ProducED-ed/Castle/README.md

# Проект: портативная квест-игра "Хроники живого замка"

## АРХИТЕКТУРА

* **Сервер (CastleServer.py):** Python (Flask, SocketIO, Eventlet), запущен на Raspberry Pi. Управляет общей логикой, звуками, таймерами, связью со всеми устройствами и является главным хранителем общего состояния игры.
* **Центральный контроллер (MAIN_BOARD_V5_COM5.ino):** Arduino Mega, подключен к серверу по USB Serial. Служит мостом между сервером и контроллерами башен.
* **Контроллеры башен:** Несколько Arduino, подключенных к `MAIN_BOARD_V5_COM5` по Serial (через порты Serial1, Serial2, Serial3, mySerial).
* **Внешние устройства (ESP32):** `wolf.ino`, `train.ino`, `chest.ino`, `safe.ino`. Подключаются к серверу по Wi-Fi (HTTP POST) через API-обработчик сервера `@app.route('/api')`.
* **Веб-интерфейс - пульт (Front.html, scripts.js):** HTML/JS для управления и мониторинга квеста через браузер. Общается с сервером через SocketIO (обработчики `@socketio.on(...)`).

## 🤖 Важная информация для ИИ-ассистентов (AI Developer Notes)

Этот раздел содержит критически важные правила архитектуры проекта. Ознакомьтесь с ними перед внесением любых изменений в код, чтобы не сломать стабильность работы квеста.

### 1. Архитектура сети (Hub & Spokes)
* **MAIN_BOARD (Arduino Mega)** выступает в роли центрального роутера. Она принимает команды от Python-сервера (`Serial`) и пересылает их периферийным башням (`Serial1`, `Serial2`, `Serial3`, `mySerial`).
* **Правило:** Если башня не реагирует на команду с пульта, проверьте код `MAIN_BOARD`. Скорее всего, главная плата "глуха" к порту башни на текущем уровне (`level`), либо перехватывает команду и не отправляет её дальше.

### 2. Чтение UART и конфликты буфера (Race Conditions)
* **Запрещено дублирующее чтение:** Никогда не читайте один и тот же Serial-порт в разных функциях одновременно (например, в `HelpTowersHandler()` и в локальной функции уровня `MapGame()`). Это приводит к "разрыву" строк (одна функция забирает начало слова, другая — конец).
* **Никакого `calculateSimilarity`:** В ранних версиях для защиты от битых строк использовался алгоритм Левенштейна. Это приводило к ложным срабатываниям на обрывках логов (например, кусок текста принимался за команду `aluminium`). **Используйте только строгое сравнение (`==`) или `.indexOf()`**. В текущей архитектуре строки приходят целыми.
* **Никакой «Эхо-камеры» (Death Spiral):** При чтении логов от башен (например, log:workshop:Received command: story_35) использование неточного поиска вроде .indexOf("story_35") заставляет Главную плату принимать чужие логи за новые игровые команды. Это порождает бесконечный цикл эхо-запросов и "вешает" сервер из-за таймаутов сервоприводов. Используйте строгое сравнение (==) для игровых команд.
* **Строгое сравнение вместо indexOf при чтении Питона:** Склеенные в буфере "призраки" прошлых команд (например, "start_game_basketsoundon\n") могут вызвать ложное срабатывание indexOf("start_game_basket"). Всегда используйте строгое равенство if (mainSerialBuffer == "start_game_basket") после вызова функции .trim().
* **Защита от дубликатов (Receiver Debouncing):** При многократной отправке команд (для обхода слепоты от адресных лент) принимающая сторона обязана иметь фильтр антидребезга по строке (например, игнорировать идентичные команды в течение 1000 мс), чтобы не засчитать одно и то же действие, например гол, трижды подряд.

### 3. Лимит буфера (64 байта) и Логирование
* Буфер Arduino Mega равен всего 64 байтам. 
* **Правило логов:** Все логи от башен должны быть **максимально короткими** (до 20-25 символов), иначе конец строки срезается, а системные команды, идущие следом, теряются. (Например: пишем `Tower reset`, а не `Resetting tower to initial state`).
* **Обработка логов:** Все логи от башен начинаются с префикса `log:`. В `MAIN_BOARD` при получении такой строки нужно обязательно сделать `Serial.println(buff);` и затем **`continue;`**, чтобы куски лога не попали в проверку игровых команд, идущую ниже по коду.
* **Пылесос логов (ClearSatelliteBuffers):** При массовой перезагрузке башен (команды ready или restart), они начинают активно слать статусные логи. Если Главная плата в этот момент "спит" через delay(), её крошечный буфер переполняется за миллисекунды, критические команды обрезаются (например, start превращается в rt). Во время любых пауз необходимо использовать цикл с ClearSatelliteBuffers(), чтобы безвозвратно удалять системный мусор из буферов.
* **Спам логами при restart:** Чтобы не "положить" 64-байтный буфер Главной платы во время команд массовой перезагрузки, оборачивайте функции эхо-логирования (о получении команды) в башнях в проверку: if (command != "restart" && command != "ready") { sendLog(...); }.
* **Аппаратная "глухота" от Adafruit_NeoPixel:** При вызове strip.show() библиотека аппаратно отключает прерывания. При длинных лентах (200+ диодов) "глухота" длится ~8 мс и более. Длинные команды (>2 байт), прилетающие в этот момент, гарантированно обрезаются, так как аппаратный FIFO буфер микроконтроллера переполняется. Решение: шлите критические команды 3 раза подряд с задержкой 50 мс, чтобы "пробить" окно глухоты.

### 4. Смерть от `delay()`
* **Никаких долгих `delay()` в MAIN_BOARD:** Использование `delay(500)` или `while()` при открытии замков или движении сервоприводов "ослепляет" Главную плату — она перестает читать порты башен, и буфер переполняется. 
* **Решение:** Используйте неблокирующие таймеры `millis()` или функцию `smartDelay()` (которая внутри себя вызывает `HelpTowersHandler();` для непрерывного чтения башен во время ожидания).

### 5. Состояния Ready и Restart (Сброс башен)
* **Аппаратный сброс замков:** При получении команд `ready` или `restart` башни (`dog.ino`, `basket3.ino` и др.) должны не только обнулять переменные, но и **обязательно давать импульс (500 мс HIGH, затем LOW)** на электромагнитные замки, чтобы язычки гарантированно отщелкнулись. Не используйте для этого кривые таймеры на `millis()` внутри цикла сброса — делайте это линейно.
* **Обнуление флагов:** При сбросе состояний (функция `resetQuestState()`) всегда проверяйте, что обнулены глобальные блокирующие флаги (такие как `isActive`, `isFastSpinning` и т.д.). Иначе башня навсегда "застрянет" в спящем режиме.
* **Двойные триггеры:** Если башня присылает и текстовый лог, и системную команду об одном и том же событии (например, дверь открыта), на Главной плате используйте флаги-предохранители (например, `if (!isDogDoorOpened)`), чтобы не спамить Python-сервер дублями команд.
* **Имитация хронологии при "Прыжках" (Tech Jump):** Микроконтроллерам (и библиотеке GyverButton) требуется физическое время на инициализацию состояний. Нельзя просто послать команду финального уровня. При программном прыжке с пульта необходимо соблюдать всю цепочку: ready -> очистка буфера -> start -> активация нужных датчиков (например, start_troll) -> физическая пауза -> пропуск промежуточного этапа (troll). Только так датчики будут готовы к чтению.

### 6. Умные подсказки (Smart Hints)
* Для избежания хардкода сложных таймеров, на всех платах (Arduino и ESP32) внедрена система getSmartHint(seqId, numHints). Она запоминает время последнего воспроизведения звука. Если геркон замыкается повторно менее чем через 30 секунд — снова звучит первая подсказка. Если прошло больше 30 секунд — звучит следующая. По окончании списка он зацикливается, но навсегда исключает самую первую подсказку.

### 7. Антидребезг (Debounce) и быстрые свайпы

* Стандартный debounceDelay в 150-300 мс подходит для медленных герконов (постановка бутылок, поворот ручки сейфа). Однако для триггеров, требующих быстрых взмахов (магическая палочка / свайпы), 150 мс делает плату "слепой", так как магнит пролетает за 30-50 мс. Для динамичных игр задержка антидребезга строго снижена до 30 мс.

### 8. Работа с памятью и переменными (Heap Corruption & Carryover)

* Опасность класса String в быстрых циклах: Постоянное создание и удаление объектов String (например, String b = Serial.readStringUntil('\n');) внутри циклов анимации ленты вызывает фрагментацию кучи (Heap Fragmentation). В случае повреждения заголовков памяти, вызов функции indexOf("restart") может найти искомую строку в случайном системном мусоре и вызвать ложную, фантомную перезагрузку квеста прямо во время игры. Внутри анимаций читайте Serial аппаратно (посимвольно) и избегайте String.

* "Призраки" статических переменных (static): Использование static bool gameIsActive = true; внутри функций уровней приводит к тому, что эта переменная "переживает" рестарт квеста и сохраняет значение из прошлой игры. При следующем запуске башня может выдать ложное событие на основе старой памяти. Всегда выносите критические переменные состояний в глобальную область и принудительно обнуляйте их в блоках обработки команд ready / restart.

## СТИЛЬ КОДА И ОГРАНИЧЕНИЯ

* **Паттерн:** Придерживаться логики стейт-машины (конечного автомата).
* **Задержки (Arduino):** В коде для микроконтроллеров избегать использования блокирующей функции `delay()` в пользу неблокирующих таймеров на `millis()` (исключение: `OpenAll()` в режиме restart и `OpenDoor()` для "skip").
* **КРИТИЧНО ВАЖНО:** Функции обновления адресных светодиодов (`strip.show()`, `FastLED.show()`) отключают прерывания. **Не вызывать их в каждом цикле loop()!** Обязательно использовать троттлинг (таймер на millis), обновляя ленту не чаще, чем раз в 30-50 мс, иначе Arduino перестает принимать Serial-команды.

## ФАЙЛЫ ДЛЯ РАБОТЫ

Я предоставлю тебе все необходимые файлы для анализа. После решения этой задачи, другие файлы предоставлю по необходимости или по твоему запросу.

**Актуальные файлы проекта:**

* `scripts.js` — скрипты для пульта.
* `Front.html` — пульт управления в браузере, отправляет команды квесту и принимает от сервера статусы игр.
* `wolf.ino` — внешняя игра с волком в лесу.
* `train.ino` — внешняя игра поезд с интерактивной картой.
* `chest.ino` — внешняя игра чемоданы.
* `safe.ino` — внешняя игра сейф с животным.
* `basket3.ino` — башня баскетбол и пещера с троллем.
* `workshop.ino` — башня плотника с верстаком и печкой.
* `owls.ino` — башня с совами.
* `dog.ino` — башня с собакой.
* `MAIN_BOARD_V5_COM5.ino` — плата на которой есть игры: зельеварение с ведьмой, центральная башня с директором, кубком и подвалом с кристаллами, комната мозг (воспоминаний), библиотека, банка с сейфом, центральная комната (актовый зал).
* `CastleServer.py` — сервер.

## МОИ ЖАРГОННЫЕ СЛОВА

* **Скипнул:** Нажал на пульте в веб-браузере кнопку для пропуска этапа игры.
* **Пройти игру или уровень:** Выполнить предусмотренные логикой кода действия.
* **Карта:** `train.ino` (барельеф с 4 герконами).
* **"Мальчик" (Boy):** Геркон `boy_in` / `boy_out` (пин (7, board1)) на `MAIN_BOARD`, связанный с игрой в баскетбол.
* **"Директор" (Director):** Кнопка `directorButton` на `MAIN_BOARD`.
* **"Сейф в банке" (Bank Safe):** Логика `Scrolls()` (level 9) на `MAIN_BOARD`, использующая 4 геркона.
* **"Тролль" (Troll) / "Пещера" (Cave):** Игра в `basket3.ino`.
* **"Призрак" (Ghost):** Последовательная игра (стук по `train.ino`, `wolf.ino` и т.д.).
* **"Плотник" (Workshop):** Башня `workshop.ino`.
* **"Совы" (Owls):** Башня `owls.ino`.
* **Звучат истории** — это воспроизведение файлов `story....wav`.
* **Подсказка** — это воспроизведение файлов `hint....wav`.

## 💡 КЛЮЧЕВЫЕ АРХИТЕКТУРНЫЕ ПРИНЦИПЫ

1. **CastleServer.py (Сервер) Главный поток serial():** Поток `serial()` — это "сердце" квеста. Он читает Serial от Arduino, обрабатывает логику `if flag == "..."` и отправляет команды в `serial_write_queue`. Этот поток также отвечает за вызов `check_story_and_fade_up()` для восстановления громкости.
2. **Многопоточность (API и SocketIO):** Обработчики `@app.route('/api')` (для ESP32) и `@socketio.on('time')` (для пульта) выполняются в отдельных потоках.
3. **Обработка Serial (Arduino):** Внутри длительных циклов (например, анимация радуги или ожидание сервопривода) обязательно вставлять проверку `Serial.available()`, чтобы не пропускать команды 'restart' или 'skip'. Использовать функцию `MonitorSerialBuffer()` для принудительной очистки буфера при переполнении.
4. **Дублирование логики (Страховка):** Если критическая команда от башни (например, `boy_out`) может потеряться, `MAIN_BOARD` должен уметь перехватывать текстовые логи от этой башни (начинаются с `log:`) и реагировать на них как на команду.
5. **Логирование:** На каждое событие создавай логирование уровня `DEBUG`, а если я напишу, что нужно показать событие в консоли, то значит уровня `INFO`. Буфер Arduino Mega составляет всего 64 байта, поэтому Идеальная длина лога — до 20-25 символов.

### 1. СЕТЕВАЯ АРХИТЕКТУРА RASPBERRY PI

Система переведена на работу с двумя активными Wi-Fi интерфейсами, работающими на разнесенных частотах для исключения интерференции:

* **Интерфейс wlan0 (Точка доступа "Castle"):**
* Роль: Локальная сеть для игровых устройств (ESP32).
* Настройка: Принудительно зафиксирован 11-й канал Wi-Fi (2.462 ГГц) в файле `/etc/hostapd/hostapd.conf`.
* Мощность: Установлен `country_code=RU` для корректного регулирования мощности.

* **Интерфейс wlan1 (Клиент "ProducED"):**
* Роль: Подключение к внешнему интернету (для Tailscale и удаленного управления).
* Настройка: Работает на 1-м канале (диктуется внешним роутером).

* **Результат:** Разнос каналов (1 и 11) устранил "глухоту" приемников ESP32, вызванную мощным сигналом передатчика Raspberry Pi на соседних частотах.

### 2. СИСТЕМНЫЕ НАСТРОЙКИ OS (RASPBERRY PI)

* **Отключена автоматизация перезагрузки сети:**
* В `crontab -e` закомментирован скрипт `wifi_rebooter.sh` (ранее выполнялся каждую минуту).
* Причина: В конфигурации с двумя интерфейсами скрипт ошибочно диагностировал отсутствие интернета и перезагружал сетевые адаптеры, вызывая разрывы связи каждые 45-55 секунд. **НЕ ВКЛЮЧАТЬ ЭТОТ СКРИПТ БЕЗ ПОЛНОЙ ПЕРЕРАБОТКИ ЛОГИКИ ПРОВЕРКИ PING.**

### 3. ИЗМЕНЕНИЯ В КОДЕ СЕРВЕРА (CastleServer.py)

* **Устранение блокировки потоков (CPU Starvation):**
* В бесконечный цикл `while True` функции `serial()` добавлена команда `eventlet.sleep(0.1)`.
* Причина: Без этой паузы поток обработки Serial-порта занимал 100% времени ядра, не давая веб-серверу (Flask) обрабатывать входящие HTTP-запросы от ESP32 (из-за чего curl и устройства "висели").

* **Авторизация для API:**
* В функцию `before_request` добавлено исключение: `if request.path.startswith('/api'): return None`.
* Причина: Устройства ESP32 не умеют проходить процедуру логина. Ранее сервер перенаправлял их POST-запросы на `/login` (код 302), из-за чего данные от игр не доходили. Теперь API открыт для локальных устройств.

*** Очередь Python и Блокировки потоков:**
* serial_write_queue.put() в Python не отправляет данные мгновенно, если сразу после нее стоит eventlet.sleep(). Команды накопятся и выстрелят одновременно, что приведет к пропуску второй команды на стороне Arduino (если та была занята тяжелой анимацией).

* Правило: После критически важных команд в очередь всегда вызывайте process_serial_queue(), чтобы принудительно вытолкнуть байты в USB-кабель перед уходом Питона в сон.

### 4. ИЗМЕНЕНИЯ В ПРОШИВКАХ ESP32 (Safe, Chest, Wolf, Train)

* **Настройка статической маршрутизации:**
* Метод инициализации Wi-Fi изменен на полный формат: `WiFi.config(local_IP, gateway, subnet);`. Где `gateway` — это IP адрес Raspberry Pi (192.168.4.1), а `subnet` — 255.255.255.0.
* Причина: Без явного указания шлюза ESP32 могла принимать пакеты, но не могла отправить ответ (TCP ACK или POST-запрос) обратно на сервер.

* **Логирование при старте:**
* В `setup()` каждого устройства добавлена команда `sendLogToServer(...)` с JSON-структурой `{"log": "ESP32 [Name] is ready..."}`.
* Это позволяет диагностировать успешную загрузку и подключение устройства в логах сервера (`castle.log`).

### 5. АВТОЗАПУСК И УПРАВЛЕНИЕ АУДИО (SYSTEMD & PULSEAUDIO)

Автозапуск сервера (systemd вместо rc.local):

Главный скрипт квеста (CastleServer.py) работает как служба systemd (castleserver.service), а не через rc.local.

Причина: systemd обеспечивает автоматический рестарт при падениях (Restart=always, RestartSec=5), корректную загрузку после поднятия сети (After=network.target) и изолированное логирование.

Управление сервером: sudo systemctl restart castleserver.service

Просмотр логов: journalctl -u castleserver.service -f (вывод print и системных ошибок перехватывается сюда).

Изоляция аудио в systemd и PulseAudio Equalizer:

Проблема: По умолчанию systemd запускает процессы в слепой/глухой среде, из-за чего скрипт теряет доступ к пользовательскому аудиосерверу (PulseAudio) и отправляет звук напрямую в ALSA (аппаратную карту), минуя эквалайзер, или вообще молчит.

Решение: В файле /etc/systemd/system/castleserver.service строго прописаны переменные окружения, пробрасывающие звук в пользовательскую сессию (pi, UID 1000) и направляющие его принудительно в виртуальное устройство эквалайзера:

Environment="XDG_RUNTIME_DIR=/run/user/1000"

Environment="DISPLAY=:0"

Environment="PULSE_SINK=alsa_output.usb-...-00.analog-stereo.equalizer"

Авто-маршрутизация звука: В systemd (castleserver.service) используется скрипт-обертка run_server.sh. При замене USB-аудиокарты скрипт автоматически находит новое системное имя PulseAudio Equalizer и перенаправляет звук в него. Никаких ручных настроек при замене железа не требуется.

---

## ОЖИДАЕМЫЙ РЕЗУЛЬТАТ

1. **Точная причина проблемы:** Определи корневую причину ошибки или опиши логику для реализации новой функции.
2. **Исправленный код:** Предоставь готовые к копированию, исправленные фрагменты кода для всех файлов, которые требуют изменений. Пожалуйста, используй комментарии, чтобы я мог легко найти и понять изменения.
3. **Подробное объяснение (на русском языке):** В чем заключалась ошибка или как работает новая логика. Почему предложенные изменения решат проблему или реализуют требуемый функционал. Укажи, какие побочные эффекты могут возникнуть в результате изменений.

**Не указывай для меня системные маркеры в написанных тобой кодах.**

---

*Готов приступить к анализу. Присылайте задачу и необходимые файлы.*
