ProducED-ed/Castle/Архив/README.md

# Архив

Здесь лежат исторические снимки кода, которые **не являются актуальными файлами** ни для одного
работающего замка. Держим их, потому что в паре мест это единственный сохранившийся вариант под
конкретное железо, а остальное полезно при разборе «когда это сломалось».

Актуальные файлы всегда в корне репозитория. Ничего отсюда не брать для прошивки без явного решения.

| Папка / файл | Что это | От какой даты | Зачем храним |
|---|---|---|---|
| `workshop OMAN/` | Прошивка башни Workshop для CLC1 (Оман) | ~апрель 2026 | **Единственная** версия, где шлем и метла на сервоприводах (пины 5 и 3), а не на LED (пины 50/48) как в мастере. Если Оману понадобится обновление — брать логику отсюда, а не из мастера. Сильно отстала: нет `ping_main`-heartbeat, нет `FLAG_RESEND_MS`, `RECURRING_LOCK_INTERVAL` = 10000 вместо исправленных 3000. |
| `workshop OMAN/workshop_old/` | Ещё более ранняя версия той же башни | ~март 2026 | Промежуточный этап разработки. Ценности почти нет. |
| `train old отправка CLC3/` | Снимок `train.ino`, отправленный на CLC3 | ~июнь 2026 | До `TrainIntroWatchdog`, до вотчдога переподключения WiFi, до защиты подсказки от перебивания вступления. |
| `CastleServer.py отправка CLC3/` | Снимок сервера, отправленный на CLC3 | 03.07.2026 | 7125 строк против нынешних 8289. Полезен как точка отсчёта при разборе регрессий. |
| `Архив от 3.4.26. CLC2/` | Полный комплект (сервер + фронт + все 9 прошивок) | 03.04.2026 | Самый старый целый срез. Все файлы устарели на сотни строк. |
| `baseline-step2-2026-05-27/` | Пошаговые сборки Mega при разборе зависаний | 27.05.2026 | Использовались для бисекции проблемы DIAG-режима. `MAIN_BOARD_V5_COM5.ino.hex` из корня `MAIN_BOARD_V5_COM5/` остаётся рабочим baseline'ом, здесь — промежуточные шаги 2–5. |
| `MAIN_BOARD_V5_COM5.diag.ino.hex` | Сборка Mega с DIAG-режимом | май 2026 | DIAG-режим убран из всех прошивок: попытка перехватывать `loop()` дважды вешала квест. Храним как напоминание, прошивать нельзя. |

## Что НЕ здесь

`MAIN_BOARD_V5_COM5/MAIN_BOARD_V5_COM5.baseline.ino.hex` намеренно оставлен в рабочей папке — это
проверенный baseline CLC3 для отката, а не архив.

Папка `MAIN_BOARD_V5_COM5/CLC2/` (отдельная сборка Mega под Канаду) удалена в августе 2026: её
единственным отличием была калибровка серво мальчика, которая переехала в `castle_config.json` и
настраивается с тех-пульта. Заодно та сборка отставала от мастера — в ней не было фикса от 05.08.2026
(убран мгновенный форвард `cave_search1/2/3` в `Serial2`, из-за которого обрывалась история тролля).
