ProducED-ed/Castle/Референс/castle_of_memories_fond_blanc.pdf

# CASTLE OF MEMORIES 🏰✨

Résumé Complet de l’Histoire Principale

Chapitre 1 – L’arrivée au Château 🐲🗺️

L’aventure commence lorsque les joueurs arrivent pour la première fois devant un immense Château abritant une prestigieuse école de magie.
Ils découvrent avec émerveillement les lieux et apprennent qu’un événement particulièrement important approche : les Grands Jeux, une compétition réunissant les élèves et les différentes maisons de l’école.
Dès leur arrivée, ils trouvent une carte magique qui leur permettra de se repérer dans le Château.
C’est alors qu’ils font la connaissance de Signus, un dragon installé dans son nid au-dessus du Château. De là-haut, Signus peut observer tout ce qui s’y passe et devient le principal guide des joueurs.
Il leur explique le fonctionnement de la carte : certaines lumières indiquent les endroits à visiter et d’autres représentent encore des secrets à découvrir. Les cristaux bleus présents sur Signus et sur plusieurs habitants du Château permettent également d’obtenir de l’aide lorsque les joueurs sont perdus.
L’entrée du Château étant verrouillée, Signus les guide vers une clé cachée à proximité. Il leur recommande surtout de rester discrets : il fait encore nuit et les habitants du Château dorment.

Chapitre 2 – Kai et le mystère de la Bibliothèque Secrète 👻🕰️

Une fois à l’intérieur, les joueurs rencontrent Kai, un jeune élève de première année qui se promène secrètement dans le Château malgré le couvre-feu.
Kai est passionné par les légendes et les secrets de l’école. Il leur révèle qu’il cherche depuis quelque temps un lieu mystérieux dont tout le monde parle à voix basse : la Bibliothèque Secrète.
Selon la légende, seul le Fantôme du Château serait capable d’en révéler l’emplacement.
Le fantôme ne se manifeste cependant qu’à un moment très précis : 12 h 42.

Kai demande donc aux joueurs de l’aider à utiliser une mystérieuse horloge. En la réglant correctement, ils parviennent à provoquer une réaction magique.
Le fantôme commence alors à communiquer avec eux de manière énigmatique, en utilisant des sons et des coups provenant de différents endroits du Château. Il semble vouloir les conduire quelque part.
Mais avant qu’ils puissent comprendre son message, des pas se rapprochent. Kai comprend qu’un professeur arrive et s’enfuit pour éviter d’être découvert.

Chapitre 3 – La punition du Professeur Amelia 🧹🚩

Les joueurs sont finalement surpris par le Professeur Amelia, qui a entendu le bruit provoqué durant leurs explorations nocturnes.
Le lendemain matin, elle leur reproche d’avoir désobéi au règlement et d’avoir exploré le Château au lieu de dormir.
Plutôt que de leur infliger une simple punition, Amelia décide cependant d’utiliser leur énergie de manière utile.
Les Grands Jeux approchent et le Château doit encore être préparé.
Elle leur confie donc une première grande mission : retrouver les drapeaux des différentes maisons et les installer sur les quatre tours du Château. Les emplacements à explorer apparaissent alors sur leur carte.

Chapitre 4 – La préparation du Château 🐺📜

Les joueurs commencent à parcourir les différentes parties du Château et rencontrent plusieurs de ses habitants.
Ils doivent résoudre leurs problèmes ou accomplir différentes tâches afin de récupérer les drapeaux nécessaires aux préparatifs.
Ils rencontrent notamment Sylvester, un personnage solitaire et passionné de poésie, ainsi qu’un loup lié à une histoire familiale et aux étoiles. D’autres rencontres les entraînent encore dans différentes zones du Château.
À travers ces missions, les joueurs découvrent progressivement le fonctionnement de l’école, ses habitants et ses nombreux secrets.
Une fois les premières étapes accomplies, les préparatifs des Grands Jeux peuvent véritablement commencer.

Chapitre 5 – Préparer l’école pour les Grands Jeux 🦉🚂

Les Jeux auront bientôt lieu et des élèves de toutes les maisons ainsi que de nombreux spectateurs sont attendus.
Les joueurs participent directement à leur organisation.
À la Poste aux Hiboux, ils rencontrent Borin, chargé d’envoyer les invitations. Ils l’aident à guider correctement les hiboux afin que les invitations aux Grands Jeux puissent être distribuées dans toute la région.
Une fois cette mission accomplie, tout le Château comprend que les préparatifs sont officiellement lancés.
Les joueurs doivent également s’occuper du train spécial Peau de Serpent, qui doit être prêt pour l’événement.
Mais pour le faire fonctionner, la locomotive à vapeur a besoin d’un charbon de très haute qualité provenant de la mine des trolls.

Chapitre 6 – Préparer Kai pour la compétition 🧹🛡️⛏️

Les joueurs découvrent progressivement qu’ils ne préparent pas seulement le Château. Ils doivent également aider celui qui représentera l’école lors des Grands Jeux : Kai.
Pour lui donner toutes les chances de gagner, il lui faut un équipement exceptionnel, notamment un balai extrêmement rapide et un casque capable de le protéger pendant la compétition.
Commence alors une longue quête pour récupérer tous les éléments nécessaires.
Ils rencontrent notamment Elspeth, une vieille spécialiste des potions, qui leur demande de préparer une potion magique destinée à un balai volant. Ils doivent également récupérer un cristal orange, destiné aux protections du casque, ainsi qu’un lingot conservé dans un coffre. Pendant ce temps, ils doivent toujours résoudre le problème du train. Dans la mine, ils rencontrent Brock, qui leur explique qu’il faut une excellente pioche pour extraire le meilleur charbon.
Pour fabriquer cette pioche, ils doivent trouver un matériau particulièrement rare : le métal stellaire. Après plusieurs recherches, ils réussissent à le trouver. La pioche peut être fabriquée et le charbon nécessaire au train est finalement obtenu. Tous les composants indispensables sont désormais réunis.

Chapitre 7 – La forge de Boris 🔨🔥

Les joueurs apportent tous les éléments récupérés à Boris, le maître artisan du Château. Boris possède les compétences nécessaires pour fabriquer l’équipement de Kai, mais sa forge est froide. Les joueurs doivent d’abord raviver le feu et maintenir une température suffisamment élevée pour que la magie puisse fonctionner.
Ils disposent ensuite correctement tous les composants sur l’établi pendant que Boris réalise son travail.
Le résultat dépasse les attentes ! Boris fabrique le balai le plus rapide jamais sorti de son atelier. Il termine également un casque léger et extrêmement solide, renforcé par les cristaux orange capables de protéger Kai même en cas de chute importante.
Kai possède désormais le meilleur équipement possible pour défendre l’honneur de l’école lors des Jeux. La nuit tombe sur le Château et tout semble enfin prêt pour le lendemain.

Chapitre 8 – Le retour du Fantôme et la découverte de la Bibliothèque

🔍📖
Kai remercie les joueurs. Grâce au casque et au balai qu’ils ont contribué à fabriquer, il estime avoir toutes les chances de remporter le tournoi.
Mais une affaire reste inachevée : la Bibliothèque Secrète.
Kai n’a pas oublié leur exploration de la première nuit. Il demande aux joueurs de retourner à l’horloge et de l’activer une nouvelle fois, mais cette fois en la réglant sur 12 h 27.
Le Fantôme de la Bibliothèque Secrète se manifeste de nouveau. Il ne communique toujours pas avec des mots : il frappe à différents endroits du Château et attend que les joueurs lui répondent. Commence alors une sorte de jeu de piste sonore.
Les coups les conduisent notamment vers le quai, puis vers différentes parties du Château et finalement vers son toit. En suivant correctement les indications du fantôme, les joueurs découvrent enfin ce qu’ils recherchaient depuis le début : la Bibliothèque Secrète.
Mais le fantôme continue de frapper. Kai comprend alors qu’il ne jouait peut-être pas simplement avec eux, mais qu'il essayait de leur montrer quelque chose d’important. Un symbole découvert près du train correspond exactement à un motif présent sur la porte de la Bibliothèque. Grâce à cet ultime indice, ils peuvent poursuivre leur exploration.

Chapitre 9 – Quelque chose ne va pas… 😱🕯️

Une fois dans la Bibliothèque Secrète, les joueurs font une découverte inquiétante : elle est vide.
Quelqu’un semble être passé avant eux et avoir emporté ce qui s’y trouvait.
Puis un sifflement de train retentit. Et soudain, Kai crie. Quelque chose vient de l’attraper !

Les joueurs n’ont pratiquement pas le temps de comprendre ce qui vient de se produire. La nuit s’achève, l’aube apparaît au-dessus du Château. Et ce nouveau jour est justement celui que tout le monde attend depuis le début de l’aventure : le jour des Grands Jeux.

Chapitre 10 – La disparition de Kai 🔍💎

Les élèves, les professeurs et les spectateurs sont désormais réunis. La Directrice Éléonore ouvre officiellement les Grands Jeux. Selon la tradition, la Coupe de l’Unité doit être allumée afin de marquer le début de la compétition.
Mais un énorme problème apparaît soudain : Kai a disparu. Le champion qui devait représenter l’école est introuvable.
Les Jeux ne peuvent pourtant pas être annulés. Les joueurs reçoivent immédiatement une nouvelle mission : retrouver Kai avant le début de la compétition.
Ils doivent pénétrer dans un coffre-fort et récupérer les Cristaux de Vision, des objets magiques capables de révéler ce qui est invisible à l’œil ordinaire. Guidés par les professeurs représentés sur les portraits du Château, ils parviennent à ouvrir le passage et à récupérer les cristaux.
Grâce à leur pouvoir, ils commencent à percevoir la présence de Kai et ressentent sa peur. Les indices deviennent progressivement plus précis : Kai se trouve toujours quelque part à l’intérieur des murs du Château, caché derrière des briques.
Les indices les ramènent finalement à l’endroit même où toute leur aventureavait commencé : l’entrée du Château. Un passage dissimulé derrière un mur est découvert. Les joueurs le soulèvent… et retrouvent enfin Kai !

Chapitre 11 – Kai est sauvé 🕯️🤝

Kai est vivant ! Soulagé, il remercie les joueurs et leur raconte ce qui lui est arrivé.

Alors qu’ils exploraient la Bibliothèque Secrète et que leur attention était détournée, quelque chose l’a attrapé. Kai ne sait pas exactement ce que c’était, il se souvient seulement d’une présence sombre et extrêmement rapide.
Mais il est convaincu d’une chose : cette créature voulait empêcher les Grands Jeux d’avoir lieu. Son enlèvement n’était donc pas un accident, mais une tentative délibérée de saboter la compétition.
Grâce aux joueurs, le plan a échoué. Kai a été retrouvé à temps et les Grands Jeux peuvent enfin avoir lieu !

Chapitre 12 – Les Grands Jeux et la victoire 🧹⚡🏆

Kai rejoint la compétition avec le casque et le balai que les joueurs ont contribué à fabriquer. Les tribunes se remplissent et le Château entier retient son souffle. Les Grands Jeux commencent enfin !
Les joueurs participent alors directement à la compétition et mettent en pratique tout ce qu’ils ont appris au cours de leur aventure. Ils doivent notamment attraper la balle volante et réussir leurs tirs tout en affrontant leurs adversaires.
Après toutes les épreuves traversées dans le Château, les énigmes résolues, les habitants aidés, la préparation des Jeux, la fabrication de l’équipement et surtout le sauvetage de Kai, les joueurs peuvent enfin se battre pour la victoire.
Dans le déroulement normal de l’aventure, ils remportent les Grands Jeux !
L’école est victorieuse, Kai est sain et sauf, et les joueurs peuvent célébrer leur victoire après avoir sauvé non seulement leur ami, mais également les Grands Jeux eux-mêmes ! 🎉🌟

LE FIL ROUGE DE TOUTE L’HISTOIRE

L’aventure commence comme une simple découverte d’une école de magie à la veille d’une grande compétition. Les joueurs rencontrent Kai, un élève curieux qui cherche à découvrir la légendaire Bibliothèque Secrète, et commencent avec lui une enquête parallèle autour du mystérieux Fantôme du Château.
Après avoir été surpris durant leur exploration nocturne, ils sont chargés d’aider à préparer l’école pour les Grands Jeux. Ce qui ressemble d’abord à une punition devient une véritable aventure : ils parcourent le Château, rencontrent ses habitants, récupèrent les drapeaux, préparent les invitations, remettent le train en fonction et rassemblent tous les éléments permettant de fabriquer le meilleur équipement possible pour Kai.
Une fois Kai prêt pour la compétition, leur ancienne enquête reprend. Grâce au Fantôme, ils trouvent enfin la Bibliothèque Secrète. Mais cette découverte révèle qu’un danger plus important se cache dans le Château : une mystérieuse présence enlève Kai et cherche manifestement à empêcher les Grands Jeux d’avoir lieu.
Le matin de la compétition, les joueurs découvrent que leur champion a disparu. À l’aide des Cristaux de Vision, ils suivent sa trace dans les murs du Château et réussissent à le retrouver juste à temps. Kai leur apprend alors qu’une créature sombre et rapide l’a capturé dans la Bibliothèque afin de saboter les Jeux.
Son plan a cependant échoué grâce aux joueurs. Kai peut participer à la compétition, les Grands Jeux commencent, et l’aventure s’achève normalement par la victoire de Kai, des joueurs et de leur école !
