ProducED-ed/Castle/Референс/Скрины пульта/Снимок экрана 2026-08-05 081355.png

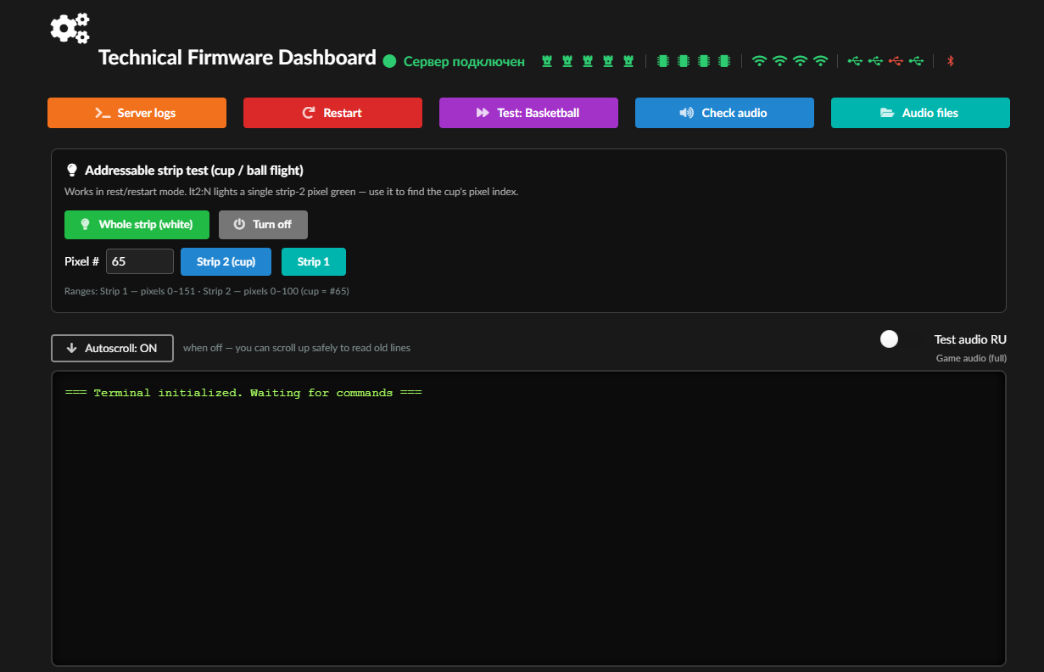
Референс/Скрины пульта/Снимок экрана 2026-08-05 081355.png
