ProducED-ed/Castle/Референс/Скрины пульта/Снимок экрана 2026-08-05 081429.png

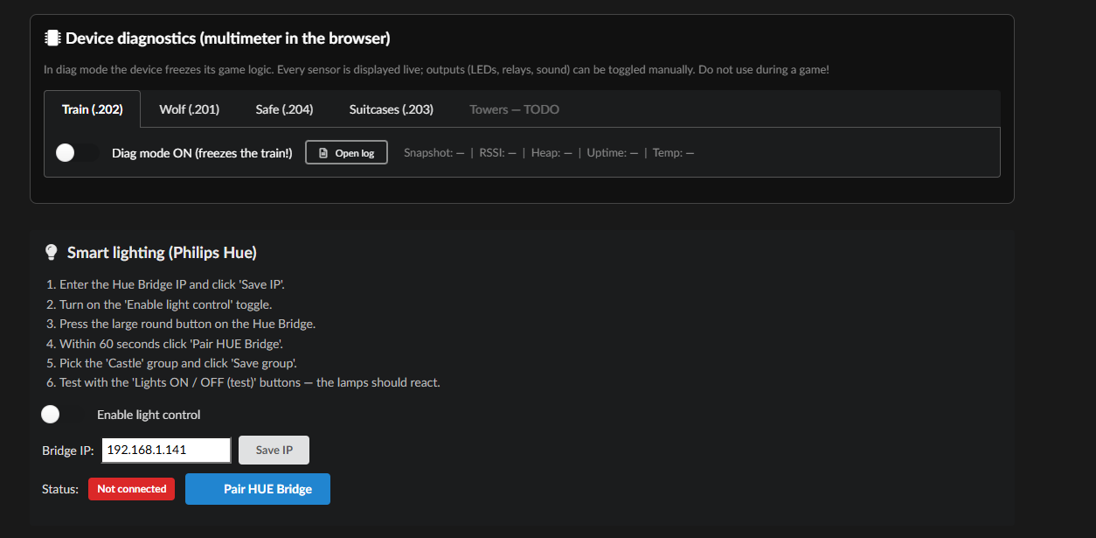
Референс/Скрины пульта/Снимок экрана 2026-08-05 081429.png
