ProducED-ed/Castle/MAIN_BOARD_V5_COM5/MAIN_BOARD_V5_COM5.ino

// === ЗАМЕР ДЛИТЕЛЬНОСТИ ФАЗ (2026-08-22) ===
// Зачем: телеметрия LOOP показала, что цикл главной платы иногда встаёт на
// секунды — на CLC1 до 6,3 с, на CLC3 до 11,3 с. Пока плата стоит, она не
// читает команды с Pi, и они теряются: так пропадал restart, из-за чего дверь
// башни Корзины продолжала толкаться в покое. Какая именно фаза съедает эти
// секунды — по коду не сходится (OpenAll 600 мс, рассылка по башням 180 мс),
// поэтому меряем, а не гадаем.
//
// Печатаем ТОЛЬКО то, что дольше порога: в норме фазы укладываются в единицы
// миллисекунд, и лог не засоряется. Строка уходит в logs/castle.log
// (в journalctl её не видно — там режется всё, что начинается с log:).
#define PHASE_REPORT_MS 200
#define PHASE_REPORT(name, t0) do {                                  \
    unsigned long _d = millis() - (t0);                              \
    if (_d >= PHASE_REPORT_MS) {                                     \
      Serial.print(F("log:main:PHASE " name "="));                   \
      Serial.println(_d);                                            \
    }                                                                \
  } while (0)

//-------------------------- библиотеки
#define crimeDoorPin 38     // геркон на мальчика в тюрьме первая комната
#define startDoorPin 41     // геркон открытия первой комнаты
#define voltagePin A1       // аналогвый пин напруга
#define goldMaterialPin 47  // проставить пин золота
//#define clockPin3 45
#define directorPin 43
#define goblinPin A15
#define dragonPin 42
#define studentPin 38
#define professorPin 44
#define witchPin 45
#define galetSwitchesPin 40


const int pinA = A14;    // Адресный вход A (LSB)
const int pinB = 53;     // Адресный вход B
const int pinC = 52;     // Адресный вход C (MSB)
const int board1 = 21;   // Выход Y
const int board2 = 20;   // Выход Y
const int board3 = A12;  // Выход Y
const int board4 = 33;   // Выход Y

#define GoldStripCount 1
#define GoldStripPin 50  // in the last version it was 48
#define CandleStripIndicCount 1
#define CandleStripIndicPin 51
#define CauldronStripIndicCount 9
#define CauldronStripIndicPin 48  // in the last version it was 49
#define CauldronRoomStripIndicCount 12
#define CauldronRoomStripIndicPin 12
#define memory_LedIndicCount 41
#define memory_LedIndicPin 11  // Поменял пины местами с final_LedIndicPin

#include <Adafruit_NeoPixel.h>
#include <SoftwareSerial.h>
#include <OneWire.h>
#include "GyverButton.h"
#include <Servo.h>

String serial1Buffer = "";
String serial2Buffer = "";
String serial3Buffer = "";
String mySerialBuffer = "";
String mainSerialBuffer = "";

bool isUfBlinking = false;
int ufBlinkCount = 0;
unsigned long ufBlinkTimer = 0;
const int UF_BLINK_TOTAL = 6;  // 3 включения + 3 выключения
bool isRainbowActive = false;
long rainbowHue = 0;
unsigned long rainbowTimer = 0;

//---------------экзэмпляры классов
//-----------коммуникации
SoftwareSerial mySerial(10, 31);  // rx tx
//---------------------
//------------------------ленты адрески
Adafruit_NeoPixel GoldStrip = Adafruit_NeoPixel(GoldStripCount, GoldStripPin, NEO_GRB + NEO_KHZ800);                                    /// адреска в первой комнате
Adafruit_NeoPixel CandleStrip = Adafruit_NeoPixel(CandleStripIndicCount, CandleStripIndicPin, NEO_GRB + NEO_KHZ800);                    ////адреска на свече
Adafruit_NeoPixel CauldronStrip = Adafruit_NeoPixel(CauldronStripIndicCount, CauldronStripIndicPin, NEO_GRB + NEO_KHZ800);              ////адреска в котле
Adafruit_NeoPixel CauldronRoomStrip = Adafruit_NeoPixel(CauldronRoomStripIndicCount, CauldronRoomStripIndicPin, NEO_GRB + NEO_KHZ800);  /// потолочное освещение в комнате зельеварения
Adafruit_NeoPixel memory_Led = Adafruit_NeoPixel(memory_LedIndicCount, memory_LedIndicPin, NEO_GRB + NEO_KHZ800);                       /// финалочка адреска на башне на отдельной нане +20 пин

Adafruit_NeoPixel strip1 = Adafruit_NeoPixel(152, 8, NEO_GRB + NEO_KHZ800);
Adafruit_NeoPixel strip2 = Adafruit_NeoPixel(101, 2, NEO_GRB + NEO_KHZ800);  // кубок = пиксель 65
Adafruit_NeoPixel* strips[] = {
  &GoldStrip,
  &CandleStrip,
  &CauldronStrip,
  &CauldronRoomStrip,
  &memory_Led,
  &strip1,
  &strip2
};
const int STRIPS = sizeof(strips) / sizeof(strips[0]);

// палитра цветов
uint32_t palette[] = {
  Adafruit_NeoPixel::Color(255, 180, 20),   // золотой
  Adafruit_NeoPixel::Color(180, 30, 255),   // фиолетовый
  Adafruit_NeoPixel::Color(20, 100, 255),   // синий
  Adafruit_NeoPixel::Color(255, 255, 255),  // белый (искра)
  Adafruit_NeoPixel::Color(255, 0, 0),      // красный (искра)
  Adafruit_NeoPixel::Color(0, 255, 0),      // синий (искра)
  Adafruit_NeoPixel::Color(0, 0, 255)       // зеленный (искра)

};
const int COLORS = sizeof(palette) / sizeof(palette[0]);

Servo boyServo;

// Флаг монитора датчиков объявлен здесь, до состояний ожидания:
// PowerOn/RestOn проверяют его раньше, чем идёт сам блок монитора.
bool monActive = false;
// Тест верстака Мастерской включён с /tech — в покое надо слушать её UART.
bool wbTestOn = false;

// --- КАЛИБРОВКА СЕРВО МАЛЬЧИКА (пин 49) ---
// 2026-08-09: раньше эти числа были зашиты в коде, и под Канаду приходилось
// держать ОТДЕЛЬНУЮ сборку прошивки — сервоприводы приходят разными партиями и
// одинаково не ходят. Из-за второй сборки каждая правка вносилась дважды, и она
// же успела отстать от мастера на один баг-фикс.
// Теперь значения приходят с Pi командой boycal:<min>:<max>:<open>:<hide>:<ms>
// (сервер шлёт её при каждом QUEST_SYSTEM_READY и по кнопке на /tech), а
// прошивка на всех замках одна. Значения ниже — дефолт, работает и без сервера.
int boyPulseMin = 500;      // мкс, нижняя граница импульса
int boyPulseMax = 2500;     // мкс, верхняя граница импульса
int boyAngleOpen = 170;     // угол «мальчик открывается»
int boyAngleHide = 0;       // угол «мальчик прячется»
unsigned int boyMoveMs = 1000;  // сколько ждать окончания хода

// Разбирает команду калибровки. true — команда распознана и обработана.
// Вызывается из состояний ожидания (PowerOn/RestOn): именно в них замок стоит
// и при загрузке, и когда монтажник крутит калибровку на пульте.
bool handleBoyCal(const String &buff) {
  if (!buff.startsWith("boycal:")) return false;
  int p[5];
  int idx = 7;  // после "boycal:"
  for (int i = 0; i < 5; i++) {
    int sep = buff.indexOf(':', idx);
    String part = (sep == -1) ? buff.substring(idx) : buff.substring(idx, sep);
    p[i] = part.toInt();
    if (sep == -1) {
      if (i < 4) return true;   // команда обрезана — молча игнорируем
      break;
    }
    idx = sep + 1;
  }
  // Границы дублируют серверные. Серво без механического ограничителя легко
  // загнать в упор: он будет гудеть, греться и в итоге сгорит.
  if (p[0] < 400 || p[0] > 1500 || p[1] < 1500 || p[1] > 2600 || p[0] >= p[1]) return true;
  if (p[2] < 0 || p[2] > 180 || p[3] < 0 || p[3] > 180) return true;
  if (p[4] < 200 || p[4] > 5000) return true;

  boyPulseMin = p[0];
  boyPulseMax = p[1];
  boyAngleOpen = p[2];
  boyAngleHide = p[3];
  boyMoveMs = (unsigned int)p[4];
  Serial.println(F("log:confirm:boycal_ok"));
  return true;
}

// Прогнать серво на подобранных углах — кнопки «проверить» на тех-пульте.
// Своя команда нужна потому, что игровые student_open/student_hide
// обрабатываются ТОЛЬКО внутри соответствующих этапов квеста: в состоянии
// ожидания Mega их не слушает, и кнопки на пульте молчали, хотя серво исправен.
bool handleBoyTest(const String &buff) {
  if (!buff.startsWith("boytest:")) return false;
  bool toOpen = (buff.indexOf("open") != -1);
  Serial.println(F("log:confirm:boytest_start"));
  boyServo.attach(49, boyPulseMin, boyPulseMax);
  boyServo.write(toOpen ? boyAngleOpen : boyAngleHide);
  delay(boyMoveMs);
  boyServo.detach();          // не держим момент, серво не греется
  Serial.println(F("log:confirm:boytest_ok"));
  return true;
}

//------------герконы кнопки и входы
GButton startDoor(startDoorPin);  // геркон на стартовой двери
GButton clock1Button(1);
GButton clock2Button(1);
GButton goldButton(goldMaterialPin);
//GButton clock3Button(clockPin3);
GButton directorButton(directorPin);
GButton goblinButton(goblinPin);
GButton galetSwitches(galetSwitchesPin);  // галетники в первой комнате
GButton dragonButton(dragonPin);
GButton studentButton(studentPin);
GButton professorButton(professorPin);
GButton witchButton(witchPin);

const byte KnockSens = A0;    // пьезодатчик аналоговый
const byte WindowSens = A13;  // датчик пересечения на окне

const byte firstCrystal = 27;  // геркон первого кристала
const byte secondCrystal = 24;
const byte thirdCrystal = 23;
const byte fourCrystal = 25;
// Флаги активации дверей/этапов для подсказки hint_11_z ---

bool isPotionDoorOpened = false;       // Дверь ведьмы (рыба) открыта
bool isDogDoorOpened = false;          // Дверь рыцаря (собака/ключ) открыта
bool isOwlDoorOpened = false;          // Дверь гнома (сова) открыта
bool isStartDoorOpenedGlobal = false;  // Флаг физического открытия стартовой двери для подсказок
bool isTrainStarted = false;           // Игра с поездом (после проектора) активна
bool lessonSaluteActive = false;       // Флаг для анимации салюта в уроке
bool discoBallsActive = false;         // Флаг для диско-шаров при голе
unsigned long discoBallsTimer = 0;     // Таймер для диско-шаров
bool isGameBasketStarted = false;

// --- Step 2 (2026-05-27): Tower passive heartbeat timestamps + DIAG declarations ---
// lastSeen* всегда 0 в Step 2 — никто их не пишет (tracking в Step 3).
// check_towers handler ниже будет отвечать всеми нулями, что безопасно.
unsigned long lastSeenWorkshop = 0;
unsigned long lastSeenBasket   = 0;
unsigned long lastSeenDog      = 0;
unsigned long lastSeenOwls     = 0;

// 2026-05-28: DIAG mode УДАЛЁН (не используется — нет UI для Mega/башен).
// Облегчение loop + устранение if(dgActive) early-return который мог влиять
// на тайминг NeoPixel (strip2 FireCup пиксель кубка не загорался).
//----------------RFID
OneWire myRFID(13);  // рфидка на котле в комнате зельеварения
byte addr[8];

// воспоминания
unsigned long _presentTimer;
byte _stages = 0;
bool _present = 0;
byte lightBr = 0;
byte iterator = 0;
bool symbolFade = 1;
bool flagSalut = 1;
byte _levels = 0;
byte _stones = 0;
int symbolBrightness = 0;
unsigned long symbolFadeTimer = 0;
unsigned long fadeWhiteTimer = 0;
unsigned long MemoryCheckInterval;
unsigned long MemoryItem1Interval;
unsigned long MemoryItem2Interval;
unsigned long MemoryItem3Interval;
unsigned long MemoryItem4Interval;
unsigned long MemoryItemsInterval;
unsigned long voltageTimer;
unsigned long lightFlashTimer;
unsigned long rainbowCyclesPreviousMillis = 0;
unsigned long pixelsInterval = 10;
unsigned long stepsTimer;
unsigned long libraryOpenTimer;
unsigned long helpsBankTimer;
unsigned long rfidCooldownEnd = 0;
// 2026-08-07. Метка, которую только что засчитали, и время засчёта.
// Зачем: игрок кладёт бутылочку, она засчитывается, он убирает руку — и по
// дороге задевает ту же метку ещё раз. Для СЛЕДУЮЩЕГО шага это уже «чужая»
// метка, и раньше это считалось ошибкой со сбросом всей последовательности.
// Именно от этого задумывалось глухое окно, но оно взводилось ПОСЛЕ того как
// ошибка уже отправлена, поэтому от этого случая не спасало вовсе.
// Теперь: свою же только что принятую метку игнорируем TAG_GRACE_MS.
byte lastAcceptedAddr[8];
bool hasLastAccepted = false;
unsigned long lastAcceptedAt = 0;
const unsigned long TAG_GRACE_MS = 2000;

// Неблокирующее затухание ленты комнаты после победы (см. FourBottle).
bool potionFadeActive = false;
int potionFadeLevel = 255;
unsigned long potionFadeTimer = 0;
int rainbowCycles = 0;
int rainbowCycleCycles = 0;
int repeatCount = 0;

int Timings[] = { 3000, 2500, 2000, 1500 };
int TimingsFade[] = { 5, 4, 3, 2 };
int CountsFade[] = { 1, 3, 5, 15 };
int CountsFallen[] = { 1, 2, 5, 10 };

//----------------------------------
// флажки состояний
bool tumbStateFlag;  // флажок для тумблера что бы знать состояние до уровня
bool FirstFlag = 0;
bool SecondFlag = 0;
bool ThirdFlag = 0;
bool FourFlag = 0;
bool upHelp;
byte light;
bool FirstBottleTrue = 1;
bool FirstBottleFalse = 1;
bool SecondBottleTrue = 1;
bool SecondBottleFalse = 1;
bool ThirdBottleTrue = 1;
bool ThirdBottleFalse = 1;
bool FourBottleTrue = 1;
bool FourBottleFalse = 1;
bool helpFlag;
bool flagSound = 1;
bool _trollDoor = 0;

// Глобальные флаги состояния для PowerOn() и RestOn()
// --- Таймер для состояния прослушивания ---
unsigned long readyListenTimer = 0;
const unsigned long READY_LISTEN_DURATION = 3000;  // 3 секунды для прослушивания ответов от башен
// ---
bool _dataQueue = 0;
unsigned long _towerTimer = 0;
byte _towerCounter = 0;
bool doorEvent = 0;
bool mansardEvent = 0;
bool libraryEvent = 0;
bool galet1Event = 0;
bool galet2Event = 0;
bool galet3Event = 0;
bool galet4Event = 0;
bool galet5Event = 0;
bool sealEvent = 0;
bool sealSpaceEvent = 0;
bool finalEvent = 0;
bool crimeEvent = 0;
bool safeEvent = 0;
unsigned long bugTimerScroll = 0;
bool firstRun = true;
bool helpsBankTimerWaiting = false;  // Флаг: ждем, пока сервер доиграет подсказку
bool isBankerFirstHint = true;
bool isRestInitialized = false;  // Флаг для однократной инициализации режима Rest

///////////////////таймеры туть
unsigned long FireInterval = 0;
unsigned long CauldronFireInterval = 0;
unsigned long CauldronFireMistakeInterval = 0;
unsigned long CauldronFireTrueInterval = 0;
unsigned long Bottle1Timer = 0;
unsigned long Bottle2Timer = 0;
unsigned long Bottle3Timer = 0;
unsigned long Bottle4Timer = 0;
unsigned long sealSpaceTimer;
unsigned long doorDef;
unsigned long doorTimer;
unsigned long finalPresentation;
unsigned long safeTimer;
unsigned long crimeHelpTimer;
//////////////////
const int threshold = 300;  // пороговое значение для пьезодатчика изменить в зависимости от вибраций
int scrollNumber = 0;       // последовательность свитков
////////////
byte level = 0;          // уровни для квеста установить какой нужен в случае проверки
byte previousLevel = 0;  // Переменная для отслеживания смены уровня ---
byte Bottle = 0;
String BotScore = "";
byte OwlScore = 0;
byte NumKnock = 0;
bool doorFlags = 1;
bool flagStory = 1;
//////двери - локеры
const byte MansardDoor = A6;      // локер мансарды
const byte PotionsRoomDoor = A3;  // локер команты зельеварения
const byte LibraryDoor = A11;     // локер библиотеки
const byte BankDoor = A4;         // локер банка
const byte HightTowerDoor = A9;   // локер последней башни
const byte HightTowerDoor2 = 30;  // локер последней башни
const byte MemoryRoomDoor = A2;   // локер комнаты воспоминаний
const byte CrimeDoor = 34;        // локер тюрьмы
const byte BankStashDoor = A10;   // локер тайника в банке

const byte doors[] = {
  MansardDoor,
  PotionsRoomDoor,
  LibraryDoor,
  BankDoor,
  HightTowerDoor,
  HightTowerDoor2,
  MemoryRoomDoor,
  CrimeDoor,
  BankStashDoor
};
const int DOORS = sizeof(doors) / sizeof(doors[0]);

// состояния
unsigned long lastOpen[DOORS];
bool active[DOORS];

// тайники - локеры
const byte LibraryLight = A7;  // свет библиотеки
// A8 свободен: здесь был соленоид «тук-тук» библиотеки. Соленоид демонтирован,
// стук призрака теперь только звук knock_castle.wav на колонках замка (2026-08-07).


// свет обычные ленты
const byte HallLight = 37;          /// свет 1 комнаты
const byte UfHallLight = A5;        /// свет 1 комнаты уф
const byte MansardLight = 39;       /// свет внутри мансарды лента
const byte LastTowerTopLight = 36;  ////свет наверху led башни круглой(последней)
const byte Fireworks = 3;           // это огоньки фейрверка 3 пин
const byte BankRoomLight = 4;       ////бра в банке
const byte TorchLight = 7;          // факела в последней башне
// светодиодные шары
///////////////////////////keys RFID
unsigned int validHex[][8] = {
  { 0x1, 0xC9, 0x0, 0x0, 0x0, 0x0, 0x0, 0x34 },  // 1
  {
    0x1, 0xCA, 0x0, 0x0, 0x0, 0x0, 0x0, 0x6D },  // 2
  {
    0x1, 0xCB, 0x0, 0x0, 0x0, 0x0, 0x0, 0x5A },
  { 0x1, 0xCC, 0x0, 0x0, 0x0, 0x0, 0x0, 0xDF }
};

// фильтр
int val[3];
int val_filter;
// 2026-08-07: глухое окно датчика стука библиотеки — см. Library(), case 6.
unsigned long knockArmedAt = 0;
const unsigned long KNOCK_BLANK_MS = 4000;
const unsigned long LIB_DOOR_FALLBACK_MS = 25000;  // см. LibraryGame()
byte index;
String string = "";

unsigned long previousMillis = 0;
int interval = 10;                         // Интервал обновления (мс)
unsigned long directionChangeTime = 3000;  // Время до смены направления (мс)
unsigned long lastDirectionChange = 0;
unsigned long enemyTimer = 0;
unsigned long additionalTimer = 0;
unsigned long cometTimer1 = 0;
unsigned long dragonTimer;
int direction = 1;  // 1 - вперед, -1 - назад
int headPosition = 0;
// Цвет кометы (золотой)
uint32_t cometColor = strip1.Color(255, 215, 0);   // RGB для золотого цвета
uint32_t backgroundColor = strip1.Color(0, 0, 0);  // Черный фон
bool enemyFlag;

// Параметры кометы
int cometLength = 5;               // Длина кометы в диодах
int cometPosition = -cometLength;  // Начальная позиция кометы
int totalLEDs = 252;               // Общее количество светодиодов

bool clickFlag1;
bool clickFlag2;
bool clickFlag3;
bool clickFlag4;
bool clickFlag11;
bool clickFlag22;
bool clickFlag31;
bool clickFlag41;
bool snitchFlag = 1;
bool stepsFlag;
bool centralTowerGameFlag;
bool fireFlag;

// ФИКС баг2: CentralTowerGame() — были static, не сбрасывались при restart
int centralTowerState = 0;
bool centralTowerCupFlag = 0;
bool centralTowerFirePressed = false;

// ФИКС багА: CentralTowerGameDown() — свайп-заклинание, level 14
int swipeState_g = 0;
int puzzleProgress_g = 0;
unsigned long swipeTimer_g = 0;
unsigned long lastDebounceTimeLeft_g = 0;
unsigned long lastDebounceTimeRight_g = 0;
bool lastSteadyLeftState_g = HIGH;
bool lastSteadyRightState_g = HIGH;
bool currentLeftState_g = HIGH;
bool currentRightState_g = HIGH;
bool initialSwitchReleased_g = false;

// ФИКС багА: ClockGame() — часы, level 2
bool clockRepeat = false;
bool clockSwitchMustBeOffFirst = true;

// ФИКС багА: GaletGame() — галетники, level 4
bool galetInit1 = false;
bool galetInit2 = false;
bool galetInit3 = false;
bool galetInit4 = false;
bool galetStartSteps = false;
unsigned long galetStepsTimer = 0;
bool galetLogicEnabled = false;
bool galetIsGameInitialized = false;
bool galetGameReadyToWin = false;
bool galetVictorySent = false;
unsigned long galetRefreshTowerTimer = 0;
unsigned long galetGlobalTimeout = 0;
// Флаги состояния галетников (были static bool galet1..5)
bool galetG1 = false;
bool galetG2 = false;
bool galetG3 = false;
bool galetG4 = false;
bool galetG5 = false;

// ФИКС багА: ThreeGame() — три игры (Волк/Сейф/Чемодан), level 5
bool threeWolfFlag = false;
bool threeSafeFlag = false;
bool threeSuitcaseFlag = false;

// ФИКС багА: MapGame() — карта, level 7
bool mapPotionFadingOut = false;
String mapGame_g = "";
bool mapActivePotionRoom = false;
unsigned long mapPotionFadeTimer = 0;
int mapPotionBrightness = 0;
bool mapPotionFading = false;
bool mapIsWaitingForTroll = false;
unsigned long mapTrollWaitTimer = 0;
bool mapIsFinishingMap = false;
unsigned long mapFinishMapTimer = 0;

// ФИКС багА: BasketLesson() — урок баскетбол, level 18
bool basketLessonIsSend = false;

unsigned long code1Timer;
unsigned long code2Timer;
unsigned long code3Timer;
unsigned long code4Timer;
unsigned long libraryDoorTimer;
bool Scroll1On;
bool Scroll2On;
bool Scroll3On;
bool Scroll4On;
bool Scroll11On;
bool Scroll21On;
bool Scroll31On;
bool Scroll41On;
bool dragonFlag;
// Повтор подсказки дракона (story_2_r). Раньше таймер заводился на старте
// квеста, а первые 80 секунд занимает вступление — повтор звучал через 40
// секунд реального поиска и выдавал содержание story_2_b авансом. Теперь
// отсчёт начинается только КОГДА story_2_b доиграла, то есть когда игрок уже
// коснулся кристалла и услышал реплику целиком. Не static: статические
// переменные переживают restart и оставляют состояние от прошлой партии.
bool dragonRepeatArmed = false;
bool prevFlagSound = true;   // flagSound по умолчанию 1 — стартуем с той же

bool isPotionEnd;
bool isDogEnd;
bool isOwlEnd;
bool isTrainEnd;
bool isTrollEnd;
bool isTrainBasket;
int ghostState = 0;
bool potionPulsation = 0;
bool goldPulsation = 0;

// Переменные для мерцания света в библиотеке
bool isLibraryFlickering = false;
unsigned long libraryFlickerTimer = 0;
unsigned long libraryFlickerIntervalTimer = 0;

String dragonHints[] = { "dragon_crystal", "hint_2_b", "hint_2_c", "hint_2_z", "hint_5_b", "hint_5_c" };
String studentHints[] = { "hint_3_b", "hint_3_c", "hint_3_z", "hint_37_b", "hint_37_c", "hint_38_b", "hint_44_b", "hint_44_c" };
String professorHints[] = { "hint_6_b", "hint_6_c", "hint_10_b", "hint_10_c", "hint_11_b", "hint_11_c", "hint_11_z" };
String dwarfHints[] = { "hint_14_b", "hint_14_c", "hint_14_z" };
String witchHints[] = { "hint_17_b", "hint_17_c", "hint_17_z" };
String knightHints[] = { "hint_19_b", "hint_19_c", "hint_19_z" };
String goblinHints[] = { "hint_23_b", "hint_23_c", "hint_23_z" };
String trollHints[] = { "hint_26_b", "hint_26_c", "hint_26_z" };
String workshopHints[] = { "hint_32_b", "hint_32_c", "hint_32_d", "hint_32_e", "hint_32_z" };
String directorHints[] = { "hint_49_b", "hint_49_c", "hint_50_b", "hint_50_c", "hint_51_b", "hint_51_c", "hint_56_b" };

// Что прямо сейчас происходит в Мастерской. Раньше главная плата эти строки
// только пересылала серверу и своего состояния не держала — а подсказкам оно
// нужно: пока печка холодная, первое, что надо сказать, это «разожги печь»
// (hint_32_b); когда она уже разгорелась, напоминать про розжиг нечего.
byte workshopFireStage = 0;       // 0..3, приходит от башни строками fire0..fire3
bool workshopBroomDone = false;   // метла собрана (строка broom)
bool workshopHelmetDone = false;  // шлем собран (строка helmet)
byte workshopHotHintStep = 0;     // шаг цепочки подсказок при разгоревшейся печке

// Запоминаем состояние Мастерской по её же сообщениям. Зовётся из ОБОИХ
// парсеров Serial1 — плата читает башню в двух разных местах.
void noteWorkshopState(const String &s) {
  if (s == "fire0" || s == "fire1") {
    workshopFireStage = (s == "fire1") ? 1 : 0;
    // Печка остыла: раскраска верстака при падении ниже второго уровня
    // теряется (см. updateWorkbenchLeds в workshop.ino), поэтому и цепочку
    // подсказок начинаем заново — с hint_32_c.
    workshopHotHintStep = 0;
  } else if (s == "fire2") {
    workshopFireStage = 2;
  } else if (s == "fire3") {
    workshopFireStage = 3;
  } else if (s == "broom") {
    workshopBroomDone = true;
  } else if (s == "helmet") {
    workshopHelmetDone = true;
  }
}

// ---------- Диагностика Комнаты Мозга (шаг «Первого запуска») ----------
//
// Снаружи все четыре гнезда кристаллов одинаковые, и при монтаже одинаково
// легко перепутать и провода герконов, и порядок групп на ленте. Проверяем то
// же, что и на верстаке Мастерской: пару «геркон → своя группа диодов», плюс
// обход групп по одной, чтобы сверить их физическое расположение.
//
// Лента комнаты одна (memory_Led, 41 диод на пине 11), игра использует 32:
//   гнёзда кристаллов 1-4 → диоды 0-3, 4-7, 8-11, 12-15
//   ячейки символов 1-4   → диоды 16-19, 20-23, 24-27, 28-31
// Остальные диоды ленты в игре не участвуют, поэтому тест их не трогает.
const byte BR_GROUP_COUNT = 8;
const byte BR_GROUP_SIZE = 4;
const byte BR_LEDS_USED = BR_GROUP_COUNT * BR_GROUP_SIZE;  // 32
const byte BR_CRYSTAL_PINS[4] = { firstCrystal, secondCrystal, thirdCrystal, fourCrystal };

byte brTestMode = 0;  // 0 — выключено, 1 — режим герконов, 2 — статичная картинка
bool brReedStable[4] = { false, false, false, false };
bool brReedPending[4] = { false, false, false, false };
unsigned long brReedSince[4] = { 0, 0, 0, 0 };
const unsigned long BR_REED_DEBOUNCE_MS = 60;

// У каждой группы свой цвет: монтажник видит, КАКАЯ группа загорелась, не
// пересчитывая диоды. Те же цвета подписаны на плашках тех-пульта.
uint32_t brGroupColor(byte g) {
  switch (g) {
    case 0: return memory_Led.Color(250, 0, 0);      // гнездо 1 — красный
    case 1: return memory_Led.Color(0, 250, 0);      // гнездо 2 — зелёный
    case 2: return memory_Led.Color(0, 80, 250);     // гнездо 3 — синий
    case 3: return memory_Led.Color(250, 200, 0);    // гнездо 4 — жёлтый
    case 4: return memory_Led.Color(250, 0, 200);    // ячейка 1 — розовый
    case 5: return memory_Led.Color(0, 220, 220);    // ячейка 2 — бирюзовый
    case 6: return memory_Led.Color(250, 90, 0);     // ячейка 3 — оранжевый
    default: return memory_Led.Color(160, 160, 160); // ячейка 4 — белый
  }
}

void brSetGroup(byte g, bool on) {
  byte first = g * BR_GROUP_SIZE;
  uint32_t color = on ? brGroupColor(g) : 0;
  for (byte i = 0; i < BR_GROUP_SIZE; i++) memory_Led.setPixelColor(first + i, color);
}

void brTestClear() {
  for (byte i = 0; i < BR_LEDS_USED; i++) memory_Led.setPixelColor(i, 0);
  memory_Led.show();
}

// Тик режима герконов. Кристалл на месте — геркон замкнут (LOW), как и в игре
// (giftGame читает через `!digitalRead`). Меряем напрямую, без GyverButton:
// антидребезг здесь свой и мягкий, чтобы длинный провод не сыпал ложными.
void brTestTick() {
  if (brTestMode != 1) return;
  static unsigned long lastPoll = 0;
  if (millis() - lastPoll < 20) return;
  lastPoll = millis();

  bool changed = false;
  for (byte i = 0; i < 4; i++) {
    bool closed = (digitalRead(BR_CRYSTAL_PINS[i]) == LOW);
    if (closed != brReedPending[i]) {
      brReedPending[i] = closed;
      brReedSince[i] = millis();
    } else if (closed != brReedStable[i] && millis() - brReedSince[i] >= BR_REED_DEBOUNCE_MS) {
      brReedStable[i] = closed;
      brSetGroup(i, closed);
      changed = true;
      Serial.print(F("brtest:reed:"));
      Serial.print(i + 1);
      Serial.print(':');
      Serial.println(closed ? 1 : 0);
    }
  }
  if (changed) memory_Led.show();
}

// Разбор команд с тех-пульта. true — строка наша, дальше её не разбирать.
//   brtest_reeds — режим «геркон → своя группа»
//   brtest_g1..g8 — зажечь одну группу (1-4 гнёзда, 5-8 ячейки)
//   brtest_all   — все 32 диода белым, поиск мёртвых пикселей
//   brtest_off   — выключить
bool handleBrTestCmd(const String &buff) {
  if (!buff.startsWith("brtest_")) return false;
  String mode = buff.substring(7);

  if (mode == "off") {
    brTestMode = 0;
    brTestClear();
    Serial.println(F("brtest:off"));
    return true;
  }

  // Включение любого режима: яркость выставляем явно — игра её по ходу
  // приглушает до 50, и тест на чужой яркости выглядел бы «тусклым браком».
  memory_Led.setBrightness(150);

  if (mode == "reeds") {
    brTestMode = 1;
    brTestClear();
    // Сразу показываем текущее положение кристаллов, не дожидаясь движения:
    // монтажник видит картину как есть, а не пустую ленту.
    for (byte i = 0; i < 4; i++) {
      brReedStable[i] = (digitalRead(BR_CRYSTAL_PINS[i]) == LOW);
      brReedPending[i] = brReedStable[i];
      brSetGroup(i, brReedStable[i]);
      Serial.print(F("brtest:reed:"));
      Serial.print(i + 1);
      Serial.print(':');
      Serial.println(brReedStable[i] ? 1 : 0);
    }
    memory_Led.show();
    Serial.println(F("brtest:on"));
    return true;
  }

  if (mode == "all") {
    brTestMode = 2;
    for (byte i = 0; i < BR_LEDS_USED; i++) memory_Led.setPixelColor(i, memory_Led.Color(160, 160, 160));
    memory_Led.show();
    Serial.println(F("brtest:on"));
    return true;
  }

  if (mode.length() == 2 && mode[0] == 'g') {
    byte g = mode[1] - '1';
    if (g < BR_GROUP_COUNT) {
      brTestMode = 2;
      brTestClear();
      brSetGroup(g, true);
      memory_Led.show();
      Serial.println(F("brtest:on"));
    }
    return true;
  }

  return true;  // своя команда, но незнакомая — молча съедаем
}

// ---------- Тест света первой комнаты (шаг «Первого запуска») ----------
//
// В комнате два независимых выхода: обычное освещение (HallLight, пин 37) и
// ультрафиолет (UfHallLight, A5). Монтажник должен проверить каждый отдельно,
// не проходя сценарий: до сих пор УФ загорался только на часах, а обычный свет
// на стартовой двери — то есть проверить их можно было лишь по ходу игры.
//
// Кнопка включает свой выход и ГАСИТ другой: в игре они взаимоисключающие
// (на часах УФ включается, обычный гаснет), и если жечь оба сразу, глазом не
// разобрать, какой из них работает.
bool handleRoomLightCmd(const String &buff) {
  if (!buff.startsWith("roomtest_")) return false;
  String mode = buff.substring(9);
  if (mode == "uv") {
    digitalWrite(UfHallLight, HIGH);
    digitalWrite(HallLight, LOW);
  } else if (mode == "light") {
    digitalWrite(HallLight, HIGH);
    digitalWrite(UfHallLight, LOW);
  } else {
    digitalWrite(HallLight, LOW);
    digitalWrite(UfHallLight, LOW);
    mode = "off";
  }
  Serial.print(F("roomtest:"));
  Serial.println(mode);
  return true;
}

// --- НОВАЯ СИСТЕМА УМНЫХ ПОДСКАЗОК ---
int hintSteps[20] = { 0 };
unsigned long hintTimes[20] = { 0 };

int getSmartHint(int seqId, int startIndex, int endIndex) {
  unsigned long now = millis();
  int indexToPlay;
  int numHints = endIndex - startIndex + 1;

  if (numHints <= 1) return startIndex;  // Если всего 1 подсказка

  if (hintSteps[seqId] == 0) {
    indexToPlay = startIndex;
    hintSteps[seqId] = 1;
    hintTimes[seqId] = now;
  } else if (hintSteps[seqId] == 1) {
    if (now - hintTimes[seqId] < 30000) {
      indexToPlay = startIndex;  // Повтор первой подсказки (<30с)
      hintSteps[seqId] = 2;      // Дальше пойдет по кругу без первой
    } else {
      indexToPlay = startIndex + 1;  // Переход ко второй (>30с)
      hintSteps[seqId] = 3;
    }
  } else {
    int loopSize = numHints - 1;
    indexToPlay = startIndex + 1 + ((hintSteps[seqId] - 2) % loopSize);
    hintSteps[seqId]++;
  }
  return indexToPlay;
}
// -------------------------------------

int dragonCounter = 0;
int studentCounter = 0;
int professorCounter = 0;
int dwarfCounter = 0;
int knightCounter = 0;
int trollCounter = 0;
int workshopCounter = 0;
int directorCounter = 0;
int goblinCounter = 0;
int witchCounter = 0;

unsigned long KayTimer = 0;
// Глобальные переменные для отслеживания состояния "мальчика" в режиме ожидания ---
bool boyStateInitialized = false;
bool lastBoyState = true;  // По умолчанию 'out' (true)
unsigned long boyCheckTimer = 0;

// --- Watchdog для Баскетбола ---
unsigned long basketWatchdogTimer = 0;
bool waitingForBasketConfirm = false;
int basketRetryCount = 0;
const int MAX_BASKET_RETRIES = 10;

void MagicEffect() {
  static uint32_t lastUpdate = 0;
  static uint16_t timeCounter = 0;
  unsigned long now = millis();
  if (now - lastUpdate < 31) return;  // скорость анимации
  lastUpdate = now;

  timeCounter++;

  for (int s = 0; s < STRIPS; s++) {
    Adafruit_NeoPixel* strip = strips[s];
    int n = strip->numPixels();

    // Затухание предыдущих кадров для создания шлейфа
    for (int i = 0; i < n; i++) {
      uint32_t currentColor = strip->getPixelColor(i);
      uint8_t r = (currentColor >> 16) & 0xFF;
      uint8_t g = (currentColor >> 8) & 0xFF;
      uint8_t b = currentColor & 0xFF;

      // Плавное затухание
      r = r * 0.7;
      g = g * 0.7;
      b = b * 0.7;

      strip->setPixelColor(i, r, g, b);
    }

    // Создание новых "вспышек" фейерверка
    for (int i = 0; i < n; i++) {
      // Вероятность появления новой искры
      if (random(1000) < 8) {
        // Выбор случайного цвета из палитры
        int colorIndex = random(COLORS - 1);
        uint32_t baseColor = palette[colorIndex];

        uint8_t baseR = (baseColor >> 16) & 0xFF;
        uint8_t baseG = (baseColor >> 8) & 0xFF;
        uint8_t baseB = baseColor & 0xFF;

        // Случайная интенсивность для разнообразия
        float intensity = 0.7 + (random(50) / 100.0);

        uint8_t r = min(255, (int)(baseR * intensity));
        uint8_t g = min(255, (int)(baseG * intensity));
        uint8_t b = min(255, (int)(baseB * intensity));

        // Создание небольшого кластера искр
        int clusterSize = random(2, 5);
        for (int j = max(0, i - clusterSize / 2); j <= min(n - 1, i + clusterSize / 2); j++) {
          float distance = abs(j - i) / (float)clusterSize;
          float fade = 1.0 - distance;

          uint8_t clusterR = r * fade;
          uint8_t clusterG = g * fade;
          uint8_t clusterB = b * fade;

          // Смешивание с существующим цветом
          uint32_t existingColor = strip->getPixelColor(j);
          uint8_t existingR = (existingColor >> 16) & 0xFF;
          uint8_t existingG = (existingColor >> 8) & 0xFF;
          uint8_t existingB = existingColor & 0xFF;

          strip->setPixelColor(j,
                               max(clusterR, existingR),
                               max(clusterG, existingG),
                               max(clusterB, existingB));
        }
      }
    }

    // Добавление ярких белых искр-вспышек
    if (random(1000) < 15) {
      int sparkPos = random(n);
      byte intensity = random(100, 150);

      // Создание небольшой белой вспышки
      for (int i = max(0, sparkPos - 1); i <= min(n - 1, sparkPos + 1); i++) {
        float distance = abs(i - sparkPos) / 2.0;
        byte sparkIntensity = intensity * (1.0 - distance);
        strip->setPixelColor(i, sparkIntensity, sparkIntensity, sparkIntensity);
      }
    }

    strip->show();
    delay(2);
  }
}

void handleUfBlinking() {
  // Если мигание не активно, ничего не делаем
  if (!isUfBlinking) {
    return;
  }

  // Проверяем, прошло ли 500 мс
  if (millis() - ufBlinkTimer >= 500) {
    ufBlinkTimer = millis();  // Сбрасываем таймер

    if (ufBlinkCount % 2 == 0) {
      // Четный шаг: включаем свет
      digitalWrite(UfHallLight, HIGH);
    } else {
      // Нечетный шаг: выключаем свет
      digitalWrite(UfHallLight, LOW);
    }

    ufBlinkCount++;  // Увеличиваем счетчик шагов

    // Если мы выполнили все 6 шагов (3 вкл + 3 выкл)
    if (ufBlinkCount >= UF_BLINK_TOTAL) {
      isUfBlinking = false;            // Останавливаем мигание
      digitalWrite(UfHallLight, LOW);  // Гарантированно выключаем свет
      ufBlinkCount = 0;
    }
  }
}

///////////////////////////////48 свободный
void setup() {
  // ДОБАВЛЕНО: Лог о начале загрузки
  Serial.begin(115200);  // Начинаем серийный порт как можно раньше
  Serial.println(F("log:main:Booting up..."));
  delay(20);  // Небольшая задержка, чтобы лог успел уйти
  // КОНЕЦ
  pinMode(firstCrystal, INPUT_PULLUP);
  pinMode(secondCrystal, INPUT_PULLUP);
  pinMode(thirdCrystal, INPUT_PULLUP);
  pinMode(fourCrystal, INPUT_PULLUP);

  pinMode(WindowSens, INPUT_PULLUP);

  pinMode(MansardDoor, OUTPUT);
  pinMode(PotionsRoomDoor, OUTPUT);
  pinMode(LibraryDoor, OUTPUT);
  pinMode(BankDoor, OUTPUT);
  pinMode(HightTowerDoor, OUTPUT);
  pinMode(MemoryRoomDoor, OUTPUT);

  pinMode(LibraryLight, OUTPUT);
  pinMode(BankStashDoor, OUTPUT);
  pinMode(HallLight, OUTPUT);
  pinMode(UfHallLight, OUTPUT);
  pinMode(CrimeDoor, OUTPUT);

  pinMode(MansardLight, OUTPUT);
  pinMode(LastTowerTopLight, OUTPUT);
  pinMode(Fireworks, OUTPUT);
  pinMode(BankRoomLight, OUTPUT);
  pinMode(TorchLight, OUTPUT);
  pinMode(HightTowerDoor2, OUTPUT);


  digitalWrite(MansardLight, LOW);
  digitalWrite(LastTowerTopLight, LOW);
  digitalWrite(Fireworks, LOW);
  digitalWrite(LibraryLight, LOW);
  digitalWrite(BankRoomLight, LOW);
  digitalWrite(HallLight, LOW);
  digitalWrite(UfHallLight, LOW);
  digitalWrite(HightTowerDoor2, LOW);
  digitalWrite(TorchLight, LOW);
  for (int i = 0; i < DOORS; i++) {
    digitalWrite(doors[i], LOW);
  }
  ///--------------------
  ///////порты uart
  Serial.begin(115200);  // raspberry
  Serial.setTimeout(50);
  // --- ЗАЩИТА ОТ ФРАГМЕНТАЦИИ ПАМЯТИ (ОТ ЗАВИСАНИЙ) ---
  serial1Buffer.reserve(256);
  serial2Buffer.reserve(256);
  serial3Buffer.reserve(256);
  mySerialBuffer.reserve(256);
  mainSerialBuffer.reserve(256);
  // ----------------------------------------------------
  // Таймаут чтения строки от башен: 10 → 100 мс.
  //
  // 18.08.2026, CLC4: до половины строк от башен приходили обрубками
  // (galet_of, gale5, galet_offHȱ_off). Башни говорят на 9600, один символ
  // это ~1 мс, а readStringUntil('\n') сдавался через 10 — то есть примерно
  // после десяти символов. «galet_off» с переводом строки ровно десять и есть:
  // монетка, успеет строка дойти или нет.
  //
  // Раньше это не проявлялось: цикл платы шёл 1,4 мс, каждый опрос расширителя
  // спал миллисекунду, и читатель приходил к буферу С ОПОЗДАНИЕМ — строка уже
  // лежала целиком. Ускорение опроса расширителя (200 мкс вместо 1 мс) убрало
  // эту задержку и вскрыло мину: читатель стал приходить мгновенно.
  //
  // 100 мс — двойной запас на самую длинную строку башни (~48 символов ≈ 50 мс).
  // Ждать столько цикл НЕ будет: readStringUntil возвращается сразу по '\n',
  // таймаут это потолок на случай оборванной строки, а не постоянная плата.
  const unsigned long TOWER_READ_TIMEOUT_MS = 100;
  Serial1.begin(9600);  // front left
  Serial1.setTimeout(TOWER_READ_TIMEOUT_MS);
  Serial2.begin(9600);  // front right
  Serial2.setTimeout(TOWER_READ_TIMEOUT_MS);
  Serial3.begin(9600);  // rear right
  Serial3.setTimeout(TOWER_READ_TIMEOUT_MS);
  mySerial.begin(9600);  // rear left
  mySerial.setTimeout(TOWER_READ_TIMEOUT_MS);

  strip1.begin();
  strip1.setBrightness(100);
  strip1.show();

  strip2.begin();
  strip2.setBrightness(100);
  strip2.show();

  //// инициализация лент
  GoldStrip.begin();
  GoldStrip.setBrightness(255);
  CandleStrip.begin();
  CandleStrip.setBrightness(255);
  CauldronStrip.begin();
  CauldronStrip.setBrightness(255);
  memory_Led.begin();
  memory_Led.setBrightness(255);
  CauldronRoomStrip.begin();
  CauldronRoomStrip.setBrightness(255);
  for (int i = 0; i <= 50; i++) {
    GoldStrip.setPixelColor(i, GoldStrip.Color(0, 0, 0));
    CandleStrip.setPixelColor(i, CandleStrip.Color(0, 0, 0));
    CauldronStrip.setPixelColor(i, CauldronStrip.Color(0, 0, 0));
    CauldronRoomStrip.setPixelColor(i, CauldronRoomStrip.Color(0, 0, 0));
    memory_Led.setPixelColor(i, memory_Led.Color(0, 0, 0));
  }
  GoldStrip.show();
  CandleStrip.show();
  CauldronStrip.show();
  CauldronRoomStrip.show();
  memory_Led.show();
  ////

  /// инициализация входов на библе гувера для цифровых входов
  startDoor.setDebounce(50);       // настройка антидребезга (по умолчанию 80 мс)
  startDoor.setTimeout(300);       // настройка таймаута на удержание (по умолчанию 500 мс)
  startDoor.setClickTimeout(600);  // настройка таймаута между кликами (по умолчанию 300 мс)
  startDoor.setType(HIGH_PULL);
  startDoor.setDirection(NORM_OPEN);
  ///////////------
  goldButton.setDebounce(50);       // настройка антидребезга (по умолчанию 80 мс)
  goldButton.setTimeout(300);       // настройка таймаута на удержание (по умолчанию 500 мс)
  goldButton.setClickTimeout(600);  // настройка таймаута между кликами (по умолчанию 300 мс)
  goldButton.setType(HIGH_PULL);
  goldButton.setDirection(NORM_OPEN);
  ///////////------

  goblinButton.setDebounce(50);       // настройка антидребезга (по умолчанию 80 мс)
  goblinButton.setTimeout(300);       // настройка таймаута на удержание (по умолчанию 500 мс)
  goblinButton.setClickTimeout(600);  // настройка таймаута между кликами (по умолчанию 300 мс)
  goblinButton.setType(HIGH_PULL);
  goblinButton.setDirection(NORM_OPEN);

  clock1Button.setDebounce(50);       // настройка антидребезга (по умолчанию 80 мс)
  clock1Button.setTimeout(300);       // настройка таймаута на удержание (по умолчанию 500 мс)
  clock1Button.setClickTimeout(600);  // настройка таймаута между кликами (по умолчанию 300 мс)
  clock1Button.setType(HIGH_PULL);
  clock1Button.setDirection(NORM_OPEN);

  clock2Button.setDebounce(50);       // настройка антидребезга (по умолчанию 80 мс)
  clock2Button.setTimeout(300);       // настройка таймаута на удержание (по умолчанию 500 мс)
  clock2Button.setClickTimeout(600);  // настройка таймаута между кликами (по умолчанию 300 мс)
  clock2Button.setType(HIGH_PULL);
  clock2Button.setDirection(NORM_OPEN);

  //clock3Button.setDebounce(50);       // настройка антидребезга (по умолчанию 80 мс)
  //clock3Button.setTimeout(300);       // настройка таймаута на удержание (по умолчанию 500 мс)
  //clock3Button.setClickTimeout(600);  // настройка таймаута между кликами (по умолчанию 300 мс)
  //clock3Button.setType(HIGH_PULL);
  //clock3Button.setDirection(NORM_OPEN);

  directorButton.setDebounce(50);       // настройка антидребезга (по умолчанию 80 мс)
  directorButton.setTimeout(300);       // настройка таймаута на удержание (по умолчанию 500 мс)
  directorButton.setClickTimeout(600);  // настройка таймаута между кликами (по умолчанию 300 мс)
  directorButton.setType(HIGH_PULL);
  directorButton.setDirection(NORM_OPEN);

  dragonButton.setDebounce(50);       // настройка антидребезга (по умолчанию 80 мс)
  dragonButton.setTimeout(300);       // настройка таймаута на удержание (по умолчанию 500 мс)
  dragonButton.setClickTimeout(600);  // настройка таймаута между кликами (по умолчанию 300 мс)
  dragonButton.setType(HIGH_PULL);
  dragonButton.setDirection(NORM_OPEN);

  studentButton.setDebounce(50);       // настройка антидребезга (по умолчанию 80 мс)
  studentButton.setTimeout(300);       // настройка таймаута на удержание (по умолчанию 500 мс)
  studentButton.setClickTimeout(600);  // настройка таймаута между кликами (по умолчанию 300 мс)
  studentButton.setType(HIGH_PULL);
  studentButton.setDirection(NORM_OPEN);

  professorButton.setDebounce(50);       // настройка антидребезга (по умолчанию 80 мс)
  professorButton.setTimeout(300);       // настройка таймаута на удержание (по умолчанию 500 мс)
  professorButton.setClickTimeout(600);  // настройка таймаута между кликами (по умолчанию 300 мс)
  professorButton.setType(HIGH_PULL);
  professorButton.setDirection(NORM_OPEN);

  witchButton.setDebounce(50);       // настройка антидребезга (по умолчанию 80 мс)
  witchButton.setTimeout(300);       // настройка таймаута на удержание (по умолчанию 500 мс)
  witchButton.setClickTimeout(600);  // настройка таймаута между кликами (по умолчанию 300 мс)
  witchButton.setType(HIGH_PULL);
  witchButton.setDirection(NORM_OPEN);

  galetSwitches.setDebounce(50);       // настройка антидребезга (по умолчанию 80 мс)
  galetSwitches.setTimeout(300);       // настройка таймаута на удержание (по умолчанию 500 мс)
  galetSwitches.setClickTimeout(600);  // настройка таймаута между кликами (по умолчанию 300 мс)
  galetSwitches.setType(HIGH_PULL);
  galetSwitches.setDirection(NORM_OPEN);


  ////----------
  int Voltage = analogRead(voltagePin);
  // Serial.println(Voltage);
  float volt = 0.0048 * Voltage * 3;

  pinMode(pinA, OUTPUT);
  pinMode(pinB, OUTPUT);
  pinMode(pinC, OUTPUT);
  pinMode(board1, INPUT_PULLUP);
  pinMode(board2, INPUT_PULLUP);
  pinMode(board3, INPUT_PULLUP);
  pinMode(board4, INPUT_PULLUP);

  boyServo.attach(49, boyPulseMin, boyPulseMax);
  boyServo.write(boyAngleHide);
  boyServo.detach();
  // --- БЛОК ПРОВЕРКИ БАШЕН ---
  Serial.println(F("log:main:Checking towers..."));

  // 1. Очищаем буферы от мусора
  while (Serial1.available()) Serial1.read();
  while (Serial2.available()) Serial2.read();
  while (Serial3.available()) Serial3.read();
  while (mySerial.available()) mySerial.read();

  // 2. Отправляем пинг (команду 'ready' или 'ping', на которую башни реагируют)
  // Башни обычно отвечают логами или статусом на 'ready'
  Serial1.println(F("ready"));
  Serial2.println(F("ready"));
  Serial3.println(F("ready"));
  mySerial.println(F("ready"));

  // 3. Ждем ответов (Таймаут 2 секунды)
  unsigned long startCheck = millis();
  bool t1 = false;  // Workshop
  bool t2 = false;  // Basket
  bool t3 = false;  // Dog
  bool t4 = false;  // Owls

  while (millis() - startCheck < 2000) {
    if (Serial1.available()) t1 = true;
    if (Serial2.available()) t2 = true;
    if (Serial3.available()) t3 = true;
    if (mySerial.available()) t4 = true;

    // Если все ответили - выходим досрочно
    if (t1 && t2 && t3 && t4) break;
  }

  // 4. Анализ результатов
  if (t1 && t2 && t3 && t4) {
    // Все башни на связи + Main загрузился
    Serial.println(F("log:main:All towers online."));
    delay(100);
    Serial.println(F("QUEST_SYSTEM_READY"));  // Команда для Python играть звук
  } else {
    // Кто-то молчит
    Serial.print(F("log:warn:Missing towers: "));
    if (!t1) Serial.print(F("Workshop "));
    if (!t2) Serial.print(F("Basket "));
    if (!t3) Serial.print(F("Dog "));
    if (!t4) Serial.print(F("Owls "));
    Serial.println();
    // Звук НЕ играем, так как условие "все контроллеры дали ответ" не выполнено
  }
  // ---------------------------------------
}

// Умная задержка: ждет, но не дает буферам башен переполниться
void smartDelay(unsigned long ms) {
  unsigned long start = millis();
  while (millis() - start < ms) {
    HelpTowersHandler();  // Постоянно забираем логи у башен
    // Небольшая пауза 1 мс, чтобы не перегружать процессор
    delay(1);
  }
}

void loop() {
  // 2026-05-28: DIAG mode early-return УДАЛЁН (облегчение loop).

  // === Замер времени итерации loop (2026-08-07) ===
  // Зачем: несколько жалоб держатся на гипотезе «плата не успела заметить».
  // Пример — бутылки: шаг засчитывается, только если метку УБРАЛИ дольше чем
  // на 100 мс. Если одна итерация цикла длиннее этого, быстрое «вынул-вставил»
  // целиком укладывается внутрь неё, отсутствие метки не наблюдается, и шаг не
  // переключается. До сих пор это была догадка — теперь есть цифра.
  // Раз в минуту в лог уходит: среднее, худшее и число итераций.
  // Стоимость — два вычитания на итерацию, на игру не влияет.
  {
    static unsigned long loopPrev = 0, loopSum = 0, loopWorst = 0, loopCount = 0, loopStatAt = 0;
    unsigned long nowUs = micros();
    if (loopPrev) {
      unsigned long d = nowUs - loopPrev;
      loopSum += d;
      if (d > loopWorst) loopWorst = d;
      loopCount++;
    }
    loopPrev = nowUs;
    if (millis() - loopStatAt >= 60000UL) {
      loopStatAt = millis();
      if (loopCount) {
        Serial.print(F("log:main:LOOP avg_us="));
        Serial.print(loopSum / loopCount);
        Serial.print(F(" worst_us="));
        Serial.print(loopWorst);
        Serial.print(F(" iters="));
        Serial.println(loopCount);
      }
      loopSum = 0; loopWorst = 0; loopCount = 0;
    }
  }

  // === Step 5: passive heartbeat poll + HB log ===
  // Просто отмечаем что от башни приходят данные (не читаем — байты остаются в буфере).
  if (Serial1.available()) lastSeenWorkshop = millis();
  if (Serial2.available()) lastSeenBasket   = millis();
  if (Serial3.available()) lastSeenDog      = millis();
  if (mySerial.available()) lastSeenOwls    = millis();

  // HB log раз в 60 секунд — для удалённой диагностики
  static unsigned long lastHbLog = 0;
  if (millis() - lastHbLog > 60000UL) {
    lastHbLog = millis();
    unsigned long now = millis();
    Serial.print(F("log:main:HB W="));
    Serial.print(lastSeenWorkshop ? (now - lastSeenWorkshop) : 999999UL);
    Serial.print(F(" B="));
    Serial.print(lastSeenBasket ? (now - lastSeenBasket) : 999999UL);
    Serial.print(F(" D="));
    Serial.print(lastSeenDog ? (now - lastSeenDog) : 999999UL);
    Serial.print(F(" O="));
    Serial.println(lastSeenOwls ? (now - lastSeenOwls) : 999999UL);
  }
  // === END Step 5 ===

  handleLocks();
  handleUfBlinking();
  handleLibraryFlicker();
  handleRainbow();
  handlePotionFade();
  // Таймер эффекта ПОСЛЕ ГОЛА (Зеленая волна)
  if (discoBallsActive) {
    // Страховочный таймер на 8 секунд (основное выключение теперь от сервера)
    if (millis() - discoBallsTimer >= 8000) {
      // ВРЕМЯ ВЫШЛО: Выключаем всё
      discoBallsActive = false;

      digitalWrite(Fireworks, LOW);  // ВЫКЛЮЧАЕМ РЕЛЕ ДИСКО-ШАРОВ

      snitchFlag = 0;
      enemyTimer = millis();
      additionalTimer = millis();
      enemyFlag = 0;

      // Очищаем ленту от зеленой волны
      strip1.clear();
      strip2.clear();
      strip1.show();
      strip2.show();
    } else {
      // ВРЕМЯ ИДЕТ: Держим всё включенным

      digitalWrite(Fireworks, HIGH);  // ДЕРЖИМ РЕЛЕ ВКЛЮЧЕННЫМ

      // И запускаем анимацию на ленте (она неблокирующая)
      GreenWaveEffect();
    }
  }
  if (level != previousLevel) {
    // ДОБАВЛЕНО: Логирование смены состояния
    Serial.print(F("log:main:State changed to "));
    Serial.println(level);
    delay(10);               // ДОБАВЛЕНО: Задержка между логом и командой
                             // КОНЕЦ
    Serial.print(F("level_"));  // Отправляем префикс
    Serial.println(level);   // Отправляем номер нового уровня
    previousLevel = level;   // Обновляем "предыдущий" уровень
  }
  // Если мы НЕ в режиме ожидания (уровень 25), сбрасываем флаг инициализации
  if (level != 25) {
    isRestInitialized = false;
  }
  // Логика Самопочинки Баскетбола
  if (waitingForBasketConfirm) {
    if (millis() - basketWatchdogTimer > 3000) {  // Если нет ответа 3 сек
      if (basketRetryCount < MAX_BASKET_RETRIES) {
        Serial.println(F("log:warn:Bask Retry"));
        Serial2.println(F("start_basket"));
        basketWatchdogTimer = millis();
        basketRetryCount++;
      } else {
        // ВМЕСТО ТОГО ЧТОБЫ СДАВАТЬСЯ:
        // 1. Сообщаем об ошибке
        Serial.println(F("log:err:Bask WD Rst"));

        // 2. Сбрасываем счетчик попыток
        basketRetryCount = 0;

        // 3. Обновляем таймер, чтобы следующая попытка была через 3 секунды
        basketWatchdogTimer = millis();

        // 4. НЕ выключаем waitingForBasketConfirm!
        // Плата продолжит долбить башню каждые 3 секунды до победного.
      }
    }
  }
  switch (level) {
    case 0:
      PowerOn();
      break;
    case 1:
      StartDoor();
      break;
    case 2:
      ClockGame();
      break;
    case 3:
      Clock2Game();
      break;
    case 4:
      GaletGame();
      break;
    case 5:
      ThreeGame();
      break;
    case 6:
      Flags();
      break;
    case 7:
      MapGame();
      break;
    case 8:
      OpenBank();
      break;
    case 9:
      Scrolls();
      break;
    case 10:
      Oven();
      break;
    case 11:
      Library();
      break;
    case 12:
      LibraryGame();
      break;
    case 13:
      CentralTowerGame();
      break;
    case 14:
      CentralTowerGameDown();
      break;
    case 15:
      SealSpace();
      break;
    case 16:
      MemoryRoom();
      break;
    case 17:
      CrimeHelp();
      break;
    case 18:
      BasketLesson();
      break;
    case 19:
      Basket();
      break;
    case 20:
      while (Serial.available()) {
        ClearSatelliteBuffers();
        String buff = Serial.readStringUntil('\n');
        buff.trim();

        // --- Обработка Ready в конце игры ---
        if (buff.indexOf("ready") != -1) {
          _dataQueue = 0;
          _towerTimer = 0;
          _towerCounter = 0;
          doorEvent = 0;
          mansardEvent = 0;
          libraryEvent = 0;
          galet1Event = 0;
          galet2Event = 0;
          galet3Event = 0;
          galet4Event = 0;
          galet5Event = 0;
          sealEvent = 0;
          sealSpaceEvent = 0;
          finalEvent = 0;
          crimeEvent = 0;
          safeEvent = 0;
          bugTimerScroll = 0;
          for (int i = 0; i < DOORS; i++) active[i] = false;

          Serial1.println(F("ready"));
          delay(20);
          Serial2.println(F("ready"));
          delay(20);
          Serial3.println(F("ready"));
          delay(20);
          mySerial.println(F("ready"));
          delay(50);
          mySerial.println(F("ready"));

          if (digitalRead(startDoorPin)) Serial.println(F("open_door"));
          if (!digitalRead(galetSwitchesPin)) Serial.println(F("galet_on"));
          if (digitalReadExpander(4, board4)) Serial.println(F("cristal_up"));
          if (digitalReadExpander(7, board1)) Serial.println(F("boy_out"));
          if (digitalReadExpander(5, board3)) Serial.println(F("lib_door"));
          if (digitalReadExpander(1, board2)) Serial.println(F("crime_open"));
          if (digitalReadExpander(3, board3) && digitalReadExpander(0, board3) && digitalReadExpander(1, board3) && digitalReadExpander(2, board3)) Serial.println(F("safe_open"));

          // Выключаем свет
          digitalWrite(MansardLight, LOW);
          digitalWrite(LastTowerTopLight, LOW);
          digitalWrite(Fireworks, LOW);
          digitalWrite(BankRoomLight, LOW);
          digitalWrite(TorchLight, LOW);
          digitalWrite(HallLight, LOW);
          digitalWrite(UfHallLight, LOW);
          digitalWrite(LibraryLight, LOW);
          for (int s = 0; s < STRIPS; s++) {
            strips[s]->clear();
            strips[s]->show();
          }

          boyStateInitialized = false;
          readyListenTimer = millis();
          level = 26;  // Переходим в режим прослушивания
          break;       // Выходим из цикла чтения
        }

        if (buff.indexOf("restart") != -1) {
          // Добавляем задержки при рассылке, как в RestOn
          unsigned long _ph = millis();
          unsigned long _phAll = _ph;
          SendRestartToAll();
          PHASE_REPORT("rest_towers", _ph); _ph = millis();
          OpenAll();
          PHASE_REPORT("rest_doors", _ph); _ph = millis();
          // NB: этот сброс выбрасывает всё, что Pi успел прислать за время
          // рассылки и открытия дверей. Если фазы выше окажутся долгими —
          // здесь и теряются команды.
          while (Serial.available()) Serial.read();
          isRestInitialized = false;
          RestOn();
          PHASE_REPORT("rest_reston", _ph);
          PHASE_REPORT("rest_TOTAL", _phAll);
          level = 25;
          break;
        }
      }
      // Если после обработки команд уровень изменился (на 25 или 26),
      // НЕ ЗАПУСКАЕМ FinalPresentation!
      if (level == 20) {
        FinalPresentation();
      }
      break;
    case 21:
      while (Serial.available()) {
        String buff = Serial.readStringUntil('\n');
        buff.trim();
        if (buff == "restart") {
          OpenAll();
          RestOn();
        }
      }
      break;
    case 22:
      break;
    case 23:
      break;
    case 25:
      RestOn();
      break;
    // --- ДОБАВЛЕНО: Новое состояние для прослушивания башен после команды ready ---
    case 26:
      ListenForReady();
      break;
    // ---
    case 30:
      Restart();
      break;
  }
  //DoorDefender();
  if (fireFlag) {
    FireCup();
  }

  if (level > 0 && level < 20) {
    HelpHandler("");
  }

  //VoltageDisplay();
}

// Функция призрачного мерцания ---
void handleLibraryFlicker() {
  // Если мерцание не активно, выходим
  if (!isLibraryFlickering) {
    return;
  }

  unsigned long currentMillis = millis();

  // 1. Проверяем, не прошло ли 5 секунд
  if (currentMillis - libraryFlickerTimer >= 5000) {
    isLibraryFlickering = false;
    // После мерцания оставляем свет включенным
    digitalWrite(LibraryLight, HIGH);
    return;
  }

  // 2. Логика "Свеча на ветру"
  if (currentMillis - libraryFlickerIntervalTimer >= (150 + random(0, 200))) {
    libraryFlickerIntervalTimer = currentMillis;

    // С шансом 60% (6 из 10) "задуваем" свечу
    if (random(10) < 6) {
      digitalWrite(LibraryLight, LOW);
      // Сразу же устанавливаем таймер, чтобы включить ее обратно
      // через время (1000-2000 мс)
      libraryFlickerIntervalTimer = currentMillis + random(1000, 2000);
    } else {
      // В остальных 40% случаев свеча горит ровно
      digitalWrite(LibraryLight, HIGH);
    }
  }
}
// метод открывания тайников и дверей каждая после своего уровня и до конца игры

// ---------------------------------------------------------------------------------
// ПРИЧИНА: Ранее эта функция постоянно опрашивала все датчики и башни,
// отправляя множество сообщений на сервер и вызывая "флатер" состояний.
// Теперь она только ожидает и обрабатывает входящие команды, не занимаясь
// активным поллингом, что делает систему более стабильной в режиме ожидания.
// ---------------------------------------------------------------------------------
void PowerOn() {
  waitingForBasketConfirm = false;  // Глушим таймер
  basketRetryCount = 0;
  monPoll();                        // монитор датчиков для /tech (в покое)
  brTestTick();                     // диагностика Комнаты Мозга (в покое)
  // Строки от башен разбирает только HelpTowersHandler(), а он вызывается
  // из smartDelay() — то есть работает лишь пока плата чего-то ждёт внутри
  // игровых сцен. В покое башни не слушает никто, и их датчики до пульта не
  // доходили. Читаем их здесь, но ТОЛЬКО при включённом мониторе: при
  // выключенном поведение платы не меняется ни на такт.
  if (monActive || wbTestOn) {
    // Живость башен определяется ПАССИВНО: loop() смотрит, есть ли байты в
    // буфере, и намеренно их не читает. HelpTowersHandler() буферы вычерпывает,
    // поэтому отметку живости ставим ДО него — иначе башни, которые говорят
    // редко (Workshop, Dog), выглядят отвалившимися, хотя исправны.
    if (Serial1.available())  lastSeenWorkshop = millis();
    if (Serial2.available())  lastSeenBasket   = millis();
    if (Serial3.available())  lastSeenDog      = millis();
    if (mySerial.available()) lastSeenOwls     = millis();
    HelpTowersHandler();
  }
  handleIdleBoySensor();
  while (Serial.available()) {
    String buff = Serial.readStringUntil('\n');
    buff.trim();

    // Калибровка серво с тех-пульта. Принимаем в состоянии ожидания: здесь
    // замок стоит и после загрузки, и когда монтажник подбирает углы.
    if (handleBoyCal(buff)) continue;
    if (handleBoyTest(buff)) continue;
    if (handleMonCmd(buff)) continue;
    if (handleBrTestCmd(buff)) continue;
    if (handleRoomLightCmd(buff)) continue;

    // Сначала проверяем приоритетные команды через indexOf для надежности
    if (buff.indexOf("restart") != -1) {
      SendRestartToAll();
      OpenAll();
      while(Serial.available()) Serial.read();
      isRestInitialized = false;
      level = 25;
      previousLevel = 0;
      return;
    }

    if (buff.indexOf("jump18") != -1) {
      level = 18;
      boyStateInitialized = false;
      isRestInitialized = false;
      snitchFlag = 1;
      lessonSaluteActive = false;
      discoBallsActive = false;
      isGameBasketStarted = false;
      strip1.clear(); strip2.clear(); strip1.show(); strip2.show();

      ClearSatelliteBuffers();
      Serial1.println(F("ready")); delay(10);
      Serial2.println(F("ready")); delay(10);
      Serial3.println(F("ready")); delay(10);
      mySerial.println(F("ready")); delay(10);

      unsigned long startWait = millis();
      while (millis() - startWait < 1500) {
        ClearSatelliteBuffers();
        delay(10);
      }

      Serial1.println(F("start")); delay(10);
      Serial2.println(F("start")); delay(10);
      Serial3.println(F("start")); delay(10);
      mySerial.println(F("start")); delay(10);

      // === 3. ИМИТАЦИЯ РЕАЛЬНОГО ПРОХОЖДЕНИЯ ===
      // ВАЖНО: Используем обычный delay, чтобы плата не слушала 
      // чужие логи (например, от Мастерской) во время прыжка!
      Serial2.println(F("start_troll"));
      delay(50);
      Serial2.println(F("troll"));
      delay(50);
      Serial2.println(F("opent_basket"));
      delay(350);
      Serial2.println(F("item_end"));
      delay(200);
      
      // Очищаем буферы от мусора загрузки башен
      ClearSatelliteBuffers(); 
      
      Serial.println(F("log:main:Jumped to Basket (Level 18)"));
      while(Serial.available()) Serial.read();
      return;
    }

    if (buff.indexOf("ready") != -1) {
      _dataQueue = 0;
      _towerTimer = 0;
      _towerCounter = 0;
      doorEvent = 0;
      mansardEvent = 0;
      libraryEvent = 0;
      galet1Event = 0;
      galet2Event = 0;
      galet3Event = 0;
      galet4Event = 0;
      galet5Event = 0;
      sealEvent = 0;
      sealSpaceEvent = 0;
      finalEvent = 0;
      bugTimerScroll = 0;

      // 1. Сначала шлем всем RESET/READY
      Serial1.println(F("ready"));
      Serial2.println(F("ready"));
      Serial3.println(F("ready"));
      mySerial.println(F("ready"));

      // 2. Ждем, пока они проплюются логами о загрузке
      delay(1500);

      // 3. Очищаем входящие буферы от мусора (логов загрузки)
      ClearSatelliteBuffers();

      // 4. Теперь просим прислать ЧИСТЫЙ статус
      Serial1.println(F("check_state"));
      delay(50);  // Workshop
      Serial2.println(F("check_state"));
      delay(50);  // Basket
      Serial3.println(F("check_state"));
      delay(50);  // Dog
      mySerial.println(F("check_state"));
      delay(50);  // Owls

      if (digitalRead(startDoorPin)) Serial.println(F("open_door"));
      if (!digitalRead(galetSwitchesPin)) Serial.println(F("galet_on"));
      if (digitalReadExpander(4, board4)) Serial.println(F("cristal_up"));
      if (digitalReadExpander(7, board1)) Serial.println(F("boy_out"));
      if (digitalReadExpander(5, board3)) Serial.println(F("lib_door"));
      if (digitalReadExpander(1, board2)) Serial.println(F("crime_open"));  // Концевик в замке (локере)
      if (digitalReadExpander(3, board3) && digitalReadExpander(0, board3) && digitalReadExpander(1, board3) && digitalReadExpander(2, board3)) Serial.println(F("safe_open"));

      digitalWrite(MansardLight, LOW);
      digitalWrite(LastTowerTopLight, LOW);
      digitalWrite(Fireworks, LOW);
      digitalWrite(BankRoomLight, LOW);
      digitalWrite(TorchLight, LOW);
      digitalWrite(HallLight, LOW);
      digitalWrite(UfHallLight, LOW);
      digitalWrite(LibraryLight, LOW);
      for (int s = 0; s < STRIPS; s++) {
        strips[s]->clear();
        strips[s]->show();
      }

      boyStateInitialized = false;
      waitingForBasketConfirm = false;
      basketRetryCount = 0;
      readyListenTimer = millis();
      level = 26;
      while(Serial.available()) Serial.read();
      return;
    }

    if (buff == "start") {
      boyServo.attach(49, boyPulseMin, boyPulseMax);
      boyServo.write(boyAngleHide);
      delay(boyMoveMs);
      boyServo.detach();
      Serial.println(F("modalend"));
      delay(100);
      mySerial.println(F("start"));
      Serial1.println(F("start"));
      Serial2.println(F("start"));
      Serial3.println(F("start"));
      delay(1000);
      Serial.println(F("startgo"));
      isStartDoorOpenedGlobal = false;
      // ... (сброс переменных) ...
      _dataQueue = 0;
      crimeEvent = 0;
      safeEvent = 0;
      _towerTimer = 0;
      _towerCounter = 0;
      doorEvent = 0;
      mansardEvent = 0;
      libraryEvent = 0;
      galet1Event = 0;
      galet2Event = 0;
      galet3Event = 0;
      galet4Event = 0;
      galet5Event = 0;
      sealEvent = 0;
      sealSpaceEvent = 0;
      finalEvent = 0;
      bugTimerScroll = 0;
      dragonCounter = 0;
      studentCounter = 0;
      professorCounter = 0;
      dwarfCounter = 0;
      knightCounter = 0;
      trollCounter = 0;
      workshopCounter = 0;
      directorCounter = 0;
      goblinCounter = 0;
      witchCounter = 0;
      firstRun = true;
      isPotionDoorOpened = false;
      isDogDoorOpened = false;
      isOwlDoorOpened = false;
      isTrainStarted = false;
      isBankerFirstHint = true;
      // dragonTimer здесь больше НЕ заводим: повтор дракона начинает
      // отсчёт от конца story_2_b, а не от старта квеста.
      dragonRepeatArmed = false;
      prevFlagSound = true;
      dragonFlag = 0;
      boyStateInitialized = false;
      waitingForBasketConfirm = false;
      basketRetryCount = 0;
      level++;
      while(Serial.available()) Serial.read(); // Чистим дубликаты
      return;
    } else if (buff == "open_mansard_door") OpenDoor(MansardDoor);
    else if (buff == "open_crime_door") OpenDoor(CrimeDoor);
    else if (buff == "open_bank_door") OpenDoor(BankDoor);
    else if (buff == "open_potion_door") OpenDoor(PotionsRoomDoor);
    else if (buff == "open_owl_door") mySerial.println(F("open_door"));
    else if (buff == "open_dog_door") Serial3.println(F("open_door"));
    // Клетка Цербера — отдельный локер: у двери своя команда open_door.
    else if (buff == "open_dog_cage") Serial3.println(F("open_cage"));
    else if (buff == "open_low_tower_door") OpenDoor(HightTowerDoor);
    else if (buff == "open_high_tower_door") OpenDoor(HightTowerDoor2);
    else if (buff == "open_library_door") OpenDoor(LibraryDoor);
    else if (buff == "open_workshop_door") Serial1.println(F("open_door"));
    // Тест верстака с тех-пульта (wbtest_reeds / wbtest_broom / wbtest_helmet /
    // wbtest_off) — главная плата только передаёт строку Мастерской. Разбор
    // команд с USB живёт в двух местах (покой и игра), поэтому и здесь, и там.
    // Флаг нужен, чтобы в покое читать UART Мастерской: без него ответы
    // wbtest:reed: доходили до пульта только при включённом мониторе.
    else if (buff.startsWith("wbtest_")) {
      bool wbOn = (buff != "wbtest_off");
      // Пока в покое UART башен никто не читал, в буферах накопился мусор. Если
      // начать читать его «как есть», в игровой разбор посыплются старые флаги
      // (galet_on, flag4_on) да ещё склеенные переполнением (flag2flag2_off), а
      // ответ на нашу команду утонет в этой пачке. Поэтому на включении чистим
      // буферы ВСЕХ башен до отправки: читать мы начинаем сразу все четыре.
      if (wbOn && !wbTestOn) {
        while (Serial1.available())  Serial1.read();
        while (Serial2.available())  Serial2.read();
        while (Serial3.available())  Serial3.read();
        while (mySerial.available()) mySerial.read();
      }
      wbTestOn = wbOn;
      Serial1.println(buff);
    }
    else if (buff == "open_safe_door") OpenDoor(BankStashDoor);
    else if (buff == "open_memory_door") OpenDoor(MemoryRoomDoor);
    else if (buff == "open_basket_door") Serial2.println(F("open_door"));
    // 2026-07-29: открытие двери на балкон (этап Баскетбола). Раньше слалось
    // сразу по геркону кубка; теперь сервер присылает эту команду после того
    // как доиграла story_56 (after_serial в очереди историй).
    else if (buff == "basket_stage_open") Serial2.println(F("opent_basket"));
    else if (buff == "open_mine_door") Serial2.println(F("open_mine_door"));
    // 2026-05-28: dg_on handler УДАЛЁН (DIAG mode убран).
    // === check_towers handler ===
    else if (buff == "check_towers") {
      const unsigned long w = 30000UL;
      unsigned long now = millis();
      Serial.print(F("tower_status:workshop="));
      Serial.print((lastSeenWorkshop && (now - lastSeenWorkshop) < w) ? 1 : 0);
      Serial.print(F(",basket="));
      Serial.print((lastSeenBasket && (now - lastSeenBasket) < w) ? 1 : 0);
      Serial.print(F(",dog="));
      Serial.print((lastSeenDog && (now - lastSeenDog) < w) ? 1 : 0);
      Serial.print(F(",owls="));
      Serial.println((lastSeenOwls && (now - lastSeenOwls) < w) ? 1 : 0);
    }
    else if (handleStripTest(buff)) { /* тест ленты (PowerOn) */ }
    else Unlocks(buff);
  }
}

int levenshteinDistance(String s1, String s2) {
  int len1 = s1.length();
  int len2 = s2.length();
  int matrix[len1 + 1][len2 + 1];

  for (int i = 0; i <= len1; i++) matrix[i][0] = i;
  for (int j = 0; j <= len2; j++) matrix[0][j] = j;

  for (int i = 1; i <= len1; i++) {
    for (int j = 1; j <= len2; j++) {
      int cost = (s1[i - 1] == s2[j - 1]) ? 0 : 1;
      matrix[i][j] = min(
        matrix[i - 1][j] + 1,  // удаление
        min(
          matrix[i][j - 1] + 1,        // вставка
          matrix[i - 1][j - 1] + cost  // замена
          ));
    }
  }
  return matrix[len1][len2];
}

int calculateSimilarity(String s1, String s2) {
  int distance = levenshteinDistance(s1, s2);
  int maxLen = max(s1.length(), s2.length());
  //if (maxLen == 0) return 100;
  //Serial.println(100 - (distance * 100 / maxLen));
  return 100 - (distance * 100 / maxLen);
}

void HelpTowersHandler() {

  // --- Process Serial1 (workshop) ---
  while (Serial1.available()) {
    char c = Serial1.read();
    if (c == '\n') {  // Конец строки
      serial1Buffer.trim();
      if (serial1Buffer.length() > 0) {
        lastSeenWorkshop = millis();  // Step 3: heartbeat tracking
        if (serial1Buffer == "pong" || serial1Buffer.indexOf("ping_main") != -1) {
          serial1Buffer = "";
          continue;
        }

        // Монитор датчиков башни: отдаём строку пульту и НЕ пускаем её дальше в
        // игровой разбор. Пересылка тут уже есть ниже, но выходим сразу, чтобы
        // строка гарантированно не совпала ни с одной игровой командой.
        if (serial1Buffer.startsWith("sens:")) {
          Serial.println(serial1Buffer);
          serial1Buffer = "";
          continue;
        }

        Serial.println(serial1Buffer);  // Пересылаем ВСЕ сообщения на сервер

        noteWorkshopState(serial1Buffer);

        // Обрабатываем специфичные команды, СТРОГОЕ РАВЕНСТВО (Защита от эха логов)
        if (serial1Buffer == "fire1") {
          Serial.println(F("fire1"));
        } else if (serial1Buffer == "fire2") {
          Serial.println(F("fire2"));
        } else if (serial1Buffer == "fire3") {
          Serial.println(F("fire3"));
        } else if (serial1Buffer == "fire0") {
          Serial.println(F("fire0"));
        } else if (serial1Buffer == "item_add") {
          Serial.println(F("item_add"));
        } else if (serial1Buffer == "broom") {
          Serial.println(F("broom"));
        } else if (serial1Buffer == "helmet") {
          Serial.println(F("helmet"));
        } else if (serial1Buffer == "story_35") {
          Serial.println(F("story_35"));
          unsigned long _phItem = millis();
          Serial1.println(F("item_end"));
          Serial2.println(F("item_end"));
          Serial3.println(F("item_end"));
          mySerial.println(F("item_end"));
          delay(1000);
          Serial1.println(F("day_off"));
          Serial2.println(F("day_off"));
          Serial3.println(F("day_off"));
          mySerial.println(F("day_off"));
          GoldStrip.clear();
          CandleStrip.clear();
          CauldronStrip.clear();
          CauldronRoomStrip.clear();
          memory_Led.clear();
          strip1.clear();
          strip2.clear();
          GoldStrip.show();
          CandleStrip.show();
          CauldronStrip.show();
          CauldronRoomStrip.show();
          memory_Led.show();
          strip1.show();
          strip2.show();
          PHASE_REPORT("story35_broadcast", _phItem);
          digitalWrite(MansardLight, LOW);
          digitalWrite(LastTowerTopLight, LOW);
          digitalWrite(Fireworks, LOW);
          digitalWrite(LibraryLight, LOW);
          digitalWrite(BankRoomLight, LOW);
          digitalWrite(HallLight, LOW);
          digitalWrite(UfHallLight, LOW);
          digitalWrite(HightTowerDoor2, LOW);
          digitalWrite(TorchLight, LOW);
          digitalWrite(HallLight, HIGH);
          level++;
        }
        if (serial1Buffer == "help") {
          HelpHandler("workshop");
        }
      }
      serial1Buffer = "";  // Очищаем буфер
    } else if (c >= 32 && serial1Buffer.length() < 256) {
      serial1Buffer += c;
    }
  }

  // --- Process Serial2 (basket3) ---
  while (Serial2.available()) {
    char c = Serial2.read();
    if (c == '\n') {
      serial2Buffer.trim();
      if (serial2Buffer.length() > 0) {
        lastSeenBasket = millis();  // Step 3: heartbeat tracking
        if (serial2Buffer == "pong" || serial2Buffer.indexOf("ping_main") != -1) {
          serial2Buffer = "";
          continue;
        }

        // Монитор датчиков башни: отдаём строку пульту и НЕ пускаем её дальше в
        // игровой разбор. Пересылка тут уже есть ниже, но выходим сразу, чтобы
        // строка гарантированно не совпала ни с одной игровой командой.
        if (serial2Buffer.startsWith("sens:")) {
          Serial.println(serial2Buffer);
          serial2Buffer = "";
          continue;
        }

        // 1. ПЕРЕСЫЛАЕМ ВСЕ ЛОГИ И КОМАНДЫ НА СЕРВЕР
        Serial.println(serial2Buffer);

        // 2. БАЗОВАЯ СТРАХОВКА (Мальчик и Баскетбол)
        if (serial2Buffer == "confirm_start") {
          waitingForBasketConfirm = false;
          Serial.println(F("log:main:Bask WD OK"));
        } else if (serial2Buffer.startsWith("log:") && serial2Buffer.indexOf("Boy removed") != -1) {
          Serial.println(F("log:main:Ins:boy_out"));
          delay(10);
          if (level == 18) Serial.println(F("boy_out_lesson"));
          else if (level == 19) Serial.println(F("boy_out_game"));
          else if (level == 17) Serial.println(F("crime_end"));
          else Serial.println(F("boy_out"));
        } else if (serial2Buffer.startsWith("log:") && serial2Buffer.indexOf("Sent boy_in_lesson") != -1) {
          Serial.println(F("log:main:Ins:boy_in_L"));
          delay(10);
          Serial.println(F("boy_in_lesson"));
        } else if (serial2Buffer.startsWith("log:") && serial2Buffer.indexOf("Boy returned") != -1) {
          Serial.println(F("log:main:Ins:boy_in_G"));
          delay(10);
          Serial.println(F("boy_in_game"));
        } else if (serial2Buffer == "boy_in_lesson") {
          Serial.println(F("boy_in_lesson"));
        } else if (serial2Buffer == "boy_out_lesson") {
          Serial.println(F("boy_out_lesson"));
        } else if (serial2Buffer == "help") {
          HelpHandler("troll");
        }

        // 3. ИГРОВАЯ ЛОГИКА ТРОЛЛЯ И ПЕЩЕРЫ (Работает только на 7 уровне)
        // Используем строгое равенство (==), чтобы обрывки строк не ломали игру
        if (level == 7) {
          if (serial2Buffer == "aluminium") {
            Serial.println(F("cave_search1"));
            // 2026-07-10: НЕ открываем следующий этап сразу. Сервер пришлёт
            // команду cave_search1 ПОСЛЕ окончания story_27_a — тогда buff-
            // handler ниже сделает Serial2.println и этап откроется.
            // Так LED/активация следующего металла ждут конца рассказа.
          } else if (serial2Buffer == "bronze") {
            Serial.println(F("cave_search2"));
          } else if (serial2Buffer == "copper") {
            Serial.println(F("cave_search3"));
          } else if (serial2Buffer == "cave_end") {
            Serial.println(F("cave_end"));
            isTrollEnd = 1;
          } else if (serial2Buffer == "cave_click") {
            Serial.println(F("cave_click"));
          } else if (serial2Buffer == "cave_reset") {
            Serial.println(F("cave_reset"));
          } else if (serial2Buffer == "cave_repeat") {
            Serial.println(F("cave_repeat"));
          } else if (serial2Buffer == "door_cave") {
            Serial.println(F("door_cave"));
          } else if (serial2Buffer == "metal") {
            GoldStrip.setPixelColor(0, GoldStrip.Color(255, 255, 0));
            GoldStrip.show();
            CauldronStrip.setPixelColor(0, CauldronStrip.Color(128, 0, 128));
            CauldronStrip.show();
            potionPulsation = 0;

            Serial1.println(F("metal"));
            Serial.println(F("item_find:metal"));
            Serial3.println(F("item_find"));
            mySerial.println(F("item_find"));
            Serial2.println(F("item_find"));  // Обязательно отвечаем башне
          }
        }
      }
      serial2Buffer = "";  // Очищаем буфер после обработки строки
    } else if (c >= 32 && serial2Buffer.length() < 256) {
      serial2Buffer += c;  // Копим строку по одному символу
    }
  }

  // --- Process Serial3 (dog) ---
  while (Serial3.available()) {
    char c = Serial3.read();
    if (c == '\n') {
      serial3Buffer.trim();
      if (serial3Buffer.length() > 0) {
        lastSeenDog = millis();  // Step 3: heartbeat tracking
        if (serial3Buffer == "pong" || serial3Buffer.indexOf("ping_main") != -1) {
          serial3Buffer = "";
          continue;
        }

        // Монитор датчиков башни: отдаём строку пульту и НЕ пускаем её дальше в
        // игровой разбор. Пересылка тут уже есть ниже, но выходим сразу, чтобы
        // строка гарантированно не совпала ни с одной игровой командой.
        if (serial3Buffer.startsWith("sens:")) {
          Serial.println(serial3Buffer);
          serial3Buffer = "";
          continue;
        }
        Serial.println(serial3Buffer);  // Пересылаем ВСЕ
        if (serial3Buffer == "help") {
          HelpHandler("knight");
        }
      }
      serial3Buffer = "";
    } else if (c >= 32 && serial3Buffer.length() < 256) {
      serial3Buffer += c;
    }
  }

  // --- Process mySerial (owls) ---
  while (mySerial.available()) {
    char c = mySerial.read();
    if (c == '\n') {
      mySerialBuffer.trim();
      if (mySerialBuffer.length() > 0) {
        lastSeenOwls = millis();  // Step 3: heartbeat tracking
        if (mySerialBuffer == "pong") { mySerialBuffer = ""; continue; }  // asymmetric filter (как в новой Mega)

        // Монитор датчиков башни — отдаём пульту и не пускаем в игровой разбор.
        if (mySerialBuffer.startsWith("sens:")) {
          Serial.println(mySerialBuffer);
          mySerialBuffer = "";
          continue;
        }

        Serial.println(mySerialBuffer);  // Пересылаем ВСЕ сообщения на сервер

        // ДОБАВЛЕНО: Страховка на случай потери команды owl_end
        if (mySerialBuffer.startsWith("log:") && mySerialBuffer.indexOf("owls_complete") != -1) {
          Serial.println(F("log:main:Ins:owl_end"));
          delay(10);
          Serial.println(F("owl_end"));
        }
        // КОНЕЦ

        // Дублируем логику пересылки из MapGame(),
        // чтобы 'light' и 'dark' всегда доставлялись башням,
        // независимо от того, какая функция "выиграла гонку".

        // Свет вкл
        if (mySerialBuffer.indexOf("light") != -1 && mySerialBuffer.indexOf("light_off") == -1) {
          Serial1.println(F("light_on"));
          Serial2.println(F("light_on"));
          Serial3.println(F("light_on"));
        }
        // Свет выкл
        else if (mySerialBuffer.indexOf("dark") != -1) {
          Serial1.println(F("light_off"));
          Serial2.println(F("light_off"));
          Serial3.println(F("light_off"));
        }

        // Если чистая команда "help" потерялась, сработаем по логу
        if (mySerialBuffer.indexOf("help") != -1 || mySerialBuffer.indexOf("Help button pressed") != -1) {
          HelpHandler("dwaf");
        }
      }
      mySerialBuffer = "";
    } else if (c >= 32 && mySerialBuffer.length() < 256) {
      mySerialBuffer += c;
    }
  }
}

void HelpHandler(String from) {
  if (flagSound) {
    directorButton.tick();
    goblinButton.tick();
    dragonButton.tick();
    studentButton.tick();
    professorButton.tick();
    witchButton.tick();

    // Дракон
    if (dragonButton.isPress()) {
      if ((level < 4 && level > 1) || (level == 1 && isStartDoorOpenedGlobal)) {
        Serial.println(dragonHints[3]);
        flagSound = 0;
      } else if (level == 1 && !dragonFlag) {
        Serial.println(dragonHints[0]);
        dragonFlag = 1;
        flagSound = 0;
      } else if (level == 1 && dragonFlag) {
        Serial.println(dragonHints[getSmartHint(0, 1, 2)]);
        flagSound = 0;
      } else if (level == 4) {
        Serial.println(dragonHints[getSmartHint(1, 4, 5)]);
        flagSound = 0;
      } else if (level > 4) {
        Serial.println(dragonHints[3]);
        flagSound = 0;
      }
    }

    // Студент
    if (studentButton.isPress()) {
      bool sent = false;
      // На этой же фигуре сидит сова студента, и игроки путают её с совой на
      // башне Сов. Пока этап сов идёт — касание засчитываем как касание совы:
      // башня сама проверит, что этап активирован картой, и откроет свой локер.
      // Подсказку в этот момент не играем, иначе поверх открытия двери звучал
      // бы совет искать сову.
      if (mapGame_g == "owl" && !isOwlEnd) {
        mySerial.println(F("owl_touch"));
        Serial.println(F("log:main:owl_touch from student owl"));
        // sent НЕ ставим: он гасит flagSound, то есть глушит ВСЕ подсказки до
        // ответа сервера о конце звука. Звука тут нет — глушить нечего.
      } else if (level > 1 && level < 4) {
        Serial.println(studentHints[getSmartHint(2, 0, 1)]);
        sent = true;
      } else if (level > 3 && level < 11) {
        Serial.println(studentHints[2]);
        sent = true;
      } else if (level == 11) {
        if (ghostState >= 2) {
          Serial.println(studentHints[5]);
          sent = true;
        } else {
          Serial.println(studentHints[getSmartHint(3, 3, 4)]);
          sent = true;
        }
      } else if (level == 12) {
        Serial.println(studentHints[getSmartHint(4, 6, 7)]);
        sent = true;
      } else if (level > 12 && level < 17) {
        Serial.println(studentHints[2]);
        sent = true;
      }
      if (sent) flagSound = 0;
    }

    // Профессор
    if (professorButton.isPress()) {
      bool sent = false;
      if (level > 4 && level < 6) {
        Serial.println(professorHints[getSmartHint(5, 0, 1)]);
        sent = true;
      } else if (level == 6) {
        Serial.println(professorHints[getSmartHint(6, 2, 3)]);
        sent = true;
      } else if (level == 7) {
        if (!isPotionDoorOpened || !isDogDoorOpened || !isOwlDoorOpened || !isTrainStarted) {
          Serial.println(professorHints[getSmartHint(7, 4, 5)]);
        } else {
          Serial.println(professorHints[6]);
        }
        sent = true;
      } else if (level > 7) {
        Serial.println(professorHints[6]);
        sent = true;
      }
      if (sent) flagSound = 0;
    }

    // Гоблин
    if (goblinButton.isPress()) {
      bool sent = false;
      if (level == 9) {
        Serial.println(goblinHints[getSmartHint(11, 0, 1)]);
        sent = true;
      } else if (level > 9 && level < 18) {
        Serial.println(goblinHints[2]);
        sent = true;
      }
      if (sent) flagSound = 0;
    }

    // Директор
    if (directorButton.isPress()) {
      bool sent = false;
      if (level == 13) {
        Serial.println(directorHints[getSmartHint(14, 0, 1)]);
        sent = true;
      } else if (level == 14) {
        Serial.println(directorHints[getSmartHint(15, 2, 3)]);
        sent = true;
      } else if (level > 14 && level < 17) {
        Serial.println(directorHints[getSmartHint(16, 4, 5)]);
        sent = true;
      } else if (level == 17 || level == 18) {
        Serial.println(directorHints[6]);
        sent = true;
      }
      if (sent) flagSound = 0;
    }

    // Ведьма
    if (witchButton.isPress()) {
      bool sent = false;
      if (level == 7 && !isPotionEnd) {
        Serial.println(witchHints[getSmartHint(9, 0, 1)]);
        sent = true;
      } else if (isPotionEnd || level > 7) {
        Serial.println(witchHints[2]);
        sent = true;
      }
      if (sent) flagSound = 0;
    }

    // Гном (dwaf)
    if (from == "dwaf") {
      bool sent = false;
      if (level == 7 && !isOwlEnd) {
        Serial.println(dwarfHints[getSmartHint(8, 0, 1)]);
        sent = true;
      } else if (isOwlEnd || level > 7) {
        Serial.println(dwarfHints[2]);
        sent = true;
      }
      if (sent) flagSound = 0;
    }

    // Рыцарь
    if (from == "knight") {
      bool sent = false;
      if (level == 7 && !isDogEnd) {
        Serial.println(knightHints[getSmartHint(10, 0, 1)]);
        sent = true;
      } else if (isDogEnd || level > 7) {
        Serial.println(knightHints[2]);
        sent = true;
      }
      if (sent) flagSound = 0;
    }

    // Тролль
    if (from == "troll") {
      bool sent = false;
      if (level == 7 && !isTrollEnd) {
        Serial.println(trollHints[getSmartHint(12, 0, 1)]);
        sent = true;
      } else if (isTrollEnd || level > 7) {
        Serial.println(trollHints[2]);
        sent = true;
      }
      if (sent) flagSound = 0;
    }

    // Мастерская
    if (from == "workshop") {
      bool sent = false;
      if (level == 10) {
        if (workshopFireStage >= 2) {
          // Печка уже разгорелась — про розжиг (hint_32_b) говорить нечего.
          // Цепочка всегда начинается с hint_32_c, а дальше идёт по кругу
          // только то, что ещё не собрано: hint_32_d — про метлу, hint_32_e —
          // про шлем. Собранное выпадает из цепочки сразу, на следующем же
          // запросе: список собирается заново в момент нажатия.
          byte chain[3];
          byte n = 0;
          chain[n++] = 1;                           // hint_32_c
          if (!workshopBroomDone) chain[n++] = 2;   // hint_32_d
          if (!workshopHelmetDone) chain[n++] = 3;  // hint_32_e
          Serial.println(workshopHints[chain[workshopHotHintStep % n]]);
          workshopHotHintStep++;
        } else {
          Serial.println(workshopHints[getSmartHint(13, 0, 3)]);
        }
        sent = true;
      } else if (level > 10 && level < 18) {
        Serial.println(workshopHints[4]);
        sent = true;
      }
      if (sent) flagSound = 0;
    }
  }
}

// стартовая дверь на замке с ключом
// стартовая дверь на замке с ключом
void StartDoor() {
  startDoor.tick();

  // ИСПРАВЛЕНИЕ: Используем isStartDoorOpenedGlobal вместо doorOpened
  if (startDoor.isRelease() && !isStartDoorOpenedGlobal) {
    Serial.println(F("open_door"));
    digitalWrite(HallLight, HIGH);

    // ВАЖНО: Ставим глобальный флаг в true, чтобы не срабатывало повторно
    isStartDoorOpenedGlobal = true;

    // --- ЛОГИКА СЕРВОПРИВОДА ---
    if (!boyServo.attached()) {
      boyServo.attach(49, boyPulseMin, boyPulseMax);
    }
    delay(50);
    boyServo.write(boyAngleOpen);  // Поворот

    // Цикл ожидания 3 секунды
    unsigned long startWait = millis();
    while (millis() - startWait < 3000) {
      // Если пришел рестарт во время движения сервы
      if (Serial.available()) {
        String b = Serial.readStringUntil('\n');
        if (b.indexOf("restart") != -1) {
          boyServo.detach();
          OpenAll();
          RestOn();
          level = 25;
          return;
        }
      }
    }
    // Отключаем сервопривод после движения
    if (boyServo.attached()) {
      boyServo.detach();
    }
    // ---------------------------

    dragonFlag = 0;
    dragonRepeatArmed = false;
    prevFlagSound = true;
    KayTimer = millis();
    level++;
  }

  // story_2_b доиграла — сервер снимает заглушку звука (soundoff → flagSound 1).
  // Именно этот фронт, при уже выставленном dragonFlag, и есть момент, с
  // которого имеет смысл напоминать сказанное драконом.
  if (flagSound && !prevFlagSound && dragonFlag && !dragonRepeatArmed) {
    dragonRepeatArmed = true;
    dragonTimer = millis();
  }
  prevFlagSound = flagSound;

  // Повтор подсказки дракона — раз в 2 минуты, пока не открыта стартовая дверь
  // (дверь открылась → level++ → StartDoor() больше не вызывается).
  if (dragonRepeatArmed && millis() - dragonTimer >= 120000) {
    Serial.println(F("dragon_crystal_repeat"));
    dragonTimer = millis();
  }

  // Чтение команд
  while (Serial.available()) {
    String buff = Serial.readStringUntil('\n');
    buff.trim();

    if (buff == "skip_start_door") {
      Serial.println(F("open_door"));  // Отправляем сигнал на сервер, будто дверь открыли руками
      digitalWrite(HallLight, HIGH);
      isStartDoorOpenedGlobal = true;

      // Имитация работы сервопривода, как при физическом открытии
      if (!boyServo.attached()) { boyServo.attach(49, boyPulseMin, boyPulseMax); }
      delay(50);
      boyServo.write(boyAngleOpen);
      unsigned long startWait = millis();
      while (millis() - startWait < 3000) {
        if (Serial.available()) {
          String b = Serial.readStringUntil('\n');
          if (b.indexOf("restart") != -1) {
            boyServo.detach();
            OpenAll();
            RestOn();
            level = 25;
            return;
          }
        }
      }
      if (boyServo.attached()) { boyServo.detach(); }

      dragonFlag = 0;
      dragonRepeatArmed = false;
      prevFlagSound = true;
      KayTimer = millis();
      level++;
    }
    if (buff == "soundon") {
      flagSound = 0;
    }
    if (buff == "soundoff") {
      flagSound = 1;
    }
    if (buff == "restart") {
      OpenAll();
      RestOn();
      level = 25;
      return;
    }
  }
}
// тумблер в первой комнате реагирует на изменение состояния
void ClockGame() {
  // ФИКС багА: были static — не сбрасывались при restart
  // Теперь используем глобальные clockRepeat, clockSwitchMustBeOffFirst

  if (millis() - KayTimer >= 30000) {
    if (clockRepeat) {
      Serial.println(F("kay_clockRepeat"));
      clockRepeat = 0;
    }
  }

  // Считываем датчик
  bool reading = !digitalReadExpander(0, board2);

  // --- ЛОГИКА ЗАЩИТЫ ---

  // 1. Если датчик НЕ АКТИВЕН (магнита нет), мы "взводим" курок.
  // Теперь система готова принять сигнал победы.
  if (!reading) {
    clockSwitchMustBeOffFirst = false;
  }

  // 2. Если датчик АКТИВЕН (магнит есть) И (&&) курок взведен (!clockSwitchMustBeOffFirst)
  if (reading && !clockSwitchMustBeOffFirst) {
    Serial.println(F("clock1"));
    digitalWrite(UfHallLight, HIGH);
    digitalWrite(HallLight, LOW);
    clockRepeat = 0;
    level++;

    // Сразу же снова включаем защиту для следующего раза (рестарта)
    clockSwitchMustBeOffFirst = true;
  }
  // ---------------------

  while (Serial.available()) {
    String buff = Serial.readStringUntil('\n');
    buff.trim();
    if (buff == "first_clock") {
      Serial.println(F("clock1"));
      digitalWrite(UfHallLight, HIGH);
      digitalWrite(HallLight, LOW);
      level++;
      clockSwitchMustBeOffFirst = true;
    }
    if (buff == "soundon") {
      flagSound = 0;
    }
    if (buff == "soundoff") {
      flagSound = 1;
    }
    if (buff == "kay_clockRepeat") {
      clockRepeat = 1;
      Serial.println(F("kay"));
      KayTimer = millis();
    }
    if (buff.indexOf("restart") != -1) {
      clockRepeat = 0;
      clockSwitchMustBeOffFirst = true;  // Обязательно сбрасываем защиту при рестарте
      SendRestartToAll();
      // --------------------------

      lessonSaluteActive = false;
      discoBallsActive = false;
      digitalWrite(Fireworks, LOW);
      OpenAll();
      RestOn();
      level = 25;
      return;
    }
  }
}

/// Часы в первой комнате
void Clock2Game() {
  //clock3Button.tick();
  //if (clock3Button.isPress()) {
  if (!digitalReadExpander(2, board2)) {
    Serial.println(F("clock2"));
    if (!isUfBlinking) {  // Запускаем, только если еще не мигает
      isUfBlinking = true;
      ufBlinkCount = 0;
      ufBlinkTimer = millis();
    }
    // --- (Конец удаления) ---

    galetStepsTimer = millis();
    level++;
  }

  while (Serial.available()) {
    String buff = Serial.readStringUntil('\n');
    buff.trim();
    if (buff == "second_clock") {
      Serial.println(F("clock2"));
      //OpenLock(MansardDoor);

      // Добавлена логика мигания и выключения УФ-светодиода,
      // аналогичная блоку физического взаимодействия.
      if (!isUfBlinking) {  // Запускаем, только если еще не мигает
        isUfBlinking = true;
        ufBlinkCount = 0;
        ufBlinkTimer = millis();
      }
      galetStepsTimer = millis();
      level++;
    }
    if (buff == "soundon") {
      flagSound = 0;
    }
    if (buff == "soundoff") {
      flagSound = 1;
    }
    if (buff == "restart") {
      OpenAll();
      RestOn();
      level = 25;
      return;
    }
  }
}

void GaletGame() {
  // Статические переменные
    // Workshop
    // Basket
    // Dog
    // Owls
    // Local (Main Board)

  // Флаги инициализации (получили ли мы ответ от башни?)
  
  
  
  

  
  

  // --- ГЛАВНЫЙ ФЛАГ БЛОКИРОВКИ ---
  // false = ждем окончания истории (story_4)
  // true = игра началась, проверяем галетники
  

  
  
  

  
  

  // =========================================================
  // БЛОК 1: ОЖИДАНИЕ (Всегда работает, чтобы запустить steps)
  // =========================================================

  // Логика шагов (должна работать ДО начала логики игры)
  if (!galetStartSteps) galetStepsTimer = millis();
  if (millis() - galetStepsTimer >= 6000) {
    if (galetStartSteps) {
      Serial.println(F("steps"));  // Это запустит story_4 на сервере
      galetStartSteps = 0;
    }
  }

  // Если логика еще не разрешена сервером - слушаем только команды запуска
  if (!galetLogicEnabled) {
    while (Serial.available()) {
      String buff = Serial.readStringUntil('\n');
      buff.trim();

      // 1. ОТЛАДКА: Показываем серверу, что именно пришло
      if (buff.length() > 0) {
        Serial.print(F("log:debug:GaletGame_RX: "));
        Serial.println(buff);
      }

      // 2. ИСПОЛЬЗУЕМ indexOf ВМЕСТО ==
      // Это позволит поймать команду, даже если начало/конец "побились"
      // или приклеился soundon

      if (buff.indexOf("after_story_clock2") != -1) {
        galetStartSteps = 1;
      }

      if (buff.indexOf("student_hide") != -1) {
        RunStudentHide();
      }

      if (buff.indexOf("open_mansard_door") != -1) {
        delay(200);
        OpenLock(MansardDoor);
        // Сброс при пропуске
        galetG1 = 0;
        galetG2 = 0;
        galetG3 = 0;
        galetG4 = 0;
        galetG5 = 0;
        galetStartSteps = 0;
        galetIsGameInitialized = false;
        galetGameReadyToWin = false;
        level++;
      }

      if (buff.indexOf("restart") != -1) {
        OpenAll();
        // Сброс при рестарте
        galetG1 = 0;
        galetG2 = 0;
        galetG3 = 0;
        galetG4 = 0;
        galetG5 = 0;
        galetStartSteps = 0;
        galetIsGameInitialized = false;
        galetGameReadyToWin = false;
        RestOn();
        level = 25;
        return;
      }

      if (buff.indexOf("soundon") != -1) {
        flagSound = 0;
      }

      if (buff.indexOf("soundoff") != -1) {
        flagSound = 1;
      }
    }
  }

  // =========================================================
  // БЛОК 2: АКТИВНАЯ ИГРА (Только после команды сервера)
  // =========================================================

  // 1. СБРОС И ПЕРВЫЙ ОПРОС
  if (!galetIsGameInitialized) {
    galetG1 = false;
    galetG2 = false;
    galetG3 = false;
    galetG4 = false;
    galetG5 = false;
    galetInit1 = false;
    galetInit2 = false;
    galetInit3 = false;
    galetInit4 = false;

    // Агрессивный опрос при старте
    Serial1.println(F("check_state"));
    delay(20);
    Serial2.println(F("check_state"));
    delay(20);
    Serial3.println(F("check_state"));
    delay(20);
    mySerial.println(F("check_state"));
    delay(20);

    galetSwitches.tick();
    galetG5 = galetSwitches.state();

    galetGameReadyToWin = false;
    galetVictorySent = false;

    galetIsGameInitialized = true;
    galetRefreshTowerTimer = millis();
    galetGlobalTimeout = millis();
  }

  // 2. ПРОВЕРКА ГОТОВНОСТИ (Ждем ответов от всех или 15 сек)
  bool allTowersResponded = (galetInit1 && galetInit2 && galetInit3 && galetInit4);
  bool safetyTimeoutExpired = (millis() - galetGlobalTimeout > 15000);
  bool systemReady = allTowersResponded || safetyTimeoutExpired;

  // 3. ПЕРИОДИЧЕСКИЙ ОПРОС
  // systemReady == false -> Частый опрос (6 сек)
  // systemReady == true  -> Редкий опрос (20 сек)
  unsigned long refreshInterval = systemReady ? 20000 : 6000;
  if (!galetVictorySent && (millis() - galetRefreshTowerTimer > refreshInterval)) {
    galetRefreshTowerTimer = millis();
    Serial1.println(F("check_state"));
    delay(10);
    Serial2.println(F("check_state"));
    delay(10);
    Serial3.println(F("check_state"));
    delay(10);
    mySerial.println(F("check_state"));
    if (galetG5) Serial.println(F("galet1"));
  }

  // 4. ЧТЕНИЕ ЛОКАЛЬНОГО ГАЛЕТНИКА
  galetSwitches.tick();
  bool currentGalet5State = galetSwitches.state();
  if (currentGalet5State != galetG5) {
    galetG5 = currentGalet5State;
    if (galetG5) Serial.println(F("galet1"));
    else Serial.println(F("galet1_off"));
  }

  // 5. ЧТЕНИЕ УДАЛЕННЫХ БАШЕН
  while (Serial1.available()) {  // Workshop
    String buf1 = Serial1.readStringUntil('\n');
    buf1.trim();
    if (buf1.length() > 0) lastSeenWorkshop = millis();  // Step 4
    if (buf1 == "pong" || buf1.indexOf("ping_main") != -1) continue;  // Step 4
    if (buf1.startsWith("log:")) {
      Serial.println(buf1);
    } else if (buf1 == "galet_on") {
      galetG1 = true;
      galetInit1 = true;
      Serial.println(F("galet2"));
    } else if (buf1 == "galet_off") {
      galetG1 = false;
      galetInit1 = true;
      Serial.println(F("galet2_off"));
    }
  }
  while (Serial2.available()) {  // Basket
    String buf2 = Serial2.readStringUntil('\n');
    buf2.trim();
    if (buf2.length() > 0) lastSeenBasket = millis();  // Step 4
    if (buf2 == "pong" || buf2.indexOf("ping_main") != -1) continue;  // Step 4
    if (buf2.startsWith("log:")) {
      Serial.println(buf2);
    } else if (buf2 == "galet_on") {
      galetG2 = true;
      galetInit2 = true;
      Serial.println(F("galet3"));
    } else if (buf2 == "galet_off") {
      galetG2 = false;
      galetInit2 = true;
      Serial.println(F("galet3_off"));
    }
  }
  while (Serial3.available()) {  // Dog
    String buf3 = Serial3.readStringUntil('\n');
    buf3.trim();
    if (buf3.length() > 0) lastSeenDog = millis();  // Step 4
    if (buf3 == "pong" || buf3.indexOf("ping_main") != -1) continue;  // Step 4
    if (buf3.startsWith("log:")) {
      Serial.println(buf3);
    } else if (buf3 == "galet_on") {
      galetG3 = true;
      galetInit3 = true;
      Serial.println(F("galet4"));
    } else if (buf3 == "galet_off") {
      galetG3 = false;
      galetInit3 = true;
      Serial.println(F("galet4_off"));
    }
  }
  while (mySerial.available()) {  // Owls
    String buf4 = mySerial.readStringUntil('\n');
    buf4.trim();
    if (buf4.length() > 0) lastSeenOwls = millis();  // Step 4
    if (buf4 == "pong" || buf4.indexOf("ping_main") != -1) continue;  // Step 4
    if (buf4.startsWith("log:")) {
      Serial.println(buf4);
    } else if (buf4 == "galet_on" || buf4 == "owls_galet_on") {
      galetG4 = true;
      galetInit4 = true;
      Serial.println(F("galet5"));
    } else if (buf4 == "galet_off" || buf4 == "owls_galet_off") {
      galetG4 = false;
      galetInit4 = true;
      Serial.println(F("galet5_off"));
    }
  }

  // 6. ЛОГИКА ПОБЕДЫ (Работает только если systemReady)
  if (systemReady) {
    int activeGalets = galetG1 + galetG2 + galetG3 + galetG4 + galetG5;

    // ПРЕДОХРАНИТЕЛЬ: Снимаем только если игрок держит < 5 галетников
    if (!galetGameReadyToWin && activeGalets < 5) {
      galetGameReadyToWin = true;
    }

    // ПОБЕДА: Только если 5 галетников И предохранитель снят
    if (activeGalets == 5 && galetGameReadyToWin && !galetVictorySent) {
      delay(200);
      Serial.println(F("mansard_finish"));
      galetVictorySent = true;
    }
  }

  // 7. КОМАНДЫ (В активной фазе)
  while (Serial.available()) {
    String buff = Serial.readStringUntil('\n');
    buff.trim();
    // (galetStartSteps здесь уже не нужен, но оставляем для совместимости)
    if (buff == "after_story_clock2") { galetStartSteps = 1; }

    if (buff == "student_hide") {
      RunStudentHide();
    }
    if (buff == "open_mansard_door") {
      delay(200);
      OpenLock(MansardDoor);
      // Сброс
      galetG1 = 0;
      galetG2 = 0;
      galetG3 = 0;
      galetG4 = 0;
      galetG5 = 0;
      galetInit1 = 0;
      galetInit2 = 0;
      galetInit3 = 0;
      galetInit4 = 0;
      galetStartSteps = 0;
      galetIsGameInitialized = false;
      galetGameReadyToWin = false;
      galetVictorySent = false;
      galetLogicEnabled = false;  // Сброс флага
      level++;
    }
    if (buff == "restart") {
      OpenAll();
      galetG1 = 0;
      galetG2 = 0;
      galetG3 = 0;
      galetG4 = 0;
      galetG5 = 0;
      galetInit1 = 0;
      galetInit2 = 0;
      galetInit3 = 0;
      galetInit4 = 0;
      galetStartSteps = 0;
      galetIsGameInitialized = false;
      galetGameReadyToWin = false;
      galetVictorySent = false;
      galetLogicEnabled = false;  // Сброс флага
      RestOn();
      level = 25;
      return;
    }
    if (buff == "soundon") flagSound = 0;
    if (buff == "soundoff") flagSound = 1;
  }
}

void ThreeGame() {
  if (threeSuitcaseFlag && threeSafeFlag && threeWolfFlag) {
    threeSuitcaseFlag = 0;
    threeSafeFlag = 0;
    threeWolfFlag = 0;
    level++;
    Serial.println(F("three_game_end"));
  }
  while (Serial.available()) {
    String buff = Serial.readStringUntil('\n');
    buff.trim();
    if (buff == "student_hide") {
      RunStudentHide();
    }
    if (buff == "suitcase_end") {
      threeSuitcaseFlag = 1;
    }
    if (buff == "safe_end") {
      threeSafeFlag = 1;
    }
    if (buff == "wolf_end") {
      threeWolfFlag = 1;
    }
    if (buff == "restart") {
      OpenAll();
      threeSuitcaseFlag = 0;
      threeSafeFlag = 0;
      threeWolfFlag = 0;
      RestOn();
      level = 25;
      return;
    }
    if (buff == "soundon") {
      flagSound = 0;
    }
    if (buff == "soundoff") {
      flagSound = 1;
    }
  }
}

/// обработка флагов чисто на портах
void Flags() {
  // digitalWrite(MansardLight, LOW);
  while (Serial1.available()) {
    String buf1 = Serial1.readStringUntil('\n');
    buf1.trim();
    if (buf1.length() > 0) lastSeenWorkshop = millis();  // Step 4
    if (buf1 == "pong" || buf1.indexOf("ping_main") != -1) continue;  // Step 4
    if (buf1.startsWith("log:")) {
      Serial.println(buf1);
    } else if (buf1 == "flag1_on") {
      // 2026-08-07: башни шлют состояние флага периодически, чтобы
      // рассинхрон лечился сам. Наверх отдаём только ИЗМЕНЕНИЯ —
      // иначе сервер и пульт получали бы одно и то же каждые 5 сек.
      if (FirstFlag != 1) {
        FirstFlag = 1;
        Serial.println(F("flag1_on"));
      }
    } else if (buf1 == "flag1_off") {
      // 2026-08-07: башни шлют состояние флага периодически, чтобы
      // рассинхрон лечился сам. Наверх отдаём только ИЗМЕНЕНИЯ —
      // иначе сервер и пульт получали бы одно и то же каждые 5 сек.
      if (FirstFlag != 0) {
        FirstFlag = 0;
        Serial.println(F("flag1_off"));
      }
    }
  }

  while (Serial2.available()) {
    String buf2 = Serial2.readStringUntil('\n');
    buf2.trim();
    if (buf2.length() > 0) lastSeenBasket = millis();  // Step 4
    if (buf2 == "pong" || buf2.indexOf("ping_main") != -1) continue;  // Step 4
    if (buf2.startsWith("log:")) {
      Serial.println(buf2);
    } else if (buf2 == "flag2_on") {
      // 2026-08-07: башни шлют состояние флага периодически, чтобы
      // рассинхрон лечился сам. Наверх отдаём только ИЗМЕНЕНИЯ —
      // иначе сервер и пульт получали бы одно и то же каждые 5 сек.
      if (SecondFlag != 1) {
        SecondFlag = 1;
        Serial.println(F("flag2_on"));
      }
    } else if (buf2 == "flag2_off") {
      // 2026-08-07: башни шлют состояние флага периодически, чтобы
      // рассинхрон лечился сам. Наверх отдаём только ИЗМЕНЕНИЯ —
      // иначе сервер и пульт получали бы одно и то же каждые 5 сек.
      if (SecondFlag != 0) {
        SecondFlag = 0;
        Serial.println(F("flag2_off"));
      }
    }
  }

  while (Serial3.available()) {
    String buf3 = Serial3.readStringUntil('\n');
    buf3.trim();
    if (buf3.length() > 0) lastSeenDog = millis();  // Step 4
    if (buf3 == "pong" || buf3.indexOf("ping_main") != -1) continue;  // Step 4
    if (buf3.startsWith("log:")) {
      Serial.println(buf3);
    } else if (buf3 == "flag3_on") {
      // 2026-08-07: башни шлют состояние флага периодически, чтобы
      // рассинхрон лечился сам. Наверх отдаём только ИЗМЕНЕНИЯ —
      // иначе сервер и пульт получали бы одно и то же каждые 5 сек.
      if (ThirdFlag != 1) {
        ThirdFlag = 1;
        Serial.println(F("flag3_on"));
      }
    } else if (buf3 == "flag3_off") {
      // 2026-08-07: башни шлют состояние флага периодически, чтобы
      // рассинхрон лечился сам. Наверх отдаём только ИЗМЕНЕНИЯ —
      // иначе сервер и пульт получали бы одно и то же каждые 5 сек.
      if (ThirdFlag != 0) {
        ThirdFlag = 0;
        Serial.println(F("flag3_off"));
      }
    }
  }

  while (mySerial.available()) {
    String buf4 = mySerial.readStringUntil('\n');
    buf4.trim();
    if (buf4.length() > 0) lastSeenOwls = millis();  // Step 4
    if (buf4 == "pong" || buf4.indexOf("ping_main") != -1) continue;  // Step 4
    if (buf4.startsWith("log:")) {
      Serial.println(buf4);
    } else if (buf4 == "flag4_on") {
      // 2026-08-07: башни шлют состояние флага периодически, чтобы
      // рассинхрон лечился сам. Наверх отдаём только ИЗМЕНЕНИЯ —
      // иначе сервер и пульт получали бы одно и то же каждые 5 сек.
      if (FourFlag != 1) {
        FourFlag = 1;
        Serial.println(F("flag4_on"));
      }
    } else if (buf4 == "flag4_off") {
      // 2026-08-07: башни шлют состояние флага периодически, чтобы
      // рассинхрон лечился сам. Наверх отдаём только ИЗМЕНЕНИЯ —
      // иначе сервер и пульт получали бы одно и то же каждые 5 сек.
      if (FourFlag != 0) {
        FourFlag = 0;
        Serial.println(F("flag4_off"));
      }
    }
  }

  if (FirstFlag && SecondFlag && ThirdFlag && FourFlag) {
    Serial.println(F("flagsendmr"));
    level++;
  }
  while (Serial.available()) {
    String buff = Serial.readStringUntil('\n');
    buff.trim();
    if (buff == "student_hide") {
      RunStudentHide();
    }
    if (buff == "m2lck") {
      Serial.println(F("flagsendmr"));
      level++;
      //OpenLock(MansardStashDoor);
      // иногда приходится отправлять несколько раз иногда с первого раза не читает обязательно задержка в 1 с не знаю с чем связано
    }
    if (buff == "soundon") {
      flagSound = 0;
    }
    if (buff == "soundoff") {
      flagSound = 1;
    }
    if (buff == "restart") {
      OpenAll();
      RestOn();
      level = 25;
      return;
    }
  }
}
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
