ProducED-ed/Castle/train/train.ino

// Сколько ждать после подачи питания, прежде чем включать периферию.
static const unsigned long STARTUP_SETTLE_MS = 1200;

#include <Arduino.h>
#include "GyverEncoder.h"
#include <FastLED.h>
#include "HardwareSerial.h"
#include "DFRobotDFPlayerMini.h"
#include <WiFi.h>
#include <WebServer.h>
#include <HTTPClient.h>
#include <Adafruit_PCF8574.h>
// --- ДОБАВЛЕНО ДЛЯ OTA ---
#include <ESPmDNS.h>
#include <WiFiUdp.h>
#include <ArduinoOTA.h>
#include "soc/soc.h"
#include "soc/rtc_cntl_reg.h"
// -------------------------

HardwareSerial mySerial(1);  // Use UART1
#define NUM_LEDS 30
#define LED_PIN 17
#define MAX_BRIGHTNESS 255
#define NUM_LEDS1 4
#define DATA_PIN1 5
#define TUNNEL_LED 23
#define UF_LED 19

bool mapClicksDisabled = false; // Флаг для отслеживания состояния кликов

CRGB leds1[NUM_LEDS1];
CRGB ledMap[30];
#include "GyverButton.h"
int TimerLeds[] = { 1, 2, 3, 4, 5 };
unsigned long lightFlashTimer = 0;
bool up;
int light = 0;
unsigned long skinlightFlashTimer = 0;
bool skinup;
int skinlight = 0;

int DisableLeds[] = { -1, -1, -1, -1, -1, -1, -1, -1, -1, -1, -1, -1, -1, -1, -1, -1, -1, -1, -1, -1, -1, -1 };
int ActiveLeds[] = { -1, -1, -1, -1, -1, -1, -1, -1, -1, -1, -1, -1, -1, -1, -1, -1, -1, -1, -1, -1, -1, -1 };
int ClickLeds[] = { -1, -1, -1, -1, -1, -1, -1, -1, -1, -1, -1, -1, -1, -1, -1, -1, -1, -1, -1, -1, -1, -1 };
int FutureLeds[] = { -1, -1, -1, -1, -1, -1, -1, -1, -1, -1, -1, -1, -1, -1, -1, -1, -1, -1, -1, -1, -1, -1 };

// Этот массив будет "помнить", какие LED были в ClickLeds 
// до вызова map_disable_clicks
bool wasClickLed[22] = {false};

bool newStateAvailable = false;
unsigned long _secondsTimer;
unsigned long _clockTimer;
bool _startTimer;
bool _timerEnabled;
int counter = 9;
int blinkLedNumber = -1;

int timerLedsCount = 0;
bool timerIsStarting = true;
int value = 30;

long enc1Last = 0;  // Предыдущая позиция энкодера 1
long enc2Last = 0;  // Предыдущая позиция энкодера 2

bool fireworkActive = false;
unsigned long fireworkStartTime = 0;
const unsigned long FIREWORK_DURATION = 10000;  // 10 секунд салюта
CRGB fireworkColors[5] = { CRGB::Red, CRGB::Blue, CRGB::Green, CRGB::Purple, CRGB::Yellow };

long enc1Pos = 0, enc2Pos = 0;
int hue = 40;  // 0-21845 (красный-зелёный)
int hue1 = 0;
int brightness = 255;
unsigned long prevMillis = 0;
bool ledState = false;
int blinkInterval = 200;
bool isGreen = false;        // Флаг зелёного цвета
const int greenHue = 196;    // Зелёный в HSV
int targetBrightness = 255;  // Целевая яркость
int fadeSpeed = 5;           // Скорость изменения яркости
bool isLedOn = true;
int baseBrightness = 200;    // Базовая яркость
int flickerIntensity = 150;  // Сила мерцания (0-100)
unsigned long prevFlickerTime = 0;
unsigned long checkTrainTimer = 0;
uint8_t initialHue = 0;
long musicCounter = 0;
bool musicFlag1 = 0;
bool musicFlag2 = 0;
bool musicFlag3 = 0;
int language = 1;
int hint_counter = 0;
bool hintFlag = 1;
// 2026-08-14. Подсказки жили ТОЛЬКО на событии «трек доиграл» от DFPlayer, а
// эти события на ESP32 теряются (см. историю с Сейфом). Одно потерянное
// событие — и hintFlag навсегда остаётся нулём: геркон нажимают, а подсказки
// нет до конца партии. Ровно это видели на CLC4: сперва замолчал Волк, потом
// Поезд. Страховка по времени: через HINT_REARM_MS подсказка разрешается сама.
// Правило: рядом с каждым hintFlag = 0 обязателен hintPlayedAt —
//   millis() — если подсказку надо разрешить обратно по таймеру,
//   0        — если разрешать будет другой код (конец истории, новая сцена).
unsigned long hintPlayedAt = 0;
const unsigned long HINT_REARM_MS = 20000;
bool trainSensorLatched = false; // Запоминание нажатия
bool isRestartMode = false;
bool lastColorOk = false;
bool lastFlickerOk = false;
bool lastSoundOk = false;

Adafruit_PCF8574 INPUTS;
Adafruit_PCF8574 OUTPUTS;

// === DIAG MODE (тех-пульт /tech → вкладка "Диагностика") ===
// Когда diagModeActive == true:
//  - вся игровая логика в loop() пропускается (early return)
//  - входящие команды (start/stage_X/restart...) игнорируются, кроме "diag_*"
//  - каждые 200ms ESP32 шлёт snapshot всех I/O на /api?device=train
bool diagModeActive = false;
unsigned long diagLastSnapshot = 0;
const unsigned long DIAG_SNAPSHOT_INTERVAL = 200;  // ms
// Отдельные счётчики энкодеров для diag-режима (GyverEncoder не даёт getCount() —
// используем isLeft/isRight как и игровая логика)
long diagEnc1 = 0, diagEnc2 = 0, diagEnc3 = 0;
// Счётчик прерываний с пьезо-датчика стука (GPIO 36, "KNOCK SENS" по схеме).
// Дополняет существующий GButton ghost(36): GButton ловит "одиночные/двойные клики",
// а этот счётчик — каждый отдельный RISING-edge для отображения в diag.
volatile unsigned long vibCount = 0;
void IRAM_ATTR knockISR() { vibCount++; }

// --- Истории (7-42) ---
// Блок Story 15
const int TRACK_STORY_15_RU = 13;
const int TRACK_STORY_15_EN = 23;
const int TRACK_STORY_15_AR = 33;
const int TRACK_STORY_15_FR = 66;
const int TRACK_STORY_15_UK = 77;
const int TRACK_STORY_15_PL = 98;

// Блок Story 16
const int TRACK_STORY_16_RU = 14;
const int TRACK_STORY_16_EN = 24;
const int TRACK_STORY_16_AR = 34;
const int TRACK_STORY_16_FR = 67;
const int TRACK_STORY_16_UK = 78;
const int TRACK_STORY_16_PL = 88;

// Блок Story 45
const int TRACK_STORY_45_RU = 45;
const int TRACK_STORY_45_EN = 55;
const int TRACK_STORY_45_AR = 65;
const int TRACK_STORY_45_FR = 68;
const int TRACK_STORY_45_UK = 79;
const int TRACK_STORY_45_PL = 89;

// --- Подсказки (9-42) ---
// Блок Hint 0
const int TRACK_HINT_0_RU = 15;
const int TRACK_HINT_0_EN = 25;
const int TRACK_HINT_0_AR = 35;
const int TRACK_HINT_0_FR = 69;
const int TRACK_HINT_0_UK = 80;
const int TRACK_HINT_0_PL = 90;

// Блок Hint 1
const int TRACK_HINT_1_RU = 16;
const int TRACK_HINT_1_EN = 26;
const int TRACK_HINT_1_AR = 36;
const int TRACK_HINT_1_FR = 70;
const int TRACK_HINT_1_UK = 81;
const int TRACK_HINT_1_PL = 91;

// Блок Hint 2
const int TRACK_HINT_2_RU = 17;
const int TRACK_HINT_2_EN = 27;
const int TRACK_HINT_2_AR = 37;
const int TRACK_HINT_2_FR = 71;
const int TRACK_HINT_2_UK = 82;
const int TRACK_HINT_2_PL = 92;

// Блок Hint 3
const int TRACK_HINT_3_RU = 18;
const int TRACK_HINT_3_EN = 28;
const int TRACK_HINT_3_AR = 38;
const int TRACK_HINT_3_FR = 72;
const int TRACK_HINT_3_UK = 83;
const int TRACK_HINT_3_PL = 93;

// Блок Hint 4
const int TRACK_HINT_4_RU = 19;
const int TRACK_HINT_4_EN = 29;
const int TRACK_HINT_4_AR = 39;
const int TRACK_HINT_4_FR = 73;
const int TRACK_HINT_4_UK = 84;
const int TRACK_HINT_4_PL = 94;

// Блок Hint 5
const int TRACK_HINT_5_RU = 20;
const int TRACK_HINT_5_EN = 30;
const int TRACK_HINT_5_AR = 40;
const int TRACK_HINT_5_FR = 74;
const int TRACK_HINT_5_UK = 85;
const int TRACK_HINT_5_PL = 95;

// Блок Hint 6
const int TRACK_HINT_6_RU = 21;
const int TRACK_HINT_6_EN = 31;
const int TRACK_HINT_6_AR = 41;
const int TRACK_HINT_6_FR = 75;
const int TRACK_HINT_6_UK = 86;
const int TRACK_HINT_6_PL = 96;

// Блок Hint 7
const int TRACK_HINT_7_RU = 22;
const int TRACK_HINT_7_EN = 32;
const int TRACK_HINT_7_AR = 42;
const int TRACK_HINT_7_FR = 76;
const int TRACK_HINT_7_UK = 87;
const int TRACK_HINT_7_PL = 97;

// --- Системные треки (1-6) ---
const int TRACK_TRAIN_ON = 1;
const int TRACK_ENGINE1 = 2;
const int TRACK_ENGINE2 = 3;
const int TRACK_KNOCK = 4;
const int TRACK_TRAIN = 5;
const int TRACK_GHOST = 6;
const int TRACK_ENGINE3 = 43;

// 2026-08-07: страховка на потерянное событие finishedTrack от DFPlayer.
// Запуск самой игры с поездом (state 1 -> 2) висел на ДВУХ подряд событиях
// «трек доиграл»: projector -> TRACK_TRAIN_ON -> STORY_15 -> state = 2.
// Библиотека DFRobotDFPlayerMini эти события теряет (тот же класс, что чинили
// на Safe и на Chest), а запасного пути не было вообще — поезд оставался в
// state 1 навсегда, и геймастеру приходилось скипать этап с пульта.
// Лог CLC3 06.08: 09:47:24 {"projector":"end"} -> тишина -> 10:07:47 ручной скип.
// Событие может и не потеряться, а быть перебито: любой трек, запущенный
// поверх (подсказка по кнопке), тоже обрывает цепочку без шанса восстановиться.
unsigned long trainOnStartedAt = 0;   // millis() запуска TRACK_TRAIN_ON, 0 = не ждём
unsigned long story15StartedAt = 0;   // millis() запуска STORY_15, 0 = не ждём
// 14.08.2026. Длительности измерил Эдуард: train_on (трек 1) — 4 с; story_15 по
// языкам — 12, 12, 13, 9, 8, 7 с, то есть максимум 13. Прежние 20 и 60 секунд
// брались с тройным запасом «на глаз», и когда DFPlayer терял событие конца
// трека — а он теряет его регулярно, — этап поезда начинался через полторы
// минуты после касания. Ставим запас вдвое от реальной длины: сторож всё так же
// не мешает штатному событию (оно приходит раньше), но провал вместо 80 секунд
// становится примерно десятисекундным.
// С 14.08.2026 этап играет ОДНУ историю: звук train_on лежит внутри файлов
// story_15, все языки по 13 секунд. Сторож train_on остался только для команды
// train_on с пульта и по игровой цепочке не взводится.
const unsigned long TRAIN_ON_MAX_MS = 8000UL;   // трек 4 с
// 14.08.2026, решение Эдуарда: игра стартует строго по таймеру — 13,5 секунды
// от начала истории. Все языки ровно 13 секунд, так что полсекунды это пауза
// на вдох, а не ожидание. Событие «трек доиграл» от DFPlayer никуда не делось
// и, если приходит, стартует игру чуть раньше — но полагаться на него больше
// не приходится: оно теряется регулярно.
const unsigned long STORY15_MAX_MS  = 13500UL;  // история 13 с + 0,5 с

bool isTrainClick = false;
bool isOwlClick = false;
bool isKeyClick = false;
bool isFishClick = false;
bool isStartTimer = false;
bool isStartTrain = false;
bool isTrainEnd = false;
bool isSkinPulsation;
bool ghostFlag;
bool isSendOut;
bool isTrollEnd = 0;
bool resumeEngineSound = false;
bool skinReedLatched = false;
unsigned long lastSkinDebounceTime = 0;
bool lastSkinSteadyState = false; // (false = отпущено)
bool skinState = false;           // (false = отпущено)
const unsigned long DEBOUNCE_DELAY = 50; // 50мс антидребезг

String mapState;

// Флаг для контроля отправки сообщения о завершении игры с поездом
bool trainEndConfirmed = false;
// Таймер для периодической отправки этого сообщения
unsigned long trainEndSendTimer = 0;
// Таймер для игнорирования датчика стука после команды ghost_knock
unsigned long ghostIgnoreStartTime = 0;
const unsigned long GHOST_IGNORE_DURATION = 3000; // 3 секунды

Encoder enc1(33, 25);
Encoder enc2(35, 32);
Encoder enc3(39, 34);
// --- Функции для прерываний ---
// IRAM_ATTR хранит функцию в оперативной памяти для максимальной скорости
volatile bool ledsUpdating = false; 

void IRAM_ATTR isrEnc1() {
  if (!ledsUpdating) enc1.tick(); // Если лента обновляется, пропускаем тик
}
void IRAM_ATTR isrEnc2() {
  if (!ledsUpdating) enc2.tick();
}
void IRAM_ATTR isrEnc3() {
  if (!ledsUpdating) enc3.tick();
}

DFRobotDFPlayerMini myMP3;

const char* ssid = "Castle";
const char* password = "questquest";
//const char* ssid = "ProducED";
//const char* password = "32744965";

// Настройки статического IP
IPAddress local_IP(192, 168, 4, 202);
IPAddress gateway(192, 168, 4, 1);
IPAddress subnet(255, 255, 255, 0);

const char* externalApi = "http://192.168.4.1:3000/api";

WebServer server(80);

GButton ghost(36);
int state = 0;

void sendLogToServer(String message) {
  if (WiFi.status() == WL_CONNECTED) {
    HTTPClient http;
    http.begin("http://192.168.4.1:3000/api/log"); // Замените на IP вашего сервера
    http.addHeader("Content-Type", "application/json");
    String payload = "{\"device\":\"train\", \"message\":\"" + message + "\"}";
    int httpCode = http.POST(payload);
    http.end();
  }
}

void ResetTimer() {
  // Сбрасываем глобальные переменные таймера
  timerLedsCount = 0;
  timerIsStarting = true;

  // Гасим все светодиоды таймера
  for (int i = 0; i <= 10; i++) {
    ledMap[i] = CRGB(0, 0, 0);
  }

  // Гасим моргающий светодиод
  if (blinkLedNumber != -1) {
    ledMap[blinkLedNumber] = CRGB(0, 0, 0);
  }

  // Сбрасываем флаги
  isKeyClick = false;
  isFishClick = false;
  isOwlClick = false;
  isTrainClick = false;
  // Сброс блокировки при таймауте
  isStartTrain = 0;  
  isSendOut = 0;     
  trainSensorLatched = false;
}


void startFirework() {
  fireworkActive = true;
  fireworkStartTime = millis();
  Serial.println("firework:started\r");
}

//Добавьте эту функцию для анимации фейерверка
void handleFirework() {
  if (!fireworkActive) return;

  static unsigned long lastFireworkTime = 0;
  static const int MAX_EXPLOSIONS = 3;
  static struct Explosion {
    int phase;
    CRGB color;
    int center;
    unsigned long startTime;
  } explosions[MAX_EXPLOSIONS];


  // Создаем новые взрывы
  if (millis() - lastFireworkTime >= 600) {
    lastFireworkTime = millis();

    // Ищем свободный слот для нового взрыва
    for (int i = 0; i < MAX_EXPLOSIONS; i++) {
      if (explosions[i].phase == 0) {
        // Красивые цвета салюта
        CRGB niceColors[] = {
          CRGB(255, 100, 50),   // Оранжевый
          CRGB(100, 255, 100),  // Светло-зеленый
          CRGB(100, 100, 255),  // Светло-синий
          CRGB(255, 255, 100),  // Светло-желтый
          CRGB(255, 100, 255),  // Розовый
          CRGB(100, 255, 255)   // Бирюзовый
        };

        explosions[i].color = niceColors[random(6)];
        explosions[i].center = random(6, 24);
        explosions[i].startTime = millis();
        explosions[i].phase = 1;
        break;
      }
    }
  }

  // Обрабатываем все активные взрывы
  for (int e = 0; e < MAX_EXPLOSIONS; e++) {
    if (explosions[e].phase > 0) {
      unsigned long elapsed = millis() - explosions[e].startTime;

      if (elapsed < 500) {
        // Фаза расширения
        float progress = (float)elapsed / 500.0;
        int radius = progress * 8;

        for (int i = 0; i < 30; i++) {
          int distance = abs(i - explosions[e].center);
          if (distance <= radius) {
            float intensity = 1.0 - (float)distance / radius;
            ledMap[i] = explosions[e].color;
            ledMap[i].fadeToBlackBy(255 - (intensity * 255));
          }
        }
      } else if (elapsed < 1000) {
        // Фаза затухания
        float fadeProgress = (float)(elapsed - 500) / 500.0;
        uint8_t fadeAmount = fadeProgress * 255;

        for (int i = 0; i < 30; i++) {
          int distance = abs(i - explosions[e].center);
          if (distance <= 8) {
            ledMap[i] = explosions[e].color;
            ledMap[i].fadeToBlackBy(fadeAmount);
          }
        }
      } else {
        // Завершаем взрыв
        explosions[e].phase = 0;
        for (int i = 0; i < 30; i++) {
          int distance = abs(i - explosions[e].center);
          if (distance <= 8) {
            ledMap[i] = CRGB::Black;
          }
        }
      }
    }
  }

  // Плавное затухание всех светодиодов
  EVERY_N_MILLISECONDS(20) {
    for (int i = 0; i < 30; i++) {
      if (ledMap[i] != CRGB::Black) {
        ledMap[i].fadeToBlackBy(8);
      }
    }
  }

  FastLED.show();
}

// Анимация загрузки
void HandleLoadingAnimation() {
  // Троттлинг обновления (не чаще раз в 40мс)
  static unsigned long lastAnimTime = 0;
  if (millis() - lastAnimTime < 90) return; 
  lastAnimTime = millis();

  // 1. Затухание только для основной карты
  fadeToBlackBy(ledMap, 9, 60);

  // 2. Гасим leds1 (кожа и поезд), чтобы они точно не светились
  for(int i=0; i<4; i++) leds1[i] = CRGB::Black;

  static int pos = 0;
  pos++;
  if (pos > 8) pos = 1; // Диапазон 0-8

  // Рисуем синюю комету только на карте
  ledMap[pos] = CRGB::Blue;
}
// ------------------------------------------------------------------

void setup() {
  // Отключаем встроенный Brown-Out Detector — фикс cold-boot WiFi fails
  // на слабом/шумном БП. См. [[clc-safe-esp32-power-issue]] в памяти.
  WRITE_PERI_REG(RTC_CNTL_BROWN_OUT_REG, 0);

  Serial.begin(115200);
  // Пауза перед включением периферии. При холодном пуске конденсаторы лент,
  // звукового модуля и самой платы ещё пустые: если поднимать всё это сразу,
  // бросок тока роняет питание. А встроенный детектор просадки у нас выключен
  // строкой выше — значит вместо честной перезагрузки чип просто зависает, и
  // устройство «не стартует, пока не нажмёшь EN». Проверено на поезде CLC4
  // 13.08.2026: без паузы не поднимался ни разу, с паузой — три холодных
  // пуска подряд из трёх.
  delay(STARTUP_SETTLE_MS);

  mySerial.begin(9600, SERIAL_8N1, 16, 17);
  FastLED.addLeds<WS2812B, DATA_PIN1, GRB>(leds1, NUM_LEDS1);
  FastLED.addLeds<WS2812B, 18, GRB>(ledMap, 30);

  // --- ИСПРАВЛЕНИЕ I2C (снижение скорости) ---
  // 1. Явно запускаем I2C (обычно SDA=21, SCL=22 для ESP32)
  Wire.begin(); 
  // 2. Снижаем частоту до 10 кГц (10000) для максимальной надежности
  // Если будет работать слишком медленно, попробуйте 50000 (50 кГц)
  Wire.setClock(10000); 
  // ------------------------------------------

  Serial.print("Checking PCF8574 (INPUTS) at 0x20... ");
  Wire.beginTransmission(0x20);
  if (Wire.endTransmission() == 0) {
    Serial.println("OK");
  } else {
    Serial.println("FAILED! Check wiring.");
  }

  for (int i = 0; i < 22; i++) {
    ActiveLeds[i] = -1;
    DisableLeds[i] = -1;
    ClickLeds[i] = -1;
    FutureLeds[i] = -1;
    // Сбрасываем массив "памяти"
    wasClickLed[i] = false;
  }

  // 2026-05-27: было setDebounce(10) — пьезо-датчик даёт очень короткие импульсы,
  // 10ms могло их срезать. Снизили до 1ms чтобы ловить kratest knock pulses.
  ghost.setDebounce(1);        // 1ms антидребезг (минимальный для piezo)
  ghost.setTimeout(300);       // настройка таймаута на удержание (по умолчанию 500 мс)
  ghost.setClickTimeout(100);  // настройка таймаута между кликами (по умолчанию 300 мс)
  ghost.setType(LOW_PULL);
  ghost.setDirection(NORM_OPEN);
  ghost.setTickMode(AUTO);

  pinMode(36, INPUT);
  // Прерывание для счётчика стуков в diag-режиме (не мешает GButton ghost.tick())
  attachInterrupt(digitalPinToInterrupt(36), knockISR, RISING);

  enc1.setType(TYPE2);
  enc2.setType(TYPE2);
  enc3.setType(TYPE2);
  // --- Включаем прерывания на всех пинах энкодеров ---
  // Энкодер 1 (Пины 33, 25)
  attachInterrupt(33, isrEnc1, CHANGE);
  attachInterrupt(25, isrEnc1, CHANGE);

  // Энкодер 2 (Пины 35, 32)
  attachInterrupt(35, isrEnc2, CHANGE);
  attachInterrupt(32, isrEnc2, CHANGE);

  // Энкодер 3 (Пины 39, 34)
  attachInterrupt(39, isrEnc3, CHANGE);
  attachInterrupt(34, isrEnc3, CHANGE);

  pinMode(TUNNEL_LED, OUTPUT);
  pinMode(UF_LED, OUTPUT);



  if (!INPUTS.begin(0x20, &Wire)) {
    Serial.println("Couldn't find PCF8574");
    //while (1);
  }
  for (uint8_t p = 0; p < 8; p++) {
    INPUTS.pinMode(p, INPUT_PULLUP);
  }

  if (!OUTPUTS.begin(0x21, &Wire)) {
    Serial.println("Couldn't find PCF8574");
  }
  for (uint8_t p = 0; p < 3; p++) {
    OUTPUTS.pinMode(p, OUTPUT);
  }

  if (!myMP3.begin(mySerial)) {
    Serial.println("DFPlayer Mini not detected!");
  }
  myMP3.volume(value);
  myMP3.stop();


  if (!WiFi.config(local_IP, gateway, subnet)) {
    Serial.println("STA Failed to configure");
  }
  WiFi.persistent(true);
  WiFi.setAutoReconnect(true);
  WiFi.begin(ssid, password);

  unsigned long wifiStart = millis();
  while (WiFi.status() != WL_CONNECTED) {
    if (millis() - wifiStart > 15000UL) {
      Serial.println("WiFi connect timeout — restarting ESP32");
      delay(500);
      ESP.restart();
    }
    delay(1000);
    Serial.println("Connecting to WiFi...");
  }

  Serial.println("\nWiFi connected");
  Serial.println("IP address: " + WiFi.localIP().toString());
  SendData("{\"log\":\"ESP32 Train is ready. IP: " + WiFi.localIP().toString() + "\"}");

  server.on("/", HTTP_GET, []() {
    server.send(200, "text/plain", "ESP32 Server is running");
  });

  server.on("/data", HTTP_POST, []() {
    if (server.hasArg("plain")) {
      String body = server.arg("plain");
      sendLogToServer("RX:" + body);

      // === DIAG MODE — обработка тех-диагностики (см. /tech → Диагностика) ===
      if (body == "\"diag_on\"") {
        diagModeActive = true;
        // Гасим всё, останавливаем звук, чтобы получить чистое состояние
        myMP3.stop();
        for (int i = 0; i < 30; i++) ledMap[i] = CRGB::Black;
        for (int i = 0; i < 4; i++) leds1[i] = CRGB::Black;
        FastLED.show();
        digitalWrite(TUNNEL_LED, LOW);
        digitalWrite(UF_LED, LOW);
        OUTPUTS.digitalWrite(0, LOW);
        OUTPUTS.digitalWrite(1, LOW);
        OUTPUTS.digitalWrite(2, LOW);
        Serial.println("DIAG ON");
        server.send(200, "application/json", "{\"status\":\"diag_on\"}");
        return;
      }
      if (body == "\"diag_off\"") {
        diagModeActive = false;
        // Возвращаем устройство в idle: гасим выходы (state=0)
        for (int i = 0; i < 30; i++) ledMap[i] = CRGB::Black;
        for (int i = 0; i < 4; i++) leds1[i] = CRGB::Black;
        FastLED.show();
        digitalWrite(TUNNEL_LED, LOW);
        digitalWrite(UF_LED, LOW);
        OUTPUTS.digitalWrite(0, LOW);
        OUTPUTS.digitalWrite(1, LOW);
        myMP3.stop();
        state = 0;
        Serial.println("DIAG OFF");
        server.send(200, "application/json", "{\"status\":\"diag_off\"}");
        return;
      }
      if (body.startsWith("\"diag_set:")) {
        handleDiagSet(body);
        server.send(200, "application/json", "{\"status\":\"diag_set\"}");
        return;
      }
      // Если diag активен — все игровые команды игнорируем
      if (diagModeActive) {
        Serial.println("DIAG ignored: " + body);
        server.send(200, "application/json", "{\"status\":\"ignored_diag\"}");
        return;
      }
      // === END DIAG ===

      // Добавляем обработку подтверждения от сервера
      if (body == "\"confirm_train_end\"") {
        trainEndConfirmed = true; // Получили подтверждение, прекращаем отправку
      }
      static int currentTrainStage = 0;
      if (body == "\"start\"") {
        OUTPUTS.digitalWrite(0, HIGH);
        myMP3.stop();
        delay(500);
        myMP3.playMp3Folder(TRACK_TRAIN);
        SendData("{\"log\":\"Train: Playing Train sound\"}");
        isRestartMode = false;
        lastColorOk = false;
        lastFlickerOk = false;
        lastSoundOk = false;
        currentTrainStage = 0; // Сброс этапа при старте
        // --- Явно гасим все светодиоды ---
        for (int i = 0; i <= 8; i++) {
          ledMap[i] = CRGB::Black;
        }
        // Гасим leds1 (кожа и поезд)
        for (int i = 0; i < 4; i++) {
           leds1[i] = CRGB::Black;
        }
        // -------------------------------------------
        FastLED.show();

        for (int i = 0; i < 22; i++) {
          ActiveLeds[i] = -1;
          ClickLeds[i] = -1;
          FutureLeds[i] = i + 9;
        }
        ActiveLeds[4] = 12;
        state = 0;
        // FutureLeds[4] = -1;
        hintFlag = 1;
        hintPlayedAt = 0;
        mapClicksDisabled = false;
        isStartTrain = 0; // На всякий случай сбрасываем и это
		    trainEndConfirmed = false; // Сбрасываем флаг
        trainOnStartedAt = 0;      // 2026-08-07: чтобы сторож от прошлой игры
        story15StartedAt = 0;      // не выстрелил посреди новой
      }
      if (body == "\"volume_up\"") {
        value = value + 1;
        if (value >= 30) value = 30;
        myMP3.volume(value);
        Serial.println(value);
      }

      if (body == "\"volume_down\"") {
        value = value - 1;
        if (value <= 0) value = 0;
        myMP3.volume(value);
        Serial.println(value);
      }
      if (body.startsWith("\"set_level_")) {
    // Извлекаем число из строки "set_level_25"
    int startPos = body.indexOf('_', 6) + 1; // Находим позицию после второго '_'
    int endPos = body.lastIndexOf('"'); // Находим позицию закрывающей кавычки
    
    if (startPos > 0 && endPos > startPos) {
        String levelStr = body.substring(startPos, endPos);
        int newLevel = levelStr.toInt();
        
        // Проверяем корректность уровня (например, от 0 до 30)
        if (newLevel >= 0 && newLevel <= 30) {
            value = newLevel;
            myMP3.volume(value);
            Serial.print("Установлена громкость: ");
            Serial.println(value);

                // принудительно очищаем все активные светодиоды.
                // ПОЛНЫЙ СБРОС КАРТЫ (LEVEL 15)
                if (newLevel == 15) {
                   Serial.println("FORCE RESET: Full Map Reset");
                   
                   for (int i = 0; i < 22; i++) {
                      ActiveLeds[i] = -1;
                      ClickLeds[i] = -1;
                      DisableLeds[i] = -1; // [ВАЖНО] Очищаем "черные" светодиоды с прошлой игры
                      wasClickLed[i] = false;
                      
                      // Восстанавливаем карту: все светодиоды (9-30) становятся БЕЛЫМИ
                      FutureLeds[i] = i + 9; 
                   }
                   mapClicksDisabled = false;

                   // Настройка стартовой точки (как в команде start)
                   // Если стартовая точка это 12 (желтая), а остальные белые:
                   ActiveLeds[4] = 12; 
                   
                   // УБРАНА СТРОКА: FutureLeds[4] = -1; 
                   // Именно она выключала 13-й светодиод (индекс 4) полностью.
                   // Теперь 13-й останется белым (так как он есть в FutureLeds).
                   
                   state = 0; 
                   hintFlag = 1;
                   hintPlayedAt = 0;
                   trainEndConfirmed = false;
                   
                   FastLED.show(); 
                }
        } else {
            Serial.println("Некорректный уровень громкости");
        }
    }
}
      if (body == "\"language_1\"") {
        language = 1;
      }
      if (body == "\"language_2\"") {
        language = 2;
      }
      if (body == "\"language_3\"") {
        language = 3;
      }
      if (body == "\"language_4\"") {
        language = 4;
      }
      if (body == "\"language_5\"") {
        language = 5;
      }
      if (body == "\"language_6\"") {
        language = 6;
      }

      if (body == "\"ready\"") {
        OUTPUTS.digitalWrite(0, LOW);
        OUTPUTS.digitalWrite(1, LOW);
        for (int i = 0; i <= 3; i++) {
          leds1[i] = CRGB(0, 0, 0);
        }
        digitalWrite(TUNNEL_LED, LOW);
        digitalWrite(UF_LED, LOW);

        for (int i = 0; i < 22; i++) {
          ActiveLeds[i] = -1;
          DisableLeds[i] = -1;
          ClickLeds[i] = -1;
          FutureLeds[i] = -1;
        }
        state = 0;
        FastLED.show();
        hintFlag = 0;
        hintPlayedAt = millis();   // не молчать вечно, если история не доиграет
        mapClicksDisabled = false;
		    trainEndConfirmed = false; // Сбрасываем флаг
        ghostIgnoreStartTime = 0;
      }

      if (body == "\"projector\"") {
        // 2026-08-14 (просьба Эдуарда): вместе с этапом зажигаем свет потолка
        // (U6 P0 «LED CEILING»). Раньше его включала только команда
        // train_light_on в начале квеста, и если она терялась или свет успевали
        // погасить, комната к этапу поезда оставалась тёмной.
        OUTPUTS.digitalWrite(0, HIGH);
        // 14.08.2026: сразу история, без промежуточного train_on — см. случай
        // касания геркона выше.
        playStory15();
        ActiveLeds[0] = 9;
        ClickLeds[0] = -1;
        isStartTrain = 0;
        isSendOut = 1;
      }
      if (body == "\"ghost_knock\"") {
        myMP3.stop();
        delay(150);
        myMP3.playMp3Folder(TRACK_KNOCK);
        SendData("{\"log\":\"Train: Playing Knock sound\"}");
        ghostIgnoreStartTime = millis();
      }
      if (body == "\"skip\"") {
        state = 3;
        trainOnStartedAt = 0;   // 2026-08-07: этап скипнут, сторож цепочки снимаем
        story15StartedAt = 0;
        myMP3.stop();
        delay(50);
        myMP3.disableLoop();
        if (language == 1) {
          myMP3.playMp3Folder(TRACK_STORY_16_RU);
          SendData("{\"log\":\"Train: Playing Story 16 (RU)\"}");
        }
        if (language == 2) {
          myMP3.playMp3Folder(TRACK_STORY_16_EN);
          SendData("{\"log\":\"Train: Playing Story 16 (EN)\"}");
        }
        if (language == 3) {
          myMP3.playMp3Folder(TRACK_STORY_16_AR);
          SendData("{\"log\":\"Train: Playing Story 16 (AR)\"}");
        }
        if (language == 4) {
          myMP3.playMp3Folder(TRACK_STORY_16_FR);
          SendData("{\"log\":\"Train: Playing Story 16 (FR)\"}");
        }
        if (language == 5) {
          myMP3.playMp3Folder(TRACK_STORY_16_UK);
          SendData("{\"log\":\"Train: Playing Story 16 (UK)\"}");
        }
        if (language == 6) {
          myMP3.playMp3Folder(TRACK_STORY_16_PL);
          SendData("{\"log\":\"Train: Playing Story 16 (PL)\"}");
        }
        ActiveLeds[13] = 22; // активируем тролля
        // Зажигаем кожу (зеленым) сразу после поезда ---
        leds1[0] = CRGB(0, 128, 0);
        FastLED.show();
      }

      if (body == "\"restart\"") {
		    myMP3.stop();
        currentTrainStage = 0; // Сброс этапа при рестарте
        OUTPUTS.digitalWrite(0, HIGH);
        OUTPUTS.digitalWrite(1, HIGH);
        isRestartMode = true;
        lastColorOk = false;
        lastFlickerOk = false;
        lastSoundOk = false;

        // --- Очищаем обе ленты ---
        FastLED.clear(); 
        for (int i = 0; i < 4; i++) {
           leds1[i] = CRGB::Black;
        }
        // ------------------------------------

        isTrollEnd = 0;
        digitalWrite(TUNNEL_LED, HIGH);
        digitalWrite(UF_LED, HIGH);

        // --- Очищаем массив, так как анимация сама будет рисовать ---
        for (int i = 0; i < 22; i++) {
          ActiveLeds[i] = -1;
          ClickLeds[i] = -1;
          wasClickLed[i] = false;
          FutureLeds[i] = -1; // Это оставляем для логики игры, но визуально в state=0 будет работать анимация
        }
        
        state = 0; // Переход в режим ожидания (где будет анимация)
        hintFlag = 0;
        hintPlayedAt = millis();   // не молчать вечно, если история не доиграет
        
        enc1Pos = 0;
        enc2Pos = 0;
        hue = 40;  // 0-21845 (красный-зелёный)
        brightness = 255;
        prevMillis = 0;
        ledState = false;
        blinkInterval = 200;
        isGreen = false;         // Флаг зелёного цвета
        targetBrightness = 255;  // Целевая яркость
        fadeSpeed = 5;           // Скорость изменения яркости
        isLedOn = true;
        baseBrightness = 200;    // Базовая яркость
        flickerIntensity = 150;  // Сила мерцания (0-100)
        prevFlickerTime = 0;
        checkTrainTimer = 0;
        initialHue = 0;
        musicCounter = 0;
        musicFlag1 = 0;
        musicFlag2 = 0;
        musicFlag3 = 0;
        isTrainClick = false;
        isOwlClick = false;
        isKeyClick = false;
        isFishClick = false;
        isStartTimer = false;
        isStartTrain = false;
        trainOnStartedAt = 0;      // 2026-08-07: сторож цепочки train_on/story_15
        story15StartedAt = 0;
        isTrainEnd = false;
        isSkinPulsation = false;
        ghostFlag = false;
        isSendOut = false;
        mapState = "";
		trainEndConfirmed = false; // Сбрасываем флаг
        newStateAvailable = false;
        _secondsTimer = 0;
        _clockTimer = 0;
        _startTimer = 0;
        _timerEnabled = false;
        counter = 9;
        blinkLedNumber = -1;
        timerLedsCount = 0;
        timerIsStarting = true;

        enc1Last = 0;  // Предыдущая позиция энкодера 1
        enc2Last = 0;  // Предыдущая позиция энкодера 2

        fireworkActive = false;
        fireworkStartTime = 0;
        lightFlashTimer = 0;
        up = 0;
        light = 0;
        skinlightFlashTimer = 0;
        skinup = 0;
        skinlight = 0;
        ghostIgnoreStartTime = 0;
        skinReedLatched = false;
        lastSkinDebounceTime = 0;
        lastSkinSteadyState = false;
        skinState = false;
        mapClicksDisabled = false;
      }

      //

      if (body == "\"flag_on\"") {
        ActiveLeds[18] = -1;
        ActiveLeds[17] = -1;
        ActiveLeds[2] = -1;

        DisableLeds[18] = 27;
        DisableLeds[17] = 26;
        DisableLeds[2] = 11;

        FutureLeds[7] = -1;
        FutureLeds[5] = -1;
        FutureLeds[10] = -1;
        FutureLeds[14] = -1;

        DisableLeds[7] = -1;
        DisableLeds[5] = -1;
        DisableLeds[10] = -1;
        DisableLeds[14] = -1;

        ActiveLeds[7] = 16;
        ActiveLeds[5] = 14;
        ActiveLeds[10] = 19;
        ActiveLeds[14] = 23;
      }

      if (body == "\"flag_off\"") {
        FutureLeds[7] = 16;
        FutureLeds[5] = 14;
        FutureLeds[10] = 19;
        FutureLeds[14] = 23;

        ActiveLeds[7] = -1;
        ActiveLeds[5] = -1;
        ActiveLeds[10] = -1;
        ActiveLeds[14] = -1;
      }

      if (body == "\"stage_1\"") {
        // Принимаем команду только если мы еще не ушли дальше (на stage_2)
        if (currentTrainStage < 1) {
            currentTrainStage = 1;

        FutureLeds[7] = -1;
        FutureLeds[5] = -1;
        FutureLeds[10] = -1;
        FutureLeds[14] = -1;
        FutureLeds[9] = -1;

        ActiveLeds[7] = 16;
        ActiveLeds[5] = 14;
        ActiveLeds[10] = 19;
        ActiveLeds[14] = 23;
        ActiveLeds[9] = 18;
      } else {
            Serial.println("Ignored stage_1 command (already at stage " + String(currentTrainStage) + ")");
      }
    }


      if (body == "\"stage_2\"") {
        // Всегда принимаем stage_2, так как это повышение уровня
        currentTrainStage = 2;

        ActiveLeds[7] = -1;
        ActiveLeds[5] = -1;
        ActiveLeds[10] = -1;
        ActiveLeds[14] = -1;
        ActiveLeds[3] = -1;
        ActiveLeds[9] = -1;
        ActiveLeds[4] = -1;

        DisableLeds[7] = -1;
        DisableLeds[14] = -1;
        DisableLeds[5] = -1;
        DisableLeds[10] = -1;
        DisableLeds[3] = 12;
        DisableLeds[9] = 18;
        DisableLeds[4] = -1;

        FutureLeds[2] = -1;
        FutureLeds[17] = -1;
        FutureLeds[18] = -1;
        FutureLeds[4] = 12;

        FutureLeds[7] = 16;
        FutureLeds[5] = 14;
        FutureLeds[10] = 19;
        FutureLeds[14] = 23;

        ActiveLeds[2] = 11;
        ActiveLeds[17] = 26;
        ActiveLeds[18] = 27;

        ClickLeds[4] = -1;
      }

      if (body == "\"wolf_finish\"") {
        ActiveLeds[2] = -1;
        DisableLeds[2] = 11;
      }

      if (body == "\"safe_finish\"") {
        ActiveLeds[17] = -1;
        DisableLeds[17] = 26;
      }

      if (body == "\"case_finish\"") {
        ActiveLeds[18] = -1;
        DisableLeds[18] = 27;
      }

      if (body == "\"stage_3\"") {
        currentTrainStage = 3;
        // --- НОВЫЙ КОД: Принудительно убираем светодиоды из активных ---
        // Это гарантирует, что не будет конфликта с желтой пульсацией.
        // Мы очищаем те же ячейки, которые используются для этих светодиодов в других частях кода.
        ActiveLeds[0] = -1;  // Ячейка, иногда используемая для LED 9
        ActiveLeds[1] = -1;  // Ячейка, иногда используемая для LED 10
        ActiveLeds[15] = -1; // Ячейка, связанная с LED 24 (рыба)
        ActiveLeds[16] = -1; // Ячейка, связанная с LED 25 (ключ)

        // --- Старый код (остается без изменений) ---
        FutureLeds[0] = -1;
        FutureLeds[1] = -1;
        FutureLeds[16] = -1;
        FutureLeds[15] = -1;

        ClickLeds[0] = 9;
        ClickLeds[1] = 10;
        ClickLeds[16] = 25;
        ClickLeds[15] = 24;
        state = 1;
      }

      if (body == "\"owl_open\"") {
        DisableLeds[1] = 10;
        ActiveLeds[1] = -1;
        ClickLeds[1] = -1;
        isSendOut = 1;
        DisableLeds[10] = -1;
        ActiveLeds[10] = 19;
      }

      if (body == "\"key_open\"") {
        DisableLeds[16] = 25;
        ActiveLeds[16] = -1;
        ClickLeds[16] = -1;
        FutureLeds[16] = -1;
        isSendOut = 1;
        DisableLeds[7] = -1;
        ActiveLeds[7] = 16;
      }

      if (body == "\"fish_open\"") {
        Serial.println("Received fish_open command.");
        // Гасим LED рыбы (24)
        DisableLeds[15] = 24; // Индекс 15 -> LED 24
        ActiveLeds[15] = -1;  //
        ClickLeds[15] = -1;   //
        FutureLeds[15] = -1;  //

        // Активируем LED Комнаты Зелий (13)
        ActiveLeds[4] = 13;   // Индекс 4 -> LED 13
        FutureLeds[4] = -1;   // Убираем из будущих, если был
        DisableLeds[4] = -1;  // Убираем из неактивных, если был
        ClickLeds[4] = -1;    // Не кликабельный на этом этапе

        isSendOut = 1; //
      }
      if (body == "\"owl_finish\"") {

        DisableLeds[10] = 19;
        ActiveLeds[10] = -1;
      }
      if (body == "\"key_finish\"") {
        DisableLeds[7] = 16;
        ActiveLeds[7] = -1;
      }
      if (body == "\"fish_finish\"") {
        Serial.println("Received fish_finish command.");
        // Гасим LED Комнаты Зелий (13)
        DisableLeds[4] = 13;  // Индекс 4 -> LED 13
        ActiveLeds[4] = -1;   //
        ClickLeds[4] = -1;    // На всякий случай
        FutureLeds[4] = -1;   // На всякий случай
      }
      // --- ИЗМЕНЕНИЕ: Добавляем обработчик train_end, приходящий ИЗВНЕ ---
      // (Этот обработчик мог отсутствовать или быть неполным)
      if (body == "\"train_end\"") {
        Serial.println("log:tr:ext_end");
        DisableLeds[0] = 9;  // Гасим проектор
        ActiveLeds[0] = -1;
        ClickLeds[0] = -1;
        ActiveLeds[13] = 22; // Индекс 13 -> LED 22
        FutureLeds[13] = -1; // Убираем из будущих, если был
        DisableLeds[13] = -1;// Убираем из неактивных, если был
        ClickLeds[13] = -1;  // Не кликабельный

        digitalWrite(TUNNEL_LED, HIGH); // Включаем свет туннеля
        state = 3; // Переходим в состояние завершения поезда
        // Зажигаем кожу (зеленым) ---
        leds1[0] = CRGB(0, 128, 0);
        FastLED.show();
        trainEndSendTimer = millis(); // Начинаем отправку подтверждения, если нужно
      }
      // --- КОНЕЦ ИЗМЕНЕНИЯ ---
      if (body == "\"troll_finish\"") {
        Serial.println("log:tr:troll_fin");
        DisableLeds[13] = 22; // Индекс 13 -> LED 22
        ActiveLeds[13] = -1;  // Убираем его из активных
        ClickLeds[13] = -1;   // Убираем его из кликабельных
        FutureLeds[13] = -1;  // Убираем его из будущих
        isTrollEnd = 1;       // Устанавливаем флаг завершения игры с троллем
      }
      if (body == "\"stage_4\"") {
        ActiveLeds[13] = -1;
        ClickLeds[13] = -1;

        FutureLeds[6] = -1;
        ActiveLeds[6] = 15;
        state = 4;

        // Включаем статическое свечение кожи
        leds1[0] = CRGB(0, 128, 0); // Статический зеленый
        FastLED.show();
      }

      if (body == "\"stage_5\"") {
        DisableLeds[6] = 15;
        ActiveLeds[6] = -1;
        FutureLeds[6] = -1;

        FutureLeds[5] = -1;
        DisableLeds[5] = -1;
        ActiveLeds[5] = 14;
      }

      if (body == "\"stage_6\"") {
        FutureLeds[3] = -1;
        DisableLeds[3] = -1;
        ActiveLeds[3] = 12;


        DisableLeds[5] = 14;
        ActiveLeds[5] = -1;
        FutureLeds[5] = -1;
      }

      if (body == "\"stage_7\"") {

        // 1. Гасим предыдущий этап (Мастерская, LED 12)
        DisableLeds[3] = 12;
        ActiveLeds[3] = -1;

        // 2. Устанавливаем LED 21 (Библиотека) как БУДУЩИЙ (белый).
        FutureLeds[12] = 21; // Индекс 12 -> LED 21
        ActiveLeds[12] = -1; // Гарантированно убираем из активных
        DisableLeds[12] = -1;
        ClickLeds[12] = -1; // Не кликабельный

        // 3. Устанавливаем LED 20 (???) как АКТИВНЫЙ (желтый).
        ActiveLeds[11] = 20; // Индекс 11 -> LED 20
        FutureLeds[11] = -1; // Убираем из будущих
        DisableLeds[11] = -1; // Убираем из неактивных
        ClickLeds[11] = -1; // Не кликабельный

        state = 5; // Переводим контроллер в состояние игры с призраком

        // --- КОНЕЦ ИСПРАВЛЕНИЯ ---
      }

      if (body == "\"stage_8\"") {
      // 1. Устанавливаем LED 20 (индекс 11) как пройденный (выключаем)
        DisableLeds[11] = 20;
        ActiveLeds[11] = -1;
        FutureLeds[11] = -1;
        ClickLeds[11] = -1;

        // 2. Устанавливаем LED 17 (индекс 8) как АКТИВНЫЙ (желтый)
        ActiveLeds[8] = 17;
        FutureLeds[8] = -1;
        DisableLeds[8] = -1;
        ClickLeds[8] = -1;
      }

      if (body == "\"stage_9\"") {
        DisableLeds[14] = -1;
        FutureLeds[14] = -1;
        ActiveLeds[14] = 23;
      }

      if (body == "\"stage_10\"") {
        DisableLeds[12] = -1;
        FutureLeds[12] = -1;
        ActiveLeds[12] = 21;

        DisableLeds[14] = 23;
        FutureLeds[14] = -1;
        ActiveLeds[14] = -1;

        DisableLeds[8] = 17;
        FutureLeds[8] = -1;
        ActiveLeds[8] = -1;
      }

      if (body == "\"stage_11\"") {
        DisableLeds[12] = 21;
        FutureLeds[12] = -1;
        ActiveLeds[12] = -1;

        FutureLeds[3] = -1;
        DisableLeds[3] = -1;
        ActiveLeds[3] = 12;
      }

      if (body == "\"stage_12\"") {
        DisableLeds[12] = 21;
        ActiveLeds[12] = -1;
        FutureLeds[12] = -1;
        
        FutureLeds[3] = -1;
        DisableLeds[3] = 12;
        ActiveLeds[3] = -1;

        DisableLeds[14] = -1;
        FutureLeds[14] = -1;
        ActiveLeds[14] = 23;
      }

      if (body == "\"firework\"") {
        startFirework();
      }
      if (body == "\"train_light_off\"") {
        OUTPUTS.digitalWrite(0, LOW);
      }
      if (body == "\"train_light_on\"") {
        OUTPUTS.digitalWrite(0, HIGH);
      }
      if (body == "\"train_uf_light_on\"") {
        digitalWrite(UF_LED, HIGH);
        OUTPUTS.digitalWrite(0, LOW);
      }
      if (body == "\"train_uf_light_off\"") {
        digitalWrite(UF_LED, LOW);
      }
      if (body == "\"train_on\"") {
        myMP3.playMp3Folder(TRACK_TRAIN);
        SendData("{\"log\":\"Train: Playing Train sound\"}");
      }
      if (body == "\"item_find\"") {        
        // 1. Останавливаем пульсацию
        isSkinPulsation = 0;
        
        // 2. Включаем статическое свечение (возвращаем в состояние "доступен")
        leds1[0] = CRGB(0, 128, 0);
        FastLED.show();
      }
      if (body == "\"item_end\"") {
        leds1[0] = CRGB(0, 0, 0);
        FastLED.show();
        state++;
        isSkinPulsation = 0;
      }

      if (body == "\"set_time\"") {
        OUTPUTS.digitalWrite(1, HIGH);

        myMP3.stop(); // Останавливаем любой текущий звук
        delay(50);    // Даем плееру небольшую паузу
        
        if (language == 1) {
          myMP3.playMp3Folder(TRACK_STORY_45_RU);
          SendData("{\"log\":\"Train: Playing Story 45 (RU)\"}");
        }
        if (language == 2) {
          myMP3.playMp3Folder(TRACK_STORY_45_EN);
          SendData("{\"log\":\"Train: Playing Story 45 (EN)\"}");
        }
        if (language == 3) {
          myMP3.playMp3Folder(TRACK_STORY_45_AR);
          SendData("{\"log\":\"Train: Playing Story 45 (AR)\"}");
        }
        if (language == 4) {
          myMP3.playMp3Folder(TRACK_STORY_45_FR);
          SendData("{\"log\":\"Train: Playing Story 45 (FR)\"}");
        }
        if (language == 5) {
          myMP3.playMp3Folder(TRACK_STORY_45_UK);
          SendData("{\"log\":\"Train: Playing Story 45 (UK)\"}");
        }
        if (language == 6) {
          myMP3.playMp3Folder(TRACK_STORY_45_PL);
          SendData("{\"log\":\"Train: Playing Story 45 (PL)\"}");
        }
        // --- КОНЕЦ ДОБАВЛЕНИЯ ---
      }

      if (body == "\"day_on\"") {
        OUTPUTS.digitalWrite(0, HIGH);
        for (int i = 1; i <= 3; i++) {
          leds1[i] = CRGB(255, 255, 255);
        }
        digitalWrite(TUNNEL_LED, HIGH);
        FastLED.show();
      }

      if (body == "\"day_off\"") {
        OUTPUTS.digitalWrite(0, LOW);
        for (int i = 0; i <= 3; i++) {
          leds1[i] = CRGB(0, 0, 0);
        }
        digitalWrite(TUNNEL_LED, LOW);
        FastLED.show();
      }

      if (body == "\"ghost_game\"") {
        myMP3.stop();
        delay(50);
        myMP3.disableLoop();               // Сначала выключаем повтор
        myMP3.playMp3Folder(TRACK_GHOST);  // Запускаем трек
        SendData("{\"log\":\"Train: Playing Ghost sound\"}");
        myMP3.enableLoop();                // Включаем повтор для текущего трека
        ghostFlag = 1;
        // Запускаем 3-секундный таймер игнорирования ЗДЕСЬ,
        // чтобы GhostGame() начал отсчет времени (для защиты от вибрации самого плеера).
        ghostIgnoreStartTime = millis();
      }
      if (body == "\"ghost_game_end\"") {
        ghostFlag = 0;
        myMP3.stop();
      }
      Serial.println("Received POST: " + body);

// --- НАЧАЛО ИЗМЕНЕНИЙ: Обработчики новых команд ---
      if (body == "\"map_disable_clicks\"") {
        Serial.println("log:tr:dis_click");
if (!mapClicksDisabled) { // Предотвращаем повторное выполнение
          for (int i = 0; i < 22; i++) {
            if (ClickLeds[i] != -1) {
              FutureLeds[i] = ClickLeds[i];
// Перемещаем в Future (белый)
              ClickLeds[i] = -1;
// Очищаем Click (фиол-голуб)
              
              // Помечаем, что этот LED был в Click ---
              wasClickLed[i] = true;

            } else {

              // Убеждаемся, что флаг сброшен для остальных ---
              wasClickLed[i] = false;
            }
          }
          mapClicksDisabled = true;
ResetTimer(); // Гасим светодиоды таймера и сбрасываем его состояние
          isStartTimer = false;
// Отключаем таймер во время паузы
          blinkLedNumber = -1;
// Сбрасываем мигающий LED
        }
      }
      else if (body == "\"map_enable_clicks\"") {
        Serial.println("log:tr:en_click");
if (mapClicksDisabled) { // Восстанавливаем только если были отключены
            
            for (int i = 0; i < 22; i++){
                // Проверяем, был ли этот LED отмечен в нашей "памяти"
                if (wasClickLed[i]) {
                    
                    // Дополнительная проверка: восстанавливаем, только если он 
                    // все еще числится в Future (белый)
                    if (FutureLeds[i] != -1) {
                        // Восстанавливаем его в Clickable
                        ClickLeds[i] = FutureLeds[i];
                        // Убираем из Future
                        FutureLeds[i] = -1;
                    }
                    
                    // Сбрасываем флаг "памяти", так как мы его обработали
                    wasClickLed[i] = false;
                }
                // ВАЖНО: Если wasClickLed[i] был false, мы ничего не делаем.
                // Это значит, что светодиоды, которые были в FutureLeds,
                // но не были в ClickLeds (например, LED 21 из stage_7),
                // останутся в FutureLeds (белыми), как и должны.
            }

            mapClicksDisabled = false;
        }
      }
      server.send(200, "application/json", "{\"status\":\"received\"}");
    } else {
      server.send(400, "text/plain", "Bad Request");
    }
  });

  server.begin();
  Serial.println("HTTP server started");
  // --- НАСТРОЙКА OTA  ---
  ArduinoOTA.setHostname("Train-ESP32"); // Имя устройства в сети
  
  ArduinoOTA.onStart([]() {
    String type = (ArduinoOTA.getCommand() == U_FLASH) ? "sketch" : "filesystem";
    // Отключаем все моторы/светодиоды для безопасности
    Serial.println("Start updating " + type);
    // Можно добавить сюда выключение strip.clear()
  });
  ArduinoOTA.onEnd([]() {
    Serial.println("\nEnd");
  });
  ArduinoOTA.onProgress([](unsigned int progress, unsigned int total) {
    // Можно мигать светодиодом, но необязательно
  });
  ArduinoOTA.onError([](ota_error_t error) {
    Serial.printf("Error[%u]: ", error);
    if (error == OTA_AUTH_ERROR) Serial.println("Auth Failed");
    else if (error == OTA_BEGIN_ERROR) Serial.println("Begin Failed");
    else if (error == OTA_CONNECT_ERROR) Serial.println("Connect Failed");
    else if (error == OTA_RECEIVE_ERROR) Serial.println("Receive Failed");
    else if (error == OTA_END_ERROR) Serial.println("End Failed");
  });

  ArduinoOTA.begin();
  Serial.println("OTA Ready");
  // ---------------------------------------------
}

void pauseEncoders() {
  detachInterrupt(33); detachInterrupt(25);
  detachInterrupt(35); detachInterrupt(32);
  detachInterrupt(39); detachInterrupt(34);
}

void resumeEncoders() {
  attachInterrupt(33, isrEnc1, CHANGE); attachInterrupt(25, isrEnc1, CHANGE);
  attachInterrupt(35, isrEnc2, CHANGE); attachInterrupt(32, isrEnc2, CHANGE);
  attachInterrupt(39, isrEnc3, CHANGE); attachInterrupt(34, isrEnc3, CHANGE);
}

void loop() {
  // OTA и HTTP-сервер должны работать в любом режиме
  ArduinoOTA.handle();
  server.handleClient();

  // 2026-08-03: watchdog потери WiFi (перенесён из safe.ino, где работает в
  // проде). Раньше здесь был голый reconnect + delay(2000): если переподключение
  // не удавалось, устройство висело в этом цикле бесконечно и само не
  // восстанавливалось — требовалось снятие питания башни вручную (кейс Волка
  // 29.07 и Поезда 03.08). Плюс delay(2000) блокировал loop целиком.
  // Теперь: попытка reconnect не чаще раза в 10 сек, а если связи нет дольше
  // 60 сек — перезагружаем ESP32, она поднимется и подключится заново.
  {
    static unsigned long lastReconnectAttempt = 0;
    static unsigned long wifiDownSince = 0;
    if (WiFi.status() != WL_CONNECTED) {
      if (wifiDownSince == 0) wifiDownSince = millis();
      if (millis() - lastReconnectAttempt > 10000UL) {
        lastReconnectAttempt = millis();
        Serial.println("WiFi lost — reconnecting");
        WiFi.reconnect();
      }
      if (millis() - wifiDownSince > 60000UL) {
        Serial.println("WiFi down >60s — restarting ESP32");
        delay(500);
        ESP.restart();
      }
    } else {
      wifiDownSince = 0;   // соединение в порядке
    }
  }

  // === DIAG MODE: ранний выход, игнорируем всю игровую логику ===
  if (diagModeActive) {
    // Энкодеры: считаем тики (для отображения в UI)
    if (enc1.isLeft())  diagEnc1--;
    if (enc1.isRight()) diagEnc1++;
    if (enc2.isLeft())  diagEnc2--;
    if (enc2.isRight()) diagEnc2++;
    if (enc3.isLeft())  diagEnc3--;
    if (enc3.isRight()) diagEnc3++;

    // Snapshot каждые 200ms
    if (millis() - diagLastSnapshot >= DIAG_SNAPSHOT_INTERVAL) {
      diagLastSnapshot = millis();
      sendDiagSnapshot();
    }
    return;  // никакой игровой логики
  }
  // === END DIAG ===

  // 2026-08-05: убраны блокирующие SendData() из диагностики pin1-переходов
  // (была добавлена 5 июня для расследования латч-бага, задачу выполнила).
  // ПРИЧИНА УДАЛЕНИЯ: SendData() — блокирующий HTTP POST (http.setTimeout(100)),
  // и эти логи вызывались КАЖДЫЙ раз при переходе pin1, ДО проверки условия
  // в case 1 (несколькими строками ниже по вызову MapGerkon()). При коротком
  // касании геркона (быстрый тап) могло набежать до 4 блокирующих вызовов
  // подряд (HIGH→LOW + latch=TRUE + LOW→HIGH + latch=FALSE, до ~400мс суммарно)
  // — за это время геркон уже отпускали, и case 1 видел pin1=HIGH, пропуская
  // срабатывание. Симптом клиента 04.08: тронул map, через 2 сек тронул
  // projector — ничего не произошло, потребовался ручной skip с пульта.
  // Логика trainSensorLatched (используется в другом месте кода) сохранена,
  // просто без сетевых вызовов на каждый чих.
  bool currPin1State = INPUTS.digitalRead(1);
  if (!currPin1State) {
      trainSensorLatched = true;
  }
  handlePlayerQueries();
  TrainIntroWatchdog();   // 2026-08-07: страховка на потерянные события DFPlayer
  MapGerkon();
  MapLeds();
  StartTimer();
  TrainHeadlightHint();   // подсветка прожектора, пока идёт таймер карты

  static unsigned long debugTimer = 0;
  if (millis() - debugTimer > 1000) {
      debugTimer = millis();
      // Читаем весь байт портов
      // К сожалению, библиотека Adafruit_PCF8574 не дает прочитать весь байт сразу легко,
      // поэтому читаем пины.
      Serial.print("DEBUG INPUTS: ");
      for(int i=0; i<8; i++) {
          Serial.print(INPUTS.digitalRead(i));
          Serial.print(" ");
      }
      Serial.println();
  }

  // Страховка: событие «трек доиграл» от DFPlayer могло потеряться, а на нём
  // держится возврат hintFlag в единицу.
  if (!hintFlag && hintPlayedAt != 0 && millis() - hintPlayedAt > HINT_REARM_MS) {
    hintFlag = 1;
    hintPlayedAt = 0;
  }

  // 2026-08-07: подсказка не должна перебивать вступление этапа поезда.
  // myMP3.pause() + новый трек убивают TRACK_TRAIN_ON или STORY_15, а вместе
  // с ними и событие «трек доиграл», на котором держится запуск игры. Раньше
  // это вешало этап намертво; теперь его вытащит TrainIntroWatchdog(), но
  // ждать 60 секунд игроку незачем — проще не дать перебить.
  // Клиент 06.08 впервые проходил карту начиная с поезда: вступление играет,
  // а игроки уже вернулись к карте и тыкают палочкой по остальным символам.
  bool trainIntroPlaying = (trainOnStartedAt != 0 || story15StartedAt != 0);
  if (!INPUTS.digitalRead(2) && !ghostFlag && !trainIntroPlaying) {
    if ((state == 0 || state == 1) && hintFlag) {
      myMP3.pause();  // Ставим фоновую музыку на паузу
	  resumeEngineSound = true;
      delay(50);
      if (language == 1) {
        myMP3.playMp3Folder(TRACK_HINT_0_RU);
        SendData("{\"log\":\"Train: Playing Hint 0 (RU)\"}");
      }
      if (language == 2) {
        myMP3.playMp3Folder(TRACK_HINT_0_EN);
        SendData("{\"log\":\"Train: Playing Hint 0 (EN)\"}");
      }
      if (language == 3) {
        myMP3.playMp3Folder(TRACK_HINT_0_AR);
        SendData("{\"log\":\"Train: Playing Hint 0 (AR)\"}");
      }
      if (language == 4) {
        myMP3.playMp3Folder(TRACK_HINT_0_FR);
        SendData("{\"log\":\"Train: Playing Hint 0 (FR)\"}");
      }
      if (language == 5) {
        myMP3.playMp3Folder(TRACK_HINT_0_UK);
        SendData("{\"log\":\"Train: Playing Hint 0 (UK)\"}");
      }
      if (language == 6) {
        myMP3.playMp3Folder(TRACK_HINT_0_PL);
        SendData("{\"log\":\"Train: Playing Hint 0 (PL)\"}");
      }
      hintFlag = 0;
      hintPlayedAt = millis();
    }
    else if (state > 0 && state < 3 && hintFlag) {
      myMP3.pause();  // Ставим фоновую музыку на паузу
	  resumeEngineSound = true;
      delay(50);
      Serial.println(hint_counter);
      if (hint_counter == 0) {
        if (language == 1) {
          myMP3.playMp3Folder(TRACK_HINT_1_RU);
          SendData("{\"log\":\"Train: Playing Hint 1 (RU)\"}");
        }
        if (language == 2) {
          myMP3.playMp3Folder(TRACK_HINT_1_EN);
          SendData("{\"log\":\"Train: Playing Hint 1 (EN)\"}");
        }
        if (language == 3) {
          myMP3.playMp3Folder(TRACK_HINT_1_AR);
          SendData("{\"log\":\"Train: Playing Hint 1 (AR)\"}");
        }
        if (language == 4) {
          myMP3.playMp3Folder(TRACK_HINT_1_FR);
          SendData("{\"log\":\"Train: Playing Hint 1 (FR)\"}");
        }
        if (language == 5) {
          myMP3.playMp3Folder(TRACK_HINT_1_UK);
          SendData("{\"log\":\"Train: Playing Hint 1 (UK)\"}");
        }
        if (language == 6) {
          myMP3.playMp3Folder(TRACK_HINT_1_PL);
          SendData("{\"log\":\"Train: Playing Hint 1 (PL)\"}");
        }
      }
      if (hint_counter == 1) {
        if (language == 1) {
          myMP3.playMp3Folder(TRACK_HINT_2_RU);
          SendData("{\"log\":\"Train: Playing Hint 2 (RU)\"}");
        }
        if (language == 2) {
          myMP3.playMp3Folder(TRACK_HINT_2_EN);
          SendData("{\"log\":\"Train: Playing Hint 2 (EN)\"}");
        }
        if (language == 3) {
          myMP3.playMp3Folder(TRACK_HINT_2_AR);
          SendData("{\"log\":\"Train: Playing Hint 2 (AR)\"}");
        }
        if (language == 4) {
          myMP3.playMp3Folder(TRACK_HINT_2_FR);
          SendData("{\"log\":\"Train: Playing Hint 2 (FR)\"}");
        }
        if (language == 5) {
          myMP3.playMp3Folder(TRACK_HINT_2_UK);
          SendData("{\"log\":\"Train: Playing Hint 2 (UK)\"}");
        }
        if (language == 6) {
          myMP3.playMp3Folder(TRACK_HINT_2_PL);
          SendData("{\"log\":\"Train: Playing Hint 2 (PL)\"}");
        }
      }
      if (hint_counter == 2) {
        if (language == 1) {
          myMP3.playMp3Folder(TRACK_HINT_3_RU);
          SendData("{\"log\":\"Train: Playing Hint 3 (RU)\"}");
        }
        if (language == 2) {
          myMP3.playMp3Folder(TRACK_HINT_3_EN);
          SendData("{\"log\":\"Train: Playing Hint 3 (EN)\"}");
        }
        if (language == 3) {
          myMP3.playMp3Folder(TRACK_HINT_3_AR);
          SendData("{\"log\":\"Train: Playing Hint 3 (AR)\"}");
        }
        if (language == 4) {
          myMP3.playMp3Folder(TRACK_HINT_3_FR);
          SendData("{\"log\":\"Train: Playing Hint 3 (FR)\"}");
        }
        if (language == 5) {
          myMP3.playMp3Folder(TRACK_HINT_3_UK);
          SendData("{\"log\":\"Train: Playing Hint 3 (UK)\"}");
        }
        if (language == 6) {
          myMP3.playMp3Folder(TRACK_HINT_3_PL);
          SendData("{\"log\":\"Train: Playing Hint 3 (PL)\"}");
        }
      }
      if (hint_counter == 3) {
        if (language == 1) {
          myMP3.playMp3Folder(TRACK_HINT_4_RU);
          SendData("{\"log\":\"Train: Playing Hint 4 (RU)\"}");
        }
        if (language == 2) {
          myMP3.playMp3Folder(TRACK_HINT_4_EN);
          SendData("{\"log\":\"Train: Playing Hint 4 (EN)\"}");
        }
        if (language == 3) {
          myMP3.playMp3Folder(TRACK_HINT_4_AR);
          SendData("{\"log\":\"Train: Playing Hint 4 (AR)\"}");
        }
        if (language == 4) {
          myMP3.playMp3Folder(TRACK_HINT_4_FR);
          SendData("{\"log\":\"Train: Playing Hint 4 (FR)\"}");
        }
        if (language == 5) {
          myMP3.playMp3Folder(TRACK_HINT_4_UK);
          SendData("{\"log\":\"Train: Playing Hint 4 (UK)\"}");
        }
        if (language == 6) {
          myMP3.playMp3Folder(TRACK_HINT_4_PL);
          SendData("{\"log\":\"Train: Playing Hint 4 (PL)\"}");
        }
      }
      hintFlag = 0;
      hintPlayedAt = millis();
      hint_counter++;
      if (hint_counter > 3) {
        hint_counter = 0;
      }
    }
    else if (isTrollEnd && hintFlag) {
      if (language == 1) {
        myMP3.playMp3Folder(TRACK_HINT_7_RU);
        SendData("{\"log\":\"Train: Playing Hint 7 (RU)\"}");
      }
      if (language == 2) {
        myMP3.playMp3Folder(TRACK_HINT_7_EN);
        SendData("{\"log\":\"Train: Playing Hint 7 (EN)\"}");
      }
      if (language == 3) {
        myMP3.playMp3Folder(TRACK_HINT_7_AR);
        SendData("{\"log\":\"Train: Playing Hint 7 (AR)\"}");
      }
      if (language == 4) {
        myMP3.playMp3Folder(TRACK_HINT_7_FR);
        SendData("{\"log\":\"Train: Playing Hint 7 (FR)\"}");
      }
      if (language == 5) {
        myMP3.playMp3Folder(TRACK_HINT_7_UK);
        SendData("{\"log\":\"Train: Playing Hint 7 (UK)\"}");
      }
      if (language == 6) {
        myMP3.playMp3Folder(TRACK_HINT_7_PL);
        SendData("{\"log\":\"Train: Playing Hint 7 (PL)\"}");
      }
      hintFlag = 0;
      hintPlayedAt = millis();
    }
    else if (state >= 3 && hintFlag && !isTrollEnd) {
      if (hint_counter == 0) {
        if (language == 1) {
          myMP3.playMp3Folder(TRACK_HINT_5_RU);
          SendData("{\"log\":\"Train: Playing Hint 5 (RU)\"}");
        }
        if (language == 2) {
          myMP3.playMp3Folder(TRACK_HINT_5_EN);
          SendData("{\"log\":\"Train: Playing Hint 5 (EN)\"}");
        }
        if (language == 3) {
          myMP3.playMp3Folder(TRACK_HINT_5_AR);
          SendData("{\"log\":\"Train: Playing Hint 5 (AR)\"}");
        }
        if (language == 4) {
          myMP3.playMp3Folder(TRACK_HINT_5_FR);
          SendData("{\"log\":\"Train: Playing Hint 5 (FR)\"}");
        }
        if (language == 5) {
          myMP3.playMp3Folder(TRACK_HINT_5_UK);
          SendData("{\"log\":\"Train: Playing Hint 5 (UK)\"}");
        }
        if (language == 6) {
          myMP3.playMp3Folder(TRACK_HINT_5_PL);
          SendData("{\"log\":\"Train: Playing Hint 5 (PL)\"}");
        }
      }
      if (hint_counter == 1) {
        if (language == 1) {
          myMP3.playMp3Folder(TRACK_HINT_6_RU);
          SendData("{\"log\":\"Train: Playing Hint 6 (RU)\"}");
        }
        if (language == 2) {
          myMP3.playMp3Folder(TRACK_HINT_6_EN);
          SendData("{\"log\":\"Train: Playing Hint 6 (EN)\"}");
        }
        if (language == 3) {
          myMP3.playMp3Folder(TRACK_HINT_6_AR);
          SendData("{\"log\":\"Train: Playing Hint 6 (AR)\"}");
        }
        if (language == 4) {
          myMP3.playMp3Folder(TRACK_HINT_6_FR);
          SendData("{\"log\":\"Train: Playing Hint 6 (FR)\"}");
        }
        if (language == 5) {
          myMP3.playMp3Folder(TRACK_HINT_6_UK);
          SendData("{\"log\":\"Train: Playing Hint 6 (UK)\"}");
        }
        if (language == 6) {
          myMP3.playMp3Folder(TRACK_HINT_6_PL);
          SendData("{\"log\":\"Train: Playing Hint 6 (PL)\"}");
        }
      }
      hintFlag = 0;
      hintPlayedAt = millis();
      hint_counter++;
      if (hint_counter > 1) {
        hint_counter = 0;
      }
    }
  }

  if (fireworkActive) {
    handleFirework();
  } else {
    switch (state) {
      case 0:
        if (isRestartMode) {
           HandleLoadingAnimation(); 
        }
        break;
      case 1:
        // --- ДИАГНОСТИКА ПОБЕДЫ ---
        if (!INPUTS.digitalRead(1)) {
            Serial.print("log:tr:chk: ");
            Serial.print("P1=0|");
            Serial.print("map=");
            Serial.print(mapState);
            if (mapState == "train") Serial.print("(OK)|");
            else Serial.print("(FL)|");
            
            Serial.print("STr=");
            Serial.print(isStartTrain);
            if (isStartTrain == 0) Serial.print("(OK)"); 
            else Serial.print("(FL)");
            
            Serial.println();
            delay(200);
        }
        // -------------------------------------

        // 2026-06-05 (Эдуард 5 июня): УБРАН latch trainSensorLatched.
        // Раньше условие было: `(!digitalRead(1) || latch) && map="train" && !isStartTrain`.
        // Проблема: латч ставился в TRUE при любом spike LOW (шум, network glitch,
        // rebrooot и т.д.), оставался TRUE навсегда до consumption. Игрок касался
        // map → mapState="train" → авто-trigger projector:end СРАЗУ без касания
        // projector. Симптом стабильно воспроизводился у Эдуарда даже после
        // отключения провода projector и обратного подключения.
        //
        // Фикс: требуем pin1 LIVE LOW в момент check'a. Игрок должен физически
        // ДЕРЖАТЬ магнит на projector-герконе в момент когда case 1 проверяет.
        // Это правильный flow: коснулся map → дошёл до башни Train (5-10 сек) →
        // коснулся projector → condition fires в этот момент.
        if (!INPUTS.digitalRead(1) && mapState == "train" && !isStartTrain) {
          // DIAG: подтверждаем что pin1 LIVE LOW в момент срабатывания
          SendData("{\"log\":\"Train DIAG: CONDITION FIRED — pin1=LOW (live), mapState=train, isStartTrain=0\"}");
          Serial.println("Train click detected!");
          // 14.08.2026: отдельный трек train_on больше не играем — его звук
          // Эдуард положил в начало самих файлов story_15. Раньше цепочка была
          // train_on → (событие «доиграл») → story_15, и на потерянном событии
          // она вставала: между двумя треками появлялась дыра на все секунды
          // сторожа. Одним треком терять нечего.
          playStory15();

          // 2026-08-07: этап поезда начался — таймер карты больше не нужен.
          // Раньше он досчитывал свои 9 секунд и сбрасывал state в 0 прямо
          // во время вступительной истории (в лог при этом ничего не шло,
          // т.к. isSendOut=1 глушит {"map":"out"}). Само по себе это игру не
          // ломало, но открывало ветку подсказки по кнопке для state==0,
          // а подсказка обрывает трек и вместе с ним всю цепочку.
          // ВАЖНО: ResetTimer() обнуляет isStartTrain/isSendOut, поэтому
          // вызываем его ДО того, как выставим эти флаги.
          isStartTimer = false;
          ResetTimer();

          // Местная индикация сразу
          ActiveLeds[0] = 9;
          ClickLeds[0] = -1;
          isStartTrain = 1;
          isSendOut = 1;
          isTrainClick = true;   // ResetTimer() снял флаг — возвращаем, как было до таймаута
          trainSensorLatched = false;

          // --- Отправляем команду на сервер (3 раза для надежности) ---
          for (int k=0; k<3; k++) { 
             SendData("{\"projector\":\"end\"}");
             delay(50);
          }
          SendData("{\"log\":\"Train: Projector commands sent (Force)\"}");
        }
        break;
      case 2:
        TrainGame();
        break;
      case 3:
        // Пока не получим подтверждение от сервера, отправляем сообщение раз в секунду
        if (!trainEndConfirmed) {
          if (millis() - trainEndSendTimer > 1000) { // Интервал отправки - 1 секунда
            SendData("{\"train\":\"end\"}");
            trainEndSendTimer = millis(); // Сбрасываем таймер
          }
        }

        // Этот код для анимации светодиодов будет работать постоянно, пока state = 3
        FutureLeds[13] = -1;
        DisableLeds[0] = 9;
        ActiveLeds[0] = -1;
        ClickLeds[0] = -1;
        digitalWrite(TUNNEL_LED, HIGH);
        for (int i = 1; i < 4; i++) {
          leds1[i] = CHSV(initialHue + (i * 7), 255, 255);
        }
        EVERY_N_MILLISECONDS(30) {
          FastLED.show();
          initialHue++;
        }
        break;
      case 4:
        WorkshopGame();
        break;
      case 5:
        GhostGame();
        break;
    }
    // --- ГЛОБАЛЬНОЕ БЕЗОПАСНОЕ ОБНОВЛЕНИЕ СВЕТОДИОДОВ ---
    static unsigned long mainLedTimer = 0;
    // Обновляем не чаще раз в 30 мс
    if (millis() - mainLedTimer > 30) {
       mainLedTimer = millis();
       
       // 1. АППАРАТНО отключаем прерывания энкодеров, чтобы не было прыжков процессора
       pauseEncoders(); 
       
       // 2. Отправляем данные на ленту (никто нас не прервет)
       FastLED.show();
       
       // 3. Возвращаем прерывания на место
       resumeEncoders(); 
    }
    // ----------------------------------------------------
  }
}



void MapGerkon() {
  // --- Не обрабатываем герконы, если клики отключены ---
    if (mapClicksDisabled) {
        // Если клики отключены, сбрасываем состояние таймера и мигания, если они были активны
        if (isStartTimer) {
             isStartTimer = false;
             blinkLedNumber = -1;
             timerLedsCount = 0;
             timerIsStarting = true;
             // Возможно, нужно погасить светодиоды таймера
             ResetTimer(); // Используем существующую функцию сброса
        }
        return; // Выходим из функции
    }
    if (!INPUTS.digitalRead(1)) {
      Serial.println("log:tr:pin1_press");
    }

  bool keyLedActive = false;
  bool fishLedActive = false;
  bool owlLedActive = false;
  bool trainLedActive = false;

  for (int i = 0; i <= 20; i++) {
    if (ClickLeds[i] == 25) keyLedActive = true;   // Светодиод для ключа
    if (ClickLeds[i] == 24) fishLedActive = true;  // Светодиод для рыбы
    if (ClickLeds[i] == 10) owlLedActive = true;   // Светодиод для совы
    if (ClickLeds[i] == 9) trainLedActive = true;  // Светодиод для поезда
  }

  if (isStartTimer) {
    if (!INPUTS.digitalRead(6) && keyLedActive && !isKeyClick) {
      ResetTimer();
      isSendOut = 0;
      mapState = "key";
      isStartTimer = true;
      SendData("{\"map\":\"key\"}");
      Serial.println("key");
      isKeyClick = true;
      isFishClick = false;
      isOwlClick = false;
      isTrainClick = false;
      blinkLedNumber = 25;
    }

    if (!INPUTS.digitalRead(5) && fishLedActive && !isFishClick) {
      ResetTimer();
      isSendOut = 0;
      mapState = "fish";
      isStartTimer = true;
      SendData("{\"map\":\"fish\"}");
      isFishClick = true;
      isKeyClick = false;
      isOwlClick = false;
      isTrainClick = false;
      Serial.println("fish");
      blinkLedNumber = 24;
    }

    if (!INPUTS.digitalRead(3) && owlLedActive && !isOwlClick) {
      ResetTimer();
      isSendOut = 0;
      mapState = "owl";
      isStartTimer = true;
      SendData("{\"map\":\"owl\"}");
      isFishClick = false;
      isKeyClick = false;
      isTrainClick = false;
      isOwlClick = true;
      Serial.println("owl");
      blinkLedNumber = 10;
    }

    if (!INPUTS.digitalRead(4) && trainLedActive && !isTrainClick) {
      // 2026-06-05 DIAG: логируем состояние pin1 в момент map-касания
      {
          String diagMsg = "{\"log\":\"Train DIAG: MAP train touched — pin1=";
          diagMsg += INPUTS.digitalRead(1) ? "HIGH" : "LOW";
          diagMsg += ", latch BEFORE reset=";
          diagMsg += trainSensorLatched ? "TRUE" : "FALSE";
          diagMsg += "\"}";
          SendData(diagMsg);
      }
      ResetTimer();
	  trainSensorLatched = false; // Сброс памяти
      isSendOut = 0;
      mapState = "train";
      isStartTimer = true;
      SendData("{\"map\":\"train\"}");
      state = 1;
      isStartTrain = 0;
      isFishClick = false;
      isOwlClick = false;
      isKeyClick = false;
      isTrainClick = true;
      Serial.println("train");
      blinkLedNumber = 9;
    }
    return;  // Выходим, если таймер уже активен
  }

  // Если таймер не активен, проверяем нажатия только на АКТИВНЫЕ герконы
  if (!INPUTS.digitalRead(6) && keyLedActive) {
    if (!isKeyClick) {
      mapState = "key";
      isSendOut = 0;
      isStartTimer = true;
      SendData("{\"map\":\"key\"}");
      Serial.println("key");
      isKeyClick = true;
      isFishClick = false;
      isOwlClick = false;
      isTrainClick = false;
      blinkLedNumber = 25;
    }
  }

  if (!INPUTS.digitalRead(5) && fishLedActive) {
    if (!isFishClick) {
      mapState = "fish";
      isSendOut = 0;
      isStartTimer = true;
      SendData("{\"map\":\"fish\"}");
      isFishClick = true;
      isKeyClick = false;
      isOwlClick = false;
      isTrainClick = false;
      Serial.println("fish");
      blinkLedNumber = 24;
    }
  }

  if (!INPUTS.digitalRead(3) && owlLedActive) {
    if (!isOwlClick) {
      mapState = "owl";
      isSendOut = 0;
      isStartTimer = true;
      SendData("{\"map\":\"owl\"}");
      isFishClick = false;
      isKeyClick = false;
      isTrainClick = false;
      isOwlClick = true;
      Serial.println("owl");
      blinkLedNumber = 10;
    }
  }

  if (!INPUTS.digitalRead(4) && trainLedActive) {
    if (!isTrainClick) {
      // 2026-06-26: добавлены state=1 + isStartTrain=0 для симметрии с веткой
      // выше (line ~1969). Без них при ПЕРВОМ касании map (когда таймер ещё
      // не активен) state остаётся 0 → case 1 в loop не выполняется →
      // condition projector (line ~1805) недостижим → касание projector-
      // геркона на башне не приводит к {"projector":"end"}. Симптом у клиента
      // 26 июня: касается карты, потом projector, ничего не происходит, через
      // 11 сек map:out. Скип через /pult выручил.
      mapState = "train";
      isSendOut = 0;
      isStartTimer = true;
      SendData("{\"map\":\"train\"}");
      state = 1;
      isStartTrain = 0;
      trainSensorLatched = false;
      isFishClick = false;
      isOwlClick = false;
      isKeyClick = false;
      isTrainClick = true;
      Serial.println("train");
      blinkLedNumber = 9;
    }
  }
}

// Новая функция для проверки, находится ли светодиод в списке активных
bool isLedActive(int ledNumber) {
  for (int i = 0; i < 22; i++) {
    if (ActiveLeds[i] == ledNumber) {
      return true; // Да, светодиод активен
    }
  }
  return false; // Нет, не активен
}

// ---- Фара поезда подсказывает, куда идти (14.08.2026, просьба Эдуарда) ----
// Игрок коснулся поезда на карте — у него девять секунд таймера, чтобы дойти до
// башни и коснуться палочкой прожектора. Всё это время светодиод в самом
// прожекторе мягко пульсирует оранжевым: видно, куда именно тыкать. Таймер
// вышел или этап начался — гаснет, дальше лентой распоряжается игра.
// Какой из трёх светодиодов поезда стоит в фаре, на глаз не определить, поэтому
// номер вынесен в константу: leds1[1..3] — это те же три, что зажигает кнопка
// «Поезд оранжевый» в диагностике.
const int TRAIN_HEADLIGHT_LED = 3;   // 14.08: второй не угадали, пробуем третий

void TrainHeadlightHint() {
  static bool active = false;
  static unsigned long lastFrame = 0;
  bool want = (isStartTimer && mapState == "train");

  if (want) {
    if (millis() - lastFrame < 30) return;   // ~30 кадров в секунду достаточно
    lastFrame = millis();
    active = true;
    uint8_t v = beatsin8(60, 12, 255);       // плавная волна, полный цикл ~2 с
    leds1[TRAIN_HEADLIGHT_LED] = CRGB(v, (uint8_t)((v * 42) / 100), 0);  // оранжевый
    FastLED.show();
  } else if (active) {
    active = false;
    leds1[TRAIN_HEADLIGHT_LED] = CRGB::Black;
    FastLED.show();
  }
}

void MapLeds() {
  // --- Логика для пульсации ЖЕЛТЫХ светодиодов (ActiveLeds) ---
  static unsigned long lastPulsateTime = 0;
  static int pulsatingBrightness = 100;
  static bool fadeUp = true;
  if (millis() - lastPulsateTime > 15) {
    lastPulsateTime = millis();
    if (fadeUp) {
      pulsatingBrightness += 4;
      if (pulsatingBrightness >= 255) {
        pulsatingBrightness = 255;
        fadeUp = false;
      }
    } else {
      pulsatingBrightness -= 4;
      if (pulsatingBrightness <= 80) {
        pulsatingBrightness = 80;
        fadeUp = true;
      }
    }
  }

  // --- ВОЗВРАЩЕННАЯ ЛОГИКА для переливания цвета ClickLeds (фиолетовый-голубой) ---
  static unsigned long lightFlashTimer = 0;
  static bool up = false;
  static int light = 0;
  uint8_t r = 0, g = 0, b = 0;

  if (millis() - lightFlashTimer >= 6) {
    lightFlashTimer = millis();
    if (!up) {
      light++;
      if (light >= 255) up = true;
    } else {
      light--;
      if (light <= 0) up = false;
    }
    // Эти значения как раз и создают переход от фиолетового (128, 0, 255) к голубому (0, 128, 255)
    r = map(light, 0, 255, 128, 0);
    g = map(light, 0, 255, 0, 128);
    b = 255;
  }

  // --- Логика для пульсации ГОЛУБОГО светодиода при касании геркона ---
  static unsigned long blinkTimer = 0;
  static int fadeValue = 0;
  static bool fadeDirection = true;
  if (isStartTimer && blinkLedNumber != -1) {
    if (millis() - blinkTimer >= 5) {
      blinkTimer = millis();
      if (fadeDirection) {
        fadeValue += 8;
        if (fadeValue >= 255) fadeDirection = false;
      } else {
        fadeValue -= 8;
        if (fadeValue <= 0) fadeDirection = true;
      }
    }
  }

  // --- ОСНОВНОЙ ЦИКЛ ОТРИСОВКИ С ПРИОРИТЕТАМИ ---
  for (int i = 0; i <= 20; i++) {
    // 1. Устанавливаем базовые состояния
    if (FutureLeds[i] != -1) ledMap[FutureLeds[i]] = CRGB::White;
    if (DisableLeds[i] != -1) ledMap[DisableLeds[i]] = CRGB::Black;

    // 2. Устанавливаем ПЕРЕЛИВАНИЕ для кликабельных (ПРИОРИТЕТ НАД БЕЛЫМ)
    if (ClickLeds[i] != -1) {
      ledMap[ClickLeds[i]] = CRGB(r, g, b);
    }
    
    // 3. Устанавливаем ЖЕЛТУЮ пульсацию для активных (ПРИОРИТЕТ НАД ПЕРЕЛИВАНИЕМ)
    if (ActiveLeds[i] != -1) {
      ledMap[ActiveLeds[i]] = CHSV(55, 255, pulsatingBrightness);
    }
  }

  // 4. Устанавливаем ГОЛУБУЮ пульсацию для выбранного герконом (САМЫЙ ВЫСОКИЙ ПРИОРИТЕТ)
  if (isStartTimer && blinkLedNumber != -1) {
    uint8_t pulseG = map(fadeValue, 0, 255, 0, 128);
    uint8_t pulseB = map(fadeValue, 0, 255, 0, 255);
    ledMap[blinkLedNumber] = CRGB(0, pulseG, pulseB);
  }
}

void TrainGame() {

  if (enc1.isLeft()) {
    hue += 5;
  }
  if (enc1.isRight()) {
    hue -= 5;
  }
  if (enc2.isLeft()) {
    flickerIntensity += 5;
  }
  if (enc2.isRight()) {
    flickerIntensity -= 5;
  }

  if (enc3.isLeft()) musicCounter += 5;
  if (enc3.isRight()) musicCounter -= 5;

  if (flickerIntensity > 300) flickerIntensity = 0;
  else if (flickerIntensity < 0) flickerIntensity = 300;

  if (hue > 200) hue = 0;
  else if (hue < 0) hue = 200;

  if (hue > 0 && hue < 50) {
    hue1 = 96;
  }
  if (hue > 49 && hue < 100) {
    hue1 = 0;
  }
  if (hue > 99 && hue < 150) {
    hue1 = 160;
  }
  if (hue > 149 && hue < 200) {
    hue1 = greenHue;
  }


  if (musicCounter > 200) musicCounter = 0;
  else if (musicCounter < 0) musicCounter = 200;

    // --- КОД РАСПРЕДЕЛЕНИЕМ ПРОЦЕНТОВ ---
  if (musicCounter >= 80 && musicCounter <= 119) {
      // Диапазон 1 (Центр, ~20%): Первый звук двигателя
      if (!musicFlag1) {
        musicFlag1 = true;
        musicFlag2 = false;
        musicFlag3 = false;
        myMP3.loop(TRACK_ENGINE1);
      }
  } else if (musicCounter >= 0 && musicCounter <= 59) {
      // Диапазон 2 (Начало, ~30%): Второй звук двигателя
      if (!musicFlag2) {
        musicFlag1 = false;
        musicFlag2 = true;
        musicFlag3 = false;
        myMP3.loop(TRACK_ENGINE2);
      }
  } else {
      // Диапазон 3 (Остальное, ~50%): Третий звук двигателя
      if (!musicFlag3) {
        musicFlag1 = false;
        musicFlag2 = false;
        musicFlag3 = true;
        myMP3.loop(TRACK_ENGINE3);
      }
  }

  if (millis() - prevFlickerTime > 30) {  // Обновляем каждые 30мс
    prevFlickerTime = millis();

    // Случайное изменение яркости вокруг базового уровня
    int flicker = random(-flickerIntensity, flickerIntensity);
    int currentBrightness = constrain(baseBrightness + flicker, 10, 255);

    //fill_solid(leds1, NUM_LEDS1, CHSV(hue, 255, 255));
    for (int i = 1; i < 4; i++) {
      leds1[i] = CHSV(hue1, 255, currentBrightness);
    }
  }

  // 1. Проверка текущих условий
  bool currentColorOk = (hue1 == greenHue);
  bool currentFlickerOk = (flickerIntensity <= 100);
  bool currentSoundOk = (musicCounter >= 80 && musicCounter <= 118);

  // 2. Отправка обновлений только при изменении состояния
  if (currentColorOk != lastColorOk) {
    lastColorOk = currentColorOk;
    if (currentColorOk) SendData("{\"train_enc\":\"color_ok\"}");
    else SendData("{\"train_enc\":\"color_bad\"}");
  }

  if (currentFlickerOk != lastFlickerOk) {
    lastFlickerOk = currentFlickerOk;
    if (currentFlickerOk) SendData("{\"train_enc\":\"flicker_ok\"}");
    else SendData("{\"train_enc\":\"flicker_bad\"}");
  }

  if (currentSoundOk != lastSoundOk) {
    lastSoundOk = currentSoundOk;
    if (currentSoundOk) SendData("{\"train_enc\":\"sound_ok\"}");
    else SendData("{\"train_enc\":\"sound_bad\"}");
  }

  Serial.println(hue1 == greenHue);
  if ((hue1 == greenHue) && flickerIntensity <= 100 && musicCounter >= 80 && musicCounter <= 118) {
    if (millis() - checkTrainTimer >= 500) {
      state++;
      SendData("{\"train\":\"end\"}");
      myMP3.stop();
      delay(50);
      myMP3.disableLoop();
      if (language == 1) {
        myMP3.playMp3Folder(TRACK_STORY_16_RU);
        SendData("{\"log\":\"Train: Playing Story 16 (RU)\"}");
      }
      if (language == 2) {
        myMP3.playMp3Folder(TRACK_STORY_16_EN);
        SendData("{\"log\":\"Train: Playing Story 16 (EN)\"}");
      }
      if (language == 3) {
        myMP3.playMp3Folder(TRACK_STORY_16_AR);
        SendData("{\"log\":\"Train: Playing Story 16 (AR)\"}");
      }
      if (language == 4) {
        myMP3.playMp3Folder(TRACK_STORY_16_FR);
        SendData("{\"log\":\"Train: Playing Story 16 (FR)\"}");
      }
      if (language == 5) {
          myMP3.playMp3Folder(TRACK_STORY_16_UK);
          SendData("{\"log\":\"Train: Playing Story 16 (UK)\"}");
      }
      if (language == 6) {
          myMP3.playMp3Folder(TRACK_STORY_16_PL);
          SendData("{\"log\":\"Train: Playing Story 16 (PL)\"}");
      }
    }
  } else {
    checkTrainTimer = millis();
  }
}

void checkGreen() {
  isGreen = (abs(hue - greenHue) <= 30);
}

// 2026-08-07: запуск вступительной истории поезда одним местом.
// Раньше этот блок жил только внутри handlePlayerQueries() и вызывался
// исключительно по событию «TRACK_TRAIN_ON доиграл». Теперь его же дёргает
// страховочный таймер в loop(), когда события от DFPlayer не дождались.
void playStory15() {
  trainOnStartedAt = 0;          // ждать конец train_on больше не нужно
  if (language == 1) {
    myMP3.playMp3Folder(TRACK_STORY_15_RU);
    SendData("{\"log\":\"Train: Playing Story 15 (RU)\"}");
  }
  if (language == 2) {
    myMP3.playMp3Folder(TRACK_STORY_15_EN);
    SendData("{\"log\":\"Train: Playing Story 15 (EN)\"}");
  }
  if (language == 3) {
    myMP3.playMp3Folder(TRACK_STORY_15_AR);
    SendData("{\"log\":\"Train: Playing Story 15 (AR)\"}");
  }
  if (language == 4) {
    myMP3.playMp3Folder(TRACK_STORY_15_FR);
    SendData("{\"log\":\"Train: Playing Story 15 (FR)\"}");
  }
  if (language == 5) {
    myMP3.playMp3Folder(TRACK_STORY_15_UK);
    SendData("{\"log\":\"Train: Playing Story 15 (UK)\"}");
  }
  if (language == 6) {
    myMP3.playMp3Folder(TRACK_STORY_15_PL);
    SendData("{\"log\":\"Train: Playing Story 15 (PL)\"}");
  }
  story15StartedAt = millis();   // с этого момента ждём state = 2
}

// 2026-08-07: страховка на потерянные события DFPlayer в цепочке
// projector -> train_on -> story_15 -> старт игры. Вызывается из loop()
// безусловно, а не из case 1: StartTimer() по истечении 9 секунд карты
// сбрасывает state в 0, и сторож внутри switch туда бы просто не попал.
void TrainIntroWatchdog() {
  if (trainOnStartedAt && millis() - trainOnStartedAt > TRAIN_ON_MAX_MS) {
    SendData("{\"log\":\"Train FALLBACK: конец train_on не пришёл от DFPlayer — запускаю Story 15 сам\"}");
    playStory15();
  }
  if (story15StartedAt && millis() - story15StartedAt > STORY15_MAX_MS) {
    SendData("{\"log\":\"Train FALLBACK: конец Story 15 не пришёл от DFPlayer — запускаю игру сам\"}");
    story15StartedAt = 0;
    state = 2;
    isStartTimer = false;   // как в штатной ветке: таймер карты не должен сбросить игру
    ResetTimer();
  }
}

void handlePlayerQueries() {
  static bool flagTrack;
  static unsigned long trackTimer;
  if (millis() - trackTimer >= 2000) {
    flagTrack = 0;
  }
  if (myMP3.available()) {
    uint8_t type = myMP3.readType();
    // Serial.println(type);
    if (type == 11) {  // должно быть 5
      int finishedTrack = myMP3.read();
      hintFlag = 1;
      hintPlayedAt = 0;
	  if (resumeEngineSound) {
        // Подсказка завершилась. Сбрасываем флаги, чтобы TrainGame() снова запустила звук.
        musicFlag1 = false;
        musicFlag2 = false;
        musicFlag3 = false;
        resumeEngineSound = false; // Сбрасываем наш флаг
      }
      Serial.print("Завершился трек: ");
      Serial.println(finishedTrack);
      delay(100);
      // Трек train_on этап больше не запускает (его звук внутри story_15), но
      // сама команда train_on с пульта осталась — цепочку за собой она не тянет.
      if ((finishedTrack == TRACK_STORY_15_RU) || (finishedTrack == TRACK_STORY_15_EN) || (finishedTrack == TRACK_STORY_15_AR) ||
          (finishedTrack == TRACK_STORY_15_FR) || (finishedTrack == TRACK_STORY_15_UK) || (finishedTrack == TRACK_STORY_15_PL)) {
        state = 2;
        story15StartedAt = 0; // 2026-08-07: штатный путь отработал, сторож не нужен
        Serial.println("state");
        isStartTimer = false; // Останавливаем таймер карты, чтобы он не сбросил игру
        ResetTimer();         // Сбрасываем визуализацию таймера
      }

      if ((finishedTrack == TRACK_STORY_16_RU) || (finishedTrack == TRACK_STORY_16_EN) || (finishedTrack == TRACK_STORY_16_AR) || 
          (finishedTrack == TRACK_STORY_16_FR) || (finishedTrack == TRACK_STORY_16_UK) || (finishedTrack == TRACK_STORY_16_PL)) {
        trackTimer = millis();
        flagTrack = 1;
        isTrainEnd = 1;
        hintFlag = 1;
        hintPlayedAt = 0;
      }
    }
  }
}

void SendData(String payload) {
  if (WiFi.status() == WL_CONNECTED) {
    sendLogToServer("TX:" + payload);
    HTTPClient http;
    http.begin(externalApi);
    http.addHeader("Content-Type", "application/json");
    http.setTimeout(100);
    // Пример POST-запроса
    int httpCode = http.POST(payload);
    // --- ИЗМЕНЕНИЕ: Обрабатываем train:end ЛОКАЛЬНО ---
    // Это предотвращает отправку команды самой себе и последующую активацию LED тролля
    if (payload == "{\"train\":\"end\"}") {
        Serial.println("log:tr:loc_end_skip");
        DisableLeds[0] = 9; // Гасим проектор
        ActiveLeds[0] = -1;
        ClickLeds[0] = -1;
        ActiveLeds[13] = 22; // Индекс 13 -> LED 22
        FutureLeds[13] = -1; // Убираем из будущих, если был
        DisableLeds[13] = -1;// Убираем из неактивных, если был
        ClickLeds[13] = -1;  // Не кликабельный

        digitalWrite(TUNNEL_LED, HIGH);
        // Зажигаем кожу (зеленым) ---
        leds1[0] = CRGB(0, 128, 0);
        for (int i = 1; i < 4; i++) {
          leds1[i] = CHSV(initialHue + (i * 7), 255, 255);
        }
        EVERY_N_MILLISECONDS(30) {
          FastLED.show();
          initialHue++;
        }
    }
    // --- КОНЕЦ ИЗМЕНЕНИЯ ---
    http.end();
  }
}

// === DIAG: парсер команд diag_set:<output>:<value> ===
// Примеры:
//   diag_set:tunnel_led:1        — включить туннельный LED
//   diag_set:train_light:0       — выключить свет поезда (реле)
//   diag_set:map_all:FF0000      — все 30 LED карты красные
//   diag_set:map:9:00FF00        — пиксель карты #9 зелёным
//   diag_set:skin_led:00AA00     — кожа (leds1[0])
//   diag_set:train_leds:FF8800   — leds1[1..3] оранжевые
//   diag_set:volume:20           — громкость 20
//   diag_set:play:5              — играть трек 5
//   diag_set:stop_audio:0        — стоп
void handleDiagSet(String body) {
  // body выглядит как "\"diag_set:tunnel_led:1\""
  // снимем кавычки и префикс
  int firstQuote = body.indexOf('"');
  int lastQuote  = body.lastIndexOf('"');
  if (firstQuote < 0 || lastQuote <= firstQuote) return;
  String s = body.substring(firstQuote + 1, lastQuote); // "diag_set:tunnel_led:1"
  s = s.substring(strlen("diag_set:"));                 // "tunnel_led:1"

  int colon = s.indexOf(':');
  if (colon < 0) return;
  String key = s.substring(0, colon);
  String val = s.substring(colon + 1);

  auto hexToCRGB = [](const String& h) -> CRGB {
    long n = strtol(h.c_str(), NULL, 16);
    return CRGB((n >> 16) & 0xFF, (n >> 8) & 0xFF, n & 0xFF);
  };

  if (key == "tunnel_led") {
    digitalWrite(TUNNEL_LED, val.toInt() ? HIGH : LOW);
  } else if (key == "uf_led") {
    digitalWrite(UF_LED, val.toInt() ? HIGH : LOW);
  } else if (key == "ceiling_led") {
    // По схеме train.net: U6 P0 → "LED CEILING" (свет потолка комнаты)
    OUTPUTS.digitalWrite(0, val.toInt() ? HIGH : LOW);
  } else if (key == "stars_led") {
    // По схеме train.net: U6 P1 → "LED STARS" (звёзды на потолке)
    OUTPUTS.digitalWrite(1, val.toInt() ? HIGH : LOW);
  } else if (key == "skin_led") {
    leds1[0] = hexToCRGB(val);
    FastLED.show();
  } else if (key == "train_leds") {
    CRGB c = hexToCRGB(val);
    for (int i = 1; i < 4; i++) leds1[i] = c;
    FastLED.show();
  } else if (key == "map_all") {
    CRGB c = hexToCRGB(val);
    for (int i = 0; i < 30; i++) ledMap[i] = c;
    FastLED.show();
  } else if (key == "map") {
    // val = "9:00FF00"
    int c2 = val.indexOf(':');
    if (c2 > 0) {
      int idx = val.substring(0, c2).toInt();
      if (idx >= 0 && idx < 30) {
        ledMap[idx] = hexToCRGB(val.substring(c2 + 1));
        FastLED.show();
      }
    }
  } else if (key == "volume") {
    value = constrain(val.toInt(), 0, 30);
    myMP3.volume(value);
  } else if (key == "play") {
    myMP3.play(val.toInt());
  } else if (key == "stop_audio") {
    myMP3.stop();
  } else if (key == "reset_vib") {
    vibCount = 0;
  }
}

// === DIAG: периодическая отправка snapshot всех I/O на сервер ===
// Формат: {"diag":{"in":[..9..],"enc":[c,f,m],"out":[..4..],"vol":N,"map":"<60 hex>","rssi":N}}
// in[0..7] — PCF8574 INPUTS pin 0..7 (workshop/train/hint/owl/trainmap/fish/key/<unused>)
// in[8]    — ghost button (GPIO 36)
// Значения геркона: 1 = ЗАМКНУТ (низкий уровень на пине из-за INPUT_PULLUP, инвертируем).
void sendDiagSnapshot() {
  if (WiFi.status() != WL_CONNECTED) return;

  String payload = "{\"diag\":{\"in\":[";
  for (int i = 0; i < 8; i++) {
    payload += (INPUTS.digitalRead(i) == LOW) ? "1" : "0";
    payload += ",";
  }
  payload += (digitalRead(36) == LOW) ? "1" : "0";  // ghost btn — LOW_PULL, нажатие = LOW
  payload += "],\"enc\":[";
  payload += String(diagEnc1);
  payload += ",";
  payload += String(diagEnc2);
  payload += ",";
  payload += String(diagEnc3);
  payload += "],\"out\":[";
  payload += String(digitalRead(TUNNEL_LED));
  payload += ",";
  payload += String(digitalRead(UF_LED));
  payload += ",";
  // PCF8574 не даёт читать обратно output reliably — используем последнее записанное
  // значение через digitalRead (Adafruit lib хранит shadow)
  payload += String(OUTPUTS.digitalRead(0));
  payload += ",";
  payload += String(OUTPUTS.digitalRead(1));
  payload += "],\"vol\":";
  payload += String(value);
  payload += ",\"map\":\"";
  // 30 × 6 hex chars
  char buf[7];
  for (int i = 0; i < 30; i++) {
    snprintf(buf, sizeof(buf), "%02x%02x%02x", ledMap[i].r, ledMap[i].g, ledMap[i].b);
    payload += buf;
  }
  payload += "\",\"vib\":";
  payload += String(vibCount);
  payload += ",\"rssi\":";
  payload += String(WiFi.RSSI());
  payload += ",\"heap\":";
  payload += String(ESP.getFreeHeap());
  payload += ",\"uptime\":";
  payload += String(millis() / 1000UL);
  payload += ",\"temp\":";
  payload += String(temperatureRead(), 1);  // °C, точность ±10°C — годится для контроля перегрева
  payload += "}}";

  HTTPClient http;
  http.begin("http://192.168.4.1:3000/api?device=train");
  http.addHeader("Content-Type", "application/json");
  http.setTimeout(150);
  http.POST(payload);
  http.end();
}

void StartTimer() {
  static int timerLeds[] = { 2, 3, 4, 5, 6, 7, 8, 1, 0 };

  if (isStartTimer) {
    if (timerIsStarting) {
      for (int i = 0; i <= 10; i++) {
        ledMap[i] = CRGB(3, 162, 255);
      }
      _secondsTimer = millis();
      timerIsStarting = false;
    }

    if (millis() - _secondsTimer >= 1000) {
      _secondsTimer = millis();
      if (timerLedsCount < 9) {
        ledMap[timerLeds[timerLedsCount]] = CRGB(0, 0, 0);
        timerLedsCount++;
      }
    }

    if (timerLedsCount >= 9) {
      timerLedsCount = 0;
      timerIsStarting = true;
      isStartTimer = false;
      state = 0;

      isKeyClick = false;
      isFishClick = false;
      isOwlClick = false;
      isTrainClick = false;
      blinkLedNumber = -1;
      if (!isSendOut) {
        Serial.println("out");
        SendData("{\"map\":\"out\"}");
      }
    }
  }
}
void SkinPulsation() {
  if (millis() - skinlightFlashTimer >= 18) {
    if (!skinup) {
      skinlight++;
      if (skinlight == 75)
        skinup = 1;
    } else {
      skinlight--;
      if (skinlight == 10)
        skinup = 0;
    }
    float brightness = skinlight / 75.0;  // коэффициент яркости от 0 до 1
    int green = 128 * brightness;         // Зеленая составляющая
    leds1[0] = CRGB(0, green, 0);
    FastLED.show();
    skinlightFlashTimer = millis();
  }
}

void WorkshopGame() {
  
  // --- Шаг 1: Логика "Антидребезга" (Debouncing) ---
  bool currentSkinReading = !INPUTS.digitalRead(0); // Чтение с геркона (true = нажат) 
  unsigned long currentTime = millis();

  if (currentSkinReading != lastSkinSteadyState) {
    // Состояние изменилось, сбросить таймер
    lastSkinDebounceTime = currentTime;
  }

  if ((currentTime - lastSkinDebounceTime) > DEBOUNCE_DELAY) {
    // Состояние стабильно уже 50ms
    if (currentSkinReading != skinState) {
      skinState = currentSkinReading; // Фиксируем новое стабильное состояние
    }
  }
  lastSkinSteadyState = currentSkinReading;
  // Теперь мы используем "skinState", а не "isSkinPressed"
  // --- Конец логики "Антидребезга" ---


  // --- Шаг 2: Логика квеста (использует стабильное "skinState") ---
  if (skinState) {
    // 2. Геркон ЗАЖАТ (стабильно)
    if (!skinReedLatched) {
      // Это первое нажатие, которое мы еще не обработали
      skinReedLatched = true; // Запираем флаг 
      isSkinPulsation = true;  // Включаем пульсацию 
      SendData("{\"train\":\"skin\"}"); // Отправляем сообщение ТОЛЬКО ОДИН РАЗ 
    }
    // Если skinReedLatched уже true (геркон удерживается),
    // мы ничего не делаем.
    
  } else {
    // 3. Геркон ОТПУЩЕН (стабильно)
    skinReedLatched = false; // Мы готовы к новому нажатию 
  }

  // 4. Анимация пульсации.
  if (isSkinPulsation) {
    SkinPulsation();
  }
}

void GhostGame() {
  // ghost.tick(); // Не нужно, так как в setup() стоит setTickMode(AUTO)
  // 1. Проверяем, была ли ВООБЩЕ получена команда "ghost_game".
  //    Если таймер = 0, команда еще не приходила.
  if (ghostIgnoreStartTime == 0) {
    // Команда "ghost_game" еще не поступала.
    // Ничего не делаем и просто выходим.
    return; // Выходим, не слушая стук
  }

  // 2. Проверяем, активен ли 3-секундный "тихий" период ПОСЛЕ команды "ghost_game".
  if (millis() - ghostIgnoreStartTime < GHOST_IGNORE_DURATION) {
    // Да, мы в 3-секундном окне (пока играет звук).
    
    // ВАЖНО: Мы НЕ ВЫЗЫВАЕМ isSingle/isDouble/isTriple здесь.
    // Если мы их вызовем, они "потратят" стук игрока,
    // который может произойти в этот момент.
    
    return; // Просто выходим, игнорируя датчик
  }
  // Если мы дошли сюда, значит:
  // 1. Команда "ghost_game" была получена (таймер != 0).
  // 2. 3-секундный "тихий" период прошел.
  // Теперь МОЖНО слушать реальный стук игрока.

  // 2026-05-27: было isSingle()/isDouble()/isTriple() — требовало ПОЛНЫЙ click pattern
  // (press + release + clickTimeout 100ms). Пьезо-датчик даёт короткие импульсы,
  // часто не складывающиеся в полный click. Игроку приходилось стучать сильно и долго.
  // isPress() срабатывает сразу на HIGH→LOW transition (с минимальным debounce 1ms).
  // Это даст реакцию на любой реальный удар.
  if (ghostFlag == 1 and ghost.isPress()) {
    ghostFlag = 0; // Прекращаем слушать (ghostFlag = 0)
    myMP3.stop();
    Serial.println("ghost_game_WIN");
    SendData("{\"ghost\":\"end\"}");

    // ВАЖНО: Сбрасываем таймер в 0, чтобы подготовиться
    // к СЛЕДУЮЩЕЙ команде "ghost_game" в игре.
    ghostIgnoreStartTime = 0;
  }
}

void DayOn() {
}
void DayOff() {
}
