ProducED-ed/Castle/owls/owls.ino

#include <Arduino.h>
#include <FastLED.h>  // Включаем библиотеку FastLED
#include "GyverButton.h"

unsigned long previousLockerTime = 0;       // Время последнего открытия
String serial1Buffer = "";
const unsigned long lockerInterval = 8000;  // Интервал 8 секунд
const unsigned long lockerDuration = 500;   // Длительность открытия 0.5 секунды
bool lockerActive = false;                  // Флаг активности открытия
bool owlCommandReceived = 0;
unsigned long owlArmedAt = 0;  // 2026-05-27 timestamp when owlCommandReceived set true
const unsigned long OWL_GUARD_MS = 1000;  // guard period after arm — suppresses immediate false-fires
int state = 0;
int owl = 0;

// --- Пины для устройств ---
const int PIN_LOKER_DOOR = 23;  // Локер "дверь" (через реле)
const int PIN_LED_ROOM = 12;    // Светодиод "освещение комнаты" (ШИМ-совместимый)
const int PIN_LED_WINDOW = 21;  // Освещение окна (ШИМ-совместимый для мгновенного включения/выключения)
const int LED_PIN_TILES = 3;    // АДРЕСНАЯ ЛЕНТА ДЛЯ ПЛИТОК - ПЕРЕНАЗНАЧЕН НА ПИН 3
const int NUM_TILE_LEDS = 4;    // Количество светодиодов на ленте для плиток

CRGB tileLeds[NUM_TILE_LEDS];  // Массив для хранения цветов светодиодов плиток

// --- Пины для плиток с подсветкой ---
GButton PIN_HERKON_BOAT(30);    // Галетник "лодка"
GButton PIN_IR_FLAG(27);        // ИК Датчик "Флаг"
GButton PIN_HERKON_OWA(29);     // Геркон "сова"
GButton PIN_HERKON_DWARF(31);   // Геркон "гном"
GButton PIN_HERKON_TILE1(A4);   // Геркон плитка 1
GButton PIN_HERKON_TILE2(A6);   // Геркон плитка 2
GButton PIN_HERKON_TILE3(A8);   // Геркон плитка 3
GButton PIN_HERKON_TILE4(A10);  // Геркон плитка 4
GButton PIN_HERKON_TILE0(5);    // Геркон плитка 0



// --- Пины для левого галетного переключателя ---
// Позиции: D46=2, D44=5, D42=4, D40=3
GButton PIN_DIAL_LEFT_POS2(46);
GButton PIN_DIAL_LEFT_POS3(44);  // Это 5-я позиция на схеме
GButton PIN_DIAL_LEFT_POS4(42);  // Это 4-я позиция на схеме
GButton PIN_DIAL_LEFT_POS5(40);  // Это 3-я позиция на схеме

// --- Пины для правого галетного переключателя ---
// Позиции: D32=1, D34=2, D36=3, D38=4
GButton PIN_DIAL_RIGHT_POS1(32);
GButton PIN_DIAL_RIGHT_POS2(34);
GButton PIN_DIAL_RIGHT_POS3(36);
GButton PIN_DIAL_RIGHT_POS4(38);

unsigned long owlEndTime = 0;
unsigned long rainbowStartTime = 0;
const unsigned long OWL_END_DELAY = 2000;      // Ждем 2 секунды после owl_end
const unsigned long RAINBOW_DURATION = 10000;  // Радуга на 10 секунд
uint8_t gHue = 0;                              // Для радужной анимации// Для радужной анимации

bool skipCommand = false;  // Флаг для команды skip
bool rainbowActive = false;
bool tile0State = 0;
bool tile1State = 0;
bool tile2State = 0;
bool tile3State = 0;
bool tile4State = 0;
// Глобальные переменные для отслеживания решения плиток
bool tile1Solved = false;
bool tile2Solved = false;
bool tile3Solved = false;
bool tile4Solved = false;
bool allTilesSolved = false;
bool _restartFlag;
bool _restartGalet;
bool F;
bool fireworkActive = false; // Флаг для фейерверка
bool hasSentReadyLog = false;

void handleSkipCommand() {
  if (skipCommand) {
    if (!rainbowActive) {
      // Первый вызов после команды skip
      rainbowActive = true;
      rainbowStartTime = millis();
      // Зажигаем все зеленым
      for (int i = 0; i < NUM_TILE_LEDS; i++) {
        tileLeds[i] = CRGB::Green;
      }
      FastLED.show();
      Serial1.println("owl_end");
    }

    // Запускаем радужную анимацию
    rainbowAnimation();

    // Проверяем закончилось ли время радуги
    if (millis() - rainbowStartTime >= RAINBOW_DURATION) {
      rainbowActive = false;
      skipCommand = false;
      // Оставляем зеленый цвет
      for (int i = 0; i < NUM_TILE_LEDS; i++) {
        tileLeds[i] = CRGB::Green;
      }
      FastLED.show();
      //Serial1.println("Rainbow finished");
    }
  }
}

// Функция радужной анимации
void rainbowAnimation() {
  fill_rainbow(tileLeds, NUM_TILE_LEDS, gHue, 7);
  gHue++;
  FastLED.show();
}

void setbutton(GButton &buttonN) {
  buttonN.setDebounce(50);      // настройка антидребезга (по умолчанию 80 мс)
  buttonN.setTimeout(10);       // настройка таймаута на удержание (по умолчанию 500 мс)
  buttonN.setClickTimeout(10);  // настройка таймаута между кликами (по умолчанию 300 мс)
  buttonN.setType(HIGH_PULL);
  buttonN.setDirection(NORM_OPEN);
  buttonN.setTickMode(AUTO);
}

void controlLocker() {
  unsigned long currentTime = millis();

  if (!lockerActive) {
    // Режим ожидания - проверяем интервал 8 секунд
    if (currentTime - previousLockerTime >= lockerInterval) {
      digitalWrite(PIN_LOKER_DOOR, HIGH);
      lockerActive = true;
      previousLockerTime = currentTime;  // Запоминаем время открытия
      //Serial1.println("Locker OPEN");
    }
  } else {
    // Замок открыт - проверяем время до закрытия
    if (currentTime - previousLockerTime >= lockerDuration) {
      digitalWrite(PIN_LOKER_DOOR, LOW);
      lockerActive = false;
      previousLockerTime = currentTime;  // Сбрасываем таймер для нового цикла
                                         // Serial1.println("Locker CLOSE");
    }
  }
}


void processOwlCommand(String command) {
  // Вся логика из handleSerial1Commands [cite: 37-65]
  // Удаляем \r здесь, т.к. trim() уже был вызван
  // if (command.endsWith("\r")) {
  //   command.remove(command.length() - 1);
  // }
  if (command != "restart") {
    sendLog("Received command: " + command);
  }

  if (command == "day_on") {
    for (int i = 0; i < NUM_TILE_LEDS; i++) {
      tileLeds[i] = CRGB::Green;
      digitalWrite(PIN_LED_ROOM, HIGH);
      digitalWrite(PIN_LED_WINDOW, HIGH);
    }
    FastLED.show();
  }

  if (command == "day_off") {
    for (int i = 0; i < NUM_TILE_LEDS; i++) {
      tileLeds[i] = CRGB::Black;
      digitalWrite(PIN_LED_ROOM, 0);
      digitalWrite(PIN_LED_WINDOW, 0);
    }
    FastLED.show();
  }

  if (command == "owl") {
    state = 0;
    owlCommandReceived = true;
    owlArmedAt = millis();  // 2026-05-27: запоминаем момент arming для guard'а
    F = false;
    for (int i = 0; i < NUM_TILE_LEDS; i++) {
      tileLeds[i] = CRGB::Black;
      digitalWrite(PIN_LED_ROOM, 0);
      digitalWrite(PIN_LED_WINDOW, 0);
    }
    FastLED.show();
  }

  if (command == "out") {
    //  state = 0;
    owlCommandReceived = false;
  }

  // Сова студента в центральной комнате. Игроки регулярно путают её с совой на
  // башне: обе «совы», обе на пути. Главная плата шлёт эту команду при касании
  // её геркона, а решение принимаем ЗДЕСЬ — теми же условиями, что и для своего
  // геркона (этап активирован картой + прошёл guard). Иначе получился бы старый
  // owl_door, который открывал дверь безусловно (см. ниже, почему его убрали).
  if (command == "owl_touch") {
    if (owlCommandReceived && (millis() - owlArmedAt > OWL_GUARD_MS)) {
      owlCommandReceived = false;
      Serial.println("door_owl");
      Serial1.println("door_owl");
      delay(50);
      sendLog("Owl touched in the central room.");
      state = 1;
    }
  }

  // 2026-05-25: handler "owl_door" удалён. Он немедленно слал door_owl без
  // проверки геркона PIN_HERKON_OWA — дублировал и ломал правильную логику
  // ниже (line ~351): owlCommandReceived=true + геркон → door_owl. После
  // фикса в server.py команда owl_door вообще не должна приходить, но даже
  // если придёт — игнорируем. Правильный flow: команда "owl" → ждём геркон.

  if (command == "open_door") {
    // 2026-06-05 (Эдуард): импульс 100мс → 500мс. Физически дверь не успевала
    // открыться за 100мс при /pult Open Door — Эдуард видел что только после
    // физ. касания геркона (когда controlLocker начинал пульсировать 500мс
    // каждые 8 сек) дверь открывалась.
    // ALSO: state = 1 — чтобы /pult Open Door симулировал реальный геркон-touch:
    // в loop() switch case 1 включает PIN_LED_ROOM (line 638) + (state > 0) →
    // controlLocker() пульсирует door каждые 8 сек как и при физ. прохождении.
    // В реальном flow геркон-touch УЖЕ ставит state=1 (line ~365), здесь
    // дублируем — no-op для real-flow, но критично для /pult skip.
    digitalWrite(PIN_LOKER_DOOR, HIGH);
    delay(500);
    digitalWrite(PIN_LOKER_DOOR, LOW);
    state = 1;
  }

  if (command == "firework") {

    fireworkActive = true;
    skipCommand = true;
    rainbowActive = false;
    tile1Solved = true;
    tile2Solved = true;
    tile3Solved = true;
    tile4Solved = true;
    owl = 6;
    digitalWrite(PIN_LED_ROOM, HIGH);
    digitalWrite(PIN_LED_WINDOW, HIGH);
    state = 2;

    for (int i = 0; i < NUM_TILE_LEDS; i++) {
      tileLeds[i] = CRGB::Green;
    }
  }

  if (command == "skip") {
    skipCommand = true;
    rainbowActive = true;
    rainbowStartTime = millis();

    tile1Solved = true;
    tile2Solved = true;
    tile3Solved = true;
    tile4Solved = true;
    owl = 6;
    digitalWrite(PIN_LED_ROOM, HIGH);
    digitalWrite(PIN_LED_WINDOW, HIGH);
    state = 2;
    for (int i = 0; i < NUM_TILE_LEDS; i++) {
      tileLeds[i] = CRGB::Green;
    }
    FastLED.show();
  }

  // Безопасный heartbeat от Main: только отвечаем "pong" без побочек.
  if (command == "ping_main") {
    Serial1.println("pong");
    return;
  }

  if (command == "ready") {
    delay(100);
    if (!hasSentReadyLog) {
      sendLog("System Ready");
      hasSentReadyLog = true;
    }
    resetOwlTower();
  }

  if (command == "check_state"){
    _restartFlag = 0;
    _restartGalet = 0;
      CheckState();
    }

  if (command == "restart") {
    hasSentReadyLog = false;
    
    // Открываем дверь при рестарте (импульс 0.5 сек)
    digitalWrite(PIN_LOKER_DOOR, HIGH);
    delay(500);
    digitalWrite(PIN_LOKER_DOOR, LOW);
    
    resetOwlTower();
  }

  if (command == "start") {
    hasSentReadyLog = false;
    resetOwlTower();
  }

}



// ============ МОНИТОР ДАТЧИКОВ ДЛЯ ТЕХ-ПУЛЬТА ============
// Опрос входов по команде mon:1 от главной платы. Данные уходят ТЕМ ЖЕ каналом,
// что и игровые события — по UART в Main и дальше на сервер. Читать башню по USB
// было бы проще, но тогда монитор показывал бы исправность там, где игра датчик
// не видит: так вышло со стартовым герконом, где обрыв оказался на плате.
//
// В игровую логику не вмешивается: только digitalRead и печать изменений.
// Пока monActive == false — ни одного лишнего действия за проход.
const uint8_t MON_PINS[] = {
  30, 27, 29, 31,           // галетник «лодка», ИК-флаг, геркон совы, геркон гнома
  5, A4, A6, A8, A10,       // стартовый геркон (гном по пружине) и плитки 1-4
  46, 44, 42, 40,           // галетный переключатель левый, позиции 2-5
  32, 34, 36, 38            // галетный переключатель правый, позиции 1-4
};
const uint8_t MON_COUNT = sizeof(MON_PINS);
bool monActive = false;
uint8_t monPrev[MON_COUNT];
uint8_t monCnt[MON_COUNT];
unsigned long monTimer = 0;

void monReport(uint8_t i, uint8_t value) {
  Serial1.print(F("sens:to"));
  Serial1.print(MON_PINS[i]);
  Serial1.print(':');
  Serial1.println(value ? 1 : 0);
}

bool handleMonCmd(const char *cmd) {
  if (strncmp(cmd, "mon:", 4) != 0) return false;
  bool wasActive = monActive;
  monActive = (strchr(cmd, '1') != NULL);
  // Дамп только на переходе выключено -> включено (см. коммент выше про
  // повтор mon:1 каждые 5 секунд с главной платы).
  if (monActive && !wasActive) {
    // Сразу отдаём состояние всех входов, чтобы пульт не ждал первого шевеления.
    for (uint8_t i = 0; i < MON_COUNT; i++) {
      monPrev[i] = digitalRead(MON_PINS[i]);
      monCnt[i] = 0;
      monReport(i, monPrev[i]);
    }
  }
  return true;
}

void monPoll() {
  if (!monActive) return;
  if (millis() - monTimer < 120) return;
  monTimer = millis();
  for (uint8_t i = 0; i < MON_COUNT; i++) {
    uint8_t v = digitalRead(MON_PINS[i]);
    if (v != monPrev[i]) {
      // Антидребезг: значение держится два опроса подряд (~240 мс).
      if (++monCnt[i] >= 2) { monPrev[i] = v; monCnt[i] = 0; monReport(i, v); }
    } else {
      monCnt[i] = 0;
    }
  }
}
// ============ /МОНИТОР ============

// Функция `handleSerial1Commands` переписана на неблокирующую
void handleSerial1Commands() {
  while (Serial1.available()) {
    char c = Serial1.read();
    
    // Собираем символы в буфер, пока не найдем '\n'
    if (c == '\n') {
      serial1Buffer.trim(); // Убираем пробелы и \r
      if (serial1Buffer.length() > 0) {
        // Монитор тех-пульта — до игрового разбора
        if (!handleMonCmd(serial1Buffer.c_str())) {
          // Отправляем команду на обработку
          processOwlCommand(serial1Buffer);
        }
      }
      serial1Buffer = ""; // Очищаем буфер для следующей команды
    } else if (c >= 32) { // Добавляем только "печатные" символы
      if (serial1Buffer.length() < 128) { // Защита от переполнения
        serial1Buffer += c;
      }
    }
  }
}

// 2026-08-07. Было: сырой digitalRead + delay(150) после каждого фронта.
// delay(150) работал грубым антидребезгом — он не фильтровал вход, а просто
// затыкал башню на 150 мс, чтобы дребезг не успел породить второе сообщение.
// Плата при этом не читала Serial от Mega и не опрашивала датчики; лодка и
// флаг вместе съедали до 300 мс.
//
// Теперь антидребезг по времени: уровень должен продержаться FLAG_DEBOUNCE_MS.
// Плюс периодическая пересылка состояния — сообщения уходили только на
// фронтах, и потерянный или ложный фронт разводил картину Mega с реальностью
// НАВСЕГДА. Клиент лечил это, вынимая и вставляя флаг. Пересылка чинит сама.
// Mega форвардит наверх только изменения, лишнего трафика нет.
const unsigned long FLAG_DEBOUNCE_MS = 50;
const unsigned long FLAG_RESEND_MS = 5000;

bool debounced(bool raw, bool &stable, bool &pending, unsigned long &since) {
  if (raw != pending) { pending = raw; since = millis(); }
  if (raw != stable && millis() - since >= FLAG_DEBOUNCE_MS) { stable = raw; return true; }
  return false;
}

void CheckState() {
  static bool boatStable = false, boatPending = false;
  static bool flagStable = false, flagPending = false;
  static unsigned long boatSince = 0, flagSince = 0, lastResend = 0;

  // Лодка (Pin 30): Active LOW.  Флаг (Pin 27): Active HIGH
  bool changedBoat = debounced(!digitalRead(30), boatStable, boatPending, boatSince);
  bool changedFlag = debounced(digitalRead(27),  flagStable, flagPending, flagSince);

  bool resend = (millis() - lastResend >= FLAG_RESEND_MS);
  if (resend) lastResend = millis();

  if (changedBoat || resend) {
    Serial1.println(boatStable ? "galet_on" : "galet_off");
    _restartGalet = boatStable;
  }
  if (changedFlag || resend) {
    Serial1.println(flagStable ? "flag4_on" : "flag4_off");
    _restartFlag = flagStable;
  }
}


// Функция проверки кнопки совы
void checkOwlButton() {

  // Заменено isHold() на isPress() и убрана логика с флагом F.
  // Теперь команда может быть отправлена только один раз за сессию.
  // 2026-05-27: добавлен GUARD период (OWL_GUARD_MS=1000) после arming.
  // Защита от ложного срабатывания PIN_HERKON_OWA сразу после команды "owl"
  // (например электрические помехи на длинном проводе геркона или дребезг).
  // Игроку незаметно (он идёт до башни 2-5 секунд).
  if (owlCommandReceived
      && (millis() - owlArmedAt > OWL_GUARD_MS)
      && PIN_HERKON_OWA.isPress()) {
    owlCommandReceived = false;  // Предотвращаем повторное срабатывание
    Serial.println("door_owl");
    Serial1.println("door_owl");
    delay(50); // паузу, чтобы MAIN_BOARD успел обработать команду перед логом
    sendLog("Owl button pressed.");
    state = 1;
  }
}

void HELP() {
  if (PIN_HERKON_DWARF.isPress()) {
    Serial1.println("help");
    sendLog("Help button pressed.");
  }
}

void handleTileLeds() {

  if (skipCommand) {
    return;
  }

  // ЕСЛИ РАДУГА АКТИВНА - ТОЛЬКО АНИМАЦИЯ И ВЫХОД
  if (rainbowActive) {
    rainbowAnimation();

    // ПРОВЕРЯЕМ ВРЕМЯ РАДУГИ ОТ НАЧАЛА АНИМАЦИИ
    if (millis() - rainbowStartTime >= RAINBOW_DURATION) {
      rainbowActive = false;
      // Возвращаем зеленый цвет на все плитки
      for (int i = 0; i < NUM_TILE_LEDS; i++) {
        tileLeds[i] = CRGB::Green;
      }
      FastLED.show();
      //Serial1.println("Rainbow finished");
      owl = 6;
    }
    return;  // ВЫХОДИМ ИЗ ФУНКЦИИ
  }

  // ПЛИТКА 1
  if (!tile1Solved && PIN_HERKON_TILE1.isHold() && PIN_DIAL_LEFT_POS3.isHold() && PIN_DIAL_RIGHT_POS2.isHold()) {
    tileLeds[0] = CRGB::Green;
    tile1Solved = true;
    owl++;
    //digitalWrite(PIN_LED_WINDOW, 0);

    if (owl < 4) {
      Serial1.println("owl_flew");
    }
    delay(10);
  }

  // ПЛИТКА 2
  if (!tile2Solved && PIN_HERKON_TILE2.isHold() && PIN_DIAL_LEFT_POS4.isHold() && PIN_DIAL_RIGHT_POS3.isHold()) {
    tileLeds[1] = CRGB::Green;
    tile2Solved = true;
    owl++;
    //digitalWrite(PIN_LED_WINDOW, 0);

    if (owl < 4) {
      Serial1.println("owl_flew");
    }
    delay(10);
  }

  // ПЛИТКА 3
  if (!tile3Solved && PIN_HERKON_TILE3.isHold() && PIN_DIAL_LEFT_POS2.isHold() && PIN_DIAL_RIGHT_POS1.isHold()) {
    tileLeds[2] = CRGB::Green;
    tile3Solved = true;
    owl++;
    //digitalWrite(PIN_LED_WINDOW, 0);

    if (owl < 4) {
      Serial1.println("owl_flew");
    }
    delay(10);
  }

  // ПЛИТКА 4
  if (!tile4Solved && PIN_HERKON_TILE4.isHold() && PIN_DIAL_LEFT_POS5.isHold() && PIN_DIAL_RIGHT_POS4.isHold()) {
    tileLeds[3] = CRGB::Green;
    tile4Solved = true;
    owl++;
    //digitalWrite(PIN_LED_WINDOW, 0);
    if (owl < 4) {
      Serial1.println("owl_flew");
    }
    delay(10);
  }

  // ПРОВЕРКА ВСЕХ ПЛИТОК И ЗАПУСК РАДУГИ
  if (owl == 4 && !rainbowActive) {
    //delay(1000);
    // ИЗМЕНЕНО: Добавлено логирование перед командой
    sendLog("All tiles solved. Sending owl_end command. owls_complete");
    delay(10);
    // КОНЕЦ
    Serial1.println("owl_end");
    owl++;
    owlEndTime = millis();
  }

  // ЗАПУСК РАДУГИ ЧЕРЕЗ 2 СЕКУНДЫ ПОСЛЕ owl_end
  if (owl == 5 && !rainbowActive && millis() - owlEndTime >= OWL_END_DELAY) {
    rainbowActive = true;
    rainbowStartTime = millis();
    //Serial1.println("Rainbow started");
  }

  // ОБЫЧНАЯ ЛОГИКА ПОДСВЕТКИ (только для нерешенных плиток)
  // Плитка 1 -> Светодиод 0

  if (PIN_HERKON_TILE0.isHold()) {
    if (!tile0State) {
      Serial1.println("dark");
      tile0State = true;

      digitalWrite(PIN_LED_WINDOW, 0);
    }
  } else {
    if (tile0State) {
      Serial1.println("light");
      tile0State = false;
      digitalWrite(PIN_LED_WINDOW, 1);
    }
  }

  if (!tile1Solved) {
    if (PIN_HERKON_TILE1.isHold()) {
      tileLeds[0] = CRGB::Yellow;
      if (!tile1State) {
        // Serial1.println("light_on");
        tile1State = true;
        //digitalWrite(PIN_LED_WINDOW, 1);
      }
    } else {
      tileLeds[0] = CRGB::Black;
      if (tile1State) {
        // Serial1.println("light_off");
        tile1State = false;
        // digitalWrite(PIN_LED_WINDOW, 0);
      }
    }
  }

  // Плитка 2 -> Светодиод 1
  if (!tile2Solved) {
    if (PIN_HERKON_TILE2.isHold()) {
      tileLeds[1] = CRGB::Yellow;
      if (!tile2State) {
        // Serial1.println("light_on");
        tile2State = true;
        // digitalWrite(PIN_LED_WINDOW, 1);
      }
    } else {
      tileLeds[1] = CRGB::Black;
      if (tile2State) {
        //Serial1.println("light_off");
        tile2State = false;
        //digitalWrite(PIN_LED_WINDOW, 0);
      }
    }
  }

  // Плитка 3 -> Светодиод 2
  if (!tile3Solved) {
    if (PIN_HERKON_TILE3.isHold()) {
      tileLeds[2] = CRGB::Yellow;
      if (!tile3State) {
        //Serial1.println("light_on");
        tile3State = true;
        //digitalWrite(PIN_LED_WINDOW, 1);
      }
    } else {
      tileLeds[2] = CRGB::Black;
      if (tile3State) {
        // Serial1.println("light_off");
        tile3State = false;
        // digitalWrite(PIN_LED_WINDOW, 0);
      }
    }
  }

  // Плитка 4 -> Светодиод 3
  if (!tile4Solved) {
    if (PIN_HERKON_TILE4.isHold()) {
      tileLeds[3] = CRGB::Yellow;
      if (!tile4State) {
        //Serial1.println("light_on");
        tile4State = true;
        //digitalWrite(PIN_LED_WINDOW, 1);
      }
    } else {
      tileLeds[3] = CRGB::Black;
      if (tile4State) {
        //Serial1.println("light_off");
        tile4State = false;
        //digitalWrite(PIN_LED_WINDOW, 0);
      }
    }
  }

  FastLED.show();
}

void sendLog(String message) {
  Serial1.println("log:owls:" + message);
}

void setup() {
  Serial1.begin(9600);
  Serial.begin(9600);

  // Опознавательный баннер для тех-пульта (/tech → «Первый запуск» → раскладка
  // USB-хаба). Пульт открывает порт, плата от DTR перезагружается и печатает
  // сюда своё имя — так видно, в тот ли порт хаба воткнут кабель. Раньше
  // раскладку проверяли вручную через ls /dev/serial/by-path, и перепутанные
  // Workshop с Basket однажды доехали до клиента. Связь с главной платой идёт
  // по Serial1, этот вывод игровой логике не мешает.
  for (uint8_t i = 0; i < 3; i++) {
    Serial.println(F("CLC-TOWER:owls"));
    delay(80);
  }

  FastLED.addLeds<WS2812B, LED_PIN_TILES, GRB>(tileLeds, NUM_TILE_LEDS);
  FastLED.setBrightness(100);
  FastLED.clear();
  FastLED.show();

  pinMode(PIN_LOKER_DOOR, OUTPUT);
  pinMode(PIN_LED_ROOM, OUTPUT);
  pinMode(PIN_LED_WINDOW, OUTPUT);

  // Гарантированно выключаем все замки и свет при старте
  // для защиты от "залипания" при перезагрузке.
  digitalWrite(PIN_LOKER_DOOR, LOW);
  digitalWrite(PIN_LED_ROOM, LOW);
  digitalWrite(PIN_LED_WINDOW, LOW);

  setbutton(PIN_HERKON_BOAT);
  setbutton(PIN_IR_FLAG);

  setbutton(PIN_HERKON_OWA);
  setbutton(PIN_HERKON_DWARF);
  setbutton(PIN_HERKON_TILE1);
  setbutton(PIN_HERKON_TILE2);
  setbutton(PIN_HERKON_TILE3);
  setbutton(PIN_HERKON_TILE4);
  setbutton(PIN_HERKON_TILE0);

  setbutton(PIN_DIAL_LEFT_POS2);
  setbutton(PIN_DIAL_LEFT_POS3);
  setbutton(PIN_DIAL_LEFT_POS4);
  setbutton(PIN_DIAL_LEFT_POS5);
  setbutton(PIN_DIAL_RIGHT_POS1);
  setbutton(PIN_DIAL_RIGHT_POS2);
  setbutton(PIN_DIAL_RIGHT_POS3);
  setbutton(PIN_DIAL_RIGHT_POS4);
  sendLog("SYS START");
}


void loop() {
  monPoll();                 // монитор датчиков для /tech (только по команде)
  static int previousState = -1;
  if (state != previousState) {
    previousState = state;
  }

  // Главный state machine
  if (fireworkActive) {
    handleFirework();
  } else {
  switch (state) {
    case 1:
      if (skipCommand) {
        handleSkipCommand();
      } else {
        handleTileLeds();  // Обычная логика плиток
      }
      digitalWrite(PIN_LED_ROOM, HIGH);
      break;
    case 2:

      break;
  }
  }
  if (state > 0) controlLocker();

  // Общие функции, работающие в любом состоянии
  FastLED.show();
  handleSerial1Commands();   // Проверяем команды
  checkOwlButton();  
  CheckState();  //проверяем флаг
  HELP();
}

// Адаптированная функция фейерверка для owls.ino (FastLED)
void handleFirework() {
  if (!fireworkActive) return;

  static unsigned long lastFireworkTime = 0;
  // Уменьшаем кол-во взрывов для 4 светодиодов
  static const int MAX_EXPLOSIONS = 2; 
  // Уменьшаем макс. радиус взрыва
  static const int FIREWORK_RADIUS = 2; 
  static struct Explosion {
    int phase;
    CRGB color;
    int center;
    unsigned long startTime;
  } explosions[MAX_EXPLOSIONS];


  // Создаем новые взрывы (реже, т.к. светодиодов мало)
  if (millis() - lastFireworkTime >= 1000) { // [изменено с 600]
    lastFireworkTime = millis();
    // Ищем свободный слот для нового взрыва
    for (int i = 0; i < MAX_EXPLOSIONS; i++) {
      if (explosions[i].phase == 0) {
        // Красивые цвета салюта
        CRGB niceColors[] = {
          CRGB(255, 100, 50),   // Оранжевый
          CRGB(100, 255, 100),  // Светло-зеленый
          CRGB(100, 100, 255),  // Светло-синий
          CRGB(255, 255, 100),  // Светло-желтый
          CRGB(255, 100, 255),  // Розовый
          CRGB(100, 255, 255)   // Бирюзовый
        };
        explosions[i].color = niceColors[random(6)];
        // Центр взрыва - случайный из 4 светодиодов
        explosions[i].center = random(NUM_TILE_LEDS); // 
        explosions[i].startTime = millis();
        explosions[i].phase = 1;
        break;
      }
    }
  }

  // Обрабатываем все активные взрывы
  for (int e = 0; e < MAX_EXPLOSIONS; e++) {
    if (explosions[e].phase > 0) {
      unsigned long elapsed = millis() - explosions[e].startTime;
      if (elapsed < 500) {
        // Фаза расширения
        float progress = (float)elapsed / 500.0;
        int radius = progress * FIREWORK_RADIUS; // Используем новый радиус

        for (int i = 0; i < NUM_TILE_LEDS; i++) { // 
          int distance = abs(i - explosions[e].center);
          if (distance <= radius) {
            float intensity = 1.0 - (float)distance / radius;
            // Применяем цвет с масштабированной яркостью
            tileLeds[i] = explosions[e].color; // 
            tileLeds[i].fadeToBlackBy(255 - (intensity * 255)); // 
          }
        }
      } else if (elapsed < 1000) {
        // Фаза затухания
        float fadeProgress = (float)(elapsed - 500) / 500.0;
        uint8_t fadeAmount = fadeProgress * 255;

        for (int i = 0; i < NUM_TILE_LEDS; i++) { // 
          int distance = abs(i - explosions[e].center);
          if (distance <= FIREWORK_RADIUS) { // Используем новый радиус
            // Применяем цвет и сразу затухаем
            tileLeds[i] = explosions[e].color; // 
            tileLeds[i].fadeToBlackBy(fadeAmount); // 
          }
        }
      } else {
        // Завершаем взрыв
        explosions[e].phase = 0;
        for (int i = 0; i < NUM_TILE_LEDS; i++) { // 
          int distance = abs(i - explosions[e].center);
          if (distance <= FIREWORK_RADIUS) { // Используем новый радиус
            tileLeds[i] = CRGB::Black; // 
          }
        }
      }
    }
  }

  // Плавное затухание всех светодиодов
  EVERY_N_MILLISECONDS(20) {
    for (int i = 0; i < NUM_TILE_LEDS; i++) { // 
      if (tileLeds[i] != CRGB::Black) { // 
        tileLeds[i].fadeToBlackBy(8); // 
      }
    }
  }

  FastLED.show();
}

// Функция для полного сброса башни ---
// Она объединяет логику 'start' и 'restart' и исправляет пропуски.
void resetOwlTower() {
  // Сброс всех флагов состояния
  skipCommand = false;
  fireworkActive = false;
  rainbowActive = false;
  tile0State = false;
  tile1State = false;
  tile2State = false;
  tile3State = false;
  tile4State = false;
  tile1Solved = false;
  tile2Solved = false;
  tile3Solved = false;
  tile4Solved = false;
  lockerActive = false;
  owlCommandReceived = false;
  state = 0;
  owl = 0;
  F = false;

  // Сброс флагов для CheckState()
  _restartFlag = 0;
  _restartGalet = 0;
  
  // Приводим башню в "темное" состояние по умолчанию
  digitalWrite(PIN_LOKER_DOOR, LOW); // Гарантированно выключаем замок
  digitalWrite(PIN_LED_ROOM, 0);
  digitalWrite(PIN_LED_WINDOW, 0);
  
  for (int i = 0; i < NUM_TILE_LEDS; i++) {
    tileLeds[i] = CRGB::Black;
  }
  FastLED.show();
}
