ProducED-ed/Castle/chest/chest.ino

// Сколько ждать после подачи питания, прежде чем включать периферию.
static const unsigned long STARTUP_SETTLE_MS = 1200;

#include <WiFi.h>
#include "GyverButton.h"
#include "HardwareSerial.h"
#include "DFRobotDFPlayerMini.h"
#include <WebServer.h>
#include <HTTPClient.h>
// --- ДОБАВЛЕНО ДЛЯ OTA ---
#include <ESPmDNS.h>
#include <WiFiUdp.h>
#include <ArduinoOTA.h>
#include "soc/soc.h"
#include "soc/rtc_cntl_reg.h"
// -------------------------
HardwareSerial mySerial(1); 

byte light;
int symbolBrightness;
int iterator;
int buttonSequence;
int score;
int mistakeLed = 22;
int insideLed = 23;
int ledsSym[] = {25,5,18,19};
int state = 0;
bool isMistake = false;
// Лёгкий режим этапа чемоданов. Тумблер в Settings игрового пульта, сервер
// присылает chest_mode_easy / chest_mode_normal и досылает выбор при каждом
// старте — ESP32 могла перезагрузиться и забыть его.
// Нормальный: четыре кнопки по порядку с удержанием, потом ИК-датчик при
// удержанных кнопках. Лёгкий: любая одна кнопка открывает сборку, дальше
// достаточно замкнуть ИК-датчик, ничего удерживать не нужно.
bool chestEasyMode = false;

int SHERIF_EM2 = 21;

//геркон двигалок
const byte eyeSymbolGerkon = 33;

bool up;
bool fadeUp = 1;
bool symbolFade = 1;

unsigned long prevTwinkleTime = 0;
unsigned long prevBreathTime = 0;
int breathPhase = 0;         // Фаза эффекта дыхания
bool twinkleMode = true; 

////Timers
unsigned long eyeSymbolTimer;
unsigned long symbolFadeTimer;
int pause_duration = 2000;
unsigned long pauseTimer = 0;
unsigned long mistakeTimer = 0;
unsigned long effectTimer = 0;
int arrayLenght = 0;

const byte numLeds = 4;

unsigned long previousMillis = 0; // Таймер
const int interval = 1;         // Интервал мерцания (мс)

byte currentLed = 0;      // Текущий светодиод
int brightness = 0;       // Текущая яркость
bool fadingUp = true;     // Флаг увеличения яркости
unsigned long timerEndLed;
unsigned long timerEndLock;
unsigned long timerDoor;

// 2026-08-07: "day_off" приходит в ту же секунду, когда Чемоданы стали третьей
// пройденной игрой, и раньше рвал финал на полпути — см. обработчик day_off.
// Гасим подсветку не сразу, а когда финал отработает.
bool dayOffPending = false;
unsigned long dayOffTimer = 0;
const unsigned long DAY_OFF_DELAY_MS = 20000;  // 20 сек: замок успевает отбить ~6 импульсов

bool storyFlag;
int language=1;
bool afterEffect;
bool flagTrack = 0; 
unsigned long trackTimer = 0;
bool hintFlag = 1;
// Возврат hintFlag=1 в Chest реализован двумя механизмами (event от
// DFPlayer теряется библиотекой — см. clc-safe-dfplayer-fix):
//   1) ПОЛЛИНГ DFPlayer.readState() каждые HINT_POLL_INTERVAL_MS пока
//      идёт подсказка. Когда readState() возвращает 0 (STOPPED) или 2
//      (PAUSED) — значит подсказка отыграла, сбрасываем hintFlag=1.
//   2) BACKUP cooldown HINT_COOLDOWN_MS на случай если readState() тоже
//      возвращает мусор (UART glitch). Принудительный сброс через 20 сек.
const unsigned long HINT_COOLDOWN_MS = 20000UL;
const unsigned long HINT_POLL_INTERVAL_MS = 1000UL;  // опрос каждую секунду
const unsigned long HINT_POLL_DELAY_MS = 2000UL;     // не опрашивать первые 2с (трек точно играет)
unsigned long hintWentZeroAt = 0;
unsigned long hintPollNext = 0;
bool chestEndConfirmed = false;      // Флаг подтверждения от сервера

// ЗАЩИТА ОТ ГОНКИ КОМАНД (2026-07-29, жалоба клиента CLC2).
// Сервер шлёт команды на ESP32 АСИНХРОННО — каждую в отдельном потоке
// с retry (4 попытки, backoff 1→2→4с), см. send_esp32_command() в
// CastleServer.py. Поэтому порядок доставки НЕ гарантирован.
//
// Симптом: клиент быстро скипает уровни с пульта. Активация уровня 5
// шлёт "game", скип Чемоданов шлёт "skip". Если "game" задержался или
// ушёл в retry, он приходит ПОСЛЕ "skip" и откатывает state 3→1.
// Фон TRACK_FON_SUITCASE запускается заново и крутится вечно, потому
// что при state==1 он сам себя перезапускает по событию «трек кончился».
//
// stageFinished ставится при завершении этапа (победа или скип) и
// снимается только при старте новой игры (ready/start/restart).
// Пока он true — "game" игнорируется, состояние назад не откатывается.
bool stageFinished = false;
unsigned long chestEndSendTimer = 0; // Таймер для периодической отправки

// === DIAG MODE (см. [[clc-tech-pult-diag-panel]]) ===
bool diagModeActive = false;
unsigned long diagLastSnapshot = 0;
const unsigned long DIAG_SNAPSHOT_INTERVAL = 200;
void handleDiagSet(String body);
void sendDiagSnapshot();

// --- Системные треки (1-2) ---
const int TRACK_FON_SUITCASE = 1;
const int TRACK_SUITCASE_END = 2;

// --- Истории (3-29) ---
// Блок Story 8
const int TRACK_STORY_8_RU = 10;
const int TRACK_STORY_8_EN = 17;
const int TRACK_STORY_8_AR = 24;
const int TRACK_STORY_8_FR = 31;
const int TRACK_STORY_8_UK = 38;
const int TRACK_STORY_8_PL = 45;

// Блок Story 7
const int TRACK_STORY_7_RU = 9;
const int TRACK_STORY_7_EN = 16;
const int TRACK_STORY_7_AR = 23;
const int TRACK_STORY_7_FR = 30;
const int TRACK_STORY_7_UK = 37;
const int TRACK_STORY_7_PL = 44;

// --- Подсказки (5-29) ---
// Блок Hint 1
const int TRACK_HINT_1_RU = 12;
const int TRACK_HINT_1_EN = 19;
const int TRACK_HINT_1_AR = 26;
const int TRACK_HINT_1_FR = 33;
const int TRACK_HINT_1_UK = 40;
const int TRACK_HINT_1_PL = 47;

// Блок Hint 2
const int TRACK_HINT_2_RU = 13;
const int TRACK_HINT_2_EN = 20;
const int TRACK_HINT_2_AR = 27;
const int TRACK_HINT_2_FR = 34;
const int TRACK_HINT_2_UK = 41;
const int TRACK_HINT_2_PL = 48;

// Блок Hint 3
const int TRACK_HINT_3_RU = 14;
const int TRACK_HINT_3_EN = 21;
const int TRACK_HINT_3_AR = 28;
const int TRACK_HINT_3_FR = 35;
const int TRACK_HINT_3_UK = 42;
const int TRACK_HINT_3_PL = 49;

// Блок Hint 4
const int TRACK_HINT_4_RU = 15;
const int TRACK_HINT_4_EN = 22;
const int TRACK_HINT_4_AR = 29;
const int TRACK_HINT_4_FR = 36;
const int TRACK_HINT_4_UK = 43;
const int TRACK_HINT_4_PL = 50;

// Блок Hint 0
const int TRACK_HINT_0_RU = 11;
const int TRACK_HINT_0_EN = 18;
const int TRACK_HINT_0_AR = 25;
const int TRACK_HINT_0_FR = 32;
const int TRACK_HINT_0_UK = 39;
const int TRACK_HINT_0_PL = 46;

int hint_counter = 0;
int value = 30;

const char* ssid = "Castle";
const char* password = "questquest";
//const char* ssid = "ProducED";
//const char* password = "32744965";

// Настройки статического IP
IPAddress local_IP(192, 168, 4, 203);
IPAddress gateway(192, 168, 4, 1);
IPAddress subnet(255, 255, 255, 0);

const char* externalApi = "http://192.168.4.1:3000/api";

WebServer server(80);

GButton butt1(32);
GButton butt2(35);
GButton butt3(34);
GButton butt4(39);

GButton helpButton(36);

DFRobotDFPlayerMini myMP3;

void sendLogToServer(String payload) {
  if (WiFi.status() == WL_CONNECTED) {
    HTTPClient http;
    http.begin("http://192.168.4.1:3000/api");
    http.addHeader("Content-Type", "application/json");
    int httpCode = http.POST(payload);
    http.end();
  }
}

// --- ДОБАВЛЕНО: Функция для завершения игры (открытие + история) ---
void finalizeGame() {
  if (state == 4) return; // Защита от повторного срабатывания
  
  state = 4; // Переходим в финальное состояние
  OpenLock(SHERIF_EM2); // Открываем замок
  
  // Воспроизводим историю согласно языку
  if(language == 1) {
    myMP3.playMp3Folder(TRACK_STORY_8_RU);
    sendLogToServer("{\"log\":\"Chest: Playing Story 8 (RU)\"}");
  }
  else if(language == 2) {
    myMP3.playMp3Folder(TRACK_STORY_8_EN);
    sendLogToServer("{\"log\":\"Chest: Playing Story 8 (EN)\"}");
  }
  else if(language == 3) {
    myMP3.playMp3Folder(TRACK_STORY_8_AR);
    sendLogToServer("{\"log\":\"Chest: Playing Story 8 (AR)\"}");
  }
  else if(language == 4) {
    myMP3.playMp3Folder(TRACK_STORY_8_FR);
    sendLogToServer("{\"log\":\"Chest: Playing Story 8 (FR)\"}");
  }
  else if(language == 5) {
    myMP3.playMp3Folder(TRACK_STORY_8_UK);
    sendLogToServer("{\"log\":\"Chest: Playing Story 8 (UK)\"}");
  }
  else if(language == 6) {
    myMP3.playMp3Folder(TRACK_STORY_8_PL);
    sendLogToServer("{\"log\":\"Chest: Playing Story 8 (PL)\"}");
  }
  
  trackTimer = millis();
  flagTrack = 1; 
}
// ------------------------------------------------------------------

void setup() {
  // Отключаем встроенный Brown-Out Detector — фикс cold-boot WiFi fails
  // на слабом/шумном БП. См. [[clc-safe-esp32-power-issue]] в памяти.
  WRITE_PERI_REG(RTC_CNTL_BROWN_OUT_REG, 0);

  delay(2000);
  Serial.begin(115200);
  // Пауза перед включением периферии. При холодном пуске конденсаторы лент,
  // звукового модуля и самой платы ещё пустые: если поднимать всё это сразу,
  // бросок тока роняет питание. А встроенный детектор просадки у нас выключен
  // строкой выше — значит вместо честной перезагрузки чип просто зависает, и
  // устройство «не стартует, пока не нажмёшь EN». Проверено на поезде CLC4
  // 13.08.2026: без паузы не поднимался ни разу, с паузой — три холодных
  // пуска подряд из трёх.
  delay(STARTUP_SETTLE_MS);

  mySerial.begin(9600, SERIAL_8N1, 16, 17);

  arrayLenght = sizeof(ledsSym) / sizeof(int);
  for (int i = 0; i < arrayLenght; i++)
  {
    pinMode(ledsSym[i], OUTPUT);
    digitalWrite(ledsSym[i], LOW);
  }

  butt1.setDebounce(50);        // настройка антидребезга (по умолчанию 80 мс)
  butt1.setTimeout(300);        // настройка таймаута на удержание (по умолчанию 500 мс)
  butt1.setClickTimeout(600);   // настройка таймаута между кликами (по умолчанию 300 мс)
  butt1.setType(HIGH_PULL);
  butt1.setDirection(NORM_OPEN);
  //------
  butt2.setDebounce(50);        // настройка антидребезга (по умолчанию 80 мс)
  butt2.setTimeout(300);        // настройка таймаута на удержание (по умолчанию 500 мс)
  butt2.setClickTimeout(600);   // настройка таймаута между кликами (по умолчанию 300 мс)
  butt2.setType(HIGH_PULL);
  butt2.setDirection(NORM_OPEN);
  ////-------
  butt3.setDebounce(50);        // настройка антидребезга (по умолчанию 80 мс)
  butt3.setTimeout(300);        // настройка таймаута на удержание (по умолчанию 500 мс)
  butt3.setClickTimeout(600);   // настройка таймаута между кликами (по умолчанию 300 мс)
  butt3.setType(HIGH_PULL);
  butt3.setDirection(NORM_OPEN);
  ///////////------
  butt4.setDebounce(50);        // настройка антидребезга (по умолчанию 80 мс)
  butt4.setTimeout(300);        // настройка таймаута на удержание (по умолчанию 500 мс)
  butt4.setClickTimeout(600);   // настройка таймаута между кликами (по умолчанию 300 мс)
  butt4.setType(HIGH_PULL);
  butt4.setDirection(NORM_OPEN);

  helpButton.setDebounce(50);        // настройка антидребезга (по умолчанию 80 мс)
  helpButton.setTimeout(300);        // настройка таймаута на удержание (по умолчанию 500 мс)
  helpButton.setClickTimeout(600);   // настройка таймаута между кликами (по умолчанию 300 мс)
  helpButton.setType(HIGH_PULL);
  helpButton.setDirection(NORM_OPEN);

  pinMode(mistakeLed, OUTPUT); 
  digitalWrite(mistakeLed, LOW);

  pinMode(insideLed, OUTPUT);
  digitalWrite(insideLed, LOW);

  pinMode(SHERIF_EM2, OUTPUT);
  digitalWrite(SHERIF_EM2, LOW);

  pinMode(eyeSymbolGerkon, INPUT);
  
  // Подключение к Wi-Fi
  //WiFi.begin(ssid, password);
  if (!myMP3.begin(mySerial)) {
    Serial.println("DFPlayer Mini not detected!");
  }    
  myMP3.volume(value);
  myMP3.stop();

  if (!WiFi.config(local_IP, gateway, subnet)) {
  Serial.println("STA Failed to configure");
  }

  WiFi.persistent(true);
  WiFi.setAutoReconnect(true);
  WiFi.begin(ssid, password);

  unsigned long wifiStart = millis();
  while (WiFi.status() != WL_CONNECTED) {
    if (millis() - wifiStart > 15000UL) {
      Serial.println("WiFi connect timeout — restarting ESP32");
      delay(500);
      ESP.restart();
    }
    delay(1000);
    Serial.println("Connecting to WiFi...");
  }

  Serial.println("\nWiFi connected");
  Serial.println("IP address: " + WiFi.localIP().toString());
  sendLogToServer("{\"log\":\"ESP32 Chest is ready. IP: " + WiFi.localIP().toString() + "\"}");

  // --- НАСТРОЙКА OTA  ---
  ArduinoOTA.setHostname("Chest-ESP32"); // Имя устройства в сети
  
  ArduinoOTA.onStart([]() {
    String type = (ArduinoOTA.getCommand() == U_FLASH) ? "sketch" : "filesystem";
    // Отключаем все моторы/светодиоды для безопасности
    Serial.println("Start updating " + type);
    // Можно добавить сюда выключение strip.clear()
  });
  ArduinoOTA.onEnd([]() {
    Serial.println("\nEnd");
  });
  ArduinoOTA.onProgress([](unsigned int progress, unsigned int total) {
    // Можно мигать светодиодом, но необязательно
  });
  ArduinoOTA.onError([](ota_error_t error) {
    Serial.printf("Error[%u]: ", error);
    if (error == OTA_AUTH_ERROR) Serial.println("Auth Failed");
    else if (error == OTA_BEGIN_ERROR) Serial.println("Begin Failed");
    else if (error == OTA_CONNECT_ERROR) Serial.println("Connect Failed");
    else if (error == OTA_RECEIVE_ERROR) Serial.println("Receive Failed");
    else if (error == OTA_END_ERROR) Serial.println("End Failed");
  });

  ArduinoOTA.begin();
  Serial.println("OTA Ready");
  // ---------------------------------------------

  server.on("/", HTTP_GET, []() {
    server.send(200, "text/plain", "ESP32 Server is running");
  });

  server.on("/data", HTTP_POST, []() {
    if (server.hasArg("plain")) {
      String body = server.arg("plain");
      sendLogToServer("{\"log\":\"Chest received command: " + body + "\"}");

      // === DIAG MODE ===
      if (body == "\"diag_on\"") {
        diagModeActive = true;
        myMP3.stop();
        digitalWrite(SHERIF_EM2, LOW);
        digitalWrite(mistakeLed, LOW);
        digitalWrite(insideLed, LOW);
        for (int i = 0; i < arrayLenght; i++) analogWrite(ledsSym[i], 0);
        Serial.println("DIAG ON");
        server.send(200, "application/json", "{\"status\":\"diag_on\"}");
        return;
      }
      if (body == "\"diag_off\"") {
        diagModeActive = false;
        digitalWrite(SHERIF_EM2, LOW);
        digitalWrite(mistakeLed, LOW);
        digitalWrite(insideLed, LOW);
        for (int i = 0; i < arrayLenght; i++) analogWrite(ledsSym[i], 0);
        myMP3.stop();
        state = 0;
        Serial.println("DIAG OFF");
        server.send(200, "application/json", "{\"status\":\"diag_off\"}");
        return;
      }
      if (body.startsWith("\"diag_set:")) {
        handleDiagSet(body);
        server.send(200, "application/json", "{\"status\":\"diag_set\"}");
        return;
      }
      if (diagModeActive) {
        Serial.println("DIAG ignored: " + body);
        server.send(200, "application/json", "{\"status\":\"ignored_diag\"}");
        return;
      }
      // === END DIAG ===

      if(body == "\"game\""){
        // Этап уже пройден (победа или скип) — это опоздавший/повторный
        // "game" из-за асинхронной доставки. Игнорируем, иначе фон
        // запустится заново и будет играть до конца квеста.
        if (stageFinished) {
          sendLogToServer("{\"log\":\"Chest: 'game' IGNORED - stage already finished (race guard)\"}");
          server.send(200, "application/json", "{\"status\":\"ignored_finished\"}");
          return;
        }
        state = 1;
        myMP3.playMp3Folder(TRACK_FON_SUITCASE);
        sendLogToServer("{\"log\":\"Chest: Playing Fon Suitcase sound\"}");
        //myMP3.enableLoop();
        hint_counter = 0;
        isMistake = false;
        score = 0;
        storyFlag=0;
        buttonSequence = 0;
        for (int i = 0; i < arrayLenght; i++)
        {
          analogWrite(ledsSym[i], 0);
        }
        butt1.resetStates();
        butt2.resetStates();
        butt3.resetStates();
        butt4.resetStates();
      }
      if(body == "\"restart\""){
        state = 6;
        for (int i = 0; i < arrayLenght; i++)
        {
          analogWrite(ledsSym[i], 255);
        }
        myMP3.stop();
        digitalWrite(insideLed, HIGH);
        OpenLock(SHERIF_EM2);
        chestEndConfirmed = false; // ИЗМЕНЕНИЕ: Сбрасываем флаг
        dayOffPending = false;     // 2026-08-07: снимаем отложенное гашение от прошлой игры
        stageFinished = false;     // новая игра — снимаем защиту от гонки
      }
      if(body == "\"ready\""){
        state = 0;
        for (int i = 0; i < arrayLenght; i++)
        {
          analogWrite(ledsSym[i], 0);
        }
        myMP3.stop();
        digitalWrite(insideLed, LOW);
        chestEndConfirmed = false; // ИЗМЕНЕНИЕ: Сбрасываем флаг
        dayOffPending = false;     // 2026-08-07: снимаем отложенное гашение от прошлой игры
        stageFinished = false;     // новая игра — снимаем защиту от гонки
      }
      // Добавляем обработку подтверждения от сервера
      if (body == "\"confirm_suitcase_end\"") {
        chestEndConfirmed = true;
      }
      if(body == "\"day_on\""){
        state = 6;
        for (int i = 0; i < arrayLenght; i++)
        {
          analogWrite(ledsSym[i], 255);
        }
        digitalWrite(insideLed, HIGH);
      }
      if(body == "\"day_off\""){
        // 2026-08-07. Раньше здесь сразу стояло state = 6, и это ломало замок.
        // Сервер шлёт day_off в тот момент, когда пройдена ТРЕТЬЯ из трёх игр.
        // Если третьими оказались Чемоданы, day_off прилетает в ту же секунду,
        // когда мы только вошли в state 3 (этап пройден, идёт финальный джингл),
        // а finalizeGame() — тот, кто открывает замок — вызывается лишь через
        // 2 секунды. state = 6 выбрасывал нас из state 3 раньше срока:
        //   - finalizeGame() не вызывался вообще → одиночный OpenLock не звучал;
        //   - периодическая пульсация ниже работает только при state 4..5 → тоже нет.
        // Итог: замок не открывался НИ РАЗУ, сундук оставался запертым.
        // Логи CLC2 07.08: 03:16:28 THREE GAMES DONE → day_off, 03:16:29 {'suitcase':'end'}.
        // Теперь: сначала даём финалу отработать, гасим подсветку с задержкой.
        if (state == 3) {
          finalizeGame();   // открыть замок и доиграть историю, раз этап уже пройден
        }
        dayOffPending = true;
        dayOffTimer = millis();
      }
      if (body == "\"chest_mode_easy\"") {
        chestEasyMode = true;
        sendLogToServer("{\"log\":\"Chest: easy mode ON\"}");
        server.send(200, "application/json", "{\"status\":\"chest_mode_easy\"}");
        return;
      }
      if (body == "\"chest_mode_normal\"") {
        chestEasyMode = false;
        sendLogToServer("{\"log\":\"Chest: easy mode OFF\"}");
        server.send(200, "application/json", "{\"status\":\"chest_mode_normal\"}");
        return;
      }
      if (body == "\"volume_up\"") {
        value = value + 1;
        if (value >= 30) value = 30;
        myMP3.volume(value);
        Serial.println(value);
      }

      if (body == "\"volume_down\"") {
        value = value - 1;
        if (value <= 0) value = 0;
        myMP3.volume(value);
        Serial.println(value);
      }

      if (body.startsWith("\"set_level_")) {
    // Извлекаем число из строки "set_level_25"
    int startPos = body.indexOf('_', 6) + 1; // Находим позицию после второго '_'
    int endPos = body.lastIndexOf('"'); // Находим позицию закрывающей кавычки
    
    if (startPos > 0 && endPos > startPos) {
        String levelStr = body.substring(startPos, endPos);
        int newLevel = levelStr.toInt();
        
        // Проверяем корректность уровня (например, от 0 до 30)
        if (newLevel >= 0 && newLevel <= 30) {
            value = newLevel;
            myMP3.volume(value);
            Serial.print("Установлена громкость: ");
            Serial.println(value);
        } else {
            Serial.println("Некорректный уровень громкости");
        }
    }
    sendLogToServer("{\"log\":\"ESP32 Chest is ready. IP: 192.168.4.203\"}");
}

      if(body == "\"start\""){
        state = 0;
        isMistake = false;
        score = 0;
        storyFlag=0;
        buttonSequence = 0;
        butt1.resetStates();
        butt2.resetStates();
        butt3.resetStates();
        butt4.resetStates();
        myMP3.stop();
        hintFlag = 1;
        chestEndConfirmed = false; // ИЗМЕНЕНИЕ: Сбрасываем флаг
        dayOffPending = false;     // 2026-08-07: снимаем отложенное гашение от прошлой игры
        stageFinished = false;     // новая игра — снимаем защиту от гонки
      }
      if(body == "\"language_1\""){
        language = 1;
      }
      if(body == "\"language_2\""){
        language = 2;
      }
      if(body == "\"language_3\""){
        language = 3;
      }
      if(body == "\"language_4\""){
        language = 4;
      }
      if(body == "\"language_5\""){
        language = 5;
      }
      if(body == "\"language_6\""){
        language = 6;
      }
      if(body == "\"open_door\""){
        OpenLock(SHERIF_EM2);
        state = 6;
      }
      if(body == "\"skip\""){
        //OpenLock(SHERIF_EM2);
        stageFinished = true;   // этап закрыт — не давать "game" откатить состояние
        timerEndLed = millis();
        timerEndLock = millis();
        flagTrack = 0; 
        trackTimer = millis();
        state = 3;
        myMP3.disableLoop();
        myMP3.stop();
        delay(50);
        myMP3.playMp3Folder(TRACK_SUITCASE_END);
        sendLogToServer("{\"log\":\"Chest: Playing Suitcase End sound\"}");
      }
      if(body == "\"firework\""){
        state = 5; // Устанавливаем состояние 5, которое вы создали для эффекта
      }
      
      Serial.println("Received POST: " + body);
      server.send(200, "application/json", "{\"status\":\"received\"}");
    } else {
      server.send(400, "text/plain", "Bad Request");
    }
  });
  
  server.begin();
  Serial.println("HTTP server started");
}

void loop() {
  ArduinoOTA.handle();
  if (Serial.available() > 0) {
    String command = Serial.readStringUntil('\n');
    command.trim(); // Убираем лишние пробелы и символы переноса строки

    if (command == "firework") {
      state = 5; // Переключаемся в состояние фейерверка
    } else {
      // Если пришла любая другая команда, выключаем светодиоды и переходим в базовое состояние
      if (state == 5) {
        for (int i = 0; i < arrayLenght; i++) {
          analogWrite(ledsSym[i], 0);
        }
        state = 0; // Возвращаемся в состояние ожидания
      }
    }
  }
  server.handleClient();

  // === DIAG MODE: ранний выход, игнорируем игровую логику ===
  if (diagModeActive) {
    if (millis() - diagLastSnapshot >= DIAG_SNAPSHOT_INTERVAL) {
      diagLastSnapshot = millis();
      sendDiagSnapshot();
    }
    return;
  }
  // === END DIAG ===

  // 2026-08-03: watchdog потери WiFi (перенесён из safe.ino, где работает в
  // проде). Раньше здесь был голый reconnect + delay(2000): если переподключение
  // не удавалось, устройство висело в этом цикле бесконечно и само не
  // восстанавливалось — требовалось снятие питания башни вручную (кейс Волка
  // 29.07 и Поезда 03.08). Плюс delay(2000) блокировал loop целиком.
  // Теперь: попытка reconnect не чаще раза в 10 сек, а если связи нет дольше
  // 60 сек — перезагружаем ESP32, она поднимется и подключится заново.
  {
    static unsigned long lastReconnectAttempt = 0;
    static unsigned long wifiDownSince = 0;
    if (WiFi.status() != WL_CONNECTED) {
      if (wifiDownSince == 0) wifiDownSince = millis();
      if (millis() - lastReconnectAttempt > 10000UL) {
        lastReconnectAttempt = millis();
        Serial.println("WiFi lost — reconnecting");
        WiFi.reconnect();
      }
      if (millis() - wifiDownSince > 60000UL) {
        Serial.println("WiFi down >60s — restarting ESP32");
        delay(500);
        ESP.restart();
      }
    } else {
      wifiDownSince = 0;   // соединение в порядке
    }
  }
  handlePlayerQueries();

  // === HINT FINISH DETECTION (см. константы выше) ===
  static bool prevHintFlag = true;
  if (prevHintFlag && !hintFlag) {
    // Только что нажали геркон → подсказка стартовала. Засекаем время и
    // расписание первого опроса.
    hintWentZeroAt = millis();
    hintPollNext = hintWentZeroAt + HINT_POLL_DELAY_MS;
  }
  prevHintFlag = hintFlag;

  if (!hintFlag) {
    // 1) ПОЛЛИНГ readState() — если DFPlayer уже stopped/paused, сбрасываем
    //    hintFlag=1 быстро (быстрее чем cooldown). myMP3.readState() блокирует
    //    loop до ~500ms — поэтому не вызываем чаще раз в секунду.
    //    State codes: 0=STOPPED, 1=PLAYING, 2=PAUSED.
    if (millis() >= hintPollNext) {
      hintPollNext = millis() + HINT_POLL_INTERVAL_MS;
      int s = myMP3.readState();
      if (s == 0 || s == 2) {
        hintFlag = 1;
        Serial.print("[hint-poll] DFPlayer state="); Serial.print(s);
        Serial.println(" → reset hintFlag=1");
      }
    }
    // 2) BACKUP COOLDOWN — если polling тоже не сработал, через 20 сек
    //    принудительно сбрасываем.
    if (!hintFlag && (millis() - hintWentZeroAt) >= HINT_COOLDOWN_MS) {
      hintFlag = 1;
      Serial.println("[hint-cooldown] forced reset hintFlag=1");
    }
  }

  helpButton.tick();
  if(helpButton.isPress()){
    Serial.println("1");
    if(state == 0 && hintFlag){
      myMP3.pause(); // Ставим фоновую музыку на паузу
      delay(50);
      if(language == 1){
        myMP3.playMp3Folder(TRACK_HINT_0_RU);
        sendLogToServer("{\"log\":\"Chest: Playing Hint 0 (RU)\"}");
      }
      if(language == 2){
        myMP3.playMp3Folder(TRACK_HINT_0_EN);
        sendLogToServer("{\"log\":\"Chest: Playing Hint 0 (EN)\"}");
      }
      if(language == 3){
        myMP3.playMp3Folder(TRACK_HINT_0_AR);
        sendLogToServer("{\"log\":\"Chest: Playing Hint 0 (AR)\"}");
      }
      if(language == 4){
        myMP3.playMp3Folder(TRACK_HINT_0_FR);
        sendLogToServer("{\"log\":\"Chest: Playing Hint 0 (FR)\"}");
      }
      if(language == 5){
        myMP3.playMp3Folder(TRACK_HINT_0_UK);
        sendLogToServer("{\"log\":\"Chest: Playing Hint 0 (UK)\"}");
      }
      if(language == 6){
        myMP3.playMp3Folder(TRACK_HINT_0_PL);
        sendLogToServer("{\"log\":\"Chest: Playing Hint 0 (PL)\"}");
      }
      hintFlag = 0;
    }
    if(state > 0 && state < 3 && hintFlag){
      myMP3.pause(); // Ставим фоновую музыку на паузу
      delay(50);
      Serial.println(hint_counter);
      if(hint_counter == 0) {
          if(language == 1){
            myMP3.playMp3Folder(TRACK_HINT_1_RU);
            sendLogToServer("{\"log\":\"Chest: Playing Hint 1 (RU)\"}");
          }
          if(language == 2){
            myMP3.playMp3Folder(TRACK_HINT_1_EN);
            sendLogToServer("{\"log\":\"Chest: Playing Hint 1 (EN)\"}");
          }
          if(language == 3){
            myMP3.playMp3Folder(TRACK_HINT_1_AR);
            sendLogToServer("{\"log\":\"Chest: Playing Hint 1 (AR)\"}");
          }
          if(language == 4){
            myMP3.playMp3Folder(TRACK_HINT_1_FR);
            sendLogToServer("{\"log\":\"Chest: Playing Hint 1 (FR)\"}");
          }
          if(language == 5){
            myMP3.playMp3Folder(TRACK_HINT_1_UK);
            sendLogToServer("{\"log\":\"Chest: Playing Hint 1 (UK)\"}");
          }
          if(language == 6){
            myMP3.playMp3Folder(TRACK_HINT_1_PL);
            sendLogToServer("{\"log\":\"Chest: Playing Hint 1 (PL)\"}");
          }
      }
      if(hint_counter == 1) {
        if(language == 1){
          myMP3.playMp3Folder(TRACK_HINT_2_RU);
          sendLogToServer("{\"log\":\"Chest: Playing Hint 2 (RU)\"}");
        }
        if(language == 2){
          myMP3.playMp3Folder(TRACK_HINT_2_EN);
          sendLogToServer("{\"log\":\"Chest: Playing Hint 2 (EN)\"}");
        }
        if(language == 3){
          myMP3.playMp3Folder(TRACK_HINT_2_AR);
          sendLogToServer("{\"log\":\"Chest: Playing Hint 2 (AR)\"}");
        }
        if(language == 4){
          myMP3.playMp3Folder(TRACK_HINT_2_FR);
          sendLogToServer("{\"log\":\"Chest: Playing Hint 2 (FR)\"}");
        }
        if(language == 5){
          myMP3.playMp3Folder(TRACK_HINT_2_UK);
          sendLogToServer("{\"log\":\"Chest: Playing Hint 2 (UK)\"}");
        }
        if(language == 6){
          myMP3.playMp3Folder(TRACK_HINT_2_PL);
          sendLogToServer("{\"log\":\"Chest: Playing Hint 2 (PL)\"}");
        }
      }
      if(hint_counter == 2) {
        if(language == 1){
          myMP3.playMp3Folder(TRACK_HINT_3_RU);
          sendLogToServer("{\"log\":\"Chest: Playing Hint 3 (RU)\"}");
        }
        if(language == 2){
          myMP3.playMp3Folder(TRACK_HINT_3_EN);
          sendLogToServer("{\"log\":\"Chest: Playing Hint 3 (EN)\"}");
        }
        if(language == 3){
          myMP3.playMp3Folder(TRACK_HINT_3_AR);
          sendLogToServer("{\"log\":\"Chest: Playing Hint 3 (AR)\"}");
        }
        if(language == 4){
          myMP3.playMp3Folder(TRACK_HINT_3_FR);
          sendLogToServer("{\"log\":\"Chest: Playing Hint 3 (FR)\"}");
        }
        if(language == 5){
          myMP3.playMp3Folder(TRACK_HINT_3_UK);
          sendLogToServer("{\"log\":\"Chest: Playing Hint 3 (UK)\"}");
        }
        if(language == 6){
          myMP3.playMp3Folder(TRACK_HINT_3_PL);
          sendLogToServer("{\"log\":\"Chest: Playing Hint 3 (PL)\"}");
        }
      }
      hintFlag = 0;
      hint_counter++;
      if(hint_counter>2){
        hint_counter=0;
      }
    }
    // 2026-08-14: было state > 3, и состояние 3 не ловила ни одна ветка —
    // ровно та же дыра, что нашлась у Волка. А состояние 3 это «этап пройден,
    // играет финальный джингл», то есть именно тот момент, когда игрок должен
    // услышать выделенную подсказку про пройденный уровень. Замок при этом
    // открывается по таймеру, а не по концу трека, так что перебить джингл
    // подсказкой безопасно.
    if(state >= 3 && hintFlag){
      if(language == 1){
        myMP3.playMp3Folder(TRACK_HINT_4_RU);
        sendLogToServer("{\"log\":\"Chest: Playing Hint 4 (RU)\"}");
      }
      if(language == 2){
        myMP3.playMp3Folder(TRACK_HINT_4_EN);
        sendLogToServer("{\"log\":\"Chest: Playing Hint 4 (EN)\"}");
      }
      if(language == 3){
        myMP3.playMp3Folder(TRACK_HINT_4_AR);
        sendLogToServer("{\"log\":\"Chest: Playing Hint 4 (AR)\"}");
      }
      if(language == 4){
        myMP3.playMp3Folder(TRACK_HINT_4_FR);
        sendLogToServer("{\"log\":\"Chest: Playing Hint 4 (FR)\"}");
      }
      if(language == 5){
        myMP3.playMp3Folder(TRACK_HINT_4_UK);
        sendLogToServer("{\"log\":\"Chest: Playing Hint 4 (UK)\"}");
      }
      if(language == 6){
        myMP3.playMp3Folder(TRACK_HINT_4_PL);
        sendLogToServer("{\"log\":\"Chest: Playing Hint 4 (PL)\"}");
      }
      hintFlag = 0;
    }
  }

  //Serial.println(!digitalRead(eyeSymbolGerkon));
 switch (state) {
   case 0:
     for (int i = 0; i < arrayLenght; i++)
     {
       analogWrite(ledsSym[i], 0);
     }
     digitalWrite(insideLed, LOW);
     digitalWrite(mistakeLed, LOW);
     break;
   case 1:
     digitalWrite(insideLed, HIGH);
     ButtonSymbols();
     break;
   case 2:
     SymbolEye();
     break;
   case 3:
      // Периодически отправляем, пока не получим подтверждение
      if (!chestEndConfirmed) {
        if (millis() - chestEndSendTimer > 1000) {
          SendData();
          chestEndSendTimer = millis();
        }
      }
      randomTwinkleEffect();
      // --- Страховочный таймаут ---
      // 2026-08-05: сокращено с 5000 до 2000мс. Жалоба клиента: головоломка
      // решена (индикатор на пульте зелёный), но сундук "не открывался
      // автоматически" — на деле открывался, но через полные 5 сек, потому
      // что DFPlayer-событие finishedTrack==TRACK_SUITCASE_END ненадёжно
      // (тот же класс бага что уже чинили на Safe, см. память clc-safe-
      // dfplayer-fix) и почти всегда срабатывал именно safety-таймаут,
      // не событие. 5 сек ощущались как "не работает". 2 сек — компромисс:
      // короче для игрока, но не обрезает большинство коротких success-джинглов.
      if (millis() - timerEndLed > 2000) {
         sendLogToServer("{\"log\":\"Chest: Force finish by timeout\"}");
         finalizeGame();
      }
      // ---------------------------------------
     break;
    case 4:
    //if(myMP3.readState() == 512){
    //  OpenLock(SHERIF_EM2);
    //  state++;
    //}
     for (int i = 0; i < arrayLenght; i++)
     {
       analogWrite(ledsSym[i], 255);
     }
     //digitalWrite(insideLed, LOW);
     break;
   case 5: // Состояние для эффекта "firework"
     randomTwinkleEffect();
     break;
 }

 if(state > 3 && state < 6){
  if(millis()-timerDoor >= 3000){
    OpenLock(SHERIF_EM2);
    timerDoor = millis();
  }
 }

 // Отложенное гашение подсветки по day_off (см. обработчик day_off).
 // Ждём, пока финал отработает и замок отобьёт свои импульсы, и только
 // потом уводим устройство в "спящий" state 6.
 if(dayOffPending && millis() - dayOffTimer >= DAY_OFF_DELAY_MS){
   dayOffPending = false;
   state = 6;
   for (int i = 0; i < arrayLenght; i++)
   {
     analogWrite(ledsSym[i], 0);
   }
   digitalWrite(insideLed, LOW);
 }
}

void SendData(){
  if (WiFi.status() == WL_CONNECTED) {
    sendLogToServer("{\"log\":\"Suitcase game finished, sending 'end' to server.\"}");
    HTTPClient http;
    http.begin(externalApi);
    http.addHeader("Content-Type", "application/json");
    // Пример POST-запроса
    String payload = "{\"suitcase\":\"end\"}";
    int httpCode = http.POST(payload);
    http.end();
  }
}


//двигалки
void SymbolEye() {
  static bool flag;
    butt1.tick();
    butt2.tick();
    butt3.tick();
    butt4.tick();

  // В лёгком режиме кнопки держать не нужно: собрал пазл — этап закрыт.
  bool holdOk = chestEasyMode || (butt1.isHold() && butt2.isHold()
                                  && butt3.isHold() && butt4.isHold());
  if (!digitalRead(eyeSymbolGerkon) && holdOk) {
    if (millis() - eyeSymbolTimer >= 500) {
      
      // --- НАЧАЛО ИЗМЕНЕНИЯ ---
      // Вместо одиночной отправки, переходим в состояние 3 и позволяем loop() отправлять данные
      if (state != 3) { // Переходим в состояние 3 только один раз
          Serial.println("wineye");
          stageFinished = true;   // этап закрыт — не давать "game" откатить состояние
          myMP3.pause();
          delay(50);
          myMP3.playMp3Folder(TRACK_SUITCASE_END);
          sendLogToServer("{\"log\":\"Chest: Playing Suitcase End sound\"}");
          timerEndLed = millis();
          timerEndLock = millis();
          flagTrack = 0;
          trackTimer = millis();
          state = 3; // Переходим в состояние отправки и анимации
          flag = 0;
      }
      // --- КОНЕЦ ИЗМЕНЕНИЯ ---
    }
  }
  else eyeSymbolTimer = millis();
  
  if(!chestEasyMode && (!butt1.isHold() || !butt2.isHold() || !butt3.isHold() || !butt4.isHold())){
    state = 1; // Возвращаемся к предыдущему состоянию, если кнопки отпустили
    for (int i = 0; i < arrayLenght; i++)
    {
      analogWrite(ledsSym[i], 0);
    }
  }
}
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
