ProducED-ed/Castle/(commit log)

2025-10-02 feat: Implement non-blocking repeating lock and refactor delays
    This commit introduces two major improvements:
    1. A new feature where the lock opens every 10 seconds after game completion.
    2. A significant refactoring to remove blocking `delay()` calls, replacing them with a non-blocking `millis()`-based approach.
    Key changes:
    - Implemented a repeating lock mechanism in state 6 using a timer.
    - Refactored the `OpenLock()` function to be non-blocking by introducing state variables (`lockIsOpening`, `lockOpenStartTime`) and a new `handleLock()` function.
    - Refactored the `MoonGame()` function to remove a `delay(150)`, preventing the main loop from freezing.
    - Removed unused variables (`lockSt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
    [wolf.ino]
2025-10-02 feat: Update WolfGame logic for win condition
    This commit modifies the game logic in the `WolfGame` state (state 4) to make it more intuitive.
    - The `wolfEyeLed` now only lights up when the `leftCloudGerk` is actively held down.
    - The win condition (pressing `wolfGerk`) is now only possible while the `wolfEyeLed` is lit.
    - Releasing the `leftCloudGerk` no longer resets the game state, allowing the player to try again without starting over.
    [wolf.ino]
2025-10-06 Update dog.ino
    Изменил интервалы для story у вращающейся клетки
2025-10-06 Update wolf.ino
    Изменил нумерацию треков
2025-10-06 Update chest.ino
    Добавил обработку сообщения firework
2025-10-07 Update wolf.ino
    Изменил запуск первого трека на глазе волка. Теперь звучат объединенные (эффект + стори) на разных языках
2025-10-07 Update train.ino
    Добавил пульсацию и изменил логику flag_off
2025-10-08 Update train.ino
    Пофиксил пульцацию активных для клика светодиодов.
2025-10-08 Update wolf.ino
    Убрал задержку выключения подсветки глаза волка.
2025-10-08 Update basket3.ino
    Убрал свечение кристаллов тролля, которые надо найти еще.
2025-10-08 Update MAIN_BOARD_V5_COM5.ino
    Файл прислал Нияз, что исправлено не знаю
    [MAIN_BOARD_V5_COM5.ino]
2025-10-08 Update train.ino
    Добавил traine_engine3
    И обновил логику игры
    И подсказки теперь не обрывают звук traine_engine
2025-10-09 Update MAIN_BOARD_V5_COM5.ino
    Фикс компиляции.
2025-10-09 Update train.ino
    Фикс карты
2025-10-09 Update MAIN_BOARD_V5_COM5.ino
    Исправил баг с загадкой вправо-влево
    [MAIN_BOARD_V5_COM5.ino]
2025-10-11 Update train.ino
    Теперь тролль будет активен не дожидаясь окончания трека поезда.
2025-10-11 Update wolf.ino
    Добавлен салют
2025-10-11 Update workshop.ino
    фикс
2025-10-11 Update owls.ino
    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
2025-10-13 Update CastleServer.py
    Проблема №1: Молчаливые сбои сервера.
    Симптом: Сервер падал без ошибок.
    Решение: Мы исправили блок try...except, чтобы видеть реальные ошибки. Это был диагностический шаг.
    Проблема №2: Браузер не находил сервер.
    Симптом: Ошибка http://:.
    Решение: Мы явно прописали адрес http://127.0.0.1:3000 в scripts.js.
    Проблема №3: Несовместимость "языка" клиента и сервера.
    Симптом: Ошибки Invalid frame hea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
    [CastleServer.py]
2025-10-13 Update Front.html
    <script src="/socket.io/socket.io.js"></script>
2025-10-13 Update scripts.js
    Решение: Мы явно прописали адрес http://127.0.0.1:3000 в scripts.js
    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
2025-10-15 Update basket3.ino
    Изменил счет до 3
2025-10-15 Update CastleServer.py
    Отправка на поезд выключение тролля
2025-10-15 Update MAIN_BOARD_V5_COM5.ino
    Теперь 2 уровня у мозга
2025-10-15 Update MAIN_BOARD_V5_COM5.ino
    Изменена последовательность hints директора
2025-10-15 Update MAIN_BOARD_V5_COM5.ino
    Изменил порядок подсказок некоторых персонажей
2025-10-15 Update train.ino
    исправлено отображение библиотеки на карте.
    [train.ino]
2025-10-15 Update MAIN_BOARD_V5_COM5.ino
    Обновил исчезновение мальчика после прохождения библиотеки.
2025-10-15 Update MAIN_BOARD_V5_COM5.ino
    Изменил время появления красного мяча (перехвата соперником)
2025-10-15 Update MAIN_BOARD_V5_COM5.ino
    Фикс логики с бутылками (но не проверял)
2025-10-16 fix: for raspberry
2025-10-16 Update MAIN_BOARD_V5_COM5.ino
    У void RestOn() сделал level = 0, вместо 30
2025-10-16 Update MAIN_BOARD_V5_COM5.ino
    Добавил rfidCooldownEnd = millis() + 250; для бутылочек (не проверял)
2025-10-16 Update MAIN_BOARD_V5_COM5.ino
    Изменил порядок подсказок hint_49_b,с
2025-10-17 Update train.ino
    Добавлен механизм подтверждения сообщений ("send and confirm").
2025-10-17 Update CastleServer.py
    Добавлен механизм подтверждения ("send and confirm") с поездом.
2025-10-17 Update MAIN_BOARD_V5_COM5.ino
    rfidCooldownEnd = millis() + 500; // Запускаем "охлаждение" на 500 мс
2025-10-17 Update wolf.ino
    Добавил механизм подтверждения ("send and confirm")
2025-10-17 Update safe.ino
    Добавил механизм подтверждения ("send and confirm").
2025-10-17 Update chest.ino
    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
2025-10-17 Update CastleServer.py
    Дополнил механизм подтверждения ("send and confirm"). волк,чемоданы, сейф
2025-10-17 Update MAIN_BOARD_V5_COM5.ino
    if (buff == "student_hide") {
    boyServo.attach(49); принудительно назначаю 49 пин, иначе мальчик не отворачивался.
2025-10-17 Update MAIN_BOARD_V5_COM5.ino
    Убрал дублирующиеся сообщения
2025-10-17 Update scripts.js
    Блокировка кнопки ready
2025-10-17 Update CastleServer.py
    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
2025-10-18 Update train.ino
    Остался баг со светодиодом тролля, он не гаснет после прохождения тролля.
2025-10-19 Update train.ino
    светодиод тролля при скип и прохождении работает теперь правильно.
2025-10-19 Update MAIN_BOARD_V5_COM5.ino
    Фикс бутылочек и подсказок макгонагл
2025-10-19 Update CastleServer.py
    У собаки story через 2 сек после открытия.
2025-10-19 Update CastleServer.py
    Тролль говорит через 2 сек. после открытия комнаты
2025-10-19 Update train.ino
    фикс активных светодиодов
2025-10-20 Update CastleServer.py
    добавил звук сработки play_effect(owl_flew) при 4-ой отправки сов.
2025-10-21 Фикс карты lED
    map_enable_clicks
    map_disable_clicks
2025-10-22 Добавлен салют
2025-10-22 fix: modal and firework
    [CastleServer.py, MAIN_BOARD_V5_COM5.ino]
2025-10-23 Новая логика игры со стрелками центральной башни.
2025-10-23 Убрал отладочный код игры со свайпами (стрелки)
2025-10-23 Update игры с бутылками
2025-10-23 Update у бутылками, небольшой фикс
2025-10-23 Фикс сработки совы на башне
2025-10-23 Update MAIN_BOARD_V5_COM5.ino
    Вернул light_on и light_off
2025-10-24 Добавил флаги для skip
    [MAIN_BOARD_V5_COM5.ino]
2025-10-24 Добавил звуки для свайпов
2025-10-25 fix много всего
2025-10-28 Update MAIN_BOARD_V5_COM5.ino
    Скип Мансарды теперь прячет мальчика.
2025-10-28 Update CastleServer.py
    Обновление таймера
    if go == 2 or go == 3:# Сброс только при Restart или Ready
2025-10-28 Update Front.html
    отцентрован таймер
2025-10-29 Update CastleServer.py
    Теперь на пульте банк активен только тогда, когда material_end пришло.
2025-10-29 Update CastleServer.py
    send_esp32_command(ESP32_API_WOLF_URL, "ghost_game_end")
    send_esp32_command(ESP32_API_TRAIN_URL, "ghost_game_end")
2025-10-29 Update wolf.ino
    Блокировка подсказки во время игры с призраком
2025-10-29 fix: basket lesson and ghost
    [CastleServer.py, MAIN_BOARD_V5_COM5.ino]
2025-10-29 Update chest.ino
    при скипе мог продолжать играть фон, сейчас убрал
2025-10-30 fix: обновление звука на устройствах
    [chest.ino, safe.ino, train.ino, wolf.ino]
2025-10-30 Update CastleServer.py
    перенес student_hide на пораньше срабатывание
2025-10-30 Update train.ino
    Обновил stage_8
2025-10-30 Переименовал заголовки
2025-10-30 Update safe.ino
    исправил опечатку на myDFPlayer.volume(value);
    [safe.ino]
2025-10-30 Update wolf.ino
    Фон должен теперь возобновляться после прерывания стори
2025-10-30 Update train.ino
    hint 0 должна звучать при активных светодиодах
2025-10-30 Update MAIN_BOARD_V5_COM5.ino
    Отключение салюта в рестарте, если был
2025-10-30 Update CastleServer.py
    restart теперь должен прерывать story, если они уже были запущены.
2025-10-30 Update MAIN_BOARD_V5_COM5.ino
    исправлена последовательность hint 49b и c
    [MAIN_BOARD_V5_COM5.ino]
2025-10-30 Update CastleServer.py
    перенос активации 3х устройств на позже
2025-10-31 Добавлен дебаунс для громкости ESP
2025-10-31 Цифры громкости теперь не дергаются.
    Мы изменим все обработчики нажатий кнопок громкости. Теперь они не будут сами обновлять цифру на пульте. Они будут только отправлять команду серверу, а цифра обновится только когда сервер пришлет подтверждение.
2025-10-31 Дополненная Логика затухания фоновой музыки
2025-10-31 Update train.ino
    Перенес стори45 из замка
2025-10-31 Update CastleServer.py
    Делаю зеленой кнопку crime
2025-10-31 Update MAIN_BOARD_V5_COM5.ino
    Убрал delay в MapGame()
2025-11-01 Update CastleServer.py
    Теперь в ready тоже skip можно
    [CastleServer.py]
2025-11-03 Теперь пройти можно сразу на первом этапе
2025-11-03 добавил начальную задержку на датчик вибрации
2025-11-09 fix(towers): Исправлена логика перезапуска и дублирование сообщений
    В `basket3.ino` исправлена обработка команды `restart`, теперь она корректно открывает обе двери (баскетбол и тролль).
    Во всех четырех башнях (`basket3`, `owls`, `workshop`, `dog`) была отрефакторена функция `CheckState`. Удалены дублирующиеся вызовы `Serial.println` и блокирующие `delay()`, что повышает надежность и эффективность отправки состояний датчиков.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
    [basket3.ino, dog.ino, owls.ino, workshop.ino]
2025-11-13 feat: Улучшить систему логирования для удаленной диагностики
    Добавлено комплексное логирование ключевых событий в `CastleServer.py` для обеспечения возможности удаленного анализа и отладки квеста.
    Основные изменения:
    - Создан централизованный словарь `EVENT_DESCRIPTIONS` для перевода системных сообщений от Arduino и ESP32 в человекочитаемый формат на русском языке.
    - Модифицированы обработчики входя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
2025-11-15 feat: Implement centralized logging for all devices
    Introduced a new `/api/log` endpoint on the `CastleServer.py` to receive log messages from Wi-Fi enabled ESP32 devices (`wolf`, `train`, `chest`, `safe`).
    Implemented `sendLogToServer` function in all ESP32 devices to send log data via HTTP POST requests.
    Implemented `sendLog` function in serially-connected Arduino devices (`owls`, `dog`, `workshop`, `basket3`) to send log messages prefixed with `log:`.
    Refactored `MAIN_BOARD_V5_COM5.ino` to act as a serial bridge for log messages, forwarding them from the Arduino towers to the server.
    Improved serial communication robustness in `MAIN_BOARD` by replacing `readString()` with `readStringU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
2025-11-15 fix: Prevent log spam from Arduino towers during ready check
    Introduced a `hasSentReadyLog` flag in `basket3`, `dog`, `owls`, and `workshop` Arduino sketches.
    This flag ensures that the "Checking initial sensor states" log message is sent only once upon receiving the first "ready" command from the main board.
    The flag is reset on "start" or "restart" commands to allow for correct logging in subsequent ready checks.
    This resolves an issue where the towers would repeatedly send the same log message, causing log spam during the system's startup sequence.
    [CastleServer.py, MAIN_BOARD_V5_COM5.ino, basket3.ino, chest.ino, dog.ino, owls.ino, safe.ino, train.ino]
2025-11-15 fix: Prevent log spam and fix compilation error in dog.ino
    This commit addresses two issues:
    1. A bug that caused excessive logging from serially-connected Arduino towers (`basket3`, `dog`, `owls`, `workshop`) during the `ready` state. The fix introduces a `hasSentReadyLog` boolean flag to each tower's firmware to ensure the initial state check is logged only once per `ready` cycle. The flag is reset on `start` or `restart`.
    2. A compilation error in `dog/dog.ino` caused by a redefinition of the `sendLog` function. The duplicate definition has been removed.
    [CastleServer.py, MAIN_BOARD_V5_COM5.ino, basket3.ino, chest.ino, dog.ino, owls.ino, safe.ino, train.ino]
2025-11-18 Update log message for owl button press
2025-11-19 Refactor robot scoring and game state handling
    Refactor robot scoring logic to use a timer instead of delay, improving responsiveness. Added handling for waiting state and adjusted game logic for better flow.
2025-11-21 feat: Add robust logging and command failsafe mechanism
    Implements a comprehensive logging and failsafe system across the main controller and peripheral towers.
    - Adds detailed state-change logging to MAIN_BOARD and all towers to improve debuggability.
    - Introduces a failsafe "insurance" mechanism on the MAIN_BOARD, which re-issues critical commands by parsing log messages from towers, preventing command loss.
    - Renames generic commands (e.g., galet_on, flag_on) to be tower-specific (e.g., workshop_galet_on) to prevent command crosstalk.
    - Updates CastleServer.py to handle the new specific commands.
    - Inserts small delays between serial log and command transmissions to prevent message conca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
    [CastleServer.py, MAIN_BOARD_V5_COM5.ino, basket3.ino, dog.ino, owls.ino, workshop.ino]
2025-11-21 fix: Correct SyntaxError in CastleServer.py
    Moves the `global flag` declaration to the top of the `serial()` function. This ensures that the global variable is declared before it is used, fixing the `SyntaxError: name 'flag' is used prior to global declaration` that occurred on server startup.
    [CastleServer.py]
2025-11-21 feat(esp32): implement audio playback logging
    Adds comprehensive logging for all audio playback events (hints, stories, system sounds) across the train, wolf, safe, and chest ESP32 modules.
    Each audio event now triggers an HTTP POST request to the server with a standardized JSON payload, like {"log":"DeviceName: Playing..."}.
    The logging functions in wolf, safe, and chest modules were refactored to handle the correct JSON format.
    [chest.ino, safe.ino, train.ino, wolf.ino]
2026-01-30 Update basket3.ino
    Обновления в Омане
2026-01-30 Update dog.ino
    Изменения для Омана
2026-01-30 Update MAIN_BOARD_V5_COM5.ino
    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
2026-01-30 Update train.ino
    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
2026-01-30 Update CastleServer.py
    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
2026-02-07 Update wolf.ino
    Добавлена OTA
2026-02-07 Update safe.ino
    Добавлено OTA
2026-02-07 Update chest.ino
    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
2026-02-18 Update train.ino
    Сохранил перед большим изменением.
2026-02-18 Update CastleServer.py
    Сохранил перед изменением функции загрузки аудиотреков. Следующая версия будет загружать языковые файлы по мере необходимости.
2026-03-02 Update MAIN_BOARD_V5_COM5.ino
    Сохранил перед тем, как лезть в изменения для сокращении обновлении времени адресных лент до 30 мс
    Типа:
    static unsigned long lastUpdate = 0;
    if (millis() - lastUpdate < 30) return;
    lastUpdate = millis();
2026-03-31 Fix icon color handling for helmet and broom; reset to grey on removal of green class
    [CastleServer.py, MAIN_BOARD_V5_COM5.ino, basket3.ino, scripts.js]
2026-03-31 Fix WiFi auto-connect routine and add connection logging; restore selected language from localStorage
    [CastleServer.py, scripts.js]
2026-04-01 Fix language display persisting on page reload
    Server now sends current language to client on socket connect.
    Removed localStorage approach which had timing issues with Semantic UI.
    [CastleServer.py, scripts.js]
2026-04-01 Fix audio volume flash: set volume before play() in all functions
    play_story, play_effect, play_background_music all started playback
    at full volume then set the correct level — causing a loud spike.
    Now volume is read from file and set on the channel before play().
    [CastleServer.py]
2026-04-01 Fix audio volume flash: use sound.set_volume() for stories, immediate channel.set_volume() for effects
    pygame resets Channel.set_volume() when play() is called, so:
    - play_story: set volume on Sound object (persists through play)
    - play_effect: play() then set_volume() with no sleep (no coroutine yield = no flash)
    - play_background_music: music stream set_volume is not reset, keep before play
    [CastleServer.py]
2026-05-18 Add tower heartbeat protocol and Tech-pult status icons
    - Mega: ping_main/pong heartbeat every 5s to all 4 towers + peek-style
    Serial.available() snapshot before all readers (так как другие game
    reader-ы через readStringUntil жрут input до HelpTowersHandler)
    - Mega: check_towers command returns tower_status:workshop=1,basket=0,...
    - Mega: diagnostic HB log every 60s with (now - lastSeenX) values
    - Towers (owls/basket/workshop/dog): minimal ping_main handler → "pong"
    - CastleServer: system_status_loop emits live state every 5s; live
    ESP32 HTTP check; tower_status snapshot with TTL; urllib3/requests
    log level → WARNING
    - Tech.html: 5 status icon groups (towe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
2026-05-18 Add .gitignore, docs, OMAN workshop sources and naming note
    - .gitignore: build artifacts (eep/elf/hex/build/), flash backups,
    archive (.rar), chat exports, Платы/ (158 MB, отдельно), IDE/system files
    - README (прошивка CLC1/CLC2).txt: документация процесса прошивки
    - workshop OMAN/workshop/workshop.ino + workshop_old/workshop_old.ino:
    параллельная разработка для CLC1-Оман
    - CLAUDE_MEMORY.md: модельный нейминг ProducED (CLC1/CLC2/WC1/DMC1 +
    серийники тип CLC1-26; Tailscale-имена)
2026-05-18 Fix Safe cold-boot WiFi + cleanup log noise + status change alerts
    safe.ino:
    - Disable Brown-Out Detector in first line of setup() — fixes cold-boot
    WiFi fails on weak/noisy PSU. Was the key fix; without BOD-disable
    ESP32 stuck in reset-loop on power-on before reaching WiFi.begin
    - WiFi.begin() reordered BEFORE DFPlayer init (DFPlayer can stall 1-2s
    on cold boot from audio peripheral peak current)
    - Cold-boot rescue: 15s timeout on WiFi.begin → ESP.restart() instead
    of original infinite while-loop (which required EN-button to escape)
    - WiFi.persistent(true) + setAutoReconnect(true) standard ESP32 flags
    - Loop watchdog: 10s reconnect attempts, ESP.restart() after 60s of
    continuo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
    [CastleServer.py, safe.ino]
2026-05-18 Set file log handler to INFO (no DEBUG poll noise in castle.log)
    File handler was logging.DEBUG, which kept check_towers SENT, HB W=...
    RECEIVED, raw serial data lines in the log file even after we lowered
    those specific lines to DEBUG level. Tech support reading castle.log
    still saw the noise.
    Now file_handler.setLevel(logging.INFO) — periodic poll lines are
    filtered at handler level, never written. Only meaningful state
    transitions, audio events, WiFi events, errors land in the file.
    Comment notes how to temporarily lower to DEBUG for deep diagnostics.
    [CastleServer.py]
2026-05-18 Apply Safe cold-boot WiFi fix to Wolf/Train/Chest ESP32s
    Same preventive fix as commit d550462 (Safe). All three had identical
    vulnerable pattern: infinite while(WiFi.status() != WL_CONNECTED) and
    no BOD-disable — works on CLC3's good PSU, but on weaker client PSUs
    (CLC1-Oman, CLC2-Canada) likely to fail on cold-boot.
    Applied to each:
    - WRITE_PERI_REG(RTC_CNTL_BROWN_OUT_REG, 0) first line of setup()
    - WiFi.persistent(true) + WiFi.setAutoReconnect(true)
    - 15-sec timeout on WiFi.begin → ESP.restart()
    Did NOT add loop() watchdog — those sketches already have minimal
    WiFi.reconnect() handling and aggressive auto-restart caused trouble
    on Safe v2 (restart-loops every 20s on transient loss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
    [chest.ino, train.ino, wolf.ino]
2026-05-19 Fix Safe DFPlayer events + game-flow stability
    - HardwareSerial(2) instead of (1) — Serial1 default pins on ESP32
    conflict with QSPI flash (9/10), unstable RX. Serial2 default RX=16
    TX=17 maps cleanly to our wiring.
    - DFPlayer init moved BACK before WiFi connect — when init was after
    WiFi, library didn't initialize event-parser properly (TX worked,
    tracks played, but myDFPlayer.available() always false).
    - RAW frame parser in handlePlayerQueries — read 10-byte DFPlayer
    Mini frames directly from dfplayerSerial, bypass DFRobotDFPlayerMini
    library which silently swallowed events (root cause unknown, library
    may be waiting on ACK that doesn't arrive). Frame format: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
    [CastleServer.py, safe.ino]
2026-05-19 Fix volume controls (Wolf/Platform/Suitcases/Safe) — stuck setInterval
    Root cause: every volume button (Wolf/Platform/Suitcases/Safe ±) had
    both a setInterval that emitted *Up/*Down events every 100ms while
    held AND a separate click handler. If user moved mouse off button
    quickly mouseup/mouseleave could miss → setInterval ran indefinitely
    in background, spamming socket events forever from that tab.
    Compounding: server broadcast `wolf`/`platform`/etc events with
    include_self=False so the originating client never got its own
    update back → its lev14/lev15/lev16/lev17 stayed at the initial
    value, causing every "Up" click to send the same low number.
    Both bugs together meant Wolf volume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
    [CastleServer.py, scripts.js]
2026-05-19 Add Internet sharing toggle to Wi-Fi Setup block
    UI (Front.html): toggle "Internet" в блоке Wi-Fi Setup сразу под кнопкой,
    стилизован как Ready Mode Music.
    Client (scripts.js): socket.emit('toggle_internet_sharing', isChecked) +
    socket.on('internet_state') для двусторонней синхронизации UI ↔ server.
    Регистрация в обоих блоках инициализации (как ready_music).
    Server (CastleServer.py):
    - INTERNET_SHARE_FILE сохраняет state между рестартами (по аналогии с
    ready_music.txt)
    - apply_internet_sharing(enable): управляет ОДНИМ правилом
    `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
2026-05-20 Add hostapd bootstrap watchdog (auto-recovery for cold-boot AP failure)
    On cold boot of CLC3 Pi, hostapd sometimes ends up in a broken state
    even though it reports active: SSID is broadcast but ESP32-устройства
    cannot associate. Empirically observed today — 4 ESP32 had power
    (indicator LEDs on) but `iw dev wlan0 station dump` showed 0 stations
    and hostapd journal had no auth/associate events at all for 8 minutes
    after boot. Manual `systemctl restart hostapd` fixed it instantly.
    Probable root cause: race between hostapd start, wlan0/wlan1 rename
    by fix-wlan-names.service, and RTL8189fs driver init. hostapd binds
    to interface state that subsequently shifts under it.
    Watchdog logi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
    [CastleServer.py]
2026-05-20 Fix Restart not opening doors after Ready pressed
    ListenForReady() had a restart-handler but it only set level=0 without
    calling OpenAll() — so after the user pressed Ready and entered the
    listen-for-galetnik state, pressing Restart on Tech-pult silently
    moved Mega to PowerOn level but doors stayed closed. User reported:
    "Я нажал реди, потом рестарт — двери не открылись".
    Restart-handler in ListenForReady() now does the full sequence,
    matching the level 20 handler (line 1112-1121):
    - SendRestartToAll() to broadcast restart to towers
    - OpenAll() to physically open all doors
    - Drain Serial buffer
    - isRestInitialized = false
    - RestOn()
    - level = 25
    Ve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
    [MAIN_BOARD_V5_COM5.ino]
2026-05-20 Add wlan1 watchdog (auto-recovery for USB-WiFi-dongle flap)
    CLC3 (and likely CLC1-Oman / CLC2-Canada with same hardware) suffers
    periodic USB-disconnect events on port 1-1.3 where the TP-Link
    USB-WiFi-dongle is mounted. Linux kernel logs:
    usb 1-1-port3: Cannot enable. Maybe the USB cable is bad?
    attempt power cycle
    new high-speed USB device number 13 using xhci_hcd
    USB disconnect, device number 12
    This is hardware-layer flap (likely 1m USB-extension cable contact +
    xHCI controller quirk). Cannot relocate to another USB port — port
    mapping is invariant across all CLC stands (clients already shipped).
    User-facing symptom: Tailscale shows Pi offline, client can't reach
    quest remotel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
2026-05-21 CLC3 servo calibration + Ready 10s lock after Restart
    MAIN_BOARD_V5_COM5.ino (CLC3-specific calibration):
    - boyServo.attach(49, 500, 2500) — wide pulse range for DS3218 on CLC3
    - boyServo.write(170) — final calibration value (Arduino Servo clamps
    write() to 0-180, so 180/185/200 are visually identical)
    - delay(500) → delay(1000) in 'start' handler — DS3218 needs ~545ms
    for 180°→0° transition under load, 500ms left it stuck at 30-45°
    - smartDelay(1000) → smartDelay(3000) in RunStudentHide/Open — same
    reason, give servo enough time to physically arrive before detach()
    - See [[clc-model-differences-table]] — CLC1 still uses write(130),
    do NOT OTA this hex to CLC1/CLC2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
    [CastleServer.py, MAIN_BOARD_V5_COM5.ino, scripts.js]
2026-05-21 Auto-restart server after Main Board flash (clear stale serial fd)
    After flashing Mega through Tech-pult, handle_flash() does
    ser.close() → avrdude → ser.open(). But the new ser.open() can
    silently end up with a stale fd — writes go into the void, reads
    return nothing. Symptoms:
    - Tech-pult shows "Прошивка успешна"
    - Mega's post-boot QUEST_SYSTEM_READY never appears in castle.log
    - Heartbeat pongs from Mega stop
    - Pressing Restart on the pult sends serial_write_queue.put('restart')
    3 times, server logs SENT successfully, but Mega receives nothing →
    doors don't open physically, no relay clicks
    Fix: after a successful Main Board flash, send SIGTERM to self.
    systemd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
    [CastleServer.py]
2026-05-22 Add device diagnostic panel for Train + Wolf ESP32
    - /tech: new "Диагностика устройств" tabbed section
    - ESP32 diag mode freezes game logic, streams I/O snapshot 5×/sec
    - UI shows live sensor chips, output toggles, encoder/vibration counters,
    WS2812 map, DFPlayer controls, system metrics (RSSI/Heap/Uptime/Temp)
    - Wolf: dedicated electromechanical lock pulse button (500ms)
    - Server: rotating log per device (5MB × 3 backup, like castle.log)
    - Tailscale watchdog: auto-reset if BackendState != Running for 2 min
    - Fix os-as-local-var scope bug in handle_flash (broke non-main flashes)
    [CastleServer.py, train.ino, wolf.ino]
2026-05-22 Add diagnostic mode for Safe + Suitcases ESP32
    - Safe (.204) diag tab: reed_1/2 + ball sensor, LED 1/2 toggles,
    electromechanical lock pulse (500ms), DFPlayer controls
    - Suitcases (.203) diag tab: 4 buttons + help + eye sensor,
    mistake/inside LEDs, 4 PWM symbol LEDs with brightness slider,
    SHERIF_EM2 lock pulse (250ms), DFPlayer controls
    - Refactor: shared diagShowLog() + diagUpdateSystemMetrics() helpers
    in Tech.html to dedupe RSSI/Heap/Uptime/Temp rendering across devices
    [chest.ino, safe.ino]
2026-05-22 Add diagnostic mode for Main Board (Mega) + 4 towers
    Mega becomes diag-relay for towers via uppercase DIAG_* protocol over
    serial (distinct from lowercase game commands to avoid collisions):
    DIAG_ON:<device> where device = main|workshop|basket|dog|owls
    DIAG_OFF:<device>
    DIAG_SET:<device>:<k>:<v>
    ← DIAG_SNAPSHOT:<device>:<JSON> (from Mega, every 200ms when active)
    Main Board diag exposes 7 sensors (4 crystals + window + crime/start door
    gerkons), 4 tower heartbeats, 9 doors as 300ms pulses, 8 light toggles,
    knock solenoid pulse, voltagePin (A1) analog read, current game level.
    Tower diag covers each tower's distinct I/O:
    - Workshop: stove/hint/4 workbench reeds + galetni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
    [CastleServer.py, MAIN_BOARD_V5_COM5.ino, basket3.ino, dog.ino, owls.ino, workshop.ino]
2026-05-22 Add per-tower USB-CH340 port status + dog watchdog-flash workaround
    Per-port USB diagnostics in /tech status icons:
    - Detects "stuck" CH340 chips even when USB hub VID:PID shows online
    - Uses os.open + tcgetattr (non-blocking) to probe each tower's port
    - Reveals -110 USB control transfer failures (common on bus-powered
    hub under 4-tower load — see [[clc-usb-hub-underpowered]])
    Dog flash workaround for broken DTR-reset on DMC_TOP V4.2 board:
    - dog.ino: wdt_reboot_for_flash UART command triggers ATmega328
    watchdog reset → Optiboot opens for sync without needing DTR-cap
    - Server: tries wdt-reboot via Mega→Serial3 before release_serial3
    - Tower interceptors (workshop/basket/dog/owls)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
    [CastleServer.py, basket3.ino, dog.ino, owls.ino, workshop.ino]
2026-05-22 Dog flash via tech-pult: 3-step silence-Mega workflow
    Reverts release_serial3 + wdt_reboot approach (didn't work on DMC_TOP
    hardware where Mega↔Nano shared RX/TX lines have too much LED+R+cable
    parasitics for clean 115200 STK500 sync even with Mega pins in high-Z).
    New _handle_dog_flash() in CastleServer.py does what original prod
    workflow did:
    1. avrdude silence.ino.hex → Mega (Mega becomes empty stub, no UART)
    2. avrdude dog.ino.hex → Nano via USB-CH340 (line is clean, DTR works)
    3. avrdude MAIN_BOARD_V5_COM5.ino.hex → Mega (restore game logic)
    Each step ~30s, total ~90s. Server auto-restarts after step 3 to
    clear stale ttyUSB_MAIN fd (same pattern as standalone main flash)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
    [CastleServer.py]
2026-05-22 Revert Mega DIAG mode; fix dog cage_lock spam; safer dog 3-step exit
    Reverted Mega-side DIAG mode (release_serial1/2, prep_dog_for_flash,
    handleDiagLine, relayTowerDiagSnapshots, sendDiagSnapshotMain). The
    diag stuff added too many globals and Mega RAM was at 86% — heap stress
    combined with frequent main flashes today corrupted Mega behavior:
    TX worked (QUEST_SYSTEM_READY visible) but RX-processed commands didn't
    reach state handlers reliably. Reverting cleared the issue.
    For per-device diag on Main+Towers we'll need a different approach
    that doesn't modify Mega firmware (e.g. expose Mega's existing
    tower_status + reuse existing game logs for monitoring).
    Other fixes in this batch:
    - dog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
    [CastleServer.py, MAIN_BOARD_V5_COM5.ino, dog.ino]
2026-05-22 Read-only diag panels for Main Board + 4 towers (no Mega code changes)
    Replaces broken DIAG-mode approach that modified Mega firmware and
    caused: heap fragmentation (Mega 86% RAM), stale serial fd after
    flash, and ultimately physical Mega failure from too many flashes.
    New approach uses only EXISTING Mega serial protocol:
    - Main Board pane: 9 door buttons → existing open_*_door game commands
    via server's serial_write_queue. Plus live game level (parsed from
    level_X messages Mega already sends), tower heartbeats (from
    tower_status:), and 30-line scrolling log of all Mega messages.
    - Per-tower panes (workshop/basket/dog/owls): heartbeat indicator,
    one "Open door" button (existing pe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
    [CastleServer.py]
2026-05-22 Full DIAG mode for Main Board + 4 towers; USB-stress mitigation in flash
    Mega: добавлен char-only DIAG mode (без String, не фрагментирует heap):
    перехват DIAG_ON/OFF/SET:<device> от сервера через Serial0, ранний return
    из loop когда diagMainActive=true (заморозка игры), relay snapshot'ов
    от 4 башен с подстановкой имени, JSON-snapshot Main каждые 200мс. RAM 84%
    (было 76%) — warning остался прежним. Tower index → name: 1=workshop,
    2=basket, 3=dog, 4=owls.
    Server: state tracker _diag_active_devices + _diag_main_explicit для
    безопасной работы towe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
2026-05-22 Backup hex'ов Mega: baseline (без DIAG, 76% RAM) и diag (84% RAM)
    Чтобы можно было откатиться на любую версию без пересборки. После
    инцидента 22 мая 2026 когда Mega .hex на Pi оказался corrupt — нужен
    канонический "known good" hex прямо в репо.
    - baseline.ino.hex: предыдущая стабильная (commit da3fd0f Revert)
    - diag.ino.hex: текущая с DIAG mode (commit c66a081)
    Перезалить на Pi одной командой:
    scp <file> clc-castle:/home/pi/New/Sketches/MAIN_BOARD_V5_COM5/MAIN_BOARD_V5_COM5.ino.hex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
2026-05-22 Trim DIAG buffers: 84% → 78% RAM (state-machine relay для башен)
    Прошлая DIAG-версия (commit c66a081) повесила Mega в реальной игре —
    стек переполнился в state-machine handler'е и затёр BSS. Уменьшил RAM
    с 84% до 78% (1731 байт для стека против 1307):
    1. Главная экономия — relay башен через state-machine (по 2 байта
    на башню) вместо буферизации полной строки (по 96 байт). State 0=
    ищем 'D', 1=матчим префикс "DIAG_SNAPSHOT:", 2=pass-through до \n.
    Экономия 376 байт.
    2. diagInBuf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
2026-05-23 Revert MAIN_BOARD .ino to baseline (drop today's DIAG-experiments)
    DIAG handlers (v3-v6) повесили Mega несколько раз сегодня. Откатываемся
    на проверенный baseline (commit d5b80c9). На следующую сессию — новый
    подход с короткими DIAG-командами (≤8 байт каждая), чтобы избежать
    USB CDC fragmentation на Mega Serial.setTimeout(50).
    Baseline .hex остаётся в репо для emergency-восстановления:
    - MAIN_BOARD_V5_COM5.baseline.ino.hex (215KB, RAM 76%, проверен)
    [MAIN_BOARD_V5_COM5.ino]
2026-05-23 DIAG mode: short commands (≤8 байт) — обход USB CDC fragmentation
    После 2 дней попыток с длинными командами DIAG_ON:main / DIAG_SET:main:...
    выяснили что Pi USB CDC дробит пакеты >8 байт на чанки, между которыми
    паузы >50мс. Mega's Serial.setTimeout(50) (baseline) ловит fragmentation
    и возвращает partial bytes ('D' вместо полной команды).
    Решение по идее Эдуарда: использовать короткие команды как существующий
    game protocol. Все команды ≤8 байт = один USB CDC chunk = надёж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
    [MAIN_BOARD_V5_COM5.ino]
2026-05-23 Удалить DIAG для Main+башен из Tech.html и server
    После 2 дней попыток DIAG для Main+башен дестабилизировал квест:
    - Mega иногда не возвращается из bootloader после flash через тех-пульт
    - Случаются регрессии в game flow (start не запускает после ready)
    - Серия avrdude flashes стрессует Pi USB controller
    ESP32 DIAG (Train, Wolf, Safe, Suitcases) РАБОТАЕТ — оставляем.
    Откат:
    - Tech.html → faa9c74 (только ESP32 DIAG tabs)
    - CastleServer.py → d5b80c9 (имеет dog 3-step flash + cage_lock spam fix,
    но б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
    [CastleServer.py]
2026-05-24 Add QUEST_TEST_CHECKLIST.md — пошаговый тест всего квеста
    568-строчный чеклист для производственного теста CLC:
    - Подготовка (boot, Restart, проверка 9 дверей)
    - 20 game levels (StartDoor → Final) с физическими шагами на каждом
    - ESP32 DIAG (Train/Wolf/Safe/Suitcases) — после прогона
    - Известные тонкости в коде:
    * GaletGame: predохранитель `galetGameReadyToWin` — если все 5
    галетников UP до старта, не засчитает
    * Scrolls level 9: точная последовательность board3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
2026-05-24 Fix bug: GaletGame отправлял galetG1..galetG5 вместо galet1..galet5
    Опечатка в Mega-коде: 5 мест в GaletGame() (level=4, Attic Room)
    отправляли событие ВКЛЮЧЕНИЯ галетника как "galetG1".."galetG5"
    (с заглавной G). Сервер ждал "galet1".."galet5" → ON-события никогда
    не парсились → шкала прогресса не двигалась → Attic Room невозможно
    было пройти.
    OFF-события (galet1_off..galet5_off) были без G и парсились корректно.
    Fix — убрал заглавную G в 5 строках Mega (2299, 2307, 23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
    [MAIN_BOARD_V5_COM5.ino]
2026-05-24 Fix bug: Suitcases (chest) hint играет только один раз
    Та же проблема что в Safe ESP32 (см. memory clc-safe-dfplayer-fix):
    библиотека DFRobotDFPlayerMini не парсит "track finished" event
    (CMD=0x3D) надёжно. После первого нажатия hint-кнопки → hintFlag=0,
    а в `myMP3.available()/readType()==11` блоке hintFlag=1 не
    срабатывало → следующие hint никогда не звучали.
    Fix — RAW frame parser DFPlayer Mini protocol (тот же подход что в Safe):
    10 байт `0x7E 0xFF 0x06 [CMD] [ACK] [HI] [LO] [CKH] [CKL] 0xEF`. Парсим
    CMD=0x3D вручную →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
    [chest.ino]
2026-05-24 Add mega_boot_watchdog: auto-DTR-reset если Mega молчит после cold-boot
    Симптом 24 мая 2026 (свежая Mega с 5 прошивками): после power-on
    квеста ~50% случаев Mega не отправляет QUEST_SYSTEM_READY (тишина,
    нет on.wav). Клиенту приходится вручную нажимать reset на Mega —
    плохой UX.
    Race-condition между Pi server (открывает Serial рано) и Mega CH340
    (ещё не готов к DTR-pulse). Иногда reset срабатывает чисто (boot OK),
    иногда нет (Mega застряла в halfway state).
    Fix: новая background-задача `me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
    [CastleServer.py]
2026-05-24 Усилить mega_boot_watchdog: 4-step recovery (DTR → ser.close+open → USB power-cycle)
    Тест 24 мая 2026: один DTR pulse 0.1с срабатывает только в 50% случаев
    (1 из 2 cold-boot тестов user'а Mega ожила, в другом потребовался
    ручной reset). Недостаточно надёжно.
    Эскалирующий watchdog:
    Шаг 0 (25с): нормальное ожидание boot
    Шаг 1 (25с): DTR pulse 0.5с — длиннее предыдущей попытки
    Шаг 2 (25с): ser.close()+open() — пересоздание CDC pipe, сбрасывает
    state CH340 + автоматический DT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
    [CastleServer.py]
2026-05-24 Revert DIAG mode from basket3/workshop/owls (back to 9e1b325 baseline)
    DIAG в башнях не используется (тех-пульт диагностики работает только для
    ESP32-устройств). DIAG-интерсептор в loop() читал байты с Serial1 в свой
    буфер — потенциальная причина молчания Basket→Mega на CLC3 24 мая 2026:
    ни pong на ping_main, ни log:basket:CMD на команды не приходили в Pi.
    dog.ino не трогаем: там кроме DIAG живут wdt_reboot_for_flash + wdt_disable
    + cage_lock pulse fix, нужные для рабочего flash-workflow ба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
    [basket3.ino, owls.ino, workshop.ino]
2026-05-24 Remove DIAG mode from dog.ino (keep wdt + cage_lock fixes)
    DIAG в башне dog убран по той же причине что и из basket/workshop/owls
    (см. коммит 02e605a): DIAG-интерсептор в loop() читал байты в свой буфер
    и мог терять команды от Mega при случайном байте 'D' от UART noise или
    glitch на flash workflow башен.
    Сохранены не-DIAG фиксы из коммита da3fd0f (Revert Mega DIAG mode):
    - wdt_disable() в setup() — без него после wdt_reset bootloader
    оставляет WDT включённым → reset loop
    - wdt_reboot_for_flash handler —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
    [dog.ino]
2026-05-25 Fix: revert RAW DFPlayer parser in chest.ino (Suitcases ESP32 crashed on START)
    Симптом: после flash 24 мая (commit 7c51338 — RAW DFPlayer frame parser
    для single-play hint fix), ESP32 Suitcases (192.168.4.203) после
    power-cycle загружался чисто, /tech показывал зелёный индикатор, но
    **как только пользователь нажимал START на пульте — ESP32 пропадал
    с пульта** (предположительно reset по watchdog).
    Корень проблемы: race condition с DFRobotDFPlayerMini библиотекой.
    Библиотека читает ACK-байты с того же U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
    [chest.ino]
2026-05-25 Fix single-play hint in Suitcases via cooldown-watchdog (without RAW UART parser)
    После того как RAW DFPlayer parser сломал ESP32 на START (см. 3357d03),
    single-play hint баг вернулся: после первого срабатывания геркона
    подсказки hintFlag=0 и больше не возвращается в 1, потому что библиотека
    DFRobotDFPlayerMini ненадёжно парсит "track finished" event (CMD 0x3D).
    Этот фикс — backup-механизм через таймер, **без конкуренции с UART**:
    - Глобальная константа HINT_COOLDOWN_MS = 20000 (20 секунд)
    -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
    [chest.ino]
2026-05-25 Improve Chest hint detection: poll DFPlayer.readState() + keep cooldown backup
    После замены физического MP3-модуля Chest (24 мая 2026 вечер) баг
    single-play hint остался — значит проблема не в железе DFPlayer, а в коде
    chest.ino или взаимодействии ESP32↔DFPlayer↔library. 20-секундный
    cooldown (commit c8ab4d5) работает, но user видит долгое ожидание после
    окончания подсказки.
    Добавлен механизм быстрее cooldown:
    - Когда hintFlag=0 (подсказка играет), через 2 сек начинаем оп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
2026-05-25 Fix: дверь сов не должна открываться автоматически после flagsendmr
    Симптом (24-25 мая 2026, тест квеста на CLC3): после поднятия 4 флагов
    (flagsendmr → story_10 → level_7) сервер автоматически проигрывал звук
    открытия двери сов (door_owl.wav) и истории story_13/story_14_a, хотя
    игроки физически не открывали башню сов. Также Owls слала door_owl
    каждые 5 сек создавая зацикленный hint_14_c.
    Корень проблемы — два дублирующих "skip" пути:
    1.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
    [CastleServer.py, owls.ino]
2026-05-25 Fix: Safe ESP32 уходит offline после GAME_WON (skip / safe:end)
    Симптом (25 мая 2026 на CLC3): Safe ESP32 (192.168.4.204) уходит в STATUS
    ALERT OFFLINE через 14 сек после получения команды `skip` или после
    естественного завершения сейфа (`safe: end`). Не восстанавливается сама.
    Корень проблемы:
    - В case GAME_WON safe.ino делал SendData() (синхронный HTTP POST к серверу
    с {"safe":"end"}) каждую секунду, пока safeEndConfirmed не станет true.
    - Default timeout HTTPClient ~5 сек. Если HTTP request заде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
    [CastleServer.py, safe.ino]
2026-05-25 Fix v2: Safe ESP32 уходила offline уже на ПЕРВОМ DFPlayer event
    Тест после фикса v1 (commit 451665c): Safe всё ещё уходит offline после
    команды 'skip' — играет первый трек 29A, потом ESP32 пропадает, до 29B
    и openLocker не доходит.
    Причина — sendLogToServer вызывался на КАЖДЫЙ DFPlayer frame в RAW parser
    (line 724), не только на cmd=0x3D. DFPlayer Mini шлёт много frames:
    play started, status, init, ready, и т.п. — несколько раз в секунду
    во время playback. На каждый — синхронный HTTP POST с defa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
    [safe.ino]
2026-05-25 Fix v3: Safe ESP32 — отключить HTTP-логирование полностью
    Симптом после v1 и v2 (commits 451665c, a050f00): Safe всё ещё уходит
    offline после команды 'skip' — успевает сыграть только первый трек 29A,
    потом отваливается. Не доходит до SAFE_END / 29B / openLocker.
    58 вызовов sendLogToServer в коде — в hot paths (DFPlayer RAW parser,
    GAME_WON state, /data HTTP handler). Каждый делает синхронный HTTP POST
    с timeout 1.5 сек (после v2). Даже с укороченным timeout — burst блок
    лочит loop на сек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
    [safe.ino]
2026-05-25 Fix v4: Safe ESP32 — удалить library DFPlayer handler (race с RAW parser)
    ROOT CAUSE найден через USB Serial debug (Сeria output via SiLabs CP210x на
    COM8 рабочего ПК):
    Safe всегда крашилась на transition 29A→SAFE_END (gameWonSequenceStep 1→2).
    В serial последняя строка перед reset: "[RAW] track: 23" (TRACK_STORY_29A
    завершён). После этого ESP32 уходила в panic.
    Причина — гонка между двумя parser'ами DFPlayer events:
    1) RAW parser (line 715+): читает dfplayerSerial напрямую как байты,
    находит CMD 0x3D frame → step 1→2 → p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
    [safe.ino]
2026-05-25 Revert "Fix v4: Safe ESP32 — удалить library DFPlayer handler (race с RAW parser)"
    This reverts commit a78fdbc86c63debe87b0f6855b6d6f60942f5fcf.
    [safe.ino]
2026-05-25 Fix v5: Safe ESP32 — убрать RAW parser, оставить library handler
    v4 (commit a78fdbc — удалить library handler) сделал хуже: ESP32 моментально
    крашится при startGameWonSequence (видимо library требует своих available()
    вызовов для корректного state в playMp3Folder). Reverted (c484796).
    v5: противоположное решение — убрать RAW parser, оставить library handler.
    Логика transition (step 1→2→3→4) полностью продублирована в library handler.
    Time-based fallback в case GAME_WON (line ~575+) подхватит если library н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
    [safe.ino]
2026-05-25 Tune: Safe ESP32 fallback timeouts по реальным длинам треков
    После v5 (commit cc57cd6) Safe прошла полную GAME_WON sequence но между
    треками были задержки ~10 сек — фолбэк-таймер 30 сек на step держался от
    конца предыдущего трека.
    Юзер измерил max длину треков на всех 6 языках (25 мая 2026):
    29A = 10 сек
    SAFE_END = 5 сек
    29B = 5 сек
    Поставлены fallback timeouts с буфером 2 сек: 12 / 7 / 7. Переходы теперь
    ~2 сек после окончания трека (без рисcка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
2026-05-26 UI: toggle автоскролла на /tech + меньше спама в логи (ping/check_state)
    1. Tech.html: добавлена кнопка "Автоскролл: ВКЛ/ВЫКЛ" над терминалом
    логов. По нажатию терминал перестаёт прыгать вниз → можно спокойно
    читать старые строки. Зелёная когда ВКЛ, оранжевая когда ВЫКЛ.
    Снова ВКЛ → терминал догоняет до низа.
    2. CastleServer.py: расширен фильтр спама heartbeat'ов (line ~4418).
    Теперь на DEBUG (не пишется в файл-лог и в UI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
2026-05-26 Tech.html: вернуть старую базу 3.4.26 + только autoscroll кнопка
    Циклы door_owl + hint_14_c на этапе сов появлялись из-за каких-то добавлений
    в Tech.html (status-icons strip / DIAG sections). Точно подтверждено:
    - Старая Tech.html (3 апреля) + текущие server.py/прошивки → работает без циклов
    - Моя Tech.html с status-icons + DIAG → циклы появляются
    Этот коммит — minimal safe state:
    - Старая Tech.html как basis
    - + autoscroll toggle button (UI-only, не трогает socket events)
    - БЕЗ status-icons strip
    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
2026-05-26 Tech.html: вернуть autoscroll + status-icons handler (DIAG sections исключены)
    Подтверждено бинарным поиском на CLC3 production:
    - Старая Tech.html (3 апреля) + autoscroll → работает
    - + status-icons HTML/CSS/JS handler → работает (passive listener, не ломает)
    - + DIAG sections для ESP32 (Train/Wolf/Safe/Suitcases) → ЦИКЛИТ квест на этапе сов
    Виновник найден: DIAG sections + связанная с ними jQuery checkbox init
    (возможно автоматически фиксят tech_diag_enter на ESP32 при загрузке /tech).
    Текущая верси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
2026-05-26 Fix: отключён check_towers heartbeat (root cause циклов door_owl)
    Архивная Mega (от 3.4.26) не имеет handler для команды check_towers
    → Unlocks(buff) fall-through broadcastит её через все 4 Serial
    (Workshop/Basket/Dog/Owls). Башни echo команду через sendLog → Mega
    substring match buff.indexOf("door_owl") срабатывает на fragment →
    ghost door_owl event → зацикленный hint_14_c на этапе сов.
    Воспроизведено бинарным поиском 26 мая 2026 на CLC3:
    - старый server.py: квест проходим
    - + новый server.py: циклы возвращаю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
    [CastleServer.py]
2026-05-27 Server: fix #1 (handshake retry) + fix #5 (Skip Ball Game)
    #1 student_open servo half-turn:
    - send_command_with_confirmation timeout 2.0с → 6.0с
    - если уже видим '<command>_start' — больше не retry'им, ждём _success
    до 10с. Раньше retry на _start без _success дублировал команду servo
    → серво начинал движение заново → недокручивал на половину.
    #5 Skip Ball Game без победной музыки:
    - В check=='basket' handler убран preemptive socklist.append('win_player').
    - Раньше дедуп-guard в flag=='win' (if 'win_player' in socklist: continue)
    блок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
    [CastleServer.py, MAIN_BOARD_V5_COM5.ino]
2026-05-27 Add Mega bisection baselines + CLC2 archive snapshot
    baseline-step2-2026-05-27/: snapshot of bisection steps Mega .ino+.hex.
    Step 1-5 все прошли тесты сов на CLC3 production. Step 6 (полный DIAG
    mode early-return в loop) ломает совы. Дальше bisection (6b/6d/6e/6f) показала
    что виновник — call site processDgCmd() из loop(). Причина не очевидна —
    возможно компилятор инлайнит/keep'ает функцию из-за call site, что меняет
    flash layout и timing SoftwareSerial Owls.
    Архив от 3.4.26. CLC2/: production baseline клиента в Канаде (CLC2).
    Снапш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
2026-05-27 Mega Step 6g + Owls guard fix (CLC3 production stable)
    Mega .ino/.hex (Step 6g, 76424 байт flash, 1910 SRAM free):
    - Архив базы + фикс Кая (boyServo.attach 49→49,500,2500 + write 130→170)
    - Galet typos `galetG1..5` → `galet1..5`
    - Restart-while-Ready полный fix (SendRestartToAll + OpenAll + RestOn)
    - lastSeen* tracking + filters в HelpTowersHandler + Flags() + MapGame()
    - HB log каждые 60с + lastSeen polling в loop()
    - DIAG dormant: check_towers handler + dg_on handler + processDgCmd
    + sendDgSnap (но БЕЗ if(dgActive) early-return в loop — он триггерил
    intermittent door_owl-on-map-click)
    - НЕТ ping_main heartbeat broadcast (ro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
    [MAIN_BOARD_V5_COM5.ino, owls.ino]
2026-05-27 Tech.html: restore 312e3df (ESP32 DIAG for Train/Wolf/Safe/Suitcases + autoscroll)
    Возвращаем версию от 312e3df (23 мая). Содержит:
    - ESP32 DIAG panel: Train, Wolf, Safe, Suitcases (live snapshot + commands)
    - Autoscroll toggle для main terminal
    - status-icons handler (онлайн-статус устройств)
    Без Mega/towers DIAG (была удалена в f3b49b4 — после 2 дней проблем).
    Нужно для отладки #2 train knock sensor sensitivity — DIAG panel
    показывает vibCount счётчик (живые срабатывания пьезо-сенсора pin 36).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
2026-05-27 DIAG lockout pattern + Train knock sensitivity fix + autoscroll style
    Train knock fix (train/train.ino + .bin):
    - ghost.setDebounce(10) → 1ms — пьезо-датчик даёт короткие импульсы,
    старый 10ms debounce их срезал
    - Логика win: ghost.isSingle()/isDouble()/isTriple() → ghost.isPress()
    - Раньше игрок стучал сильно и долго потому что piezo пульсы не
    складывались в полный click pattern. Теперь isPress срабатывает
    на первый же HIGH→LOW transition.
    DIAG lockout pattern (CastleServer.py + scripts.js):
    - Server поддерживает _active_di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
    [CastleServer.py, scripts.js, train.ino]
2026-05-27 Status check: ESP32 offline alert требует 2 consecutive fails
    Раньше: одна неудачная HTTP POST (1.5s timeout) → ALERT.
    Транзитные потери пакетов / WiFi reconnect фиксировались как OFFLINE.
    Теперь: ALERT после OFFLINE_FAIL_THRESHOLD=2 подряд (~10 сек реального
    простоя). Защита от шумного RTL8189FS чипа Pi.
    Параллельно (вне репо): hostapd channel сменён с 11 на 1.
    Канал 11 имел TP-Link_49C1 @ -39 dBm + DESKTOP-222Q987 @ -75 dBm,
    плюс соседний канал 10 ProducED @ -32 dBm — channel collision.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
    [CastleServer.py]
2026-05-27 Tech: toggle тестовых звуков (RU заглушки) для быстрого прогона на сборке
    Под кнопкой 'Проверить аудио' на /tech — новый toggle 'Тестовые звуки'.
    Workflow:
    - Toggle ON: каждый story_*_ru.wav из /home/pi/New/, у которого есть короткая
    заглушка в /home/pi/New/test_ru/, перемещается в /home/pi/New/test_ru_backup/.
    Затем заглушка копируется на место оригинала. Затрагиваются ТОЛЬКО файлы
    из test_ru/ — остальные .wav (en/ar/fr/uk/pl/звуковые эффекты) не т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
2026-05-27 Fix: Bluetooth state sync + test-audio path к подпапке 'Заглушки историй'
    #1 Bluetooth toggle baking 'OFF' хотя устройство подключено:
    - При старте сервера определять реальное состояние через bluetoothctl show
    (Powered: yes + Discoverable: yes) вместо default False.
    - В @socketio.on('connect') шлём bt_state свежеподключённому клиенту.
    Раньше bt_state эмитился только при изменении (set_bluetooth_state),
    поэтому после F5 страницы пульт не получал текущее состояние.
    #2 Test aud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
    [CastleServer.py]
2026-05-27 BT detection: только Powered:yes (не требовать Discoverable)
2026-05-27 Pygame WAV 24-bit fix: Layer 3 monkey-patch + tech-pult convert button
    CLC3 заливается клиентом через Samba (\\192.168.4.1\New\). Если клиент
    зальёт 24/32-bit WAV из Audacity/Reaper/Adobe Audition — pygame.mixer
    бросит "Unable to open file", тишина при попытке проиграть.
    Layer 3 (monkey-patch after pygame.mixer.init()):
    - pygame.mixer.Sound() обёрнута: ловит exception → возвращает 400-byte
    silence-buffer (~0.1s тишины). channel.play() не падает, сервер
    стартует даже с битыми файлами.
    - pygame.mixer.music.load() обёрнута: catch + log →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
    [CastleServer.py]
2026-05-27 ESP32 day_off: при Off (shutdown) и Ready
    Чтобы ESP32 устройства не светились светодиодами:
    - При check=='off' (кнопка Выключить на пульте) — гасим LED ДО shutdown Pi.
    - При res=='ready' — гасим LED на всех ESP32 (Wolf/Train/Suitcases/Safe)
    чтобы во время подготовки квеста монтажник видел тёмные устройства.
2026-05-27 Tech.html: i18n RU/EN (по паттерну WC)
    Языковой переключатель RU/EN в правом верхнем углу /tech (паттерн из
    WC). Сохраняется в localStorage, применяется к элементам с data-i18n.
    Переведены основные видимые элементы:
    - Заголовок, статус подключения
    - 4 главные кнопки (Логи, Перезапуск, Тест Баскетбол, Проверить аудио)
    - Audio check панель (статусы, счётчики)
    - Toggle тестовых звуков
    - Кнопка "Конвертировать аудио в 16-bit"
    - За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
2026-05-27 Tech UI: "Проверить аудио" + toggle на одной строке + авто-конвертация 16-bit
    #1 Layout:
    - Кнопка "Проверить аудио" и toggle "Тестовые звуки" теперь на одной
    строке (flex container). Кнопка не fluid, занимает свою ширину; toggle
    справа гибко тянется.
    - Убрана кнопка "Конвертировать аудио в 16-bit" + hint текст — больше
    не нужны как отдельный UI.
    #2 Авто-конвертация (как WC):
    - Helper _auto_convert_audio_bitdepth() вынесен из standalone handler.
    - handle_audio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
    [CastleServer.py]
2026-05-27 Tech: исправлен layout audio column (текст toggle переносился в 4 строки)
    Проблема: при попытке поместить кнопку + toggle на одну строку, колонка
    (289px wide в grid 4-column) не вмещала обоих элементов — текст toggle
    "Тестовые звуки (заглушки RU)" переносился в 4 строки.
    Решение:
    - Кнопка обратно fluid (полная ширина колонки)
    - Toggle под кнопкой компактно (margin-top:8px)
    - Label сокращён: "Тест. звуки RU" / "Test audio RU"
    - Status text с white-space:nowrap + ove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
2026-05-27 Tech UI: toggle тест.звуков справа в строке с автоскроллом (single-row layout)
    По запросу: вынес toggle 'Тест. звуки RU' из колонки 'Проверить аудио'
    наверх и поместил в строку с кнопкой 'Автоскролл' справа (margin-left:auto).
    Теперь layout:
    - Top row: 4 кнопки (Логи / Перезапуск / Тест / Проверить аудио)
    все одной высоты, выровненные.
    - Second row: Автоскролл (слева) + hint + toggle с status (справа).
    Проверено через Playwright скриншот.
    Co-Authored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
2026-05-27 Front: confirmation Yes/No при нажатии Power Off (по образу WC)
    Раньше клик '#power_off' сразу запускал shutdown — риск случайного нажатия.
    Теперь: swal.fire с кнопками 'Да, выключить' / 'Отмена'. Только при
    подтверждении — отправка 'off' к серверу и запуск 20-сек countdown'а.
2026-05-27 Front: shutdown dialog на английском (для соответствия другим UI элементам Front.html)
2026-05-28 Safe: time-based re-arm hintFlag (фикс — подсказки умирали после первой)
    Симптом: Золотой Сейф проигрывал аудиоподсказку только ОДИН раз при
    касании геркона подсказки, дальше тишина.
    Root cause: hintFlag (гейт подсказок) возвращался в 1 ТОЛЬКО по событию
    DFPlayer "трек закончился" (type==11). DFRobotDFPlayerMini ненадёжно
    парсит events на ESP32 (известная проблема, см. clc-safe-dfplayer-fix).
    Если событие потеряно → hintFlag навсегда 0 → подск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
    [safe.ino]
2026-05-28 Basket3: manual-open троль/баскет дверей работает в restart/rest (sustained)
    Симптом: на пульте Open/Restart для локеров Троль и Баскет не открывали
    двери, хотя ВО ВРЕМЯ ИГРЫ они работали. Питание/Serial2 исправны.
    Root cause: DoorDefender() повторно пульсировал локеры (SHERIF_EM1 троль /
    SHERIF_EM2 баскет) ТОЛЬКО в game-state 3-7. В restart/rest (state 0)
    рекуррентного открытия нет → одиночный OpenLock(300ms) от manual-команды
    часто не открывал дверь (нужно sus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
    [basket3.ino]
2026-05-28 Server (Вариант C): авто-открытие дверей Basket tower на рестарте
    Дополнение к basket3 DoorDefender фиксу (commit a2761a8, Вариант B).
    При нажатии Restart на пульте сервер через 3 сек (после входа Mega в
    RestOn + сброса Basket в state 0) шлёт open_basket_door + open_mine_door.
    Двери троля и баскета авто-открываются на рестарте, как ожидает оператор.
    Задержка 3 сек обязательна: иначе reset башни (от 'ready') обнулит
    manual-hold таймеры до того как откроется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
    [CastleServer.py]
2026-05-28 Tech.html i18n: перевод таблицы прошивок (названия башен, Прошить, Изменен/Прошит)
    Ранее i18n покрывал только верхние кнопки/audio. Таблица firmware
    оставалась на русском при EN. Добавлены data-i18n на h4 названий башен
    (board_main..board_wolf), кнопки Прошить (btn_flash), метки
    Изменен/Прошит (lbl_modified/lbl_flashed) + соответствующие ключи в
    I18N словарь (ru+en). Проверено Playwright: EN таблица корректна.
2026-05-29 Mega: убран DIAG mode (облегчение loop + SRAM)
    DIAG mode (dgActive, dg_on handlers ×2, processDgCmd, sendDgSnap,
    if(dgActive) early-return в loop) полностью удалён — не используется
    (нет UI для Mega/башен DIAG, server.py его не дёргает).
    Эффект:
    - loop() упрощён: убран if(dgActive){...return;} в начале (теперь
    ничего не мешает FireCup() и игровой логике каждую итерацию).
    - SRAM: 6354 → 6269 байт (освобождено ~85). Warning "Low memory"
    остаётся (основной SRAM — буферы NeoPixel strip1/strip2 ~760 байт),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
2026-05-29 Тест адресной ленты + SRAM-фикс Mega + аудио float-конвертер
    - Mega: 577 строковых литералов Serial-print обёрнуты в F() (SRAM 1899→3715 байт free, ушло "Low memory" предупреждение)
    - Mega: тест адресной ленты — команды lt_all/lt_off/lt1:N/lt2:N (handleStripTest в PowerOn+RestOn, не через Unlocks)
    - Mega: strip2 101→110 (кубок припаян в конец ленты за пределами счётчика; точный индекс FireCup уточняется после перепайки контакта)
    - Server: socketio-обработчик tech_strip_test (wh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
2026-05-29 Кубок: откат strip2 к 101 (причина была железная — перепутаны провода LED), подсказка диапазонов на тех-пульте
    - Mega: strip2 110→101 обратно (кубок = пиксель 65, в пределах 0-100; код был верен изначально, баг был в перепутанной пайке контакта LED кубка — перепаяли)
    - Tech.html: подсказка под кнопками теста ленты — диапазоны пикселей (Лента 1: 0-151, Лента 2: 0-100, кубок=65) + i18n RU/EN
2026-05-29 Fix: статус-опрос USB башен ресетил Arduino башни (DTR на open) каждые 5с
    gather_system_status() делал os.open()+os.close() USB-порта каждой башни раз в 5с
    для детекта залипшего CH340 — но открытие USB-порта дёргает DTR → ресет Arduino
    башни. При воткнутом USB башня Баскетбол перезагружалась раз в ~6с (SYS START),
    теряла игровой стейт (прогресс вращения тролля в пещере не считался).
    Теперь проверяем только наличие порта через os.path.exi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
    [CastleServer.py]
2026-05-29 Убран per-port USB-статус башен (мёртвый код + ресетил башню)
    На тех-пульте нет иконок для USB-статуса отдельных башен (показываются только
    USB-аудио / Wi-Fi-донгл / USB-хаб / Mega). Опрос этих портов через os.open раз в 5с
    дёргал DTR и ресетил Arduino башни (Баскетбол перезагружалась ~раз в 6с). Удалён
    полностью: блок tower_usb_paths в gather_system_status + связанные ключи в
    _prev_status_state и _status_labels. Статус хаба (s.usb.hub) остаётся.
    Co-Autho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
2026-05-30 Кнопка «Перезапуск» на /tech: SIGTERM вместо os.execv
    Раньше handler делал os.execv → новый Python с тем же PID, наследовал fd,
    не перевыполнял run_server.sh. Визуально «PID не сменился, значит не
    рестартанулось» — отсюда путаница про «нужен systemctl restart руками».
    Теперь os.kill(getpid, SIGTERM) → systemd Restart=always запускает
    run_server.sh с нуля: свежий pulseaudio + fresh python3 + все fd с нуля
    (включая ttyUSB_MAIN, лечит «stale fd» после прошивки Mega).
    Тот же па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
2026-05-30 Кнопка «Перезапуск» на /tech: fix — os._exit вместо SIGTERM (eventlet) + auto-reconnect страницы
    Проблема: SIGTERM под eventlet-greenlet'ом перехватывается hub'ом и
    игнорируется — проверено эмпирически 2026-05-30 (kill -TERM из системы
    тоже не убивал процесс, PID оставался). Поэтому кнопка тихо не работала,
    PID не менялся.
    Фикс: os._exit(0) — bypass всех signal handlers, immediate exit на уровне
    libc, systemd Restart=always мгновенно поднимает. Тот же паттерн уже
    исп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
    [CastleServer.py]
2026-05-30 USB Hub OFFLINE — INFO вместо WARNING (рабочий сценарий, не ошибка)
    Хаб с башнями держится отключенным от Pi по умолчанию (для стабильности
    USB-шины Pi 4 — один контроллер VIA Labs VL813 на 4 порта, шум от хаба +
    4 CH340 валит USB-WiFi-донгл). Втыкается клиентом горячей вставкой ТОЛЬКО
    на время прошивки башен. Все игровые шины (Mega/Wi-Fi/Audio) на своих
    портах Pi, независимы от хаба.
    Поэтому "USB Hub went OFFLINE" — нормальное состоя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
2026-05-30 Safe: фикс HINT_3 после прохождения
    Подсказка от геркона (TRACK_HINT_3) не играла после прохода Сейфа:
    - На шаге 3 (29B играет) hintFlag=0 — нормально, заглушка на повествование
    - На шаге 3→4 (сцена завершена) hintFlag оставался 0 — никто не re-arm'ил
    - На блоке HINT_3 после play отсутствовал hintPlayedAt=millis() →
    time-based re-arm не срабатывал → даже первый repeat не играл
    Фикс — три точки:
    1. step 3→4 fallback path: hintFlag=1, hintPlayedAt=0 (immediate re-arm)
    2.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
2026-05-30 gitignore: исключить arduino-cli output-dir артефакты (*.map, *.bootloader.bin, *.partitions.bin)
2026-06-03 WS2812 strip stuck after Mega reset — двойной фикс
    ПРОБЛЕМА: После рестарта castleserver (новая кнопка «Перезапуск» на /tech
    через os._exit) ядро ронит DTR на /dev/ttyUSB_MAIN → Mega ребутится →
    data-пин ленты глитчит → первый WS2812 в strip1/strip2 защёлкивается в
    «непринимающее» состояние. Все последующие lt_all/lt_off/основная игра
    не зажигают ленту, пока не сделать power-cycle её 5В питания. Замечено
    CLC3 2026-06-03 (кубок не загорался, basket-лента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
    [CastleServer.py, MAIN_BOARD_V5_COM5.ino]
2026-06-03 MEGA BOOT WATCHDOG: active probe для HUPCL-off случая
    После фикса B (commit f1ccda5) рестарт сервера НЕ ресетит Mega — но
    watchdog ждал QUEST_SYSTEM_READY и через 25с молчания SAM дёргал DTR
    → Mega всё-таки ресетилась, on.wav играл, лента глитчила.
    ФИКС:
    - Step 0a: после 3с ожидания (serial reader готов) шлём check_towers.
    Если Mega alive — она ответит tower_status: в течение 5с.
    tower_status: handler теперь тоже выставляет mega_initial_boot_received=True
    (раз Mega отвечает — она однозн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
2026-06-03 Tech.html: текст рестарта без упоминания on.wav + i18n RU/EN
    После фикса HUPCL-off (commit f1ccda5) + active probe в boot-watchdog
    (commit 823b1ee) — рестарт сервера НЕ ресетит Mega, и on.wav НЕ играет.
    Старая подпись 'Должен заиграть on.wav' вводила в заблуждение.
    - Новые i18n-ключи: restart_confirm, restart_title, restart_attempts, restart_hint
    - Confirm-диалог поясняет что Mega не сбрасывается (квест продолжит работать)
    - Хинт обновлён: 5–15с типичное время, до 2 мин — реф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
2026-06-03 WS2812: усиленный cold-boot wake-up
    CLC3 2026-06-03 (Эдуард): после обесточивания квеста 30 мин и cold boot
    лента не загорается даже с установленными кап+резистором (fix C). Старый
    wake-up (5×clear/show с 50мс) недостаточен против глубокого латча первого
    LED, накопленного за ~2 сек bootloader-floating-pin фазы Mega.
    Усиление:
    - ДО strip.begin(): pinMode OUTPUT + digitalWrite LOW на пинах 8 (strip1)
    и 2 (strip2), потом delay(100). Это длинный гарантированный reset
    (>50µs треб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
    [MAIN_BOARD_V5_COM5.ino]
2026-06-03 WS2812 lt_wake: кнопка «Разбудить ленту» на /tech (software-only fix)
    На CLC3 невозможно подлезть для установки hardware pull-down 10кΩ
    (Эдуард 2026-06-03). Софт-only решение усилено максимально:
    1) Cold-boot wake-up в setup() Mega — ужесточение:
    - 500мс pinMode OUTPUT + LOW на пинах 8 и 2 (было 100мс)
    - +1 сек wait для стабилизации 5В после cold-boot ramp-up
    - 30 циклов clear/show по 100мс = 3 сек wake-up (было 10×100мс=1сек)
    2) НОВАЯ команда `lt_wake` в handleStripTest — on-demand recovery:
    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
    [CastleServer.py, MAIN_BOARD_V5_COM5.ino]
2026-06-03 DIAG: lt_probe — медленный pin-toggle для диагностики DATA-провода
    CLC3 2026-06-03 (Эдуард): после нашего фикса cold-boot wake-up
    лента всё равно мертва на cold-boot. Power-cycle понижайки лечит,
    но напряжение 5В одинаковое в обоих случаях (4.99 vs 4.98В).
    Эдуард подозревает регрессию от commit 956c39d (тест ленты + F-макросы).
    DIAG-команда lt_probe в Mega:
    - pinMode OUTPUT на пинах 8 и 2
    - 10 циклов 500мс HIGH / 500мс LOW (10 сек total)
    - Лог каждого тогла в Serial для про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
2026-06-04 WS2812 cleanup + Owl Open Door in MapGame + Basket false-goal fix
    CLC3 2026-06-04 (Эдуард): новая понижайка PW821→другая модель решила
    проблему cold-boot WS2812. Откатываю всё что добавляли против неё:
    - Mega: удалил агрессивный wake-up (500мс LOW + delay + 30×clear/show)
    и команды lt_wake / lt_probe. Вернулся к исходному strip.begin() init.
    - CastleServer.py: убрал lt_wake/lt_probe из whitelist tech_strip_test.
    - Tech.html: убрал кнопки «Разбудить ленту» и «DIAG: пин-тест», i18n RU+EN.
    Сохраняется только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
    [CastleServer.py, MAIN_BOARD_V5_COM5.ino, basket3.ino]
2026-06-04 Owl Open Door — симметрия с Padlock
    CLC3 2026-06-04 (Эдуард, real-time во время игры):
    - Нажал «Open Door» в разделе Owl на /pult в режиме старт.
    - Дверь не открылась, кнопка не стала зелёной (вместо этого
    услышал звук таймера — это map_click + activation).
    - Padlock же отработал верно: дверь открылась, кнопка зелёная.
    Причина асимметрии: 25 мая фиксили баг auto-cycle door_owl и тогда
    убрали auto-open из check=='owl' (line 3187), оставив только activation
    + тре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
2026-06-04 Owl/Safe/Troll skip — добиваем UX-симметрию real-flow vs /pult
    CLC3 2026-06-04 (Эдуард, real-time):
    1) Owl skip с /pult играл map_click.wav (звук таймера).
    - Этот звук для физического клика по карте. На /pult-skip лишний.
    - УБРАЛ play_effect(map_click) из новой ветки check=='owl'.
    2) Skip Safe Open не открывал дверь Workshop, Эдуард застрял.
    - В real-flow (flag=='safe_end' на line 5980-5985) сервер играет
    door_workshop + шлёт open_workshop в Mega ДВАЖДЫ.
    - В skip (check=='safe' line 3298) этого нет → след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
    [CastleServer.py]
2026-06-04 Safe Open skip — полная имитация (Эдуард: звук + истории + музыка)
    Эдуард выбрал ПОЛНОЕ повторение real safe_end flow вместо
    сокращённого skip:
    - play_effect(safe_end) — звук открытия сейфа
    - play_localized_audio story_25, story_31, story_32 — все истории
    - play_background_music fon9.mp3 — смена фона на Workshop этап
    - + door_workshop effect + open_workshop x2 (уже было)
    - + stage_5 на Train ESP32 (уже было)
    Защита от дубликата (на случай если Mega эхом ответит safe_end):
    - check=='safe' skip первым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
    [CastleServer.py]
2026-06-04 Workshop locker: manual-hold 8с для restart + open_door
    Эдуард 2026-06-04: нажимает Workshop Open / Restart — свет мигает
    в башне Workshop, но локер не открывается.
    Та же проблема что у Basket 28 мая (memory clc-basket-door-restart-fix-2026-05-28):
    у Workshop тоже есть keep-alive паттерн (recurringLockActive), который
    пульсирует locker каждые 10с. Сбрасывается в restart/ready. Одиночный
    импульс (100мс в restart, 500мс в open_door) не пробивает соленоид
    без keep-alive.
    - Новый global: manualLockUntil + MANU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
    [workshop.ino]
2026-06-04 Owl Open Door v3 — чистый паттерн как у Cat/Dog/owls-skip
    Эдуард 2026-06-04: v2 (полная имитация door_owl) стопорил карта-LEDs
    (owl/train/key) в белом и они не возвращались к голубому переливу.
    Причина: door_owl handler делает map_disable_clicks → ВСЕ ClickLeds
    уходят в Future/белый. В real-flow они потом возвращаются в Click
    через map_enable_clicks (после story_14_a). В моём skip-варианте это
    работало нестабильно (видимо background task не отрабатывал чисто).
    ФИКС — сле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
    [CastleServer.py]
2026-06-04 Troll skip — добиваем эффект + история (как у Owl/Cat)
    Эдуард 4 июня: «по тому же принципу что и Owl должен работать
    Troll skip». Текущий handler был слишком сырой (только эмиты + Mega
    + troll_finish). Добавляю в имитацию real cave_end flow (line 5930):
    ДОБАВЛЕНО в check=='troll':
    - play_effect(cave_end) — звук закрытия пещеры (после боя с троллем)
    - play_localized_audio('story_30') — повествование как при реальном
    прохождении troll-этапа
    - socklist guard ('cave_end' in socklist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
    [CastleServer.py]
2026-06-04 Owl Open Door real-flow — full симметрия с геркон-touch
    Эдуард 2026-06-05: «нажал Open Door сов на /pult → только звук + LED
    на карте погас. Жёлтый «активной башни» не зажёгся. Дверь физически
    не открылась, освещение комнаты не включилось, ленты не пошли.
    Только после физ. касания геркона — всё ожило».
    ДВА БАГА:
    1) Сервер (check=='owl'): я слал owl_open (зажечь жёлтый) И ПОТОМ
    owl_finish (погасить жёлтый). Net = LED чёрный.
    ФИКС: уб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
2026-06-04 Owl story_14a + Mine door state=3 баг в restart
    Эдуард 2026-06-05:
    ФИКС 1 (CastleServer.py check=='owl'): добавил story_14_a после
    story_13 — как в real door_owl handler (line 5598). Я раньше упростил
    и убрал — Эдуард заметил что её не хватает.
    ФИКС 2 (basket3.ino): разделил handler "mine" vs "open_mine_door":
    - Раньше оба ставили state=3 (line 308: `if (state < 3) state = 3`).
    - В restart mode Эдуард нажал /pult Open Door (Mine) → послан
    open_mine_door → basket3 поставила state=3 → DoorDefender условие
    `state >= 3 && state <= 7` стал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
2026-06-04 Mine Door в restart — строго ОДНО открытие на нажатие
    Эдуард 2026-06-05: «Открывать каждые 3 секунды норма только для
    режима СТАРТ. В режиме рестарт — должно открыться один раз
    от нажатия. Нажмешь еще раз — одно открытие.»
    Раньше open_mine_door ставил manualEM1Until=8 сек → DoorDefender
    пульсировал каждые 3 сек (3 пульса за 8 сек). Слышно как несколько
    щелчков на одно нажатие.
    Теперь open_mine_door = только OpenLock(300мс) разово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
2026-06-04 gitignore: исключить __pycache__/ и .pyc файлы
2026-06-05 Hub-port mapping fix: Workshop ↔ Basket physically swapped on CLC3
    Эдуард 2026-06-05: «Когда жму Прошить Workshop на /tech, прошивка
    уходит в Basket башню. И наоборот.» Проверили тестом «втыкай по
    одному кабелю в хаб, смотри какой порт активировался»:
    Физика CLC3:
    - кабель к башне Workshop → хаб-порт 1.2.3
    - кабель к башне Basket → хаб-порт 1.2.4
    - кабель к башне Dog → хаб-порт 1.2.2 (правильно)
    - кабель к башне Owls → хаб-порт 1.2.1 (правильн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
    [CastleServer.py]
2026-06-05 Train: SendData диагностика projector-геркона на сервер
    Эдуард 5 июня тестирует этап Train (карта → projector). Касается
    map-геркона — приходит {'map':'train'}. Касается projector-геркона
    (INPUTS.digitalRead(1)) — НЕ приходит ничего. Подозрение пин 1
    мёртв или геркон сломан (как Workshop pin 30 ранее сегодня).
    Диагностика: edge-detect при HIGH→LOW transition pin 1 шлёт
    SendData {"log":"Train: projector pin LOW (INPUTS.1 геркон сработал)"}.
    Если в логе сервера это сообщени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
2026-06-05 Train: убран latch trainSensorLatched + ESP32-log DIAG в важные
    Эдуард 5 июня: при касании map-геркона СРАЗУ срабатывал
    {'projector':'end'} БЕЗ касания projector. Тест с отключенным
    проводом projector показал что после реконнекта реальное касание
    магнитом не triggerит. Значит latch не от noise/cross-talk.
    Диагностический лог DIAG показал:
    Train DIAG: CONDITION FIRED — pin1=HIGH, latch=TRUE, mapState=train
    То есть в момент касания map: pin1=HIGH (геркон разомкнут!), но
    latch=TRU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
    [CastleServer.py, train.ino]
2026-06-05 wolf: commit .ino.bin (был только .ino без compiled binary)
    Сегодняшняя сверка показала что wolf.ino.bin отсутствовал в git
    (другие ESP32 — train/chest/safe — имели .bin в репо). Скомпилировал
    сегодня и добавляю для синхронизации между VPS / Pi / GitHub.
2026-06-05 dog: commit .ino.hex (был только .ino без compiled)
    Сегодняшняя сверка: dog.ino.hex существовал на VPS и Pi (md5 совпадает)
    но не был tracked в git. Добавляю для синхронизации.
2026-06-08 Golden image workflow + Bluetooth pref-файл
    CastleServer.py: BT toggle теперь sticky через /var/lib/castle_bluetooth_pref.
    Раньше при старте сервера читалось физическое состояние bluetoothctl, но
    на Pi OS AutoEnable=true → адаптер всегда Powered:yes после boot → toggle
    залипал ON. Теперь хранится намерение пользователя, дефолт OFF.
    golden-image/: три скрипта тиражирования CLC из эталона:
    - offline-prepare-for-cloning-clc.sh — обезличка .img через loop-mount
    БЕЗ участия живого эталона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
2026-06-08 golden-image: чек-лист тиражирования нового клиента
    NEW_CLIENT_CHECKLIST.md — пошаговая шпаргалка от прошивки железа до сдачи
    клиенту, с акцентом на ловушки которые легко забыть:
    - Mapping USB-хаба (порядок физических портов != код на каждом замке)
    - Tailscale Disable key expiry (иначе через 6 мес. потеря IP)
    - WPA3 vs MT7601U-донгл (физическая несовместимость)
    - Документация в clients_inventory.md
2026-06-26 checklist: добавил Wago + auto-range мультиметр уроки
    Из инцидента CLC3 25 июня: после доставки клиенту Castle WiFi был, но
    пульт давал ERR_CONNECTION_REFUSED. Корень — Wago-клемма распределителя
    12V после транспорта ослабла, на main board не приходило питание, Mega
    не запускалась, CastleServer падал на init.
    Диагностику задержал auto-range мультиметр клиента (ANENG 681) в режиме
    Resistance вместо Voltage — «24» оказалось 24 Ом, а не вольты.
    Дополнен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
2026-06-29 Train: фикс MapGerkon ветка 2 (state=1) + DIAG log в dog_lock
    train.ino:
    MapGerkon() имеет 2 ветки которые ставят mapState="train":
    - Ветка 1 (line ~1953) когда isStartTimer=true — ставит state=1
    - Ветка 2 (line ~2027) первое касание, isStartTimer=false — НЕ ставила state=1
    Без state=1 в loop case 1 не выполняется → check pin1 LOW недостижим →
    {"projector":"end"} никогда не отправлен → этап Train не запускается.
    Воспроизвелось у клиента 26 июня (после исправления 5 июня про trainSensorL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
    [CastleServer.py, train.ino]
2026-07-08 Mono sound toggle на пульте + архив версий отправки CLC3
    Клиент CLC3 попросил переключатель stereo→mono: оба канала на один
    динамик. Реализация по паттерну BT pref-файла:
    - CastleServer.py: MONO_PREF_FILE=/var/lib/castle_mono_pref,
    pygame.mixer.pre_init(channels=1|2) по pref при старте,
    handler toggle_mono_sound (save pref → mono_state broadcast →
    рестарт сервера через os._exit(0), systemd поднимает с новым режимом),
    mono_state sync при connect.
    - Front.html: toggle "Mono sound" в настройках рядом с Bluetoo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
2026-07-08 fix: pref-файлы BT/Mono переехали /var/lib → /home/pi (Permission denied)
    Сервер работает от юзера pi, запись в /var/lib падала с Errno 13:
    - Mono toggle не сохранялся → после рестарта всегда STEREO (репорт Эдуарда)
    - BT pref НИКОГДА не сохранялся с самого коммита 1e1fef7 (2026-06-08) —
    не замечали, потому что дефолт OFF совпадал с ожиданием
    Пути: /home/pi/castle_bluetooth_pref, /home/pi/castle_mono_pref.
    offline-prepare-for-cloning-clc.sh чистит оба пути (старый и новый).
    [CastleServer.py]
2026-07-08 Front.html: cache-busting ?v= для static/scripts.js
    Планшет клиента CLC3 держал закешированный старый scripts.js — новый
    mono-toggle не инициализировался (текст виден, тумблер не отрисован).
    Query-параметр форсирует перезагрузку скрипта у всех браузеров.
    Правило: менять ?v= при каждом деплое scripts.js.
2026-07-09 Tech.html: полная EN-локализация — убраны захардкоженные русские строки
    В английской локали /tech оставались русские фразы. Локализовано через
    существующий I18N/data-i18n механизм (+95 новых ключей ru/en):
    - Секция «Диагностика устройств» целиком: заголовки панелей
    Train/Wolf/Safe/Suitcases, сенсоры, энкодеры, выходы, LED-карта,
    кнопки цветов, электрозамки, звук DFPlayer
    - Tooltips (Snapshot/RSSI/Heap/Uptime/Temp) через data-i18n-attr,
    ун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
2026-07-09 HUE: управление светом квеста через Philips Hue Bridge клиента
    Новый модуль hue_lights.py — клиент Hue (pairing, яркость группы,
    конфиг в hue_config.json). Управление ЯРКОСТЬЮ группы Castle:
    - restart → 100%
    - ready → off
    - start → off
    - после story_2_a → 40%
    - Workshop пройден (story_35) → 40%
    - дверь библиотеки (lib_door) → 100%
    - attic/галетники (start_galet_logic) → 100%
    - win → off
    Tech.html: секция «Умное освещение (Philips Hue)» — pairing,
    IP бриджа, выбор группы, тест 100/40/off, инстру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
2026-07-09 HUE: фикс библиотеки (локер) + свет 100% после story_66
    - Библиотека: хук перенесён из блока rest-режима (starts==2/0/3,
    никогда не срабатывал в игре) на команду open_library (момент
    когда сервер отпускает локер двери после призрака/punch) → 100%.
    - Добавлен свет 100% после окончания победной истории story_66:
    фоновый поток спавнится ПОСЛЕ гашения win+салют, ждёт channel3,
    гарантия что 100% ляжет после OFF даже если story_66 ко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
2026-07-10 HUE: расширенный сценарий освещения + светомузыка на флагах
    Маппинг событие→свет (обновлён):
    - restart → 100%, ready → 10%, start → 10%
    - story_2_a старт → ТОЛЬКО 1 лампа 100% (per-lamp)
    - геркон дракона (story_2_b) → все 40%
    - стартовая дверь (open_door) → все 40%
    - attic/галетники → 100%
    - флаги пройдены (fon7.mp3) → СВЕТОМУЗЫКА: 3 лампы по отдельности
    перебирают цвета под темп 120 BPM (0.5с/бит) пока играет fon7,
    затем возврат в белый 40%. Не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
2026-07-10 Логика квеста: не обрывать истории + day_off после Трёх Игр
    По жалобам клиента CLC3 (виновники найдены по логам castle.log):
    1. story_3_b обрывался при skip мансарды с пульта — Remote-хендлер живёт
    в отдельном greenlet и не блокировался wait'ом serial-цикла. Добавлено
    ожидание channel3 перед запуском story_5.
    2. story_10 обрывался двумя путями:
    - story_11 стартует когда fon7 доиграет (music.get_busy()==False), а
    story_10 длиннее fon7 → в усл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
    [CastleServer.py]
2026-07-10 Тролль: следующий этап (LED+активация) ждёт окончания рассказа
    Продолжение 1ef9f61 — раньше очередь выправляла только звук, а этап
    на basket3 Mega открывала мгновенно (Serial2-форвард cave_searchN в
    level==7). Теперь:
    Mega: убран мгновенный Serial2.println(cave_search1/2/3) при находке
    металла — Mega только сообщает серверу. Существующий buff-handler
    серверных команд cave_searchN не тронут (его используют и skip-кнопки).
    CastleServer.py: элемен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
    [CastleServer.py, MAIN_BOARD_V5_COM5.ino]
2026-07-10 fix: UnboundLocalError story13Flag в Remote() — story_14_a не играла
    Жалоба клиента: при открытии двери башни сов (Owl Open Door на /pult)
    не звучит story_14_a_fr. По castle.log хендлер обрывался молча, по
    journald найден Traceback: UnboundLocalError на `if story13Flag == 0`.
    Корень: в Remote(check) не было `global story13Flag`, а в check=='owl'
    есть присваивание story13Flag=1 → Python считает переменную локальной →
    чтение до присваивания роняет хендлер РОВНО перед play story_14_a.
    Эффект дв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
    [CastleServer.py]
2026-07-10 fix: story_3_a обрывался этапом clock2 — добавлен wait канала историй
    Реальная жалоба клиента CLC3 оказалась про story_3_a (этап первых
    часов): после него не было wait, и когда игрок быстро крутил второй
    галетник, цепочка clock2 (fon4 + ghost_knock + uf_clock + story_3_b)
    обрывала рассказ на полуслове. «Каждый раз на одном слове» — потому
    что темп прохождения одинаков.
    - clock2: wait channel3 перед запуском цепочки (story_3_a доигрывает)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
    [CastleServer.py]
2026-07-13 Аудио-менеджер на /tech (портировано из WC)
    Кнопка «Файлы аудио» → панель управления аудиофайлами квеста:
    - таблица всех mp3/wav/ogg (имя/размер/дата) с живым поиском
    - ▶ прослушать в браузере (HTML5 плеер, стрим с Pi)
    - ⬆ заменить файл (автобэкап старой версии в audio_backups/ с
    таймстампом), ⬇ скачать, ➕ добавить новый с произвольным именем
    - WAV 24/32-bit при загрузке автоконвертируется в 16-bit через sox
    (pygame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
2026-07-13 Аудио-менеджер: прослушивание через динамики замка
    Toggle «Слушать через: ПК / Замок» в панели аудио-менеджера.
    Режим «Замок»: кнопка ▶ играет трек на Pi через pygame Channel(6) —
    тот же тракт что в игре (pulse → EQ → USB → усилители), громкость
    из 3.txt как у историй. Отдельный канал не задевает игровые.
    Плашка «Играет на динамиках замка» + Stop. Режим запоминается в
    localStorage. socketio: tech_audio_preview_play/stop + state broadcast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
2026-07-13 Аудио-менеджер: плашка preview гаснет по окончании трека
    Background-вотчер на Channel(6): когда трек доиграл — broadcast
    tech_audio_preview_state playing=False, UI скрывает «Играет на
    динамиках замка». Раньше плашка висела вечно.
2026-07-13 Аудио-менеджер: preview MP3 через ffmpeg-конверсию
    pygame.mixer.Sound не читает MP3 (Layer 3 возвращал заглушку тишины —
    плашка мелькала, звука нет). Для preview mp3 конвертируется на лету
    в tmp WAV через ffmpeg (~1-2 сек), файл удаляется после окончания.
    mixer.music для preview не используем — он занят фоном квеста.
2026-07-13 Аудио-менеджер: preview MP3 стримингом через ffplay (без конверсий)
    По требованию Эдуарда: mp3 не конвертируются вообще. ffplay играет
    файл напрямую в pulse-тракт замка (стриминг — ноль ОЗУ, ноль tmp,
    мгновенный старт). Громкость из 3.txt (-volume 0-100). Stop и вотчер
    окончания работают и для ffplay-процесса. WAV — как раньше через
    pygame Channel(6). Файлы на диске не изменяются никогда.
2026-07-13 HUE: правки сценария — ready off, story_2_a 1 лампа 10%, банкир 10%
    - ready → все лампы OFF (было 10%)
    - story_2_a → только 1 лампа на 10%, ОСТАЛЬНЫЕ ВЫКЛ (было 1 лампа 100%);
    hue_single_lamp_async теперь эксклюзивный — гасит прочие лампы группы
    - material_end (банкир/Mirror) → все лампы 10% (было 40%)
2026-07-13 MONO v2: сведение в PulseAudio remap-sink — без клиппинга и без рестарта
    Развязка кейса щелчков: панорамирование звуков по колонкам (L-only /
    R-only треки, могут звучать одновременно) — ДИЗАЙН квеста. Старый mono
    (pygame channels=1) заставлял SDL суммировать L+R БЕЗ деления при
    загрузке → клиппинг на громких местах дуал-моно треков = детерминир.
    щелчки. Дублирование одного канала не подходит — потерялись бы
    R-only з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
2026-07-13 HUE: ready-гашение только после успешной проверки + start off
    1. Гашение света на ready перенесено из момента нажатия кнопки
    в ветку УСПЕШНОЙ проверки устройств ('Ready: OK', len(devices)==0).
    Раньше свет гас сразу при нажатии ready, даже если проверка
    потом FAILED (напр. Check Crime). Теперь — только когда все ОК.
    2. start → все лампы OFF (было 10%).
    [CastleServer.py]
2026-07-13 HUE: единый логгер hue_lights для всех HUE-сообщений
    Все HUE-логи в хелперах CastleServer (одна лампа, светомузыка, pair,
    set ip/group/enable, прогрев кэша) переведены с корневого logger на
    logging.getLogger("hue_lights") — теперь в логах единообразно
    'hue_lights - INFO', а не вперемешку с 'root'.
2026-07-29 Mega retry+USB power-cycle, портируемые USB-статусы, пересборка Mega .hex
    Инцидент CLC2 (ночь 28→29.07): CH340 главной Mega завис, /dev/ttyUSB_MAIN
    не создавался. Сервер делал одну попытку открыть порт и вызывал exit(),
    systemd поднимал его каждые 5 сек — 209 перезапусков за загрузку. Снаружи:
    «сеть Castle есть, а пульт не грузится». Клиент жал reboot, что не помогает —
    при reboot питание с USB не снимается и зависший CH340 остаётся зависшим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
    [CastleServer.py, scripts.js]
2026-07-29 Фикс вечной фоновой музыки: защита от гонки команд game/skip (chest/safe/wolf)
    Жалоба клиента CLC2: после прохождения Чемоданов фоновая музыка
    (TRACK_FON_SUITCASE) продолжала играть. Проявлялось при быстром скипе
    уровней с пульта во время тестовых прогонов.
    Причина — гонка команд, а не логика этапа. send_esp32_command() в
    CastleServer.py работает асинхронно: каждая команда уходит в отдельном
    потоке с retry (4 попытки, backoff 1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
    [chest.ino, safe.ino, wolf.ino]
2026-07-29 Safe: датчик шарика игнорируется 5 секунд после срабатывания геркона 1
    Запрос клиента CLC2: шарик лабиринта иногда сразу после срабатывания
    REED_SWITCH_1_PIN (пин 36, тот что запускает story_28) в полёте задевал
    BALL_SENSOR_PIN (пин 39), и это засчитывалось как прохождение, хотя
    игрок ничего не прошёл.
    Раньше проверка датчика была безусловной — засчитывала первое же HIGH.
    Теперь после КАЖДОГО срабатывания ге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
2026-07-31 Дверь Баскетбола после story_56 + переключатель этапа Spell
    === 1. Открытие двери Баскетбола перенесено на окончание story_56 ===
    Было: дверь на балкон открывалась сразу по геркону кубка — задолго до
    того, как этап Баскетбола становился активным на пульте (это происходит
    только после прохождения Crime).
    Стало: Mega больше не шлёт opent_basket по кубку. Сервер ставит story_56
    в очередь историй с after_serial='basket_stage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
2026-07-31 Сборка Mega для CLC2: мастер со всеми фиксами + калибровка серво под CLC2
    Клиент CLC2 просил внести правки (дверь Баскетбола после story_56 +
    переключатель Spell), но у него на плате прошивка от 3 апреля — с тех пор
    в мастер легло 22 коммита с фиксами.
    Лить мастер напрямую нельзя: там калибровка серво под DS3218 с CLC3
    (коммит 9abb1fa, в его же описании «do NOT OTA this hex to CLC1/CLC2»).
    Серво поехало бы на 170° вместо 130° — р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
2026-07-31 CLC2-сборка: добавлен .hex (по правилу .ino и .hex вместе)
    .gitignore исключает *.hex, но основные бинарники в репозитории
    отслеживаются принудительно — прошивочный .hex должен лежать рядом
    с исходником, иначе при следующем деплое легко взять рассинхрон.
2026-07-31 Волк: режимы сложности + grace 400 мс для облаков
    === Переключатель сложности в Settings ===
    НОРМАЛЬНЫЙ (по умолчанию): луну отпустили — НИЧЕГО не происходит, откат
    не запускается вовсе, собранный прогресс сохраняется.
    СЛОЖНЫЙ: луна отпущена дольше 5 сек — этап гаснет и откатывается в state=1.
    Вернули раньше — таймер сбрасывается.
    Раньше в обоих блоках стоял безусловный откат через 2 секунды. Ва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
2026-07-31 Фикс рассинхрона кнопок пульта после переобрыва связи + cache-busting
    Симптом (жалоба Эдуарда): иногда на пульте кнопки этапов показаны
    активными, хотя этап ещё не открыт. Лечилось только F5, при этом
    несколькими минутами ранее на той же вкладке всё было правильно.
    Причина — глобальные флаги-защёлки disBut и restflag. Сервер при КАЖДОМ
    подключении шлёт весь socklist заново, но блоки, которые разом г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
2026-07-31 Workshop: замок не пробивался — keep-alive был короче интервала пульсации
    Жалоба клиента CLC2: на этапе Workshop дверь не открылась ни по игровой
    команде open_workshop, ни кнопкой с пульта. Помогло только физическое
    открытие. После этого замок не отщёлкивался сам, хотя должен подавать
    импульс каждые несколько секунд.
    Причина — рассогласование двух констант:
    RECURRING_LOCK_INTERVAL = 10000 (пульс раз в 10 сек)
    MANUAL_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
2026-08-03 Петля тролля + дверь Баскетбола не открывалась (обработчик был не в той функции)
    Две жалобы клиента CLC2 после прохождения 31 июля.
    === 1. У тролля зациклился звук, шкала застряла на 75% ===
    В логах story_27_c доигрывала и запускалась заново каждые ~12 секунд,
    каждый раз играя cave_search.wav:
    22:58:21 STORY QUEUE: 'story_27_c' доиграла → cave_search3
    22:58:33 STORY QUEUE: 'story_27_c' доиграла → cave_search3
    22:58:45 ... и так по кругу
    Механизм пе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
2026-08-03 ESP32: watchdog потери WiFi перенесён из safe.ino в train/wolf/chest
    Поезд ушёл в offline и сам не вернулся. Причина — в loop() стоял голый
    reconnect без перезагрузки:
    if (WiFi.status() != WL_CONNECTED) {
    WiFi.reconnect();
    delay(2000);
    }
    Если переподключение не удаётся, устройство висит в этом цикле бесконечно
    и восстановиться само не может — нужно снимать питание башни вручную.
    Плюс delay(2000) блокировал весь loop на две секунды каждый прох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
2026-08-05 Дверь баскетбола закрывалась через 8 сек — убрана привязка к state башни
    Жалоба клиента CLC2 (05.08): на пульте кнопка Basket Door позеленела, а
    физически дверь закрыта. Логи показали, что серверная цепочка отработала
    безупречно:
    00:21:20 crime_end
    00:21:22 PLAY story_56_en.wav
    00:21:38 STORY QUEUE: 'story_56' доиграла → открываю этап (basket_stage_open)
    00:21:38 SENT [Basket]: basket_stage_open
    То есть команда дошла вовремя — обрыв был уже внутри баш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
2026-08-05 basket3: лог приёма opent_basket + исправлено обоснование прошлого коммита
    В bcb63a6 я объяснил невскрытие двери отставшим state из-за скипов. При
    разборе логов сессии 04.08 (23:41 - 00:21) выяснилось, что объяснение
    НЕВЕРНОЕ:
    23:41:31 RECEIVED [Basket]: Игра с троллем в пещере пройдена (cave_end)
    00:17:35 RECEIVED [Basket]: Дверь на балкон (баскетбол) открыта
    Клиент проходил честно, скипать начал уже ПОСЛЕ того как дверь не
    открыла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
    [basket3.ino]
2026-08-05 3 бага после теста CLC3 04.08: чемодан, поезд, тролль
    Диагностика по логам вчерашней вечерней сессии (17:36-21:24).
    1. Chest не открывался автоматически (chest.ino, ESP32 Suitcases):
    Сервер отрабатывал безупречно (suitcase:end → confirm_suitcase_end
    round-trip чист в логах). Замок реально открывается через finalizeGame()
    по ОДНОМУ из двух путей: DFPlayer-событие finishedTrack==TRACK_SUITCASE_END
    (ненадёжно — тот же класс бага что чинили на Safe, см. clc-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
2026-08-05 Скип этапа Ghost не работал на финальном шаге + watchdog ресетил плату в игре
    === 1. Клиент застрял на Ghost (библиотека) ===
    Жалоба: стучит — ничего не происходит, скипнуть тоже не может. В логах
    девять нажатий скипа подряд без единого ответа от Mega.
    Причина: обработчик 'ghost' имел ветки только для ghostState 2/3/4.
    На четвёртом шаге состояние прыгает в 6 (финальная загадка со стуком), а
    ветки для 6 не было во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
2026-08-05 Откат: ветка ghostState==6 не нужна — механизм скипа уже существовал
    В bc2cf03 я добавил в обработчик 'ghost' ветку для ghostState==6,
    решив что скип финального шага Ghost вообще не реализован. Это неверно.
    В Library() уже есть обработчик отдельной команды:
    if (buff == "ghost_skip") {
    Serial.println(F("punch"));
    digitalWrite(KnockSol, LOW);
    digitalWrite(LibraryLight, HIGH);
    level++;
    Он вызывается кнопкой «Ghost (Library)» на пульте (check == 'ghost_step_4'
    шлёт именно g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
2026-08-05 Кнопки Ghost блокируются при нажатии — команды больше не уходят пачкой
    Корень инцидента CLC2 05.08: этап Ghost промотался сам собой ещё до того,
    как игроки к нему подошли. В логах три команды за одну секунду:
    15:27:31 SENT: ghost / ghost / ghost
    15:27:34 RECEIVED: story_40, story_41, story_42, ghost_knock
    15:27:38 RECEIVED: level_11 ← этап только начался
    Механика: кнопка Ghost гасла только при получении подтверждения (story_40
    и далее). Пока Mega н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
2026-08-05 Скип Кубка при выключенном Spell + хендшейк больше не теряет строки Mega
    1. Скип Кубка не открывал дверь Crystal Space, когда этап Spell выключен
    в настройках. Клиент CLC2 упёрся в тупик: дверь заперта, а раздел Spell
    на пульте скрыт — нажать нечего.
    Логика «Spell выключен → открываем дверь сами» живёт в обработчике
    door_basket. Скип до неё не доходит: сервер шлёт на Mega 'cup', та
    отвечает door_basket, но обрабо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
2026-08-07 Разбор ночи 06→07.08 на CLC2: замок Чемоданов, Бутылки 0%, Цербер, спам логов
    По логам ночной сессии (02:24–04:44) и провала Mega (00:08–00:44).
    1. ЗАМОК ЧЕМОДАНОВ НЕ ОТКРЫВАЛСЯ (жалоба и на CLC2, и на CLC3).
    Сервер шлёт day_off, когда пройдена ТРЕТЬЯ из трёх игр. Если третьими
    оказались Чемоданы, day_off прилетает в ту же секунду, что и победа:
    03:16:28 THREE GAMES DONE: day_off → Wolf/Suitcases/Safe
    03:16:29 RECEIVED: {'suitcase': 'end'}
    Обрабо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
2026-08-07 Стук библиотеки: ложное срабатывание от стука самого призрака + дверь без повторов
    Жалоба клиента CLC2: «стук библиотеки глючит, из-за этого дверь в следующий
    пазл не открывается». Раньше такого не было.
    СВЯЗЬ С MEGA НИ ПРИ ЧЁМ. Через секунду после open_library плата ответила
    star_hint на команду ghost — то есть была жива, в нужном состоянии и читала
    очередь. За всю ночь одна битая строка, и та восста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
2026-08-07 Правка описаний: соленоида «тук-тук» в библиотеке физически больше нет
    Уточнение от Эдуарда. В комментариях висела устаревшая информация, будто
    замок стучит игроку физическим соленоидом. Соленоид ДЕМОНТИРОВАН — стук
    призрака сегодня это только knock_castle.wav на колонках замка.
    В предыдущем коммите (f888a0e) я описал причину ложного punch как «замок сам
    стучит соленоидом и на колонках игра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
2026-08-07 Вычищен пин A8 и мёртвые остатки логики стука соленоидом
    Решение Эдуарда: соленоид «тук-тук» в библиотеке демонтирован, пин и записи
    в него убрать совсем — это мёртвый код, который и ввёл меня в заблуждение
    при разборе ложного punch.
    Убрано в обеих сборках Mega:
    - const byte KnockSol = A8;
    - pinMode(KnockSol, OUTPUT);
    - три digitalWrite(KnockSol, LOW) — в детекте стука, в rrt3lck и в ghost_skip.
    Заодно убраны KnockState, KnockInterval, KnockIntervalLow —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
2026-08-07 Поезд не запускался после проектора + история тролля обрывалась фразой банкира
    Разбор тестов CLC3 04–06.08 по castle.log.
    1. ЗАМОК ЧЕМОДАНОВ (жалоба повторилась после прошлого захода).
    Причина уже найдена на CLC2 — day_off рвал финал третьего устройства
    (b40ad62). На CLC3 та же картина во всех трёх прогонах:
    04.08 19:35:10 {'suitcase':'end'} и day_off в одну секунду
    05.08 15:35:04 day_off, 15:35:05 {'suitcase':'end'}
    06.08 09:41:33 обе ст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
2026-08-07 Подсказка на карте больше не перебивает вступление этапа поезда
    Наблюдение клиента 06.08: в тот заход игроки впервые начали обход карты
    с поезда, а не с совы или ключа — и именно тогда этап встал.
    Порядок в коде нигде не задан, поезд доступен с начала этапа. Но при
    старте с поезда вступление (train_on + story_15, около 30 секунд) играет
    в тот момент, когда игроки уже вернулись к карте и водят пало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
2026-08-07 Пересобраны .hex Mega и .bin Сейфа под текущие исходники
    Правки последних коммитов (b40ad62, f888a0e, 170b8fa) меняли только .ino
    мастер-сборки Mega — .hex остался от 05.08 и не содержал ни глухого окна
    стука библиотеки, ни страховки её двери, ни чистки A8. Пересобран.
    safe.ino.bin лежал от 29.07 — сам по себе актуальный, но пересобран
    заодно, чтобы на Pi и в репозитории лежал заведомо один и тот же байт.
    Обе прошивки в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
2026-08-07 Умная розетка Philips Hue: включается когда квест пройден, настраивается клиентом
    Задача: розетка включается в момент play_win_salute — когда квест пройден
    полностью. Клиент должен подключить её сам, без правок в коде.
    Блок «Умная розетка» на /tech поставлен СПРАВА от блока освещения — оба Hue-
    блока теперь в сетке из двух колонок, на узком экране складываются друг под
    друга. Проверено Playwright'ом н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
2026-08-07 Убран чужой IP бриджа из дефолтов — поле пустое, вместо значения подсказка
    Замечание Эдуарда: 192.168.1.141 — это бридж CLC3. Он был зашит как значение
    по умолчанию, а не как пример:
    hue_lights.py default_ip="192.168.1.141"
    CastleServer.py HueClient(..., default_ip="192.168.1.141")
    Tech.html placeholder="192.168.1.141"
    На новом замке этот адрес подставлялся в поле как готовый, выглядел
    правдоподобно, и сервер начинал стучаться по бриджу другог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
2026-08-07 Фикс: story_busy() вызывала саму себя — сервер падал на первой истории игры
    Массовая замена channel3.get_busy() -> story_busy() в d2f9ea4 прошла по
    всему файлу с исключением только для play_story(). Под замену попало и
    тело самой story_busy(), объявленной выше:
    def story_busy():
    return story_busy() or story_play_pending > 0
    Синтаксически корректно, поэтому ast.parse пропустил. Функция вызывается
    только когда играет история, так что сервер про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
2026-08-07 Кнопка «Сохранить IP» больше не рвёт подключение к бриджу
    Жалоба Эдуарда: нажал «Сохранить IP» на тех-пульте — и отвалился бридж
    умной розетки.
    Причина: set_bridge_ip() обнулял app_key ВСЕГДА, даже когда адрес не менялся.
    На практике клиент жмёт эту кнопку и после того, как уже спарился, — просто
    чтобы убедиться, что адрес записан. Такое нажатие молча разрывало связь: и
    розетка, и свет перестав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
2026-08-07 Бар Бутылок не рос вообще + три реальные причины конфликтов звука
    1. BOTTLES: ПРОГРЕСС НЕ ПОКАЗЫВАЛСЯ (жалоба клиента).
    Это НЕ защёлки, которые чинил утром. Бар вообще не умел расти. Замер
    прямо в браузере на живом пульте, progress('increment'):
    после 1-й → value=1 percent=25
    после 2-й → value=2 percent=25 ← счётчик растёт, процент стоит
    после 3-й → value=3 percent=25
    Все остальные бары квеста (Совы, Сейф, Тролл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
2026-08-07 Бутылки и флаги: прошивки под жалобы клиента (в Sketches, не прошито)
    БУТЫЛКИ — «нужно положить два раза», «иногда всё заново».
    Эдуард прав насчёт замысла глухого окна: оно задумывалось на случай, когда
    игрок задел метку, убирая руку. Но реализовано было так, что от этого случая
    не спасало вовсе: окно взводится ПОСЛЕ того, как ошибка уже отправлена и вся
    последовательность сброшена. А по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
2026-08-09 Restart снова открывает дверь один раз, как во всех остальных проектах
    Жалоба клиента CLC2: нажал Restart, закрыл все двери, а дверь баскетбола
    закрыть не может — её толкает каждые несколько секунд.
    ПРАВИЛО (Эдуард, 08.08): во всех проектах Restart открывает каждую дверь
    ОДНИМ импульсом. Эталон — OpenAll() в прошивке Mega, и он делает три вещи:
    разоружает повторную пульсацию (active[] = false), бьёт по каждой две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
2026-08-09 Инструкция гейммастера: правки Эдуарда после вычитки
2026-08-09 Единый набор файлов для всех замков + раздел «Первый запуск» в тех-пульте
    Код на CLC2, CLC3 и CLC4 теперь буквально одинаковый. Всё, чем замки
    отличаются, уехало в castle_config.json и настраивается с /tech — раньше
    раскладку USB-хаба правили прямо в CastleServer.py перед каждой отгрузкой, а
    под Канаду держали отдельную сборку прошивки Mega из-за калибровки серво.
    Что сведено:
    * Раскладка USB-хаба башен — в конфи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
2026-08-09 Поднял ?v= у scripts.js — иначе браузер отдал бы кэш со старой WiFi-формой
2026-08-09 Фикс: 're' is not defined при подключении к WiFi
    Разбор IP-адреса интерфейса использовал re.search, но в CastleServer.py
    модуль re на уровне модуля не импортирован — единственное существующее
    место делало import re локально внутри функции. В итоге подключение к сети
    проходило (телефон показывал клиента), но сервер падал на попытке узнать
    выданный IP, и пульт показывал «Error: name 're' is not defined» вместо
    адреса. По той ж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
    [CastleServer.py]
2026-08-09 Кнопки проверки серво, переименование wlan по шине, подробная инструкция по хабу
    Разбор четырёх замечаний с пуско-наладки CLC4.
    1. Замок не поднимался с воткнутым USB-донглом.
    В логах: hostapd «nl80211: Could not configure driver mode» → AP-DISABLED.
    Ядро раздаёт имена wlanN в порядке появления устройств: с донглом в момент
    загрузки он становился wlan0, и hostapd пытался поднять сеть Castle на нём.
    Донглы RTL8188EU режим точ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
2026-08-09 Перевод инструкции гейммастера на EN/FR + перенос в папку Инструкции для персонала
2026-08-10 Опознание башен больше не трогает главную плату
    На CLC4 «Опознать башни» крутилось бесконечно, а следом переставала
    прошиваться главная плата.
    Причина: фильтр портов ловил не только хаб. Главная Mega сидит не в хабе, а
    прямо на порту Pi (1.1), и её путь в /dev/serial/by-path тоже оканчивается на
    ':1.0-port0' — регулярка его пропускала. В итоге опознание открывало порт
    работающей главной платы, роняло DTR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
2026-08-10 Опознание башен: явный сброс платы; дата прошивки main после восстановления
    Три вещи, вскрывшиеся на пуско-наладке CLC4.
    1. «Опознать башни» возвращало «не опознано» на исправных башнях.
    Башня печатает своё имя в setup(), то есть один раз при загрузке, а к
    моменту опознания она работает уже часы. Расчёт был на то, что открытие
    порта уронит DTR и плата перезагрузится — но pyserial выставляет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
    [CastleServer.py, castle_setup.py]
2026-08-10 USB-хаб башен передёргивается программно — руками к нему лазить больше не надо
    Давняя болячка: прошивка башни виснет, и лечится только физическим
    выдёргиванием кабеля хаба. Эдуард делал это руками и о том же просил клиентов
    CLC2 и CLC3.
    Проверил топологию на CLC4: за хабом 1-1.2 стоят ТОЛЬКО четыре башни, а
    звуковая карта (1-1.4) и WiFi-донгл (1-1.3) воткнуты прямо в Pi. Значит хаб
    можно переподключат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
2026-08-10 Откат авто-передёргивания хаба: программно он не поднимается
    Проверил на живом CLC4 — и функция не работает. Все три способа отключают
    хаб, но обратно его не поднимают:
    * authorized 0→1 на узле хаба: узел показывает authorized=1, а downstream-
    порты не переэнумерируются, дочерних устройств в /sys не появляется вовсе;
    * unbind/bind драйвера usb для 1-1.2 — не поднимает;
    * USBDEVFS_RESET (ioctl) на устройстве хаба — не по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
2026-08-10 Вотчдог честно говорит про исчезнувший донгл; пояснение про 0–180 у серво
    1. wlan1-вотчдог писал в лог «USB power-cycle (authorized=0/1)», хотя обе
    записи падали с «Directory nonexistent». Механизм authorized умеет
    отсоединить и подключить только устройство, которое ЕЩЁ числится на шине;
    когда донгл отваливается совсем, узла в /sys уже нет и поднимать нечего.
    На CLC4 10.08 из-за этого оператор ждал автоматического в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
2026-08-10 Чек-лист приёмки: проверка холодного старта всех ESP32
    На CLC4 после ночного обесточивания train и safe не поднимаются сами —
    приходится жать reset на самих модулях. Код у них в части WiFi идентичен
    wolf и chest (тот же таймаут 15с и тот же ESP.restart()), то есть работающее
    устройство переподключилось бы само. Значит проверять это надо до отгрузки,
    а не узнавать у клиента.
2026-08-10 Монитор датчиков объясняет, что показывает
    В покое главная плата шлёт только служебные строки: HB (сколько мс назад
    отозвалась каждая башня) и LOOP (скорость цикла). О срабатывании датчиков
    она рассказывает только внутри игровых этапов — монитор строился на неверном
    предположении, что события идут всегда, и выглядел набором непонятных букв.
    Теперь HB расшифровывается в четыре индик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
2026-08-10 Монитор датчиков заработал: главная плата опрашивает входы в покое
    Монитор строился на неверном предположении, что события датчиков идут по
    Serial всегда. На деле плата рассказывает о срабатываниях только внутри
    игровых этапов, а в покое шлёт лишь HB и LOOP — поэтому в панели крутились
    непонятные строки, и обещание «замкнул геркон — увидел» не выполнялось.
    Прошивка Mega: опрос 18 входов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
2026-08-10 Монитор видит датчики за мультиплексором и вибрацию; пульт блокируется
    Три замечания с пуско-наладки CLC4.
    1. Половина датчиков главной платы не появлялась в мониторе. Причина: они
    сидят не на прямых пинах, а за мультиплексором — герконы кубка и камина,
    сенсоры баскетбола, дверь библиотеки, концевик тюрьмы, часы. Я читал выходы
    Y мультиплексора напрямую, а их значение зависит от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
2026-08-10 Монитор датчиков переживает перезагрузку платы и честно молчит
    На CLC4 выяснилось, почему проверка датчиков шла вслепую: после перезагрузки
    Mega (прошивка, перезапуск сервера, снятие питания) плата забывала про монитор,
    а тумблер на пульте оставался включённым. Панель молча замирала на последнем
    снимке, и человек замыкал провода, не получая никакой реакции — при полностью
    исправной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
    [CastleServer.py]
2026-08-10 Датчик вибрации в мониторе: опрос на каждом проходе, а не раз в 150 мс
    Пьезодатчик давал всплеск длиной в единицы миллисекунд, а монитор опрашивал
    входы раз в 150 мс вместе с мультиплексором — попадание было делом случая, и
    на CLC4 датчик выглядел мёртвым при исправном железе.
    Теперь пьезо читается на каждом проходе состояния ожидания и защёлкивается на
    900 мс, а из медленного цикла искл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
    [MAIN_BOARD_V5_COM5.ino]
2026-08-10 Резервные входы герконов видны в мониторе
    Пины 26 и 28 (клеммники J22/J23 на плате-хабе) в игре не заняты и на схеме
    помечены как резервные. Добавлены в монитор датчиков, чтобы при выбывшем
    входе можно было проверить запасную клемму прикосновением, до переноса
    проводов и без правки прошивки.
    Само переназначение пина в коде НЕ делается: прошивка должна оставаться
    одинаковой на CLC2, CLC3 и CLC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
2026-08-12 Монитор датчиков охватил все четыре башни, плашки сгруппированы по типам
    Данные башен идут ТЕМ ЖЕ путём, что и в игре: по UART в главную плату и
    дальше на сервер. Вариант читать башни напрямую по USB отвергнут по двум
    причинам Эдуарда, и обе верные: (1) обрыв на плате главного контроллера —
    как было со стартовым герконом — такой монитор бы не увидел и показал бы
    исправность там, где игра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
    [MAIN_BOARD_V5_COM5.ino, basket3.ino, dog.ino, owls.ino, workshop.ino]
2026-08-12 Датчики башен доходят до пульта: в покое их никто не слушал
    Башни прошиты, команду монитора получают и отвечают — но на пульте не
    появлялось ни одной их плашки. Причина оказалась на главной плате: строки от
    башен разбирает единственная функция HelpTowersHandler(), а вызывается она из
    smartDelay(), то есть работает только пока плата чего-то ждёт внутри игровых
    сцен. В состоянии покоя башни не слуш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
2026-08-12 Монитор: ИК-датчики показывались наоборот, убраны дублирующие вспышки
    1. Полярность ИК. Герконы и кнопки сидят на подтяжке к питанию, у них
    сработавшее состояние — ноль. У ИК-датчиков в прошивках башен стоит
    LOW_PULL, то есть наоборот: активна единица. Из-за общего правила флаг
    светился зелёным, когда его НЕ вставили, и гас при вставке. Теперь тип
    датчика определяет полярность; эт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
2026-08-12 Монитор: переименования, Dog-датчики местами, ёмкостные сенсоры найдены
    По правкам Эдуарда с живого замка:
    * «Кристалл поднят» → «Кристаллы в подвале»;
    * «Дверь библиотеки» → «Дверь в библиотеке»;
    * «Галетники первой комнаты» → «Галетник первой комнаты — дерево»;
    * у Цербера локер клетки и геркон скорости платформы были подписаны наоборот
    (CAGE_REED и END_REED в прошивке названы не по функ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
2026-08-12 Монитор вычерпывал буферы, из-за которых плата считала башни живыми
    Workshop и Dog показывались отвалившимися при исправной связи. Причина — моя
    правка от предыдущего захода.
    Живость башен определяется ПАССИВНО: loop() смотрит, есть ли байты в буфере
    UART, и намеренно их не читает — байты остаются игровому разбору. А чтение
    башен в покое, которое я добавил ради монитора, эти буферы вычерпыв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
    [MAIN_BOARD_V5_COM5.ino]
2026-08-12 Монитор датчиков стал отдельным разделом, пищит на срабатывание
    Монитор был шестым шагом «Первого запуска», хотя нужен постоянно: и на
    сборке, и когда у клиента «датчик перестал видеться». Теперь это свой
    раздел со своим состоянием свёрнутости; чек-лист приёмки стал шестым шагом.
    Полярность ёмкостных сенсоров была перевёрнута. Модули касания в покое
    сами держат линию в нуле и вы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
2026-08-12 Громкость писка монитора и честная живость молчаливых башен
    Писк звучал на полной громкости, убавить было нечем. Ползунок отдельный
    на каждый источник: динамики замка и динамик телефона звучат совершенно
    по-разному, общий пришлось бы двигать при каждом переключении. Отпустил
    ползунок — писк тут же звучит на новой громкости, иначе подбирать её
    пришлось бы вслепую, тыкая датчик п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
2026-08-12 Плашки датчиков идут в порядке MON_META, а не в порядке прихода
    Плата обходит входы по номерам пинов и каналов мультиплексора, поэтому
    «Сенсор ловли снитча 2» оказывался на экране раньше первого. Порядок
    внутри группы теперь задаёт таблица MON_META; датчики без записи в ней
    уходят в конец группы.
2026-08-12 Монитор: подписи датчиков и заголовки групп переводятся
    В английском пульте панель датчиков оставалась целиком русской: имена
    входов, названия башен и групп рисует JS, а data-i18n покрывает только
    разметку. Английские подписи живут отдельной таблицей MON_NAME_EN с теми
    же ключами — так строку с русскими именами по-прежнему можно править
    одним движением, не пересчитывая запятые. Неописанн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
2026-08-12 Выключенный монитор больше не оставляет плашки на экране
    Эдуард полчаса мерил датчики, глядя на панель, и не знал, что монитор
    выключен: плашки остались от прошлого включения и выглядели как живое
    состояние входов. Теперь при выключении панель гасится целиком —
    плашки, счётчик, живость башен, время последнего сообщения — и висит
    явное предупреждение, что состояние входов не пока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
2026-08-12 Монитор ловит короткие нажатия и не теряет плашки при включении
    Геркон приходилось удерживать четверть секунды, иначе до пульта не
    доходило ничего: входы опрашивались раз в 120–150 мс и требовали двух
    совпадений подряд. Светодиоды в печке при этом реагировали сразу —
    башня обрабатывает их своей логикой с антидребезгом 50 мс, — и получалось
    «сработало, но пульт молчит».
    Теперь прям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
2026-08-12 Монитор сам возвращает в строй башню после сброса и не морозит плашки
    Разбор логов CLC4: поток sens: замолкал на 52, 72 и 867 секунд, при этом
    игровые строки от башен шли как обычно. Причина — башня, пережившая сброс
    или перепрошивку, просыпается с выключенным монитором и молчит навсегда,
    хотя тумблер на пульте включён. Панель тихо замирает, а человек
    продолжает мерить датчики вслепую и вид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
2026-08-12 Монитор больше не заливает пульт повторами: наружу только изменения
    Платы повторяют состояние каждого входа по кругу, чтобы потерянная строка
    не заморозила плашку. Серверу этот повтор нужен, а пульту — нет: девять
    одинаковых сообщений в секунду по вайфаю замка копятся в очереди, и
    плашка отстаёт на десятки секунд. Человек жмёт геркон, а пульт показывает
    позапрошлое нажатие.
    Мои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
2026-08-12 Выключение монитора больше не отбирает у замка звук
    Выключение монитора сбрасывало выбор источника звука в «не пищать», а
    пульт об этом не узнавал: тумблер оставался включённым, источник —
    «Динамики замка», а замок молчал. Дёрнуть монитор со стороны может кто
    угодно: вторая вкладка, диагностический скрипт, автоматическое выключение
    перед прошивкой. Ровно так звук и пропал — его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
2026-08-12 Откат опроса монитора к версии, которая работала без задержек
    Эдуард: «до того как ты начал это править, всё работало нормально».
    Он прав. За вечер я трижды менял опрос входов, гоняясь за двумя мелкими
    неудобствами — геркон надо было подержать четверть секунды, и одна
    плашка не появлялась, — и в итоге сломал главное: задержку.
    Возвращаю опрос ровно к 3778b22: обход раз в 120 мс у башен и 15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
2026-08-12 Прошивка башен без хаба: один кабель прямо в Pi
    Эдуард всё равно постоянно вытаскивает и вставляет хаб, поэтому проще
    воткнуть кабель нужной башни прямо в Raspberry и нажать её кнопку.
    Старые замки (CLC1-3) собраны с хабом и останутся на нём, поэтому способ
    переключается, а не заменяется: селектор в шапке таблицы прошивки.
    В прямом режиме порт не угадывается по номеру, а находится: берём
    еди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
2026-08-13 Монитор датчиков переехал во вкладку диагностики
    Был отдельным разделом ниже по странице, и его приходилось искать, хотя
    задача у него ровно та же, что у диагностики ESP32 — посмотреть, что
    видит железо. Теперь это пятая вкладка рядом с Train, Wolf, Safe и
    Suitcases, на месте заглушки «Башни — TODO».
    Сворачивание раздела убрано за ненадобностью: показ и скрытие делает сама
    вкладка. При её открытии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
2026-08-13 Монитор: повторы флагов не идут в лог, писк не пропускает первое нажатие
    Первое: в логе пульта постоянно капали galet_off, flag2_off, flag4_off,
    хотя в замке никто ничего не трогал. Это башни раз в 5 секунд повторяют
    состояние своих флагов, чтобы потерянный фронт не расходился с
    реальностью навсегда. Игровому разбору повтор нужен, монитору — нет:
    наружу теперь идёт только смена состояния. На посл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
2026-08-13 Монитор: плашка считывателя меток на котле
    Обычные два шага (пин в MON_PINS + строка в MON_META) тут не работают:
    считыватель сидит на шине 1-Wire, и «метка поднесена» видно не по уровню на
    ножке, а только ответом на поиск по шине. Поэтому у него отдельный слот со
    своим опросом — как у пьезодатчика.
    Поиск делается раз в 200 мс своим буфером, а не общим addr: тот принадлежит
    игровой логике. Найденная м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
2026-08-13 ESP32: пауза перед включением периферии — лечение «не стартует без EN»
    Поезд на CLC4 не поднимался после обесточивания, оживал только кнопкой EN.
    Перебором, где каждый раз менялась ровно одна вещь, выяснилось: модуль,
    плата, блок питания и допаянные проводки исправны — минимальная тестовая
    прошивка на том же железе стартовала сама.
    Причина в броске тока. При холодном пуске конденсаторы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
    [chest.ino, safe.ino, train.ino, wolf.ino]
2026-08-13 Озвучка датчиков внешних устройств, управление звуком — на весь блок
    Монитор замка умел пищать на срабатывание, а диагностика поезда, волка,
    сейфа и чемоданов — нет, хотя проверяют их точно так же: руками у железа,
    не глядя в экран.
    Теперь пищат и они. Снимок от ESP32 прилетает пять раз в секунду, поэтому
    реагируем только на изменение набора входов, а первый снимок считаем
    знакомством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
2026-08-13 Звук монитора: выбор хранится поклиентно, а не один на всех
    Эдуард: у сейфа озвучка то с большой задержкой, то нет совсем, и рядом с
    кнопкой висит «Сервер не знает про выбранный звук». Плашки при этом
    загорались нормально — значит данные шли, а пропадал именно звук.
    Причина: флаг «пищать из динамиков замка» был один на весь сервер, и его
    перетирал тот пульт, который заговорил последн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
2026-08-13 Звук из динамиков замка живёт на замке, а не в браузере
    Эдуард выбирает звук из динамиков замка именно затем, чтобы проверка
    датчиков не зависела от связи: сигнал идёт с датчика на замок и обратно,
    интернет для этого не нужен. А у меня решение «пищать или нет» принимал
    пульт — и обрыв вайфая, закрытая вкладка или второй открытый пульт молча
    выключали звук. То есть ровно то, ради чего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
2026-08-13 Источник звука снова взаимоисключающий
    Эдуард: выбрал «Это устройство» — на вкладке монитора пищит только
    компьютер, а при проверке внешних устройств пищат и компьютер, и замок
    одновременно.
    Так и было: настройку замка я вынес в его конфиг, чтобы она не зависела от
    связи, но она перестала выключаться при выборе другого источника — жила
    сама по себе.
    Теперь переключатель работае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
2026-08-13 Фон приглушается под историю относительно громкости, а не до 10%
    Эдуард: фоновая музыка на первом делении слишком громкая и не приглушается,
    когда звучит история.
    Цель приглушения была задана абсолютной величиной — 10%. А деление 1 на
    пульте это 5%, деление 2 — ровно 10%. Цикл «понижай, пока громче цели» на
    этих делениях не делал ни одного шага, и фон оставался как был. Приглушение
    работа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
2026-08-13 Калибровка серво: введённое значение больше не затирается статусом
    Эдуард выставил 180 градусов, нажал «Сохранить» — поле вернулось к 170.
    На замке при этом всё сохранялось правильно: проверил напрямую, конфиг
    принимает 180 и отвечает ok.
    Терялось на пульте. Поля калибровки обновлялись из общего статуса, который
    прилетает раз в десять секунд, а защита была только «пока поле в фокусе».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
2026-08-13 Зависшая диагностика внешнего устройства больше не остаётся незамеченной
    Сейф не открывал замок ни на Restart, ни на кнопку двери, при этом из самой
    диагностики открывался. Причина: он больше часа простоял в режиме
    диагностики, а в нём прошивка по замыслу игнорирует все игровые команды.
    Режим живёт НА УСТРОЙСТВЕ, а сервер помнит о нём только в памяти процесса.
    Я перезапускал сервер п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
2026-08-13 Пульт спрашивает подтверждение перед рестартом
    Просьба сотрудников клиента: кнопка Restart стоит вплотную к Start, а
    случайное нажатие посреди игры обнуляет прохождение и открывает все двери —
    вернуть это уже нельзя.
    Теперь по нажатию появляется окно с текстом, что именно произойдёт, и
    выбором. Кнопка «Cancel» получает фокус по умолчанию: случайный Enter
    рестарт не запускает.
    Диалог сдела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
2026-08-13 Подтверждение и на кнопке Start
    Start стоит вплотную к Restart, и случайное нажатие посреди игры сбивает
    отсчёт времени. Диалог сделан таким же, как у Restart, — гейм-мастеру не
    надо помнить, где спрашивают, а где нет.
    Текст говорит, что произойдёт: запустится таймер и начнётся игра. Фокус по
    умолчанию на «Cancel», как и у рестарта.
    Проверено в браузере: отмена не отправляет ничего, подтверждение о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
2026-08-14 Кнопки штатных команд на вкладках внешних устройств
    На /tech у каждого ESP32 (поезд, волк, сейф, чемоданы) появился блок «Команды
    устройства» — те же строки, что сервер шлёт по ходу игры: старт/игра/скип,
    открыть замок, языки озвучки, громкость и специфика устройства.
    Блок живёт вне тела диагностики: команды нужны как раз тогда, когда устройство
    НЕ заморожено, а diag-режим его останавливае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
2026-08-14 Пульт больше не подсовывает вчерашнюю страницу из кэша
    Flask 1.1 отдаёт статику и send_file с max-age 12 часов. Браузер держал
    /tech, /pult и scripts.js до полусуток: сервер обновлён и перезапущен, а на
    экране прежняя версия — ровно это и случилось с кнопками команд устройств.
    SEND_FILE_MAX_AGE_DEFAULT = 0. Файл всё равно перевыдаётся только при
    изменении (условный запрос по Last-Modified/ETag), но браузер каждый раз
    спрашивае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
2026-08-14 Язык озвучки — поле с номером вместо шести кнопок
    Шесть одинаковых кнопок language_N занимали целую строку на каждой вкладке.
    Теперь номер набирается с клавиатуры, как угол сервопривода, а рядом кнопка,
    которая всегда показывает, что уйдёт на устройство (language_4), и подпись с
    названием языка — 1 ru, 2 en, 3 ar, 4 fr, 5 uk, 6 pl.
    Пустое поле или номер вне 1..6 гасят кнопку. Разблокировка после отправки
    ид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
2026-08-14 Тех-пульт разложен по сворачиваемым разделам
    Страница открывалась сразу всем: таблица прошивки, диагностика, свет, розетка,
    тест ленты, первый запуск — два экрана кнопок, среди которых надо было искать
    нужную. Теперь три больших блока свёрнуты и раскрываются нажатием на заголовок:
    - «Прошивка плат» — таблица прошивки вместе с выбором способа подключения башен;
    - «Диагностика уст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
2026-08-14 Разделы-кнопки на пульте и диагностика метки бутылки
    Пульт: три раздела получили одинаковую шапку-кнопку — цветная полоса слева,
    подсветка под курсором, поворачивающаяся стрелка. Рамка вокруг диагностики
    убрана, теперь она выглядит как соседи. Разделы больше не запоминают своё
    состояние: F5 жмут, когда что-то пошло не так, и начинать хочется с чистого
    экрана, а не с раскрытой прост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
2026-08-14 Проверка верстака Мастерской в «Первом запуске»
    После сборки светодиод и геркон верстака легко оказываются в разных гнёздах:
    в игре касаешься первого геркона, а загорается третий светодиод, и увидеть это
    можно только пройдя весь этап.
    Новый шаг 6 раздела «Первый запуск»:
    - «Тест герконов» — замкнул первый, светится первый. Плашки на пульте
    показывают, какой геркон замкнут сейча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
2026-08-14 В подсказке теста верстака названа зависимость от монитора
    Плашки герконов оживают только при включённом мониторе датчиков: в покое
    главная плата вычерпывает UART башен исключительно под флагом монитора
    (PowerOn/RestOn). Сам тест на верстаке при этом работает всегда — светодиоды
    зажигает Мастерская, не пульт. Без этой строчки выглядело как поломка.
2026-08-14 Тест верстака больше не зависит от монитора датчиков
    В покое главная плата вычерпывала UART башен только под флагом монитора,
    поэтому плашки герконов на пульте оживали лишь при включённом мониторе.
    Теперь тот же читающий блок работает и по флагу wbTestOn — плата сама знает,
    что тест включён, потому что сама передала команду в Мастерскую.
    На включении буферы всех четырёх башен чистятся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
2026-08-14 story_10 после flags.wav и новая анимация призрака у Волка
    1. story_10 не звучала вообще. Флаг nextTrack выставлялся сразу при
    flagsendmr, а музыку в этот момент только что остановили — главный цикл в
    ту же секунду видел «музыка молчит + nextTrack == 1» и запускал fon8 со
    story_11. Канал историй оказывался занят, и story_10, которую фоновая
    задача честно ждала до конца flags.wav, играть было уже некуда
    (лог CLC4 14.08.2026 10:46:4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
2026-08-14 Кнопки команд появляются сразу, а не после статуса с сервера
    Отрисовка висела в обработчике setup_status, поэтому кнопки возникали только
    когда что-нибудь заставляло сервер прислать статус — на практике переключатель
    «Звук на срабатывание». Список команд зашит в странице и данных с сервера не
    ждёт, так что рисуем его при загрузке.
2026-08-14 Кнопки открытия клетки Цербера и локера комнаты воспоминаний
    Это были единственные два локера замка, которые нельзя было открыть с пульта:
    клетка Цербера висит на отдельном пине (D5, у двери свой open_door на D10) и
    отпиралась только по ready/restart или прохождением игры, а «Open Door» у
    Crystal Space в режиме рестарта на пульте погашена.
    - Dog Game: кнопка подписана «Skip | Open». В игре — прежний скип этапа, в
    по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
    [CastleServer.py, MAIN_BOARD_V5_COM5.ino, dog.ino, scripts.js]
2026-08-14 Импульс клетки с пульта гасится безусловно
    Первая версия open_cage переиспользовала переменные рестартного импульса, а их
    гашение живёт ВНУТРИ проверки состояния квеста (WAITING_FOR_START/RESTARTING).
    Команда, пришедшая в любом другом состоянии — а состояние башни и режим сервера
    расходятся, например после перезапуска сервера при недоигранной партии, —
    включила бы соленоид и не выключила никог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
2026-08-14 Прошлые логи на /tech: хвост файла и поиск по нему
    Живой поток начинается с момента нажатия кнопки, поэтому вчерашний инцидент им
    не посмотреть, а истории на старте всего 30 строк.
    Над терминалом появилась строка «Прошлые логи»: сколько строк (200/500/1500/
    5000), поле фильтра и кнопка «Показать». Сервер читает хвост файла без подъёма
    его целиком в память и, если строк не хватило, добирает из ро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
2026-08-14 Сова студента в центральной комнате засчитывается как сова на башне
    Этап: артефакт «сова» на карте → касание совы на башне Сов → открывается локер.
    Игроки регулярно трогают вместо неё сову студента в центральной комнате — ту,
    что даёт подсказку, — и стоят в тупике.
    Теперь второй половиной комбинации работает любая из двух сов. Главная плата
    при касании геркона студента (пин 38) шл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
2026-08-14 Карта — барельеф, а не слоты под артефакты
    Уточнение Эдуарда: карта состоит из барельефов (ключ, рыбка, сова, поезд), и
    игрок касается нужного волшебной палочкой — в палочке магнит, под барельефом
    геркон. Формулировка «положить артефакт в слот» в чек-листе была неверной и
    сбивала бы с толку того, кто по нему принимает квест.
    Заодно в разделе совы отмечено, что вторую половину комбин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
2026-08-14 Сейф: окно блокировки датчика шарика 5 → 20 секунд
    Датчик шарика игнорируется после каждого срабатывания геркона 1. Пяти секунд
    не хватало: шарик успевал задеть датчик в полёте и позже, и этап засчитывался
    сам собой.
    Прошито по воздуху, сейф вернулся online.
2026-08-14 Подсказки Волка и Поезда: дыра в состояниях и вечная тишина после потери события
    Два независимых дефекта, оба видны в коде.
    1. Волк, дыра в условиях. Подсказки были расписаны на state 0, state 1-2 и
    state > 4. Состояния 3 (левое облако) и 4 (сам волк) не покрывал никто:
    игрок доходит до волка, жмёт геркон подсказки — тишина. Ровно то, что
    заметили на CLC4 «после активации Волка». Стало state > 0 && state < 5: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
2026-08-14 Чемоданы: подсказка про пройденный этап звучит с момента прохождения
    Та же дыра, что нашлась у Волка: ветки подсказок покрывали state 0, state 1-2
    и state > 3, а состояние 3 не ловил никто. При этом состояние 3 — это ровно
    «этап пройден, играет финальный джингл», то есть тот момент, когда игрок и
    должен услышать выделенную подсказку про пройденный уровень.
    Стало state >= 3. Перебить джингл подсказко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
2026-08-14 Повтор подсказки дракона считает время от конца story_2_b
    Было наоборот: dragonTimer заводился на startgo, а повтор звучал пока
    !dragonFlag — то есть ПОКА игрок кристалла не касался. Вступление story_1 +
    story_2_a занимает 80 секунд, поэтому напоминание прилетало на 40-й секунде
    реального поиска и выдавало содержание story_2_b авансом. По логам всех игр с
    мая story_2_r звучала через 35-40 с после конца story_2_a — в каждой па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
2026-08-14 Этап флагов не может встать намертво из-за ожидания звука
    14.08.2026 17:54 на CLC4: пришёл flagsendmr, сыграл flags.wav — и дальше
    тишина. Ни фона, ни story_10, ни story_11. По журналу видно точно, где
    остановилось: play_background_music() первой строкой пишет «PLAY [Фон]», а
    этой строки нет вовсе — значит фоновая задача так и не вышла из ожидания
    `while flags.get_num_channels() > 0`.
    Ожидание было безусловным, и это моя же правка сделала его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
2026-08-14 Страховка победы флагов больше не дёргает соленоид каждые 5 секунд
    Башни повторяют состояние своих флагов каждые 5 секунд — так задумано, чтобы
    потерянное событие не заморозило картину. Но «страховка победы» в обработчиках
    flag1..flag4_on срабатывала на КАЖДОМ повторе: пока все четыре флага стоят,
    сервер слал m2lck каждые 5 секунд до конца партии. В журнале это выглядит как
    поток одинаковы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
2026-08-14 Писк монитора работает сразу, а не после «Проверить звук»
    Две независимые причины одного симптома — обе лечим.
    Замок. Сигнал (pip.mp3 → wav → pygame.Sound) готовился только по двум поводам:
    переключение тумблера явным действием человека и кнопка «Проверить звук». Но
    сама настройка живёт на замке: после перезапуска сервера тумблер уже включён,
    готовить сигнал некому, и _sensor_beep() молча выходил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
2026-08-14 Цербер отвечает на ready текущим состоянием, а не прошлым
    Фантом в проверке Ready: 14.08.2026 18:42 пришли dog_galet_on и flag3_on,
    через полторы минуты на те же входы — off, хотя никто ничего не трогал.
    CheckState() у Цербера копила состояние антидребезга в статических
    переменных, а вызывают её ТОЛЬКО по команде (ready / check_state) — из loop()
    её, в отличие от Сов и Мастерской, не зовёт никто. Накопитель делает шаг лишь
    в м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
2026-08-14 Флаги: пауза после эффекта, тишина в журнале, зелёная кнопка этапа
    1. Между концом flags.wav и story_10 висело восемь лишних секунд. Ожидание
    смотрело на канал pygame, а он не отпускал: в прогоне 19:07 сработал
    двадцатисекундный предохранитель, то есть канал не освободился и за 20 с
    при звуке длиной 12,9. Теперь ждём ровно длину файла (get_length + 0,2 с),
    предел оставлен на всякий случай.
    2. Журнал заби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
2026-08-14 Поезд: команда projector зажигает свет потолка
    Просьба Эдуарда с прогона 14.08.2026: на этапе поезда комната оставалась
    тёмной. Свет потолка (U6 P0, «LED CEILING») включали только start, restart и
    train_light_on — последнюю сервер шлёт сильно раньше, на этапе галетников.
    Стоит ей потеряться или свету погаснуть, и к поезду комната тёмная, а команда
    самого этапа свет не трогала.
    Теперь projector зажигает потолок вмест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
2026-08-14 Сторожа вступления поезда подтянуты к реальной длине треков
    Эдуард измерил: train_on (трек 1) — 4 с, story_15 по языкам 12, 12, 13, 9, 8, 7
    секунд, то есть максимум 13. Сторожа стояли на 20 и 60 секундах — запас брался
    на глаз. DFPlayer поезда события конца трека теряет регулярно (в прогоне
    14.08.2026 потерял оба подряд), и этап начинался через 80 секунд после касания.
    Стало 8 и 26 секунд — вдвое от реальной длины. Шт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
2026-08-14 Этап поезда играет одну историю вместо цепочки из двух треков
    Решение Эдуарда: звук train_on переезжает внутрь самих файлов story_15 (все
    языки станут по 13 секунд), а прошивка перестаёт играть его отдельно.
    Раньше было train_on → событие «трек доиграл» → story_15. Событие DFPlayer
    теряет регулярно, и на этом стыке появлялась дыра во весь таймаут сторожа —
    в прогоне 14.08.2026 ровно так и вышло. Одним трек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
2026-08-14 Игра поезда стартует через 15 секунд после начала истории, а не через 26
    Файлы story_15 перезаписаны, все языки ровно 13 секунд, поэтому двойной запас
    больше не нужен. Когда DFPlayer отдаёт «трек доиграл» штатно, игра стартует по
    событию около тринадцатой секунды; когда теряет — на пятнадцатой. На слух
    разницы уже не будет.
    Прошито по воздуху.
2026-08-14 Игра поезда стартует на 13,5 секунде истории
    Решение Эдуарда. Все языки story_15 ровно 13 секунд, значит полсекунды — это
    пауза на вдох, а не ожидание. Событие «трек доиграл» от DFPlayer осталось и,
    если приходит, стартует игру чуть раньше, но полагаться на него больше не
    нужно: теряется оно регулярно.
    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
2026-08-14 Фара поезда подсказывает, куда идти, пока идёт таймер карты
    Просьба Эдуарда: игрок коснулся поезда на карте — и все девять секунд таймера
    светодиод в прожекторе поезда мягко пульсирует оранжевым, показывая, куда
    именно тыкать палочкой. Таймер вышел или этап начался — гаснет, дальше лентой
    распоряжается игра.
    Пульсация синусоидой (beatsin8), полный цикл около двух секунд, яркость от 12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
2026-08-14 Фара поезда: пробуем третий светодиод
    Второй не угадали. TRAIN_HEADLIGHT_LED = 3.
2026-08-14 Чемоданы: лёгкий режим и пульсирующий красный при ошибке
    Тумблер в Settings игрового пульта, рядом с режимом Волка и устроен так же:
    выбор живёт на замке в pref-файле, переживает перезапуск, досылается на ESP32
    при каждом старте (она могла перезагрузиться и забыть) и синхронизируется
    между всеми открытыми пультами. По умолчанию — нормальный режим; включённый
    лёгкий держится, пока его не вы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
2026-08-14 Один смысл тумблеров: включено = лёгкий режим
    Было вразнобой: у Волка включённый тумблер означал СЛОЖНЫЙ режим, у Чемоданов —
    лёгкий. Эдуард: «путаница, всегда будем использовать только два режима —
    лёгкий и нормальный».
    Теперь у обоих включено = лёгкий, выключено = нормальный:
    - Волк, лёгкий: луну можно отпускать, этап не откатывается.
    - Волк, нормальный: отпустил луну — через 5 секу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
2026-08-14 Раздел прошивки сам сообщает о непрошитых платах
    Свёрнутая плашка «Прошивка плат» показывает, какие платы ждут заливки:
    красным — те, что не прошивались ни разу, жёлтым — те, у кого файл
    прошивки новее того, что залито. Раньше это было видно только если
    раскрыть таблицу и сверить две даты глазами, и на CLC4 непрошитая
    башня Сов дожила так до тестов.
    Сервер не трогаем: даты уже приходя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
2026-08-14 Цербер: закрытая дверь снова получает импульс замка
    Повторный импульс заводился по флагу isDoorOpened, а он ставится только
    по подтверждённому герконом открытию. Замок дверь отталкивает, а не
    распахивает: если игрок прикрыл её сразу, геркон HIGH не видел вовсе —
    и импульса не было уже никогда. Навесной замок при этом отработан,
    второй раз не сработает, войти к собаке нечем кроме скипа с пу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
2026-08-14 Финал мастерской не обрывает историю про предмет
    story_34 оборвалась через секунду после старта: мастерская заканчивается
    ровно тем предметом, про который эта история и рассказывает, и башня
    шлёт story_35 сразу за helmet. Ждём канал историй перед story_35 — как
    уже сделано перед story_36 и story_37.
    Метла и шлем ждут теперь не только эффект, но и чужую историю: их
    делают подряд, и story_34 так же обрывала бы s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
2026-08-14 Кнопка Open комнаты воспоминаний зеленеет вместе со Skip
    По memory_room_end зеленел только Skip, а соседняя Open оставалась
    белой — этап пройден, а по виду пульта не скажешь. Красим обе.
    [scripts.js]
2026-08-14 Битая метка котла больше не считается «не той бутылкой»
    OneWire::search() отдаёт true, просто прочитав 64 бита, — контрольную
    сумму она не проверяет, и мы её тоже не проверяли. Любая помеха на линии
    приходила в игру как чужая бутылка: ошибка, звук падения и 30 секунд
    блокировки за неисправное железо.
    На CLC2 считыватель котла с 11.08 отдаёт 08 00 00 00 00 00 00 00 вместо
    01 C9 00 00 00 00 00 34. Теперь такая метка игнор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
2026-08-14 Дверь баскетбола не пульсирует в рестарте, если restart потерялся
    Флаг keep-alive двери снимался только по restart/ready. У клиента эта
    строка потерялась: рестарт пришёлся на окно, когда главная плата почти
    6 секунд никого не слушала (LOOP worst_us=5928108). Флаг остался
    поднятым, и DoorDefender толкал дверь каждые 3 секунды уже в покое.
    Теперь флаг снимают и open_door с open_mine_door. Сервер шлёт их только
    в режиме рестарта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
2026-08-15 Подсказки Мастерской учитывают печку и собранные предметы
    При разгоревшейся печке (уровень 2-3) hint_32_b про розжиг больше не
    звучит: цепочка начинается сразу с hint_32_c, а дальше идёт по кругу
    только то, что ещё не собрано — hint_32_d про метлу и hint_32_e про
    шлем. Список собирается в момент запроса, поэтому собранный предмет
    выпадает из цепочки на следующем же нажатии.
    Для этого главная плата те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
2026-08-15 Диагностика Комнаты Мозга и читаемый «Первый запуск»
    Шаг 7: пара «геркон → своя группа диодов» для четырёх гнёзд кристаллов
    и обход всех восьми групп ленты по одной. Снаружи гнёзда одинаковые, и
    при монтаже одинаково легко перепутать провода герконов и порядок групп
    — теперь это видно за минуту, а не на прогоне сценария.
    Проверка живёт в прошивке главной платы (brtest_*), сервер тольк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
2026-08-15 Флаги не белеют обратно после засчитанного этапа
    Жёлтый флаг оставался белым на пройденном этапе. Башни повторяют
    состояние флагов каждые несколько секунд (страховка засчёта), и повтор
    flag4_off перекрашивал иконку обратно — физически флага в держателе нет,
    датчик честно об этом и говорит.
    После flags_done иконки перестают слушать датчики: этап пройден, они
    показывают прогресс, а не теку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
2026-08-15 Потерянный soundoff больше не убивает подсказки до конца этапа
    Плата снимает flagSound сама, когда отдаёт подсказку, а возвращает его в
    единицу ТОЛЬКО строка soundoff от сервера. 15.08 на CLC4 эта строка до
    платы не доехала (14:50:10) — и следующие пятнадцать минут ни один запрос
    подсказки не отработал, при этом огонь в печке и флаги от той же башни
    доходили исправно. Со стороны выглядит как «подсказки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
    [CastleServer.py]
2026-08-15 Опрос расширителя больше не спит миллисекунду на каждый вызов
    digitalReadExpander() ждал delay(1) при каждом обращении, а игровые
    функции опрашивают расширитель в каждом проходе цикла. На этапе
    Мастерской это давало 1444 мкс на итерацию вместо 58 и худшую итерацию
    в 24 мс. За 24 мс на 115200 в 64-байтовый буфер приёма прилетает вчетверо
    больше, чем он держит, — команда с сервера теряется. Так 15.08 пропал
    soun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
2026-08-15 Сверка замков с мастером одной командой
    Правки рождаются на мастер-стенде в цеху, а до клиентских замков доезжают
    «когда вспомним». 15 августа за день накопилось четыре правки главной
    платы — без учёта половина не доехала бы никуда.
    tools/rollout_status.py только читает: считает md5 файлов на каждом замке
    и сравнивает с репозиторием, плюс смотрит flash_stats.json — прошита ли
    плата тем файлом, которы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
2026-08-17 Раскатка мастера на замок одной командой
    Скрипт для CLC2 жил во временной папке и спотыкался дважды: маска
    «*.hex *.bin» на папках ESP32 раскрывалась в пустоту и обрывала
    копирование всей папки (бинарники ESP32 тогда не доехали и досылались
    руками), а многострочные команды в кавычках ломали ssh.
    Теперь явный список файлов, по одному scp на файл с повторами, бэкап
    делается на самом замке (не завис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
2026-08-17 Свет Hue гаснет в момент победы, а не вместе с салютом
    Гашение стояло в конце ветки, рядом с play_win_salute — то есть после
    двух голевых звуков и двух ожиданий по восемь секунд. От самой победы до
    темноты проходило от пары секунд до шестнадцати, и начало победной
    истории шло при свете предыдущего этапа.
    Переехало в начало ветки, сразу за защитой от дублей: свет гаснет ровно
    на приходе win. Роз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
2026-08-17 Сверка перестала врать про «не прошито»
    Две ошибки, обе давали ложную тревогу на всех платах сразу — после
    раскатки на CLC4 инструмент показал «9 плат прошить», хотя отставали
    только две.
    1. scp без -p ставил файлу время КОПИРОВАНИЯ. Проверка «файл новее
    прошивки» после этого срабатывала даже там, где содержимое в плате
    уже лежит. Теперь копируем с сохранением даты сборки.
    2. Даты в fla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
2026-08-17 Чат гейммастера на игровом пульте: какие подсказки получила команда
    Оператор слышит из-за двери, что «что-то сказали», но какую именно
    подсказку получили игроки — не знал. В логе это было, но лог в игре не
    смотрят.
    Кнопка Hints рядом с Settings разворачивает панель: персонаж, id
    подсказки и её текст на том языке, на котором идёт игра. Свёрнутая кнопка
    показывает счётчик непрочитанных.
    Исто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
2026-08-17 Надписи чата на пульте — по-английски
    Игровой пульт целиком англоязычный (Settings, Skip, Open Door), а панель
    чата вылезала по-русски. Тексты реплик остаются на языке игры — это
    содержимое, а не интерфейс.
2026-08-17 Панель чата — полноценный оверлей, а не полоса под кнопками
    Высота задавалась содержимым: пока подсказок нет, панель вырождалась в
    узкую полосу под кнопкой Hints, и выглядело это как будто её зажало между
    тулбаром и пультом. Плюс z-index 900 — ниже меню Semantic (у них до 106,
    но у пульта свои слои).
    Теперь высота 70vh (не больше 640 px), тело растягивается и скроллится
    внутри, z-index 1000. Пустая плашка пер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
2026-08-17 Чат сдвигает блоки квеста, а не накрывает их
    Оверлей накрывал колонку турнира, а на планшете и телефоне закрывал
    пол-экрана. Панель переехала В ПОТОК над сеткой блоков: открывается —
    сдвигает пульт вниз, сворачивается — сетка возвращается на место.
    Media-запросы не понадобились: ширину и центрирование панель берёт у
    Semantic-контейнера, а на узком экране сетка сама складывается в одну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
2026-08-17 На ПК чат — левая колонка рядом с блоками квеста
    Сверху во всю ширину он занимал слишком много вертикали на большом
    экране: блоки уезжали за первый экран. Теперь на ширине от 992 px чат —
    колонка 330 px слева, сетка встаёт справа и сохраняет четыре колонки.
    Обычный поток, не sticky и не fixed: при прокрутке уезжает со страницей.
    Планшет и телефон не изменились — чат сверху, отступ 0 0 14px.
    Пока ча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
    [scripts.js]
2026-08-17 Чат на ПК не уезжает при прокрутке, планшет снова получает верхнюю раскладку
    1. Порог ПК-раскладки 992 → 1200. У iPad Pro в портрете ровно 1024, и он
    попадал в двухколоночный вид вместо верхнего.
    2. Колонка чата стала липкой (sticky, top 62px): при прокрутке остаётся на
    виду, а не уезжает с первым экраном. 62, потому что кнопки
    Settings/Hints лежат в фиксированном блоке таймера и занимают 18–51 px.
    3. Правый от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
2026-08-17 Имя персонажа в чате — на языке игры
    Переключили квест на французский: текст подсказки приходил французский, а
    подпись оставалась «Дракон Сигнус». Теперь имена лежат в выгрузке на шести
    языках и выбираются тем же суффиксом, что и текст.
    Персонаж ищется сначала по точному id, потом по префиксу — поэтому
    подписывается и реплика, которой в таблице нет (hint_3_z: текста нет,
    Студент есть).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
2026-08-17 Сейф отчитывается о подсказке — одним POST из loop(), не из горячего пути
    В чате гейммастера сейф молчал: 25.05 его HTTP-логирование выключили
    целиком, потому что POST из горячих путей (события плеера, обработчик
    /data) блокировал loop и ронял чип по watchdog. 58 мест логирования —
    возвращать общее логирование нельзя.
    Сделано узкое исключение: номер подсказки перехватывается внутри самого
    sendLogToServer (та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
2026-08-17 Имена персонажей по озвучке (правки Насти) + чат помнит, открыт он или свёрнут
    Настя сверила имена не на слух, а по самим записанным репликам:
    - дракон по-арабски «التنين سيغنس» (его же реплика story_2a), по-украински
    «Сигнус» через «и» — как в озвучке, хотя по правилам было бы «Сігнус»;
    - тролль по-арабски «الغول», а не транслитерация (hint_16_c, «пещера троллей»);
    - Борис по-польски «Borys»;
    - дире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
2026-08-17 Тексты реплик — файл каждого замка, а не общий мастер
    Решение Эдуарда: таблица была первичным импортом, дальше источник правды —
    файл на самом замке, как сервер, шаблоны и прошивки. У клиентов
    формулировки могут расходиться, и затирать их общей версией неправильно.
    * раскатка тексты НЕ трогает; заменить осознанно — флаг --texts;
    * сверка показывает их отдельной строкой «своя версия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
2026-08-17 Тест света первой комнаты в «Первом запуске»
    Шаг 6: две кнопки — обычное освещение (пин 37) и ультрафиолет (A5).
    В игре они включаются в разных сценах — УФ на часах, обычный на стартовой
    двери, — поэтому проверить их поштучно можно было только проходя сценарий.
    Кнопка включает свой выход и гасит другой: в игре они взаимоисключающие, а
    вместе глазом не разобрать, какой из них работает. П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
2026-08-17 Раскатка умеет перезапускать сервер сама — и не залипает на SIGTERM
    Флаг --restart: рестарт отдельным вызовом (не в цепочке через &&, как
    17.08 — тогда ssh порвался, повтор дал второй рестарт и юнит застрял в
    stop-sigterm), потом проверка состояния, и если застрял — SIGKILL. При
    Restart=always служба поднимается за пять секунд.
    После рестарта печатает строки старта (конфиг, тексты, MEGA BOOT) и код
    ответа пульта — чт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
2026-08-18 Пауза больше не гасит свет — плей возвращает освещение этапа
    Снятие с паузы вызывало hue_light_async(False) и безусловно гасило все
    лампы: поставил паузу посреди этапа с ярким светом, нажал плей — игроки
    остались в темноте до следующего сценарного события.
    Теперь сценарные хелперы запоминают последнее выставленное состояние
    (hue_last_state: вся группа с яркостью / одна лампа с индексом / финал
    с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
2026-08-18 Истории Цербера уходят в очередь и больше не рубят чужой рассказ
    Жалоба клиента CLC3 18.08: история башни Цербера перебила звучавшую
    историю башни Сов. По логам ровно это:
    11:26:51 PLAY story_14_a_fr.wav ← Совы, 18.3 секунды
    11:26:57 PLAY story_20_a_fr.wav ← Цербер, поверх, на 6-й секунде
    Игрок не дослушал ни ту, ни другую.
    Причина: обработчики story_20_a/b/c звали play_localized_audio()
    напрямую, без всякой проверки занятости к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
2026-08-18 Истории Сов и Ведьмы тоже уходят в очередь
    Продолжение 48ab117: тот же приём для двух оставшихся этапов первой
    комнаты. Три двери — Цербер, Совы, Ведьма — открываются близко друг к
    другу, и все три ветки были написаны одинаково: play_localized_audio()
    напрямую плюс while story_busy() прямо в чтении Serial. Значит любая из
    них могла оборвать соседнюю; на прошлой неделе это сделал Цербер, с тем
    же успехом мог л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
2026-08-18 Таймаут чтения башен 10 → 100 мс: строки перестали рваться на середине
    18.08 на CLC4 до половины строк от главной платы приходили обрубками:
    galet_of, gale5, galet_offHȱ_off. Замер по логу: 8,5% битых на старой
    прошивке против 35-54% на новой.
    Причина моя. Башни говорят на 9600 (символ ~1 мс), а readStringUntil
    сдавался через 10 мс — примерно после десяти символов. «galet_off» с
    переводом строки ровно десять и есть.
    Раньше не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
2026-08-18 Страховочный soundoff больше не засоряет журнал
    Повтор раз в 20 секунд писался в INFO — 180 строк за час, в них тонуло
    всё остальное: сегодня трижды пришлось фильтровать журнал, чтобы увидеть
    события этапа.
    Уровень понижен до DEBUG, но ТОЛЬКО для страховочной отправки: настоящий
    soundoff по окончании истории остаётся видимым.
    Признак «тихой» отправки — отдельный счётчик, а не элемент очереди:
    о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
2026-08-18 Цербер: фраза не повторяется подряд, геркон капсулы виден в журнале
    1. Фраз «собака злится» всего три, и random спокойно выдавал одну и ту же
    дважды подряд — слышится как «реплика прозвучала два раза». Раньше
    вторую глушила проверка занятости канала; после перевода историй
    Цербера в очередь она честно доигрывает обе. Теперь предыдущая фраза
    исключается из выбора.
    2. Геркон капс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
2026-08-18 Чемоданы, лёгкий режим: одна кнопка зажигает все четыре символа
    Раньше загорался символ нажатой кнопки, и команда всё равно шла искать
    остальные три — режим помогал только наполовину. Теперь любое нажатие
    решает головоломку целиком: нажатия остальных кнопок после этого ничего
    не меняют, всё уже горит.
2026-08-18 Кнопки режима Чемоданов на тех-пульте
    Команды chest_mode_easy / chest_mode_normal были разрешены сервером с
    14.08, а кнопок на пульте не появилось: список кнопок и белый список
    сервера живут в разных файлах, и второй забыли.
    Сверил оба списка целиком по всем четырём устройствам — расхождений
    больше нет: ни одной команды, разрешённой сервером без кнопки, и ни
    одной кнопки, которую сервер отвергнет.
    Co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
2026-08-18 Сервер прощает битые строки датчиков
    Флаги и галетники теряются в линии башня → главная плата, и игрок ставит
    флаг по второму разу. Восстановитель команд их намеренно не трогал.
    Добавлено правило recover_sensor_line() со строгой границей: только двадцать
    строк-состояний, «включён/выключен» решается по фактически принятым буквам
    f и n, а не по близости строк («_on» короче «_off», и любой обрывок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
2026-08-19 Восстановитель читает номер флага, Цербер не повторяет фразу
    Журнал CLC4 за 18.08 показал два промаха правила восстановления.
    1. «flag4_gn», «fl`g4_on», «flag4off», «lag4_off» — номер флага в строке
    читается глазами, но правило молчало: цифра отличает flag1 от flag4 на
    один символ, поэтому битая строка одинаково близка ко всем четырём и
    отбрасывалась как неоднозначная. Теперь единственная цифра 1-5 в с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
2026-08-19 Проверка интернета: таймаут 1,5 -> 3 секунды
    Сотовый модем после простоя поднимает радио 1-2 секунды, и проба не
    укладывалась в 1,5 с. Журнал CLC4 за 18.08 забит парами «Internet went
    OFFLINE / restored» каждые полминуты весь день, причём при живой
    ассоциации, сигнале -48 dBm и нулевых rx/tx-ошибках — то есть тревоги
    ложные, а настоящие обрывы в таком потоке не разглядеть.
    3 секунды укладываются в цикл опроса (5 с).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
2026-08-19 Проверка интернета: возврат таймаута 1,5 с
    Замер после вчерашней правки: 18 провалов интернета подряд, минимум 9 с,
    медиана 36 с, максимум 255 с. Короче трёх секунд — ни одного. Значит
    тревоги никогда не были ложными, интернет пропадал по-настоящему, и запас
    в 3 секунды не давал ничего, только вдвое замедлял обнаружение реального
    обрыва (10-16 с вместо 5-8 с).
    В комментарии оставлено правило: п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
2026-08-19 Инструкция техника: ИК-датчики и герконы
    Раздел 9 — новый подраздел «Датчики»: при вечно сработавшем ИК-датчике
    первым делом крутить регулятор чувствительности на самом модуле, а не
    менять деталь. Проверка выносом датчика в пустоту, порядок замеров
    (0,1 В на сигнале = насыщение транзистора, а не обрыв), распиновка
    гнезда IR платы Чемоданов, геркон без магнита.
    Раздел 8 — слабое место: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
2026-08-20 Аудио: приводить .wav к частоте микшера, а не только к 16 бит
    story_11_fr.wav, залитый через пульт, на динамиках замка звучал ускоренным
    почти вдвое, а в браузере на ПК — нормально. Причина: файл был 24000 Гц,
    микшер открыт на 44100, а pygame 1.9.6 на SDL 1.2 частоту не пересчитывает и
    играет на своей скорости. Браузер частоту читает из заголовка, потому и
    расхождение. Замер на CLC3: трек 14,92 с укладывался в 8,12 с,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
2026-08-20 CLC1 (Оман): подтянут к общему коду, интерфейс точки доступа — в конфиг
    CLC1 отставал на четыре месяца: код от 12 апреля, без castle_config.json,
    со старым тех-пультом. Обновлён полностью — сервер, пульты, конфиг и восемь
    из девяти плат. Правки, которые понадобились для этого:
    Башня Мастерской. У CLC1 там СЕРВОПРИВОДЫ (шлем и метла) вместо светодиодов
    остальных замков, и висят они на пинах 5/3, а не 50/48.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
2026-08-20 Звук и хаб CLC1: внешней аудиокарты нет, всё это — в конфиг замка
    Ещё два отличия Омана, всплывшие после обновления.
    1. Внешней USB-аудиокарты у CLC1 нет вообще — звук идёт через встроенный
    выход Raspberry (bcm2835, разъём 3.5 мм), PulseAudio там не запущен, играет
    ALSA напрямую. Последствия в коде было два:
    - индикатор «USB Audio» на пульте искал карту по VID:PID и горел бы красным
    при полностью исправном зв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
    [CastleServer.py, castle_config.py]
2026-08-20 Лёгкий режим Чемоданов и Волка терялся при перезагрузке ESP32
    Жалоба клиента (CLC2, игра 19.08.2026): этап Чемоданов шёл в нормальном
    режиме, хотя тумблер лёгкого режима на пульте был включён.
    Разбор по логам замка. Тумблер включили 15.08 в 01:12 — тогда же ушла
    единственная команда chest_mode_easy. Игра началась 19.08 в 22:44, и при
    старте Чемоданам ушли set_level_22 и language_2, а команды режима не было
    вовсе. За четы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
2026-08-20 Красный флаг срабатывал со второго раза: повтор состояния стоял в мёртвой ветке
    Жалоба клиента (CLC2, Канада): красный флаг во время игры засчитывается только
    со второго раза — вынул, вставил, тогда сработало. Красный флаг — это башня
    Мастерской, flag1.
    Разбор. Башни шлют состояние флага двумя способами: по фронту (вставили или
    вынули) и повтором раз в 5 секунд, чтобы потерянный фронт ле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
2026-08-21 Дверь Мастерской не открывалась по сюжету: openLock() молча пропускал импульс
    Жалоба клиента (CLC2, Канада): иногда дверь в Мастерскую не открывается по
    сюжету. Вчера он тестировал 4 раза — первый раз дверь не открылась, три
    остальных прошли нормально.
    Разбор по логам, 53 сюжетных открытия за три недели. Вчерашние четыре запуска
    нашлись один в один, сбой — 20.08 в 17:19 по времени клиента: коман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
2026-08-21 Калибровка серво уходила один раз по фронту и терялась — повторяем до подтверждения
    Нашла соседняя сессия при настройке CLC1 (Оман): конфиг замка верный, а до
    главной платы калибровка не доезжает, и серво работает на дефолтах прошивки.
    На CLC1 это промах примерно на 68 градусов — там серво на 270°, и «170 при
    диапазоне 500-2500» совсем не то же самое, что «130 при 544-2400».
    Причина ровно та же, что у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
2026-08-21 Опознание башен сверялось с эталонной раскладкой вместо раскладки замка
    Панель «Опознать башни» на CLC1 показывала «перепутано» для Мастерской и
    Корзины, хотя кабели воткнуты верно и прошивка по кнопкам попадает куда надо.
    Причина в одной строке:
    var port = standard[tower] || mapping[tower];
    Эталон стоит первым, а он заполнен всегда — значит раскладка конкретного замка
    не использовалась НИКОГДА.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
2026-08-21 Инструкция гейммастера: перевод на стандартный арабский (Оман)
2026-08-22 Монитор датчиков: конечный геркон Цербера был подписан «Локер клетки»
    При разборе жалобы CLC3 («игроки долго возились с собакой и не прошли»)
    понадобилось посмотреть конечный геркон платформы — и выяснилось, что в
    мониторе он подписан неверно.
    На Nano A0 = пин 14, A1 = пин 15:
    - td14 «Геркон скорости платформы» — верно, это CAGE_REED (A0);
    - td15 «Локер клетки» — НЕВЕРНО. A1 это END_REED, тот самый геркон, кот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
2026-08-22 Башня Корзины: в рестарте дверь толкалась каждые 3 секунды
    Жалоба CLC1: в режиме рестарта дверь башни Корзины открывается импульсом раз
    в 3 секунды. Это поведение задумано для ИГРЫ, в покое его быть не должно.
    В башне две пульсации, и разоружались они по-разному:
    - дверь баскетбола держит флаг basketDoorAllowed. Его снимает restart, а если
    тот потеряется — следом снимает open_door. Две дороги к одному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
2026-08-22 Главная плата: замер длительности фаз, чтобы найти секундные зависания
    Телеметрия LOOP показала, что цикл главной платы иногда встаёт на секунды:
    CLC1 до 6,29 с (43 замера из 557 дольше секунды), CLC3 до 11,33 с (66 из 1326).
    Медианы при этом здоровые — 57 мкс и 2 мс, значит зависания событийные.
    Вред доказан: рекорд CLC3 пришёлся ровно на рестарт. Плата молчала с 12:14:41
    по 12:14:53, а сервер в это окно послал open_b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
2026-08-22 Монитор датчиков показывал устаревшую картину при повторном включении
    Эдуард на CLC4: прокрутил платформу — «Геркон скорости» мигал верно, закрыл
    клетку — «Локер клетки» позеленел. Потом выключил и включил монитор: платформа
    по-прежнему защёлкнута, а «Локер клетки» уже НЕ горит. Геркон скорости при этом
    горит — он изредка дёргается сам и попадает в поток изменений.
    Причина. Башн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
2026-08-22 Кнопка «Открыть клетку Цербера»: команда была в прошивке, но не на пульте
    Всплыло на разборе CLC3. Чтобы проверить конечный геркон платформы, её надо
    сдвинуть из защёлкнутого положения — а для этого сперва отпустить защёлку.
    Эдуард: «на CLC3 нет возможности закрытый замок клетки открыть без пульта
    физически».
    Оказалось, прошивка Цербера команду понимает: open_cage добавляли как раз
    пото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
2026-08-22 Revert "Кнопка «Открыть клетку Цербера»: команда была в прошивке, но не на пульте"
    This reverts commit 3bb0d1554e6146acc1209c0026ea9be332bb1c39.
    [CastleServer.py]
2026-08-22 Цербер: пишем в лог, почему этап не засчитан
    Разбор жалобы CLC3 («игроки долго возились с собакой и не прошли») упёрся в то,
    что прошивка о своём решении молчит. Игроки доводят платформу до защёлкивания,
    победы нет — и отличить «крутили быстро» от «геркон не сработал» можно только
    с их слов.
    Эдуард заметил на CLC4 существенное: геркон скорости вращения и конечный
    геркон стоят рядом — в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
